wrightsh/Michigan-Linear-Book-Scanner/CAD/Linear Book Scanner/Laser Cut Layouts/Pics/main assembly with rough electronics slide.PNG

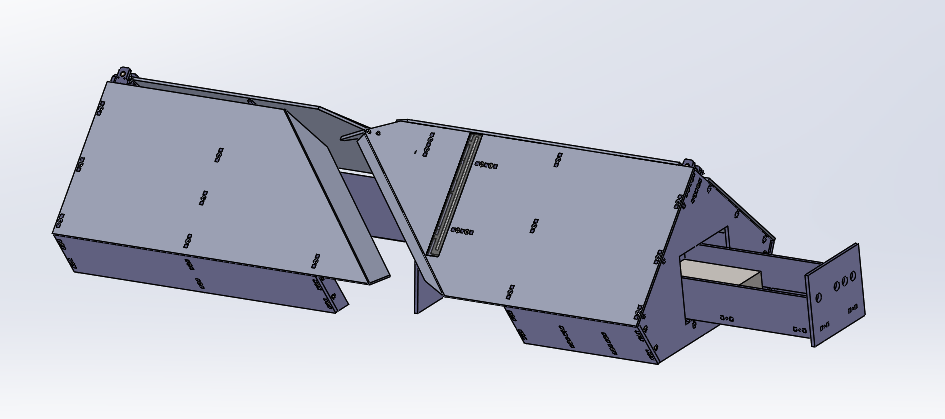
CAD/Linear Book Scanner/Laser Cut Layouts/Pics/main assembly with rough electronics slide.PNG
