wrightsh/Michigan-Linear-Book-Scanner/CAD/Linear Book Scanner/Renderings/Electronics Slide.JPG

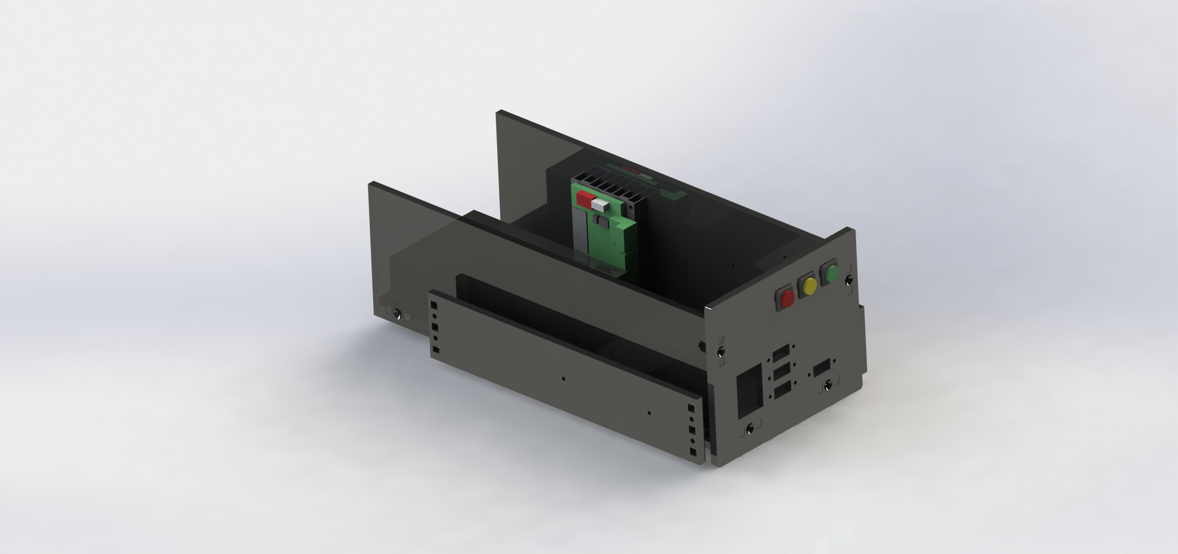
CAD/Linear Book Scanner/Renderings/Electronics Slide.JPG
