wrightsh/Michigan-Linear-Book-Scanner/README.md

Michigan-Linear-Book-Scanner
============================

An open source non-descructive book scanner produced at the University of Michigan as a senior design.
