wrightsh/Michigan-Linear-Book-Scanner/CAD/Linear Book Scanner/Laser Cut Layouts/Pics/Delrin_2.JPG

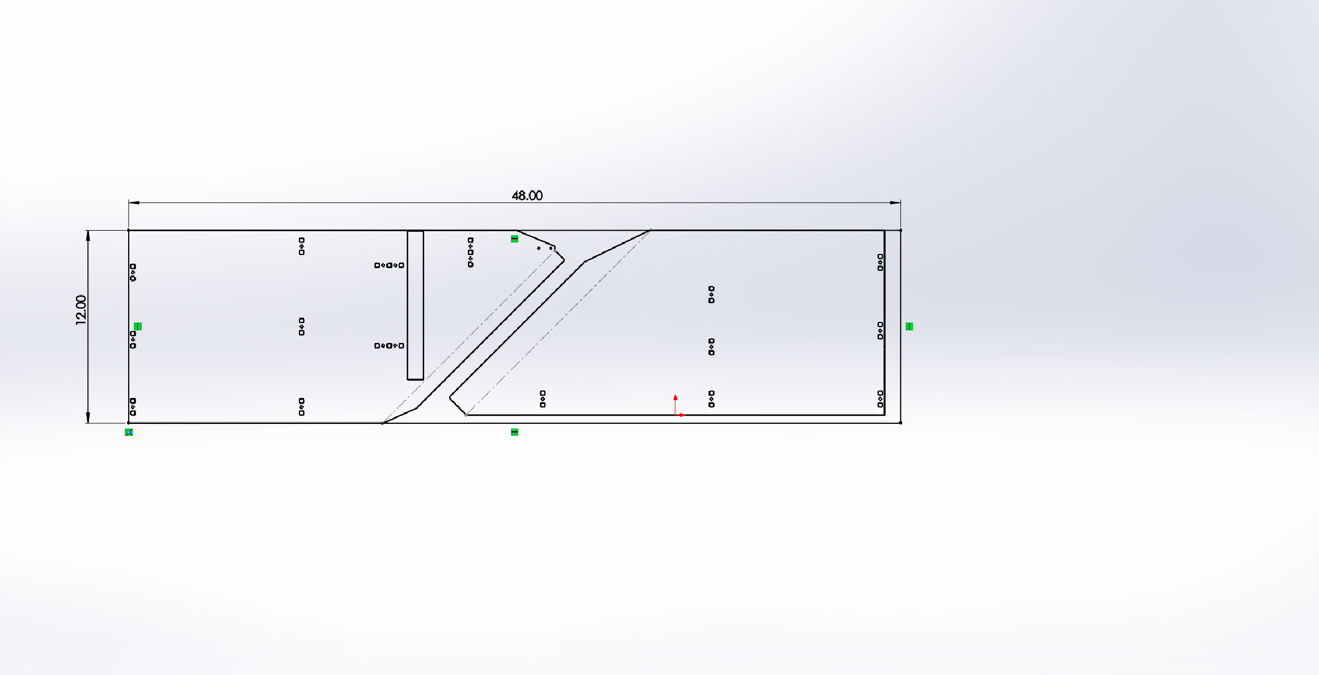
CAD/Linear Book Scanner/Laser Cut Layouts/Pics/Delrin_2.JPG
