wrightsh/Michigan-Linear-Book-Scanner/CAD/Linear Book Scanner/Laser Cut Layouts/Pics/fasteners.PNG

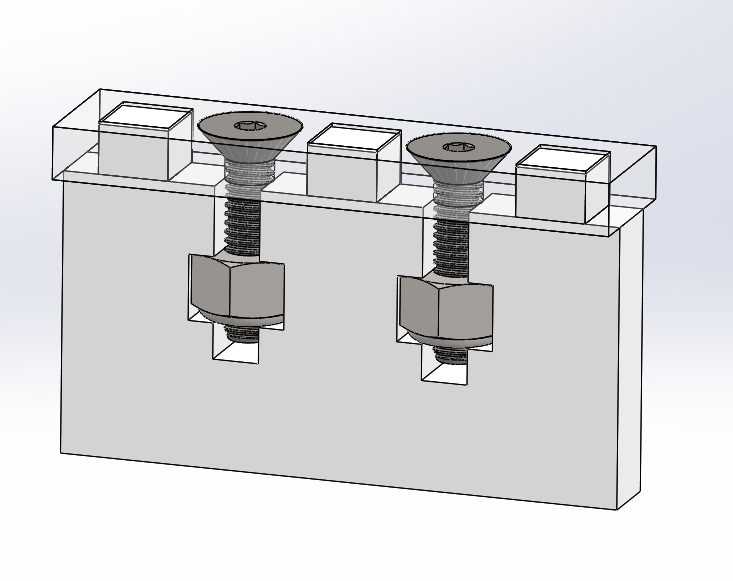
CAD/Linear Book Scanner/Laser Cut Layouts/Pics/fasteners.PNG
