wrightsh/Michigan-Linear-Book-Scanner/CAD/Linear Book Scanner/Laser Cut Layouts/Pics/fasteners_2.PNG

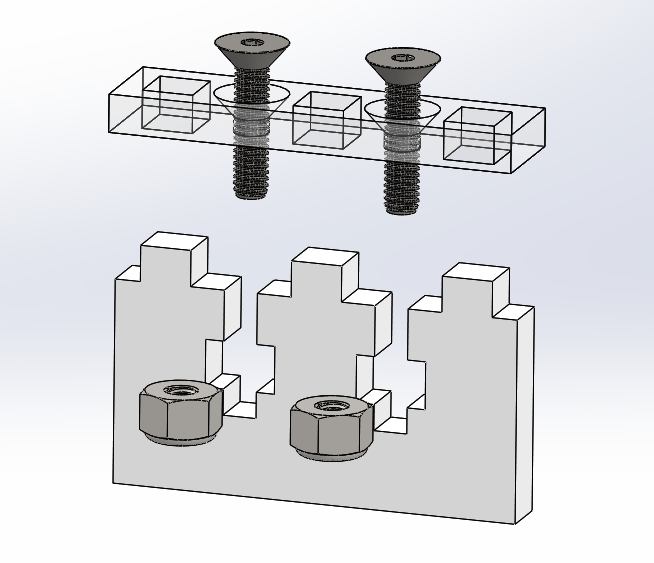
CAD/Linear Book Scanner/Laser Cut Layouts/Pics/fasteners_2.PNG
