wrightsh/Michigan-Linear-Book-Scanner/CAD/Linear Book Scanner/Laser Cut Layouts/Pics/Final Pics/Acrylic 3.PNG

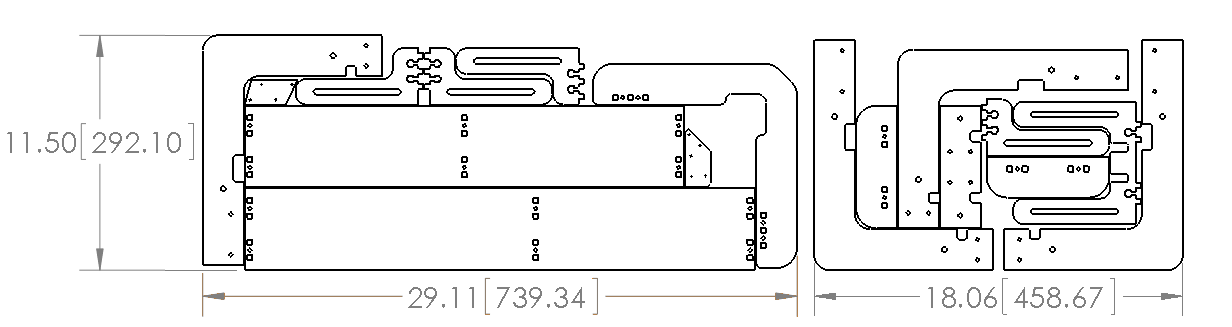
CAD/Linear Book Scanner/Laser Cut Layouts/Pics/Final Pics/Acrylic 3.PNG
