wrightsh/Michigan-Linear-Book-Scanner/CAD/Linear Book Scanner/Laser Cut Layouts/Pics/MA_1.PNG

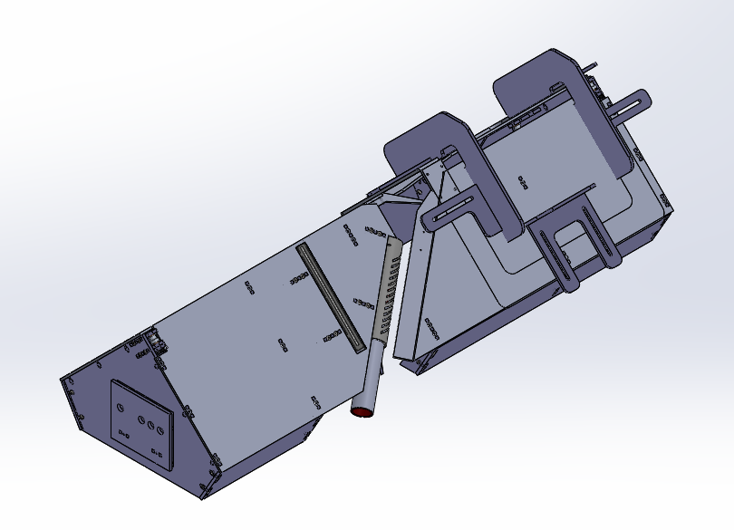
CAD/Linear Book Scanner/Laser Cut Layouts/Pics/MA_1.PNG
