wrightsh/Michigan-Linear-Book-Scanner/CAD/Linear Book Scanner/Laser Cut Layouts/Pics/MA_2.PNG

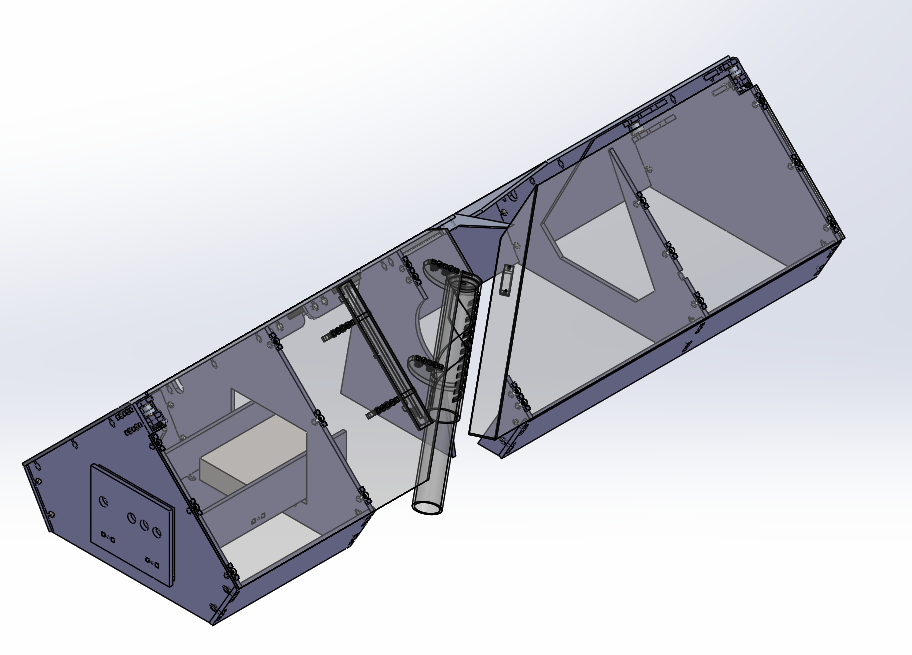
CAD/Linear Book Scanner/Laser Cut Layouts/Pics/MA_2.PNG
