wrightsh/Michigan-Linear-Book-Scanner/CAD/Linear Book Scanner/Renderings/Fastener Example.JPG

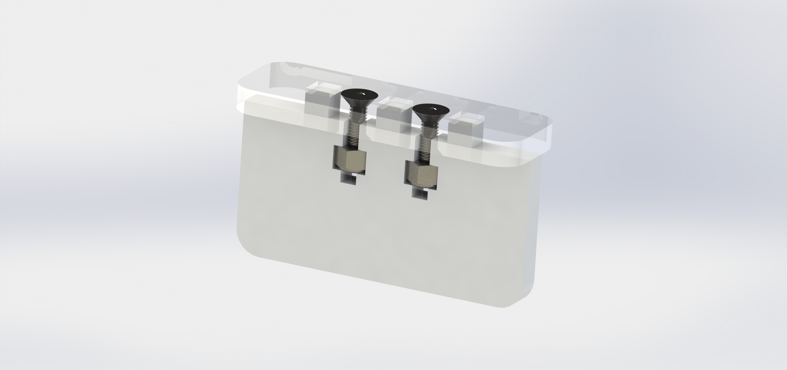
CAD/Linear Book Scanner/Renderings/Fastener Example.JPG
