wrightsh/Michigan-Linear-Book-Scanner/CAD/Linear Book Scanner/Renderings/Frame.JPG

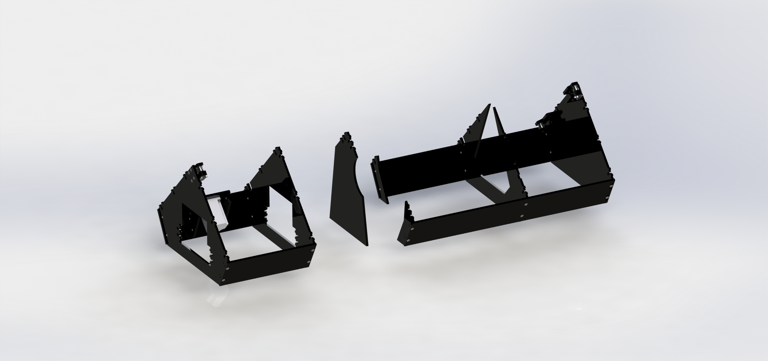
CAD/Linear Book Scanner/Renderings/Frame.JPG
