wrightsh/Michigan-Linear-Book-Scanner/CAD/Linear Book Scanner/Renderings/Infeed Back SA.JPG

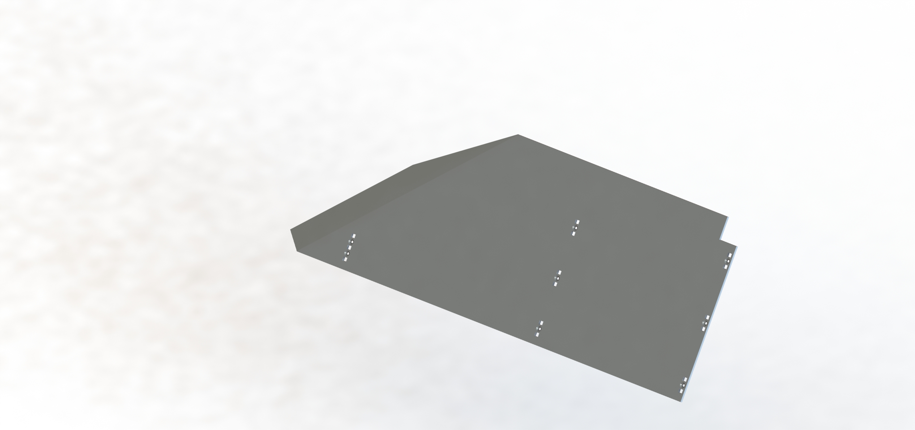
CAD/Linear Book Scanner/Renderings/Infeed Back SA.JPG
