wrightsh/Michigan-Linear-Book-Scanner/CAD/Linear Book Scanner/Renderings/Infeed Front SA.JPG

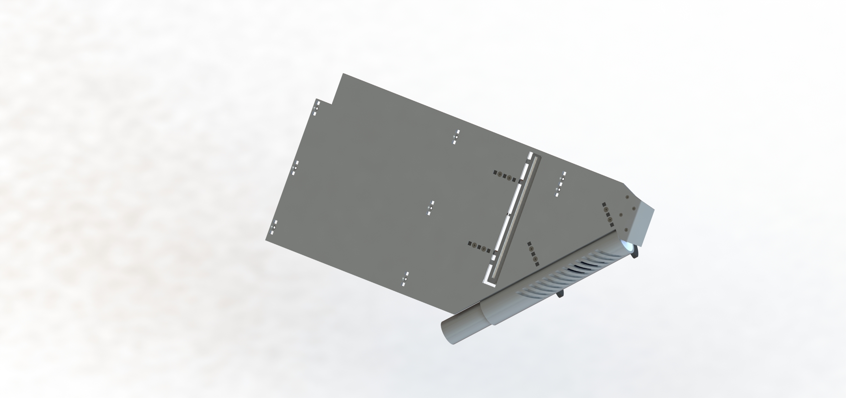
CAD/Linear Book Scanner/Renderings/Infeed Front SA.JPG
