wrightsh/Michigan-Linear-Book-Scanner/CAD/Linear Book Scanner/Renderings/MA exploaded.JPG

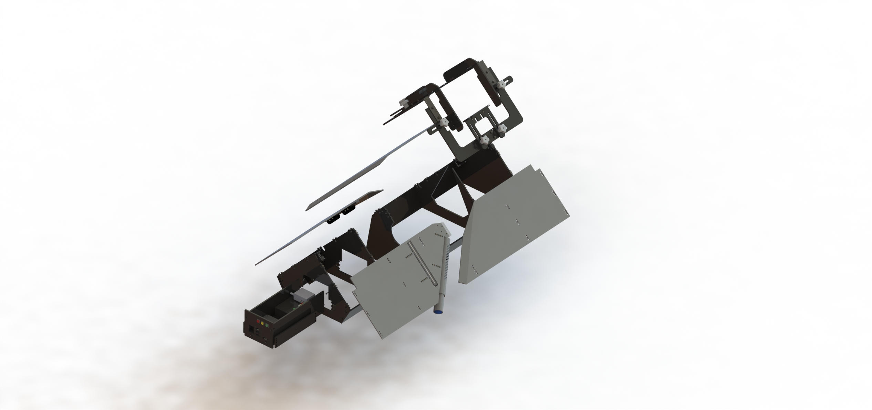
CAD/Linear Book Scanner/Renderings/MA exploaded.JPG
