wrightsh/Michigan-Linear-Book-Scanner/CAD/Linear Book Scanner/Renderings/Motor Mount.JPG

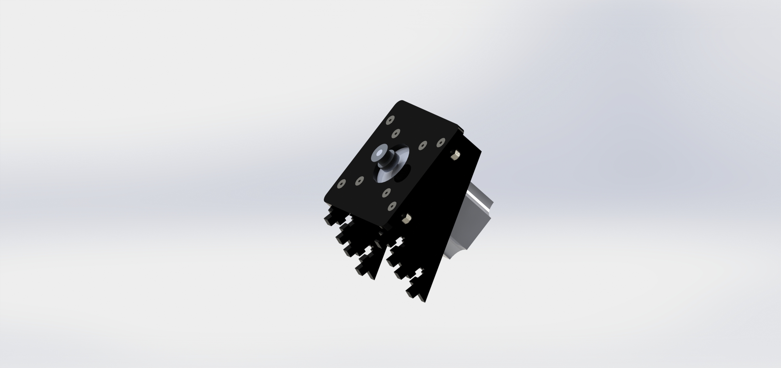
CAD/Linear Book Scanner/Renderings/Motor Mount.JPG
