wrightsh/Michigan-Linear-Book-Scanner/CAD/Linear Book Scanner/Renderings/Offset Pully Block.JPG

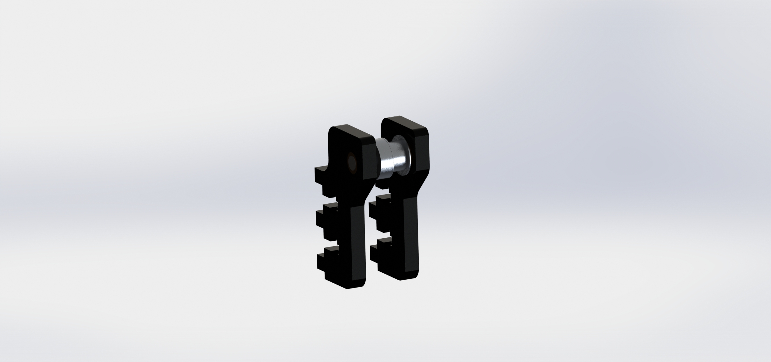
CAD/Linear Book Scanner/Renderings/Offset Pully Block.JPG
