wrightsh/Michigan-Linear-Book-Scanner/CAD/Linear Book Scanner/Renderings/Outfeed Back SA.JPG

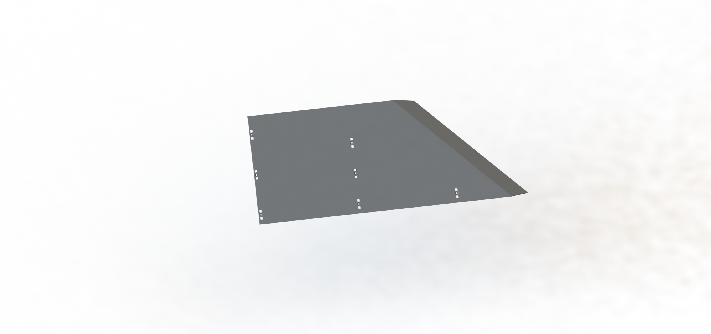
CAD/Linear Book Scanner/Renderings/Outfeed Back SA.JPG
