wrightsh/Michigan-Linear-Book-Scanner/CAD/Linear Book Scanner/Renderings/Outfeed Front SA.JPG

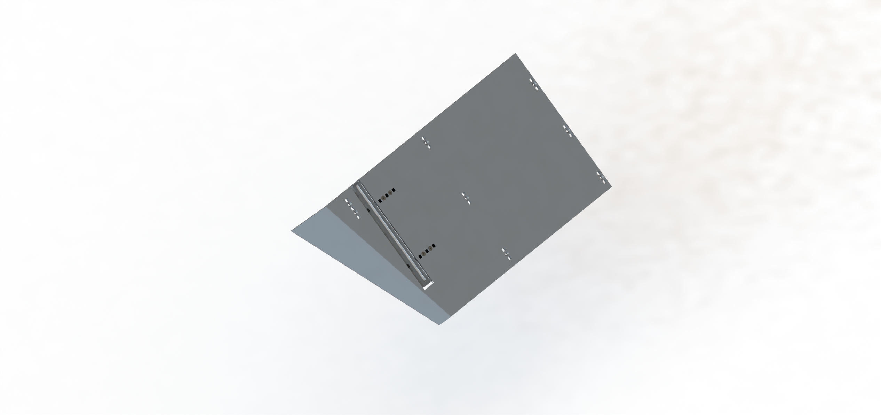
CAD/Linear Book Scanner/Renderings/Outfeed Front SA.JPG
