wrightsh/Michigan-Linear-Book-Scanner/CAD/Linear Book Scanner/Renderings/outfeed.PNG

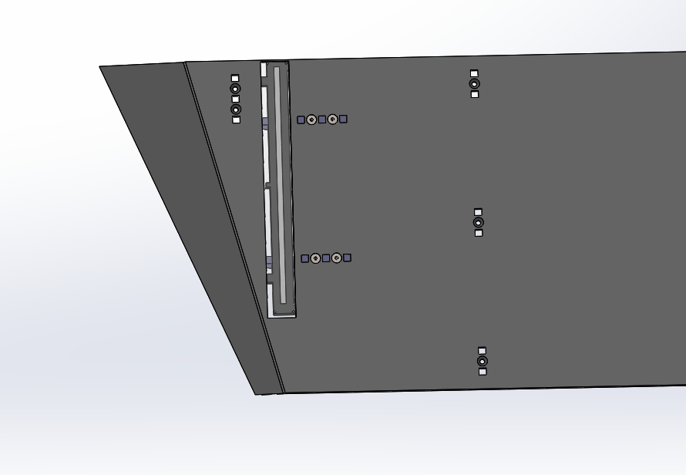
CAD/Linear Book Scanner/Renderings/outfeed.PNG
