wrightsh/Michigan-Linear-Book-Scanner/CAD/Linear Book Scanner/Renderings/Pully Block.JPG

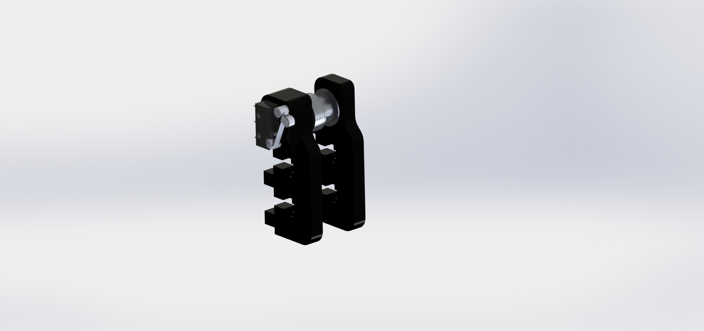
CAD/Linear Book Scanner/Renderings/Pully Block.JPG
