wrightsh/Michigan-Linear-Book-Scanner/CAD/Linear Book Scanner/Renderings/Saddle.JPG

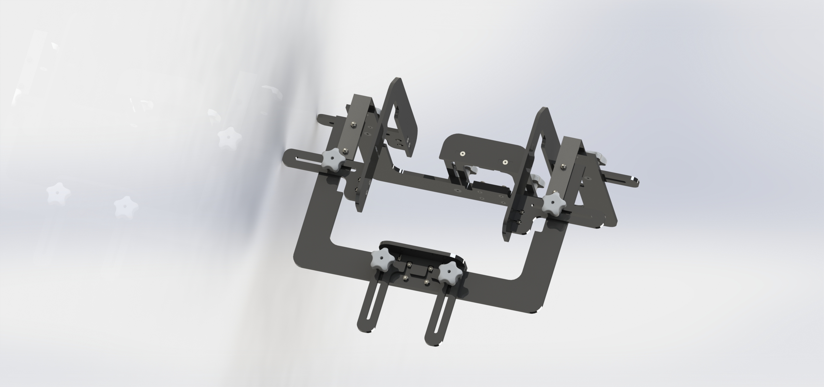
CAD/Linear Book Scanner/Renderings/Saddle.JPG
