wrightsh/Michigan-Linear-Book-Scanner/CAD/Linear Book Scanner/Renderings/vac tube 1.JPG

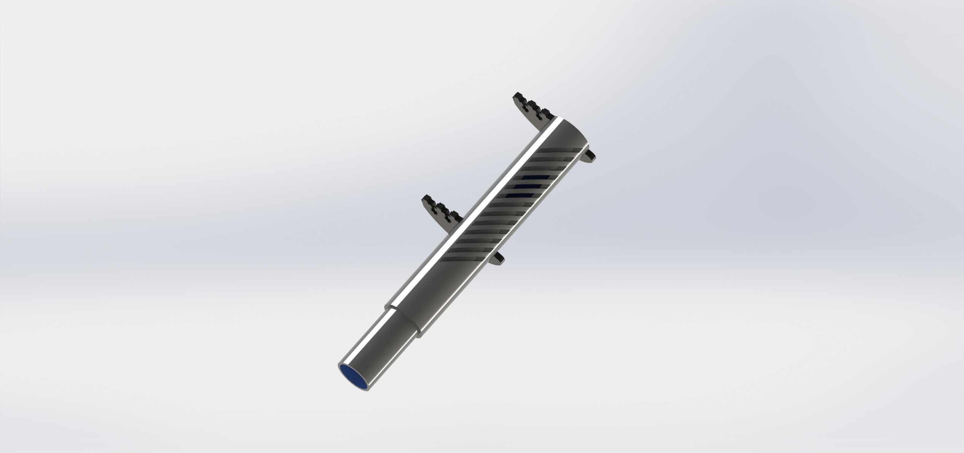
CAD/Linear Book Scanner/Renderings/vac tube 1.JPG
