wrightsh/Michigan-Linear-Book-Scanner/CAD/Linear Book Scanner/Sides/INFEED BACK, SIDE.JPG

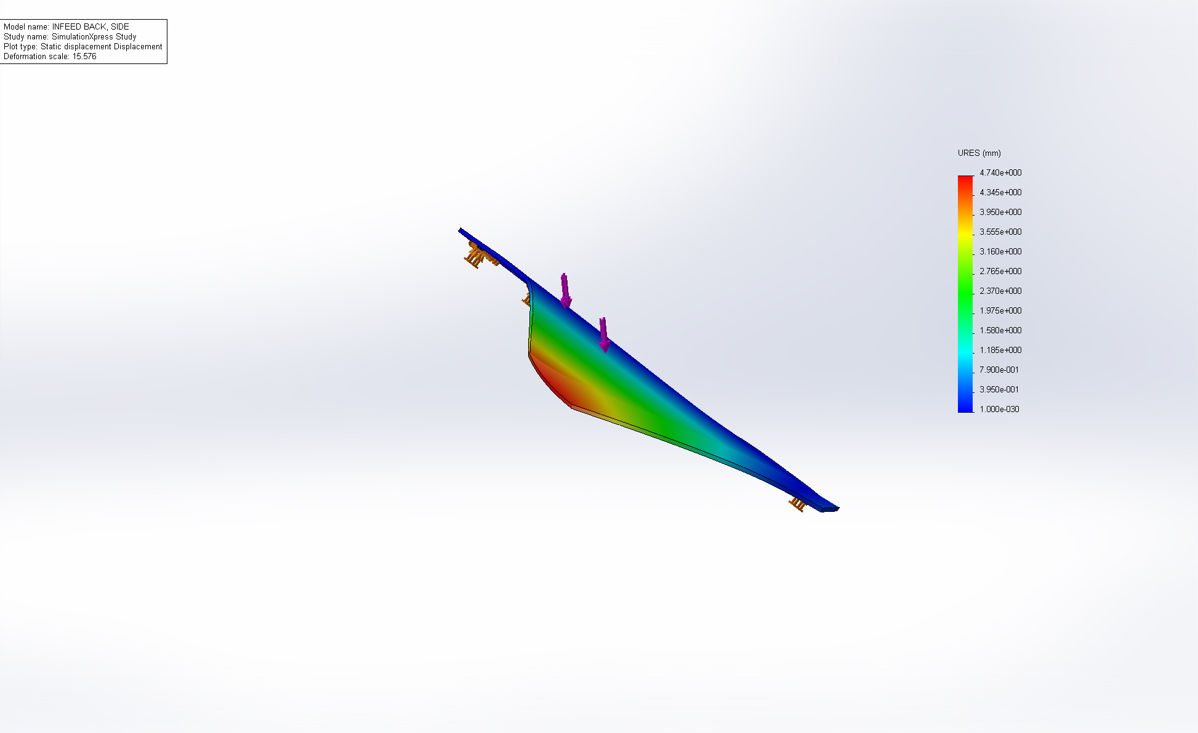
CAD/Linear Book Scanner/Sides/INFEED BACK, SIDE.JPG
