wrightsh/Michigan-Linear-Book-Scanner/CAD/Linear Book Scanner/Vacuum Tube/drawing pic flat.PNG

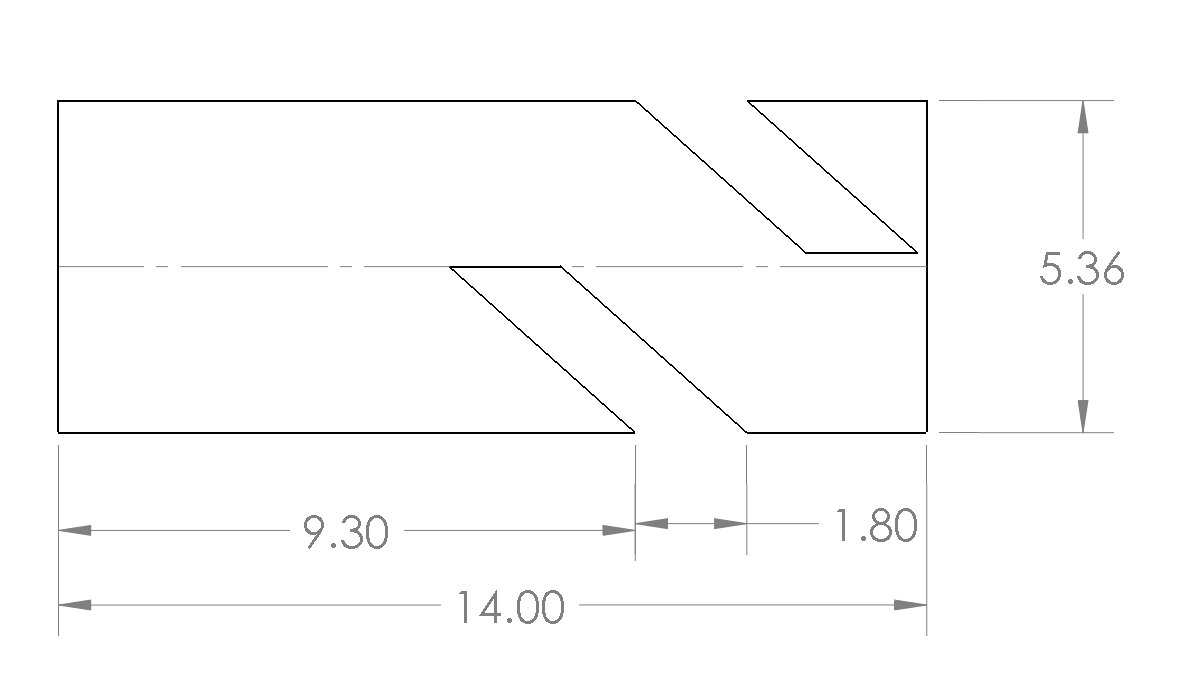
CAD/Linear Book Scanner/Vacuum Tube/drawing pic flat.PNG
