wrightsh/Michigan-Linear-Book-Scanner/Project Pictures/993753_10152392098223858_1000347072_n.jpg

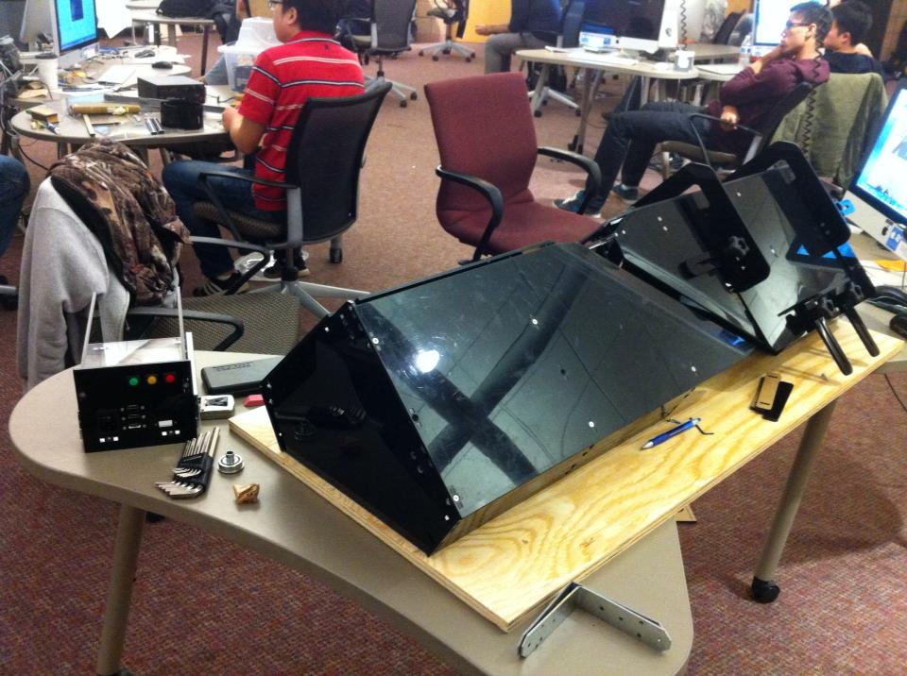
Project Pictures/993753_10152392098223858_1000347072_n.jpg
