wrightsh/Michigan-Linear-Book-Scanner/Project Pictures/1452397_10152368449088858_267711428_n.jpg

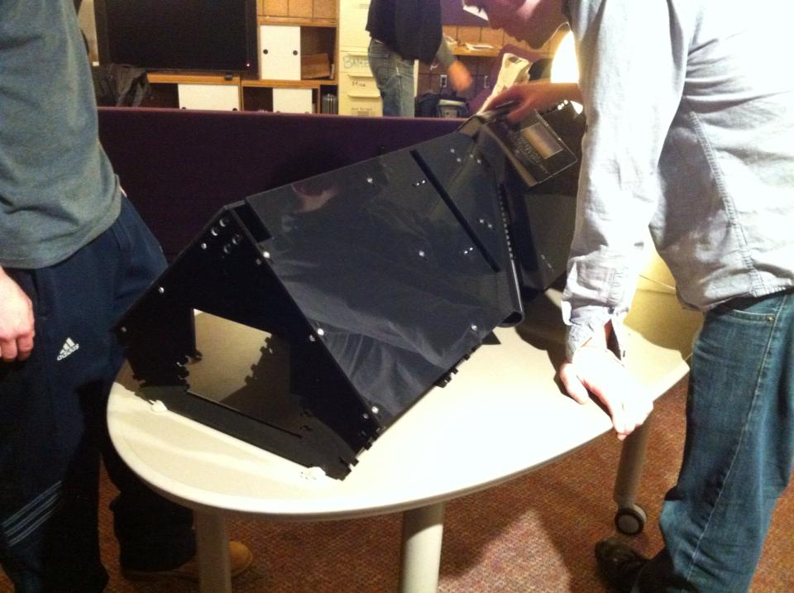
Project Pictures/1452397_10152368449088858_267711428_n.jpg
