wrightsh/Michigan-Linear-Book-Scanner/Project Pictures/1457532_10152373524923858_1004399464_n.jpg

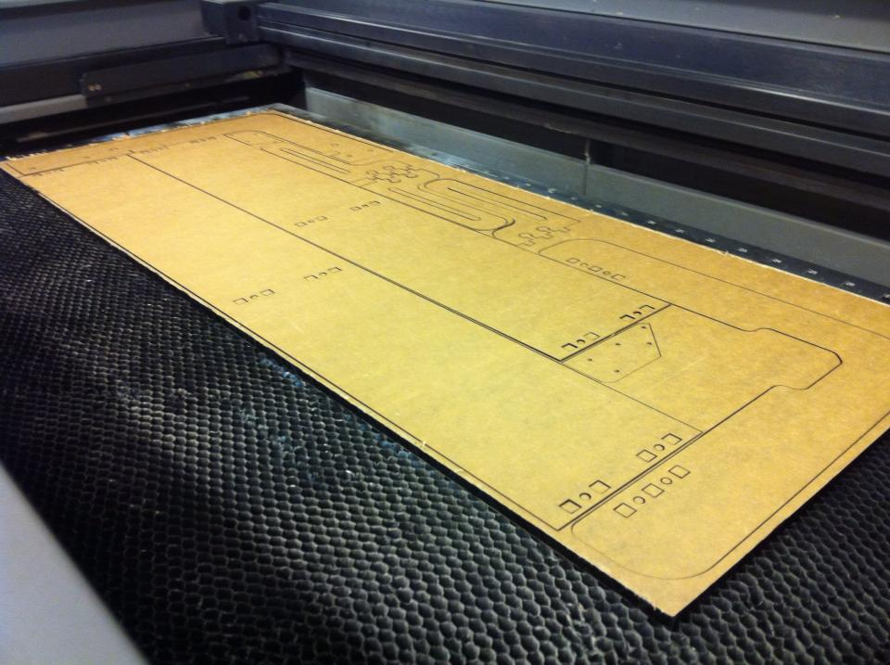
Project Pictures/1457532_10152373524923858_1004399464_n.jpg
