wrightsh/Michigan-Linear-Book-Scanner/Project Pictures/1460037_10152113126072722_1718700323_n.jpg

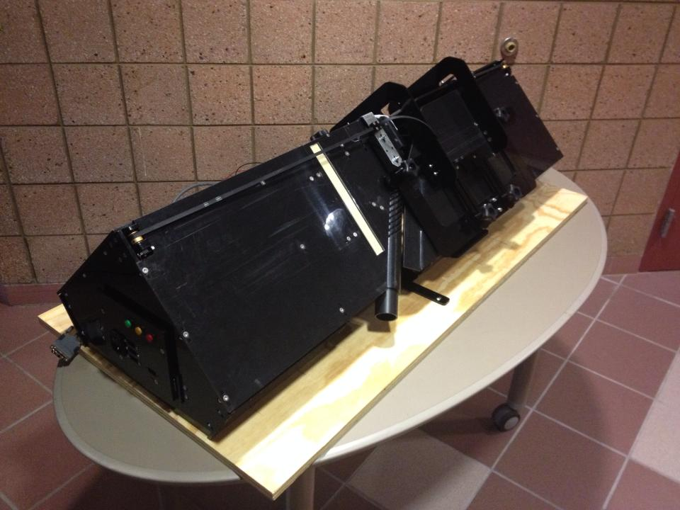
Project Pictures/1460037_10152113126072722_1718700323_n.jpg
