wrightsh/Michigan-Linear-Book-Scanner/Project Pictures/1472027_10152368448988858_1261890332_n.jpg

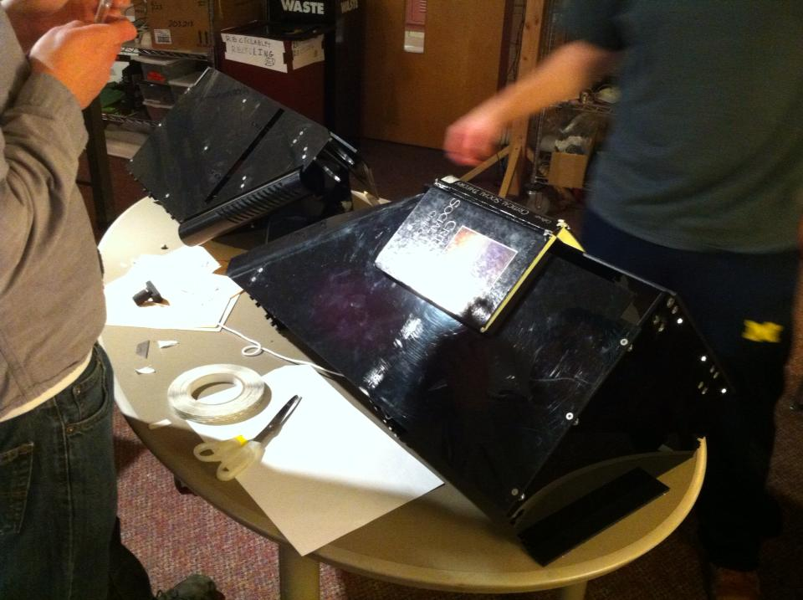
Project Pictures/1472027_10152368448988858_1261890332_n.jpg
