wrightsh/Michigan-Linear-Book-Scanner/Project Pictures/1474454_10152392098113858_992185847_n.jpg

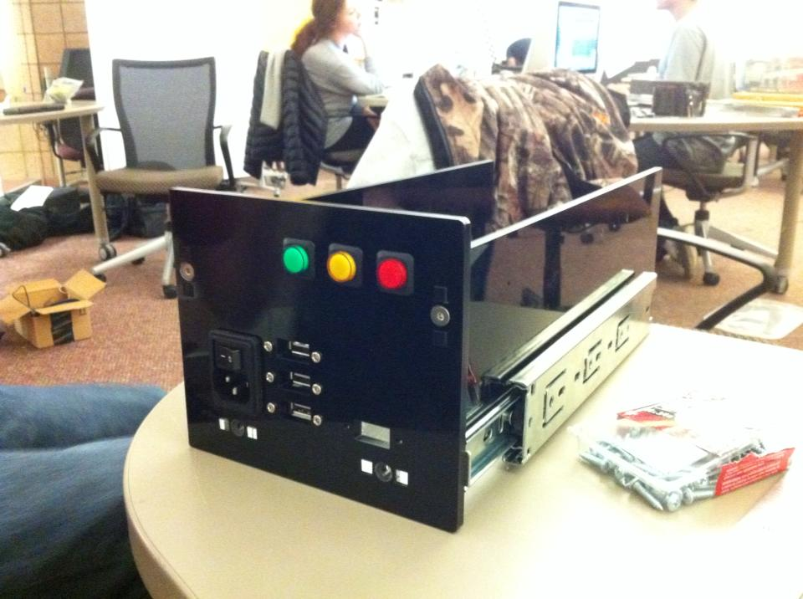
Project Pictures/1474454_10152392098113858_992185847_n.jpg
