wrightsh/Michigan-Linear-Book-Scanner/Project Pictures/1490825_10152463922323858_289539097_o.jpg

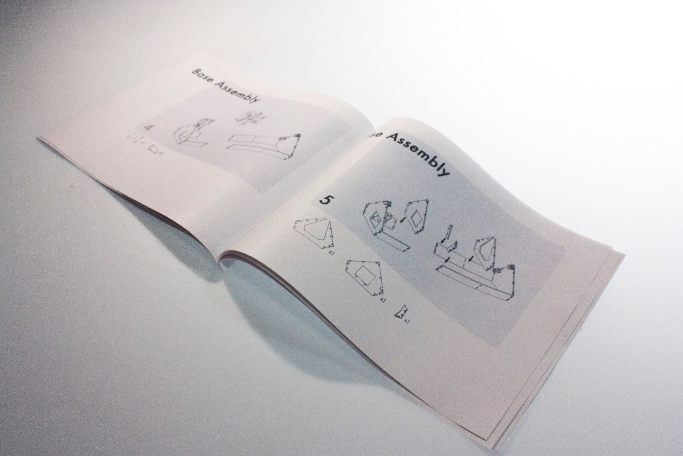
Project Pictures/1490825_10152463922323858_289539097_o.jpg
