wrightsh/Michigan-Linear-Book-Scanner/Project Pictures/1501551_10152463922588858_48871558_o.jpg

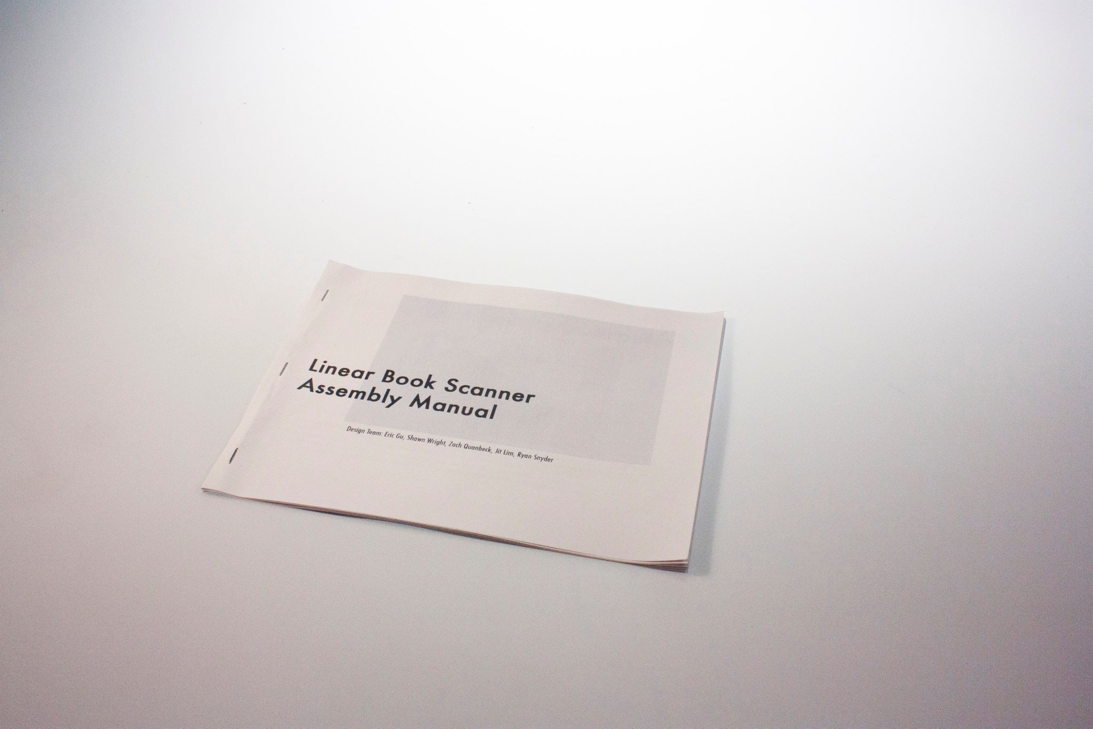
Project Pictures/1501551_10152463922588858_48871558_o.jpg
