wrightsh/Michigan-Linear-Book-Scanner/Project Pictures/1512071_10152463922328858_1545501962_o.jpg

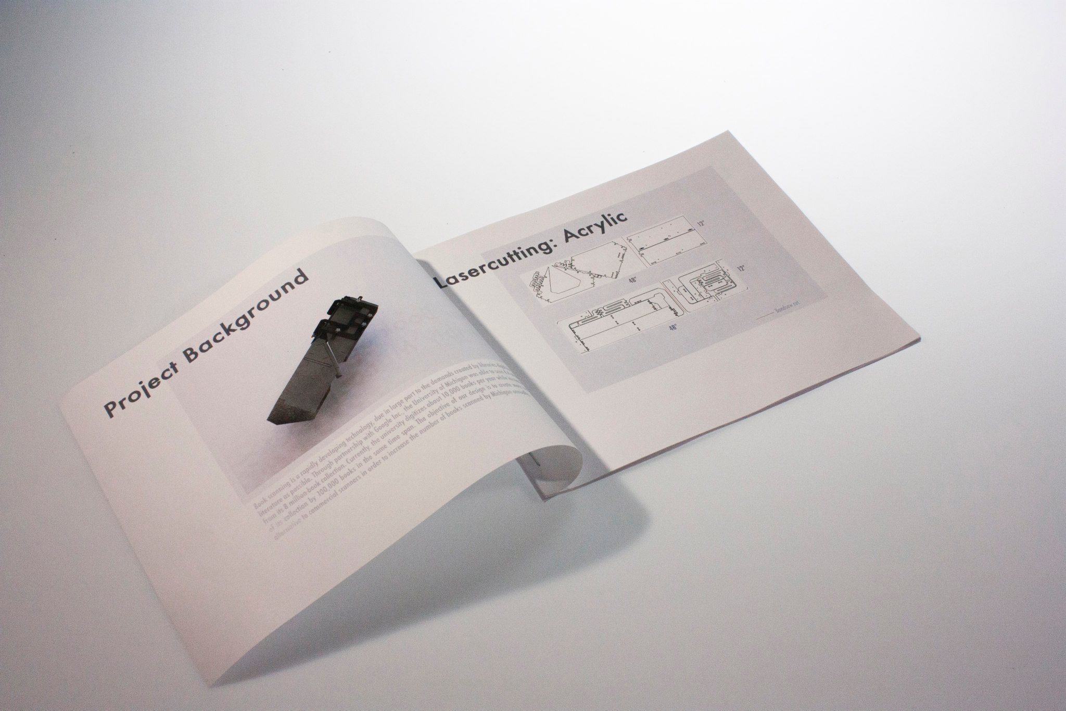
Project Pictures/1512071_10152463922328858_1545501962_o.jpg
