wrightsh/Michigan-Linear-Book-Scanner/Project Pictures/IMG_1985.JPG

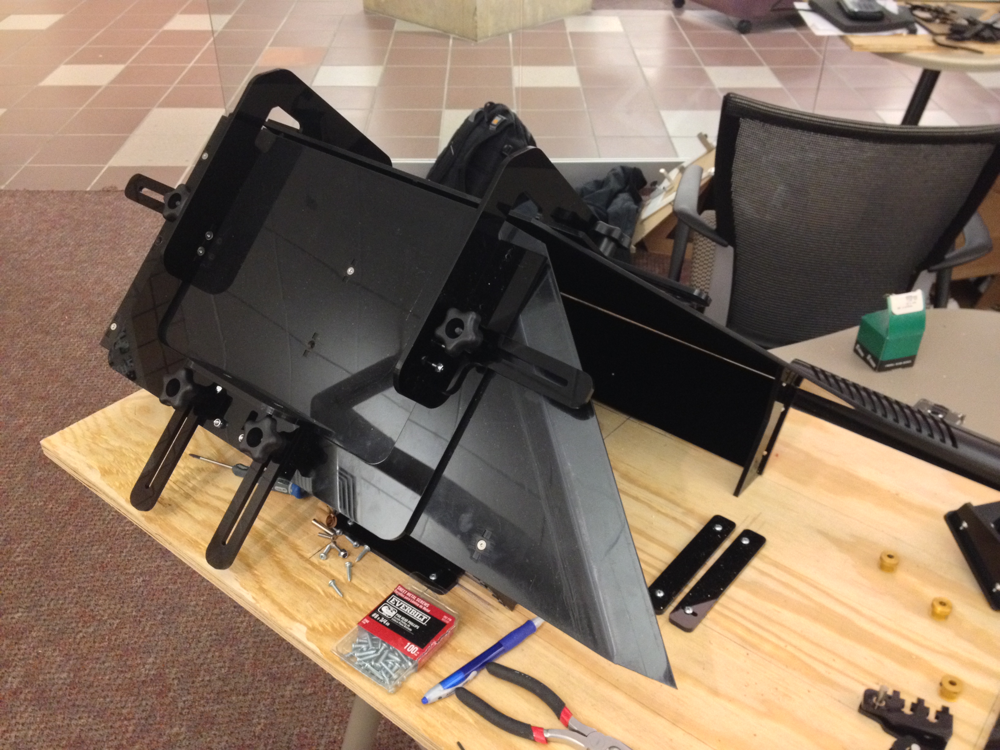
Project Pictures/IMG_1985.JPG
