wrightsh/Michigan-Linear-Book-Scanner/Project Pictures/IMG_1986.JPG

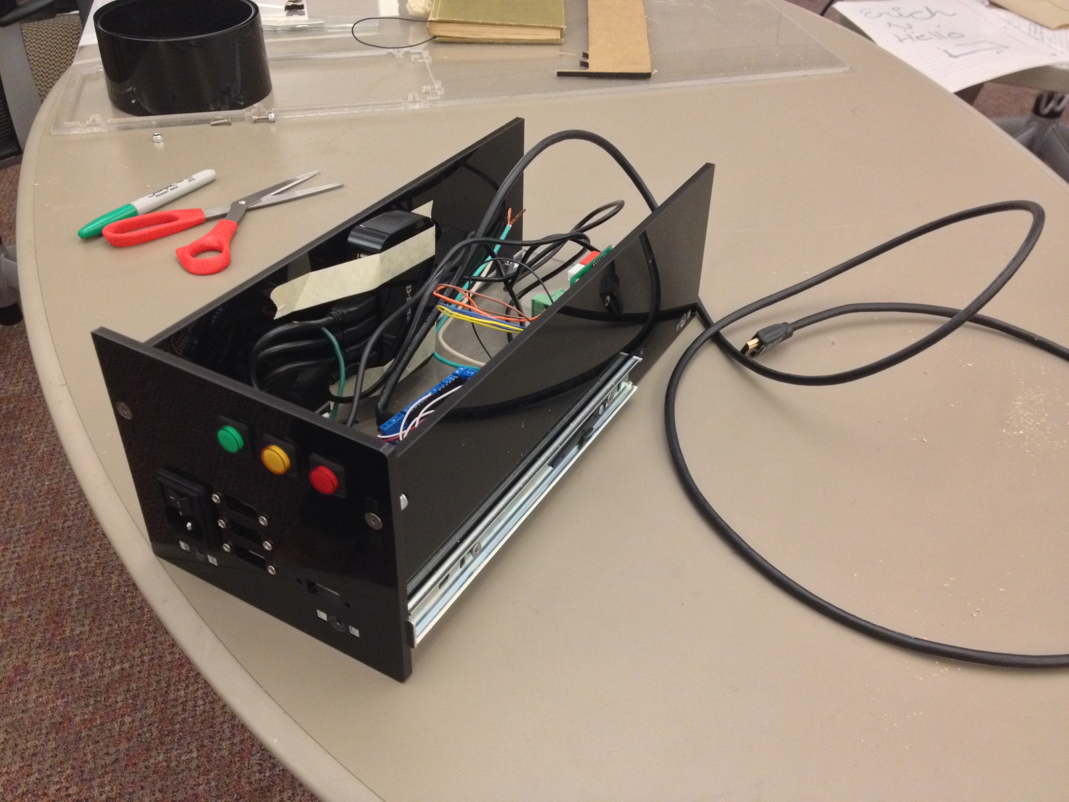
Project Pictures/IMG_1986.JPG
