wrightsh/Michigan-Linear-Book-Scanner/Project Pictures/IMG_1987.JPG

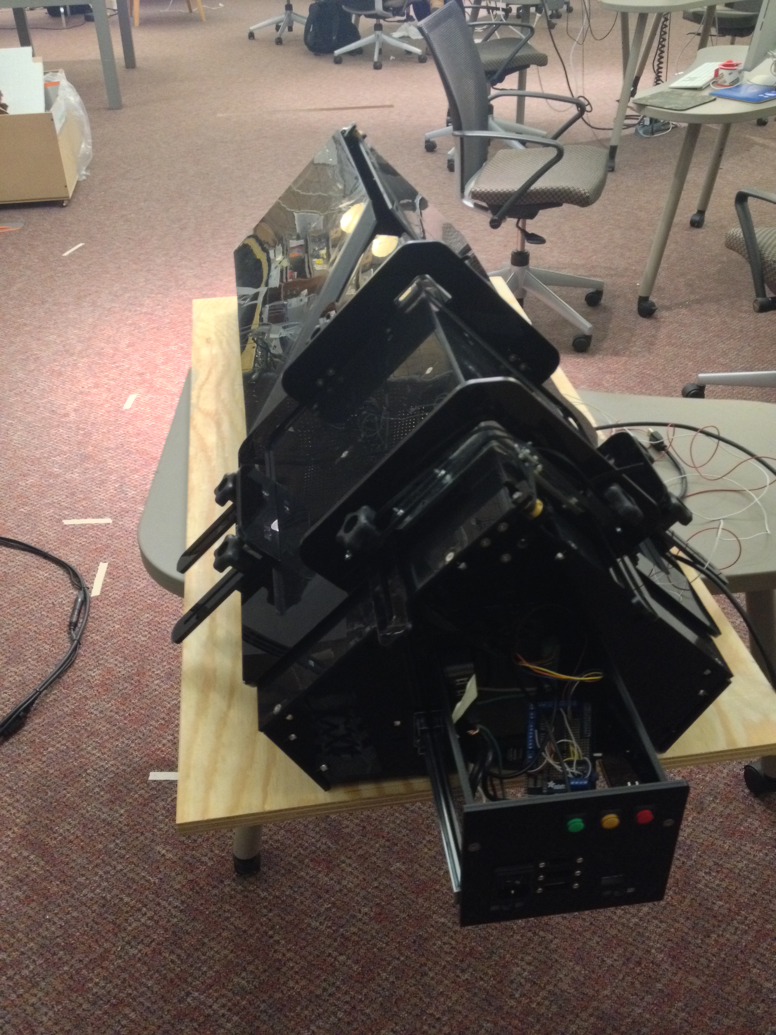
Project Pictures/IMG_1987.JPG
