wrightsh/Michigan-Linear-Book-Scanner/Project Pictures/IMG_1988.JPG

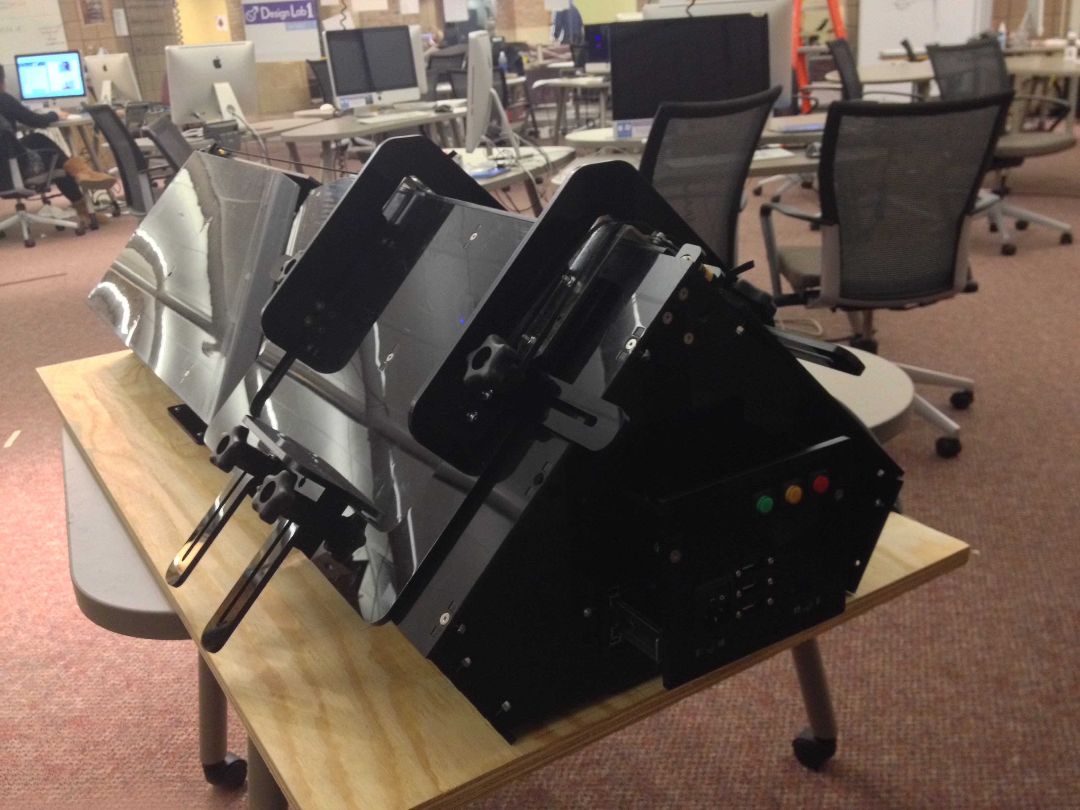
Project Pictures/IMG_1988.JPG
