wrightsh/Michigan-Linear-Book-Scanner/Project Pictures/IMG_1994.JPG

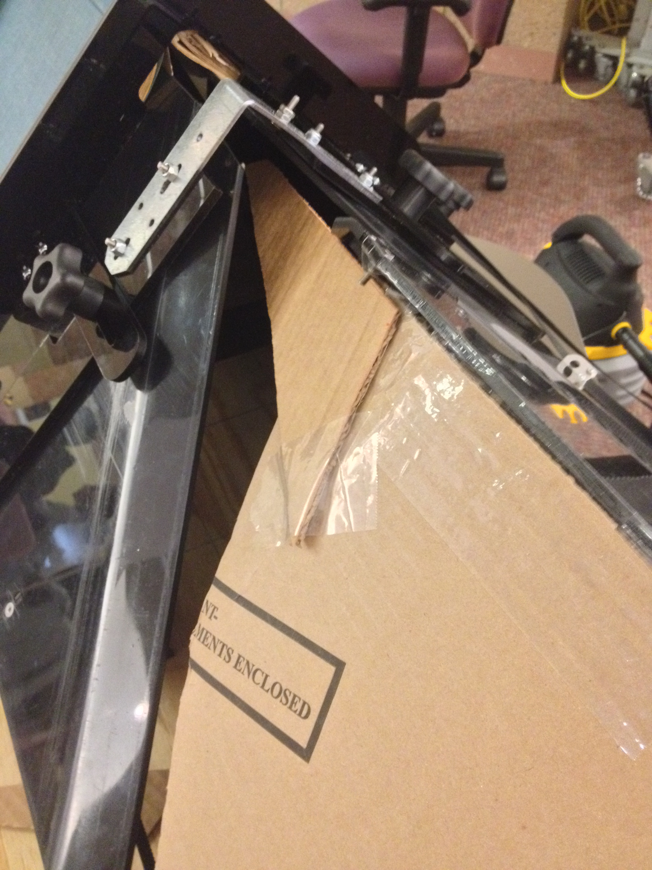
Project Pictures/IMG_1994.JPG
