wrightsh/Michigan-Linear-Book-Scanner/Project Pictures/IMG_2016.JPG

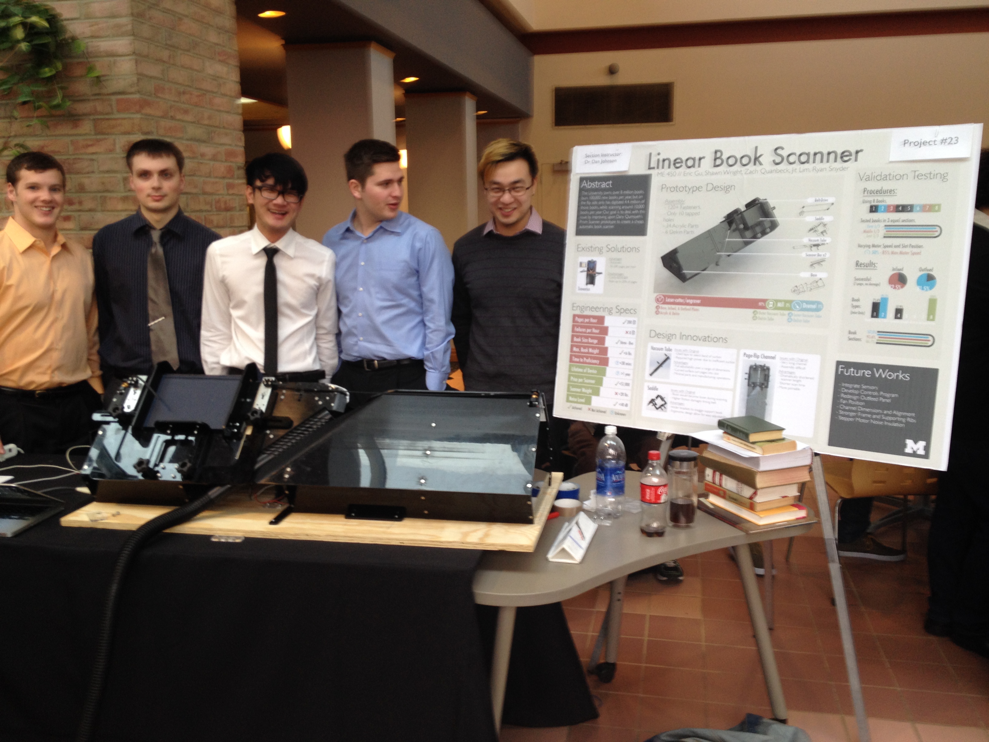
Project Pictures/IMG_2016.JPG
