wrightsh/Michigan-Linear-Book-Scanner/Project Pictures/IMG_2033.JPG

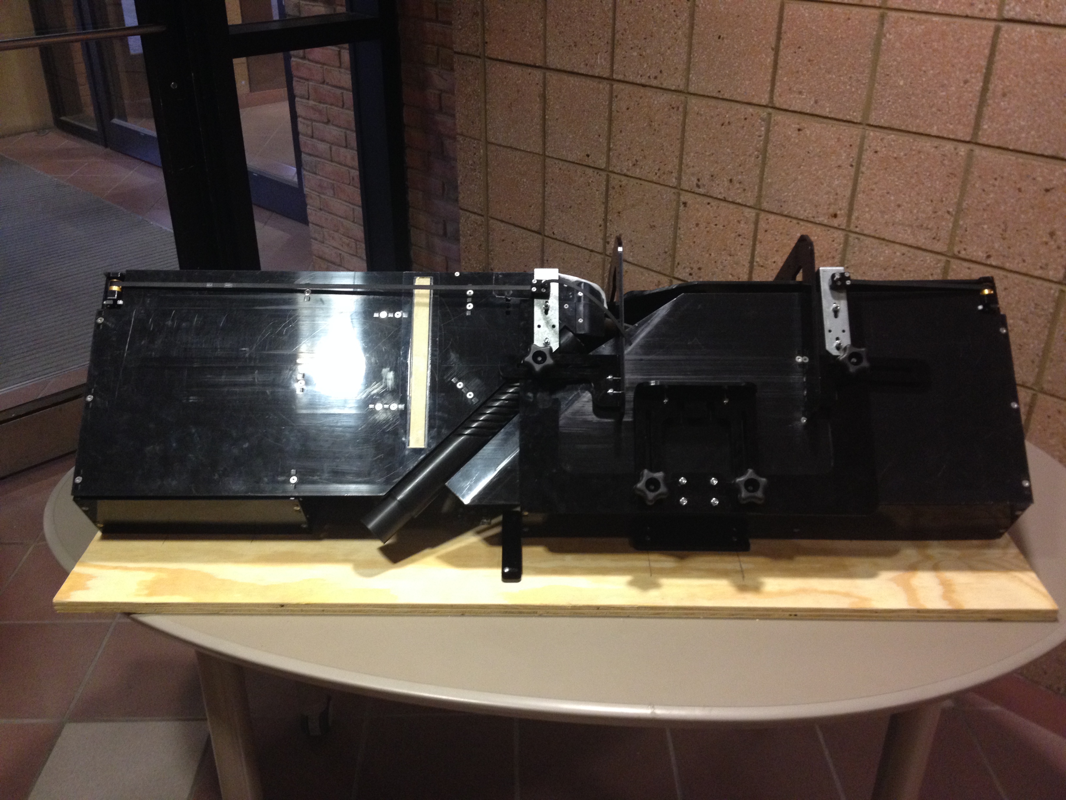
Project Pictures/IMG_2033.JPG
