wrightsh/Michigan-Linear-Book-Scanner/Project Pictures/IMG_2034.JPG

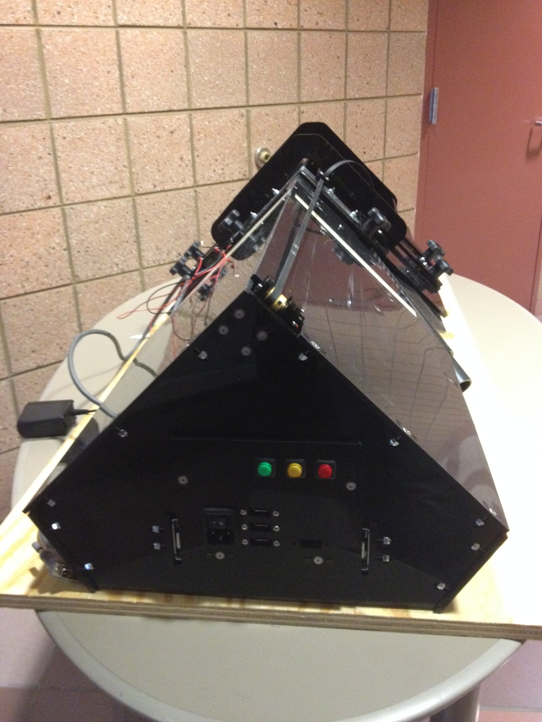
Project Pictures/IMG_2034.JPG
