wrightsh/Michigan-Linear-Book-Scanner/Project Pictures/IMG_2038.JPG

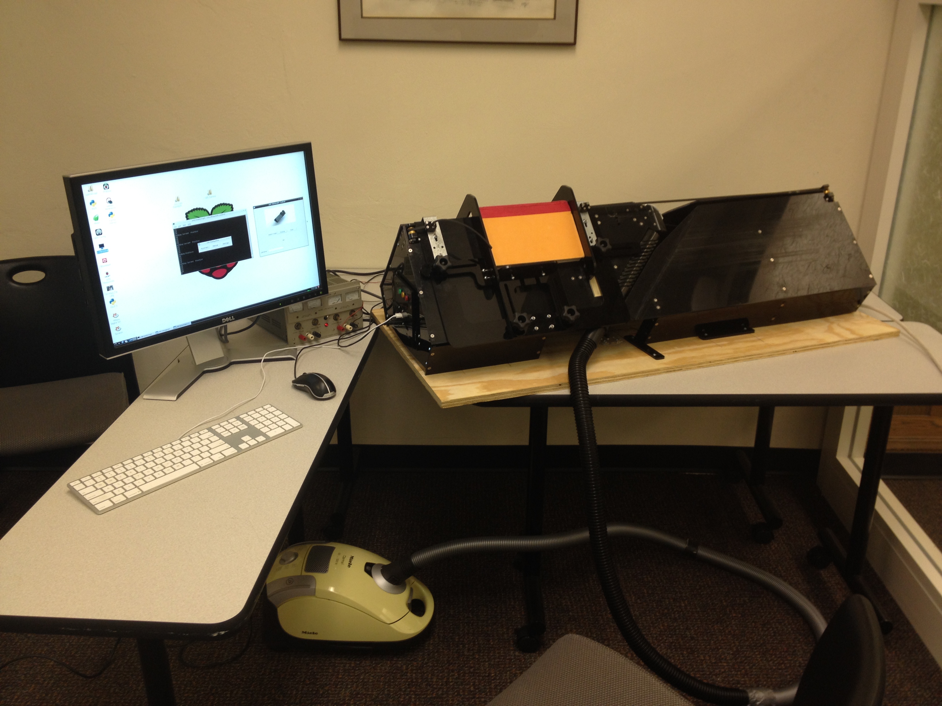
Project Pictures/IMG_2038.JPG
