wrightsh/Michigan-Linear-Book-Scanner/rpi Code/LBS_Control/LBS_Main_Image.jpg

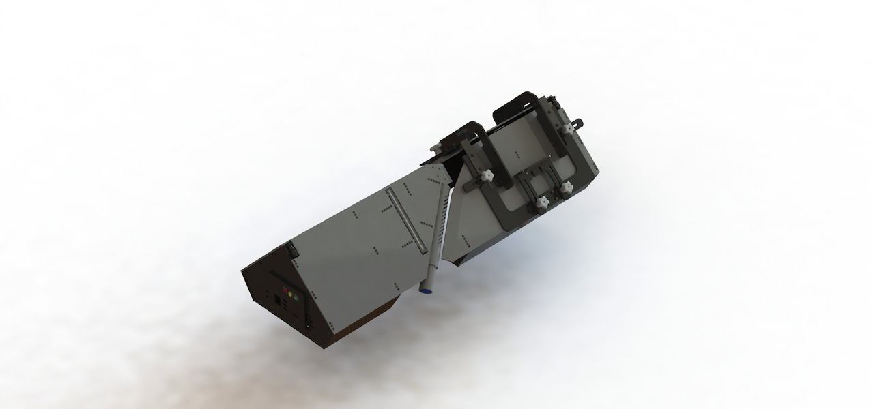
rpi Code/LBS_Control/LBS_Main_Image.jpg
