wrightsh/Michigan-Linear-Book-Scanner/CAD/Linear Book Scanner/Laser Cut Layouts/Delrin_1.SLDASM

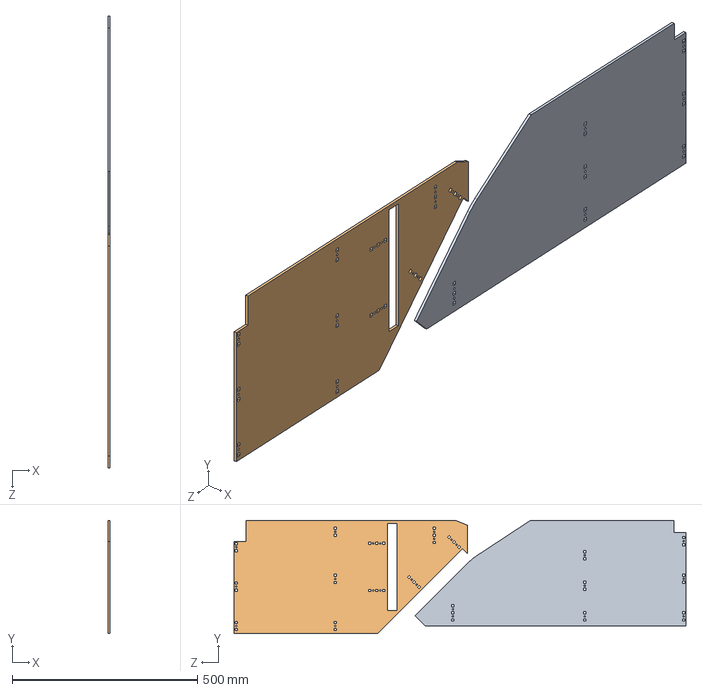
[picture p83: CAD file, 2013-12-16]
CAD/Linear Book Scanner/Laser Cut Layouts/Delrin_1.SLDASM
5.08 x 305.1 x 1219.2 mm
INFEED BACK, SIDE
INFEED FRONT, SIDE
