wrightsh/Michigan-Linear-Book-Scanner/CAD/Linear Book Scanner/LINEAR BOOK SCANNER.SLDASM

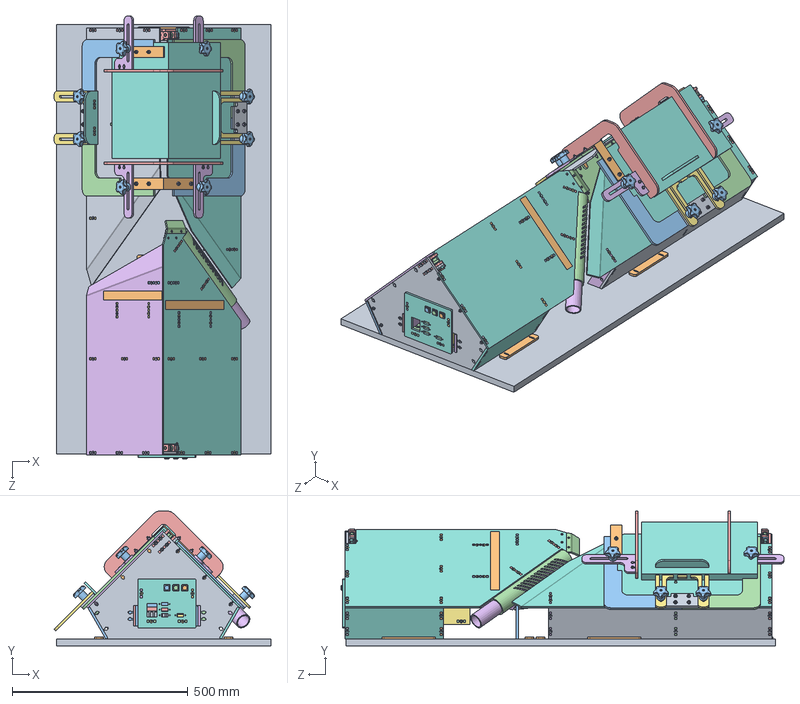
[picture p84: CAD file, 2013-12-16]
CAD/Linear Book Scanner/LINEAR BOOK SCANNER.SLDASM
616.3 x 383.3 x 1258.6 mm
RIB 1, FRAME
RIB 2, FRAME
RIB 3, FRAME
RIB 5, FRAME
RIB 6, FRAME
RIB 4 INFEED, FRAME
RIB 4 OUTFEED, FRAME
LOWER INFEED FRONT RIB, FRAME
LOWER INFEED BACK RIB, FRAME
LOWER OUTFEED BACK RIB, FRAME
LOWER OUTFEED FRONT RIB, FRAME
1375K39 x 4
MOUNT, PULLY x 4
6338K411 x 6
SHAFT, PULLY x 3
7658K160 x 2
LIMIT SWITCH MOUNT, INFEED
MOUNT OFFSET, PULLY x 2
LIMIT SWITCH MOUNT, OUTFEED
FACE, MOTOR MOUNT
SIDE, MOTOR MOUNT x 2
90631A009 x 44
92210A197 x 65
INFEED FRONT, SIDE
Canon 220 Scanner Bar x 2
GLASS COVER, SCANNER BAR x 2
BRACKET, SCANNER BAR INFEED x 2
OUTSIDE TUBE, VACUUM TUBE
BRACKET, VACUUM TUBE x 2
INSIDE TUBE, VACUUM TUBE
OUTSIDE TUBE CAP, VACUUM TUBE
INSIDE TUBE CAP, VACUUM TUBE
91259A574
95606A431 x 2
92210A113 x 4
HORN_1, INFEED FRONT
HORN MOUNT, INFEED FRONT
OUTFEED FRONT, SIDE
BRACKET, SCANNER BAR OUTFEED x 2
INFEED BACK, SIDE
OUTFEED BACK, SIDE
17715A68 x 2
SIDE_1, SADDLE x 2
SIDE_2, SADDLE x 2
SIDE PADDLE, SADDLE x 2
PADDLE SLIDE, SADDLE x 4
LOWER PADDLE SLIDE, SADDLE x 2
LOWER PADDLE, SADDLE x 2
LINK, SADDLE x 2
92210A546 x 8
59625K330 x 8
BASE, ELECTRONICS SLIDE
power supply
SIDE OUTFEED, ELECTRONICS SLIDE
SIDE INFEED, ELECTRONICS SLIDE
FRONT, ELECTRONICS SLIDE
D-Link USB Hub
Iluminated Button Green
Iluminated Button Red
Iluminated Button Yellow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
