wrightsh/Michigan-Linear-Book-Scanner/CAD/Linear Book Scanner/Motor Mount/MOTOR MOUNT.SLDASM

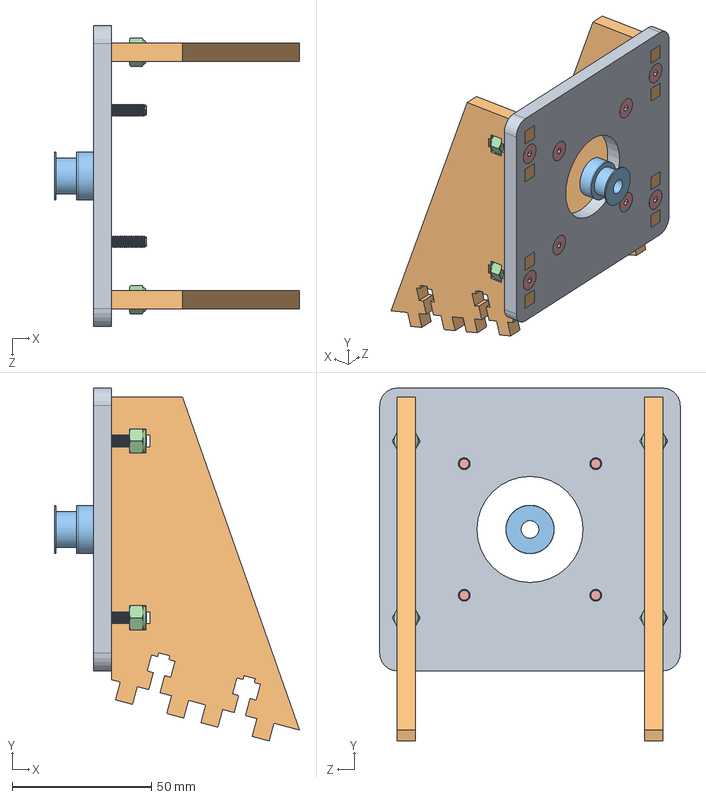
[picture p85: CAD file, 2013-12-16]
CAD/Linear Book Scanner/Motor Mount/MOTOR MOUNT.SLDASM
88.0 x 126.8 x 108.0 mm
FACE, MOTOR MOUNT
SIDE, MOTOR MOUNT x 2
1375K39
90631A009 x 4
92210A197 x 8
