wrightsh/Michigan-Linear-Book-Scanner/CAD/Linear Book Scanner/Pulleys/PULLEY BLOCK, INFEED.SLDASM

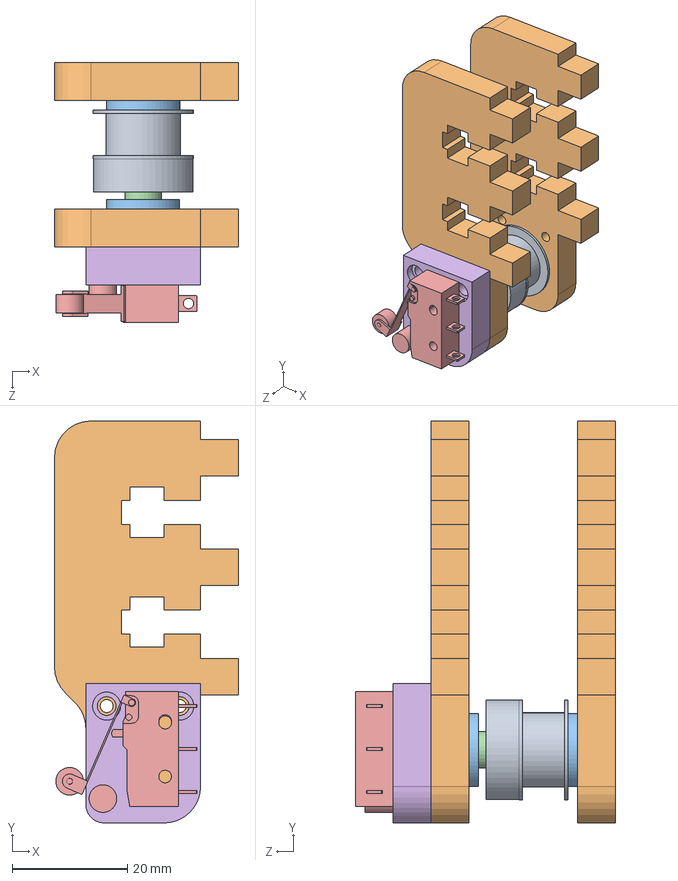
[picture p86: CAD file, 2013-12-16]
CAD/Linear Book Scanner/Pulleys/PULLEY BLOCK, INFEED.SLDASM
32.0 x 69.8 x 45.1 mm
1375K39
MOUNT, PULLY x 2
6338K411 x 2
SHAFT, PULLY
7658K160
LIMIT SWITCH MOUNT, INFEED
