wrightsh/Michigan-Linear-Book-Scanner/CAD/Linear Book Scanner/Sides/SIDE INFEED FRONT.SLDASM

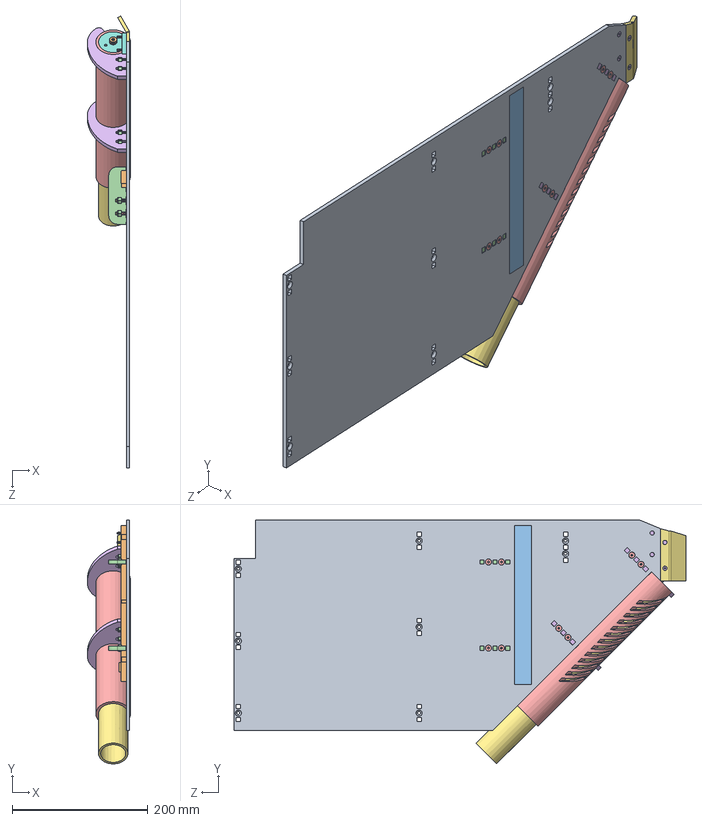
[picture p87: CAD file, 2013-12-16]
CAD/Linear Book Scanner/Sides/SIDE INFEED FRONT.SLDASM
63.7 x 359.4 x 666.5 mm
INFEED FRONT, SIDE
Canon 220 Scanner Bar
GLASS COVER, SCANNER BAR
BRACKET, SCANNER BAR INFEED x 2
OUTSIDE TUBE, VACUUM TUBE
BRACKET, VACUUM TUBE x 2
INSIDE TUBE, VACUUM TUBE
OUTSIDE TUBE CAP, VACUUM TUBE
INSIDE TUBE CAP, VACUUM TUBE
91259A574
95606A431 x 2
90631A009 x 8
92210A197 x 8
92210A113 x 4
HORN_1, INFEED FRONT
HORN MOUNT, INFEED FRONT
