wrightsh/Michigan-Linear-Book-Scanner/CAD/Linear Book Scanner/Vacuum Tube/VACUUM TUBE.SLDASM

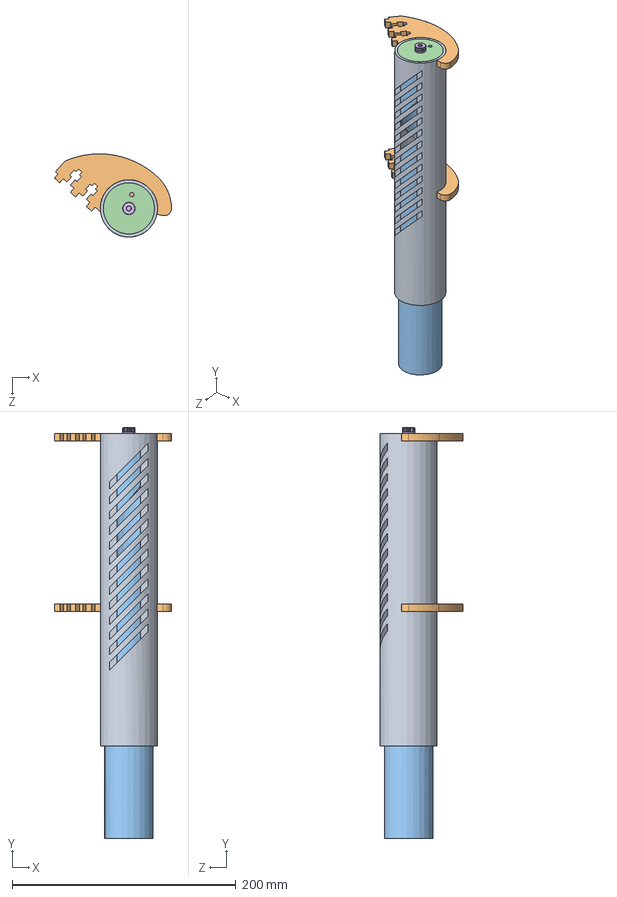
[picture p88: CAD file, 2013-12-16]
CAD/Linear Book Scanner/Vacuum Tube/VACUUM TUBE.SLDASM
104.6 x 367.5 x 74.5 mm
OUTSIDE TUBE, VACUUM TUBE
BRACKET, VACUUM TUBE x 2
INSIDE TUBE, VACUUM TUBE
OUTSIDE TUBE CAP, VACUUM TUBE
INSIDE TUBE CAP, VACUUM TUBE
91259A574
95606A431 x 2
