wrightsh/Michigan-Linear-Book-Scanner/CAD/Linear Book Scanner/Base/BASE.SLDASM

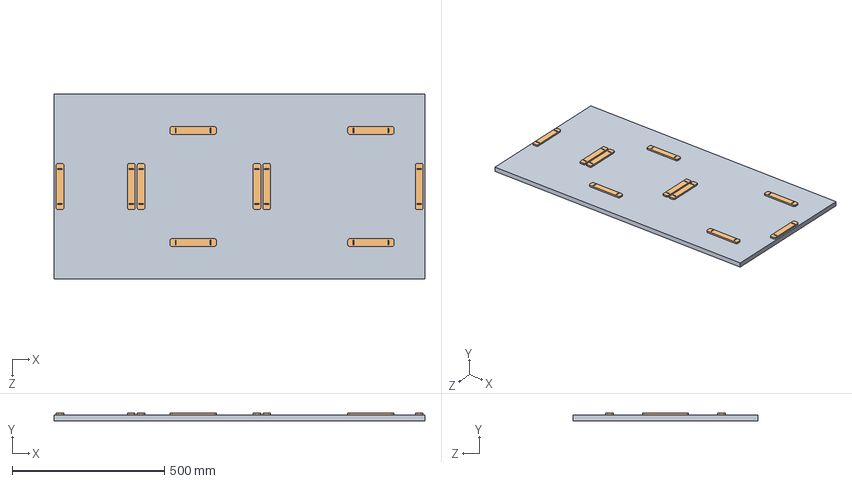
[picture p89: CAD file, 2013-12-16]
CAD/Linear Book Scanner/Base/BASE.SLDASM
1219.2 x 25.7 x 609.6 mm
PLYWOOD, BASE
SPACER, BASE x 10
