wrightsh/Michigan-Linear-Book-Scanner/CAD/Linear Book Scanner/Laser Cut Layouts/Acrylic_2.SLDASM

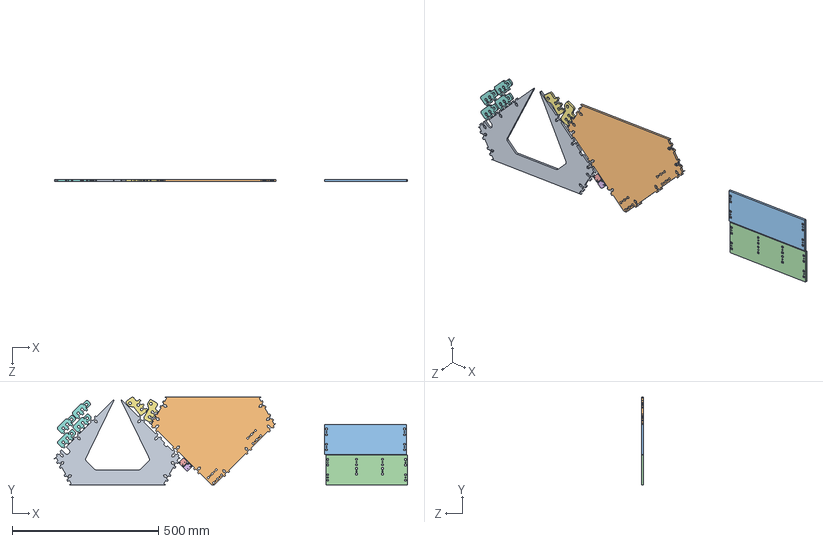
[picture p90: CAD file, 2013-12-16]
CAD/Linear Book Scanner/Laser Cut Layouts/Acrylic_2.SLDASM
1208.7 x 300.3 x 6.60 mm
RIB 5, FRAME
RIB 6, FRAME
LOWER INFEED FRONT RIB, FRAME
LOWER OUTFEED FRONT RIB, FRAME
LIMIT SWITCH MOUNT, INFEED
LIMIT SWITCH MOUNT, OUTFEED
MOUNT OFFSET, PULLY x 2
MOUNT, PULLY x 4
