wrightsh/Michigan-Linear-Book-Scanner/CAD/Linear Book Scanner/Scanner Bars/SCANNER BAR, OUTFEED.SLDASM

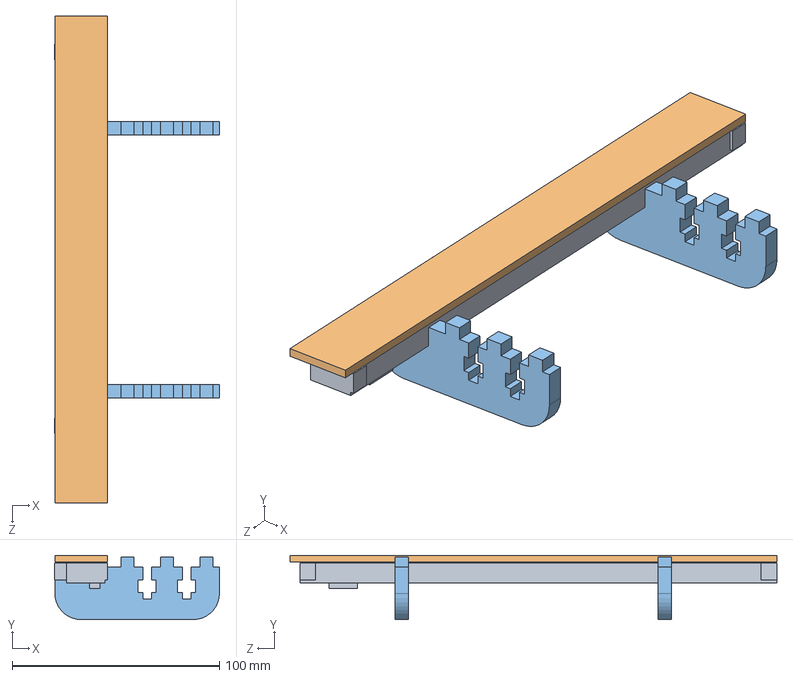
[picture p91: CAD file, 2013-12-16]
CAD/Linear Book Scanner/Scanner Bars/SCANNER BAR, OUTFEED.SLDASM
79.6 x 31.0 x 235.0 mm
Canon 220 Scanner Bar
GLASS COVER, SCANNER BAR
BRACKET, SCANNER BAR OUTFEED x 2
