wrightsh/Michigan-Linear-Book-Scanner/CAD/Linear Book Scanner/Fastener Example/FASTENER EXAMPLE EXPO.SLDASM

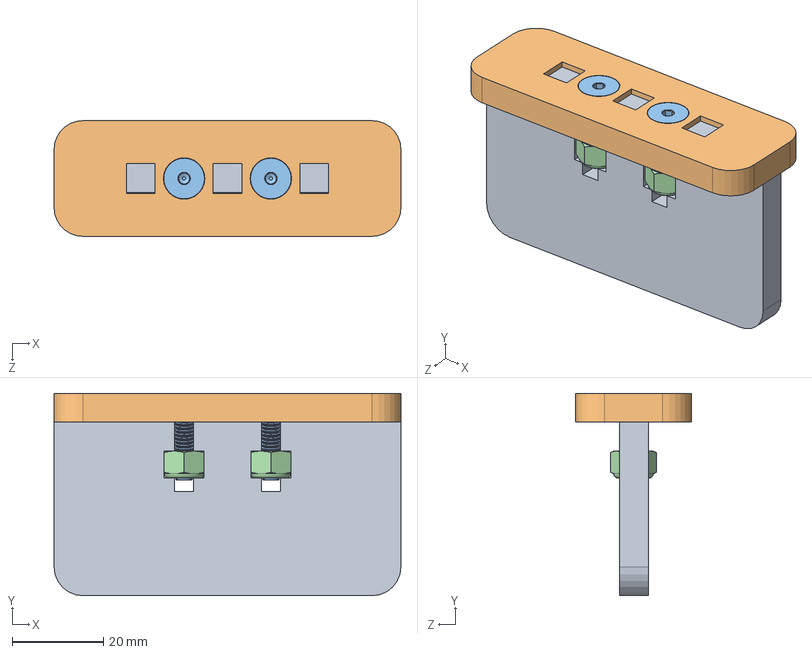
[picture p92: CAD file, 2013-12-16]
CAD/Linear Book Scanner/Fastener Example/FASTENER EXAMPLE EXPO.SLDASM
76.2 x 44.5 x 25.4 mm
BOLT HOLE FOR EXPO
NUT HOLE FOR EXPO
92210A197 x 2
90631A009 x 2
