wrightsh/Michigan-Linear-Book-Scanner/CAD/Linear Book Scanner/Laser Cut Layouts/Acrylic_5.SLDASM

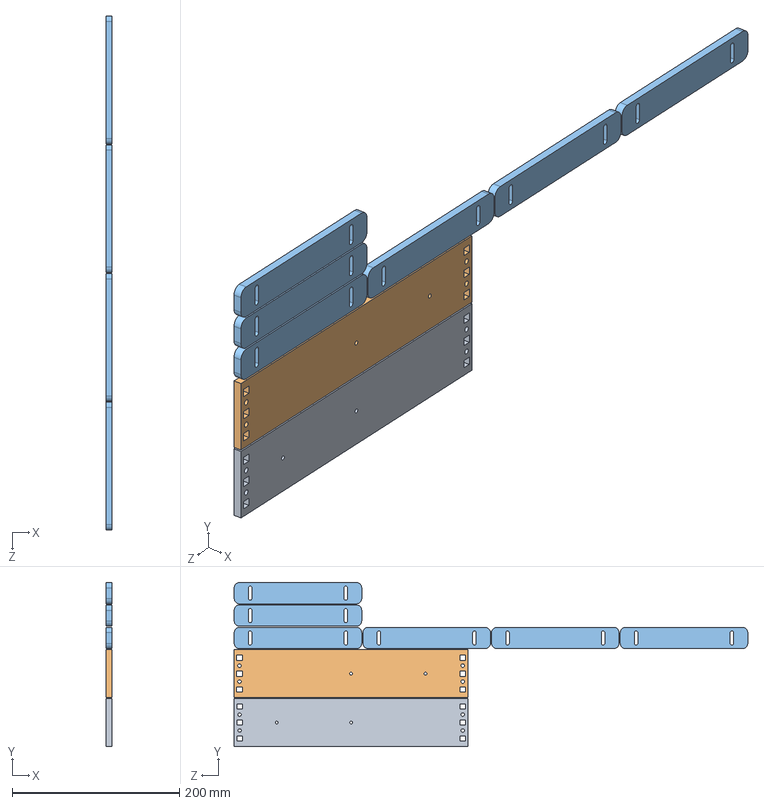
[picture p93: CAD file, 2013-12-16]
CAD/Linear Book Scanner/Laser Cut Layouts/Acrylic_5.SLDASM
6.60 x 196.0 x 613.8 mm
SLIDE MOUNT INFEED, ELECTRONICS SLIDE
SLIDE MOUNT OUTFEED, ELECTRONICS SLIDE
SPACER, BASE x 6
