wrightsh/Michigan-Linear-Book-Scanner/CAD/Linear Book Scanner/Scanner Bars/SCANNER BAR, INFEED.SLDASM

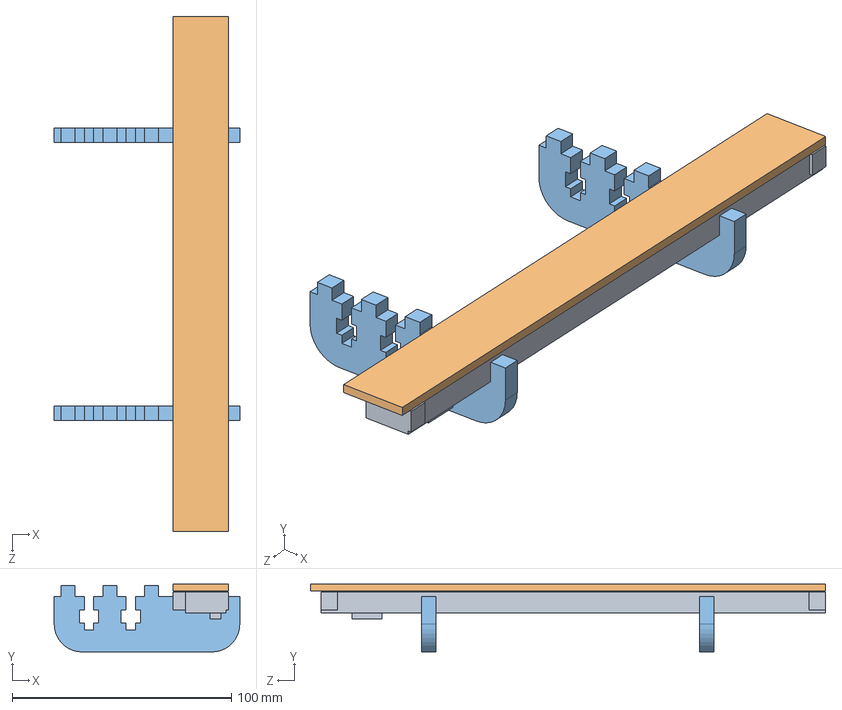
[picture p94: CAD file, 2013-12-16]
CAD/Linear Book Scanner/Scanner Bars/SCANNER BAR, INFEED.SLDASM
84.7 x 31.0 x 235.0 mm
Canon 220 Scanner Bar
GLASS COVER, SCANNER BAR
BRACKET, SCANNER BAR INFEED x 2
