wrightsh/Michigan-Linear-Book-Scanner/CAD/Linear Book Scanner/Sides/SIDE OUTFEED BACK.SLDASM

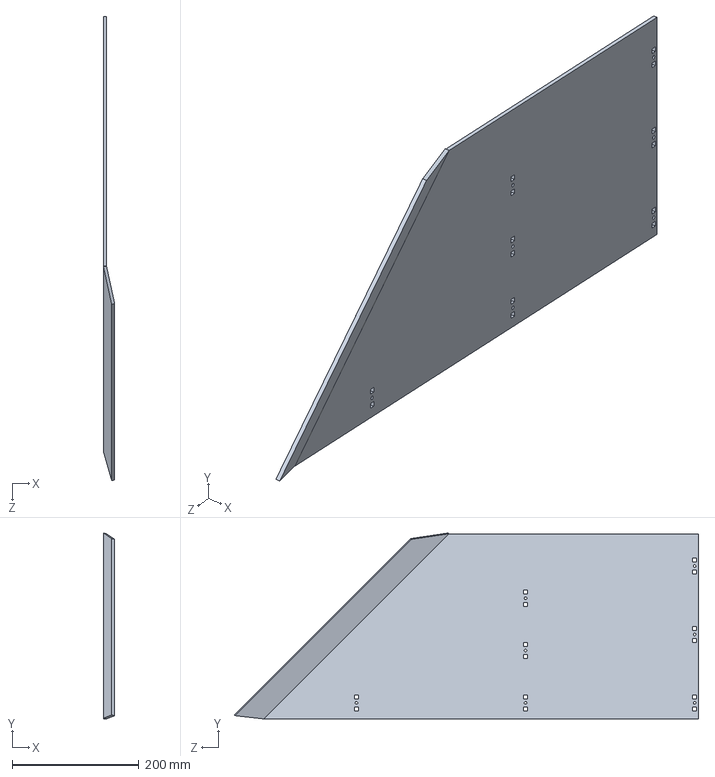
[picture p95: CAD file, 2013-12-16]
CAD/Linear Book Scanner/Sides/SIDE OUTFEED BACK.SLDASM
18.1 x 293.4 x 732.6 mm
