wrightsh/Michigan-Linear-Book-Scanner/CAD/Linear Book Scanner/Electronics Slide/ELECTRONICS SLIDE.SLDASM

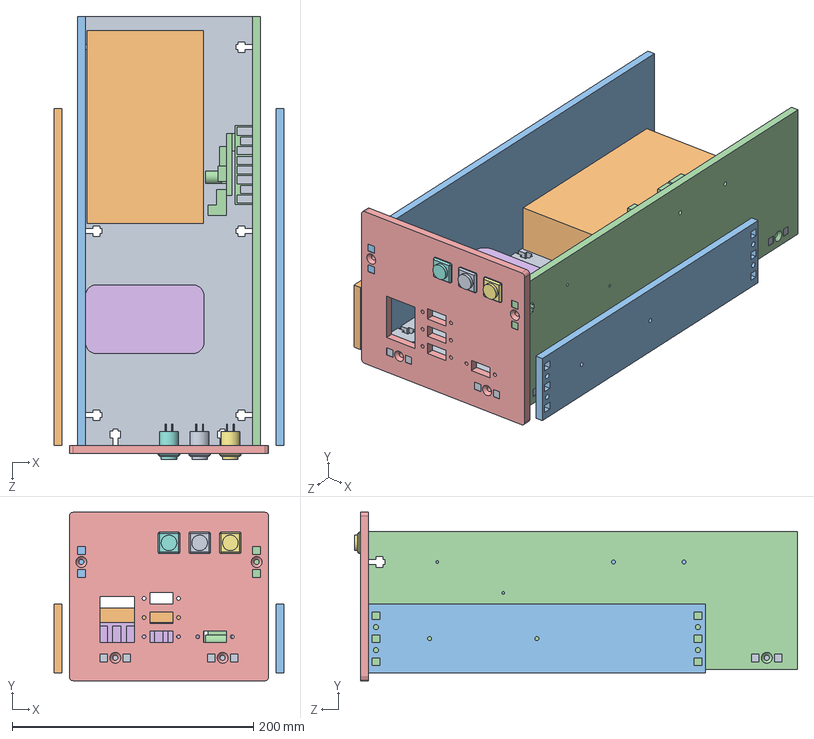
[picture p96: CAD file, 2013-12-16]
CAD/Linear Book Scanner/Electronics Slide/ELECTRONICS SLIDE.SLDASM
190.5 x 139.7 x 367.0 mm
BASE, ELECTRONICS SLIDE
power supply
SIDE OUTFEED, ELECTRONICS SLIDE
SIDE INFEED, ELECTRONICS SLIDE
FRONT, ELECTRONICS SLIDE
D-Link USB Hub
Iluminated Button Green
Iluminated Button Red
Iluminated Button Yellow
SLIDE MOUNT OUTFEED, ELECTRONICS SLIDE
SLIDE MOUNT INFEED, ELECTRONICS SLIDE
STEPPER DRIVER, SAINSMART
