wrightsh/Michigan-Linear-Book-Scanner/CAD/Linear Book Scanner/Laser Cut Layouts/Acrylic_4.SLDASM

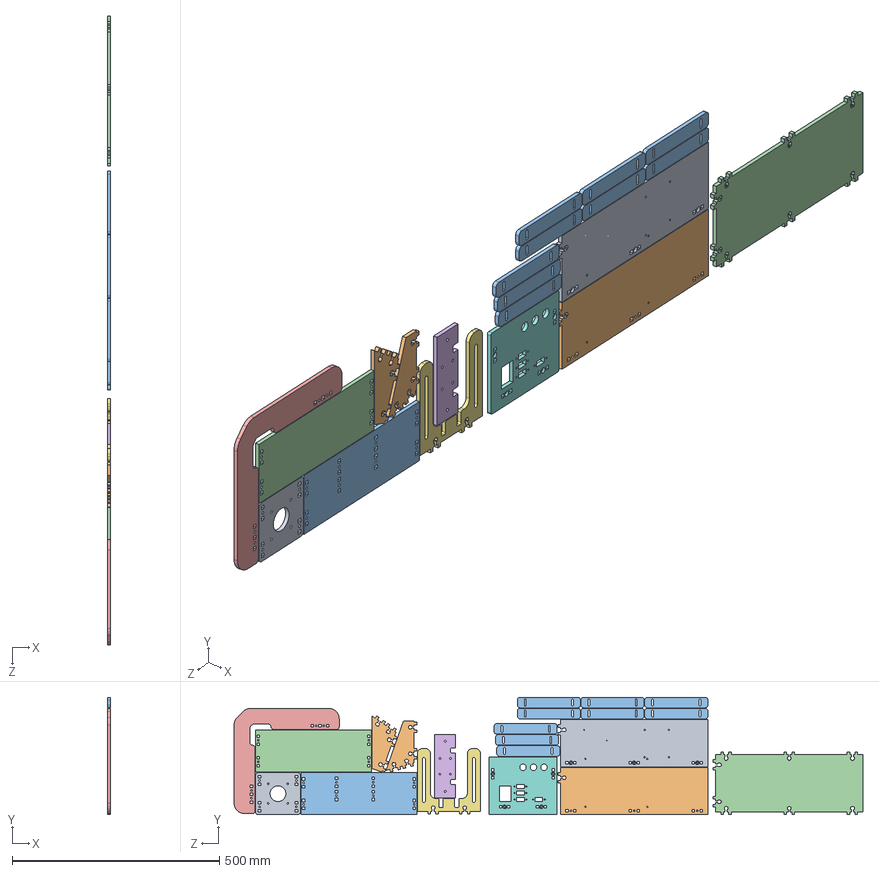
[picture p97: CAD file, 2013-12-16]
CAD/Linear Book Scanner/Laser Cut Layouts/Acrylic_4.SLDASM
6.60 x 283.4 x 1517.2 mm
FACE, MOTOR MOUNT
SIDE, MOTOR MOUNT x 2
LOWER OUTFEED FRONT RIB, FRAME
LOWER INFEED FRONT RIB, FRAME
SIDE PADDLE, SADDLE
LINK, SADDLE
LOWER PADDLE SLIDE, SADDLE
FRONT, ELECTRONICS SLIDE
SIDE INFEED, ELECTRONICS SLIDE
SIDE OUTFEED, ELECTRONICS SLIDE
SPACER, BASE x 9
BASE, ELECTRONICS SLIDE
