wrightsh/Michigan-Linear-Book-Scanner/CAD/Linear Book Scanner/Laser Cut Layouts/Acrylic_1.SLDASM

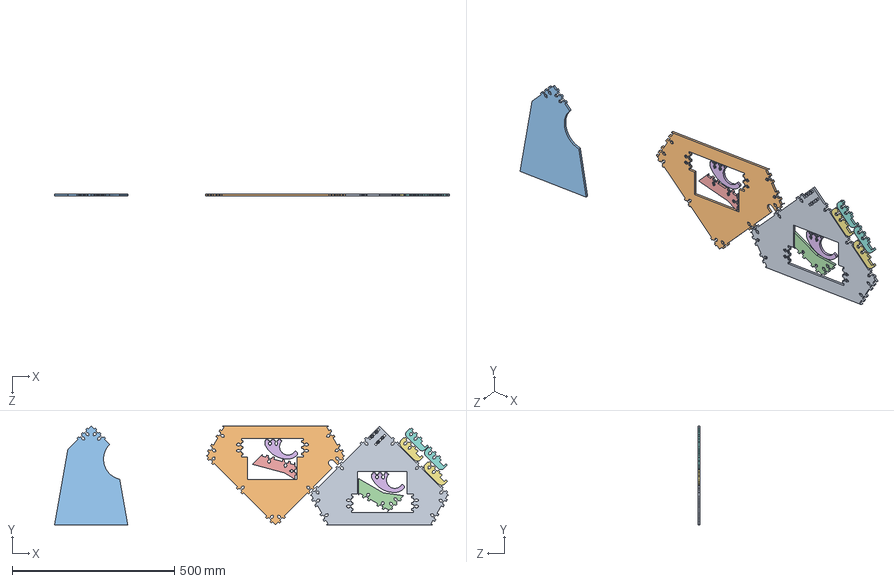
[picture p98: CAD file, 2013-12-16]
CAD/Linear Book Scanner/Laser Cut Layouts/Acrylic_1.SLDASM
1217.0 x 304.8 x 6.60 mm
RIB 1, FRAME
RIB 2, FRAME
RIB 3, FRAME
RIB 4 INFEED, FRAME
RIB 4 OUTFEED, FRAME
BRACKET, VACUUM TUBE x 2
BRACKET, SCANNER BAR INFEED x 2
BRACKET, SCANNER BAR OUTFEED x 2
