wrightsh/Michigan-Linear-Book-Scanner/CAD/Linear Book Scanner/Electronics Slide/raspberry-pi-b-1/raspberry_pi__micro_USB.SLDASM

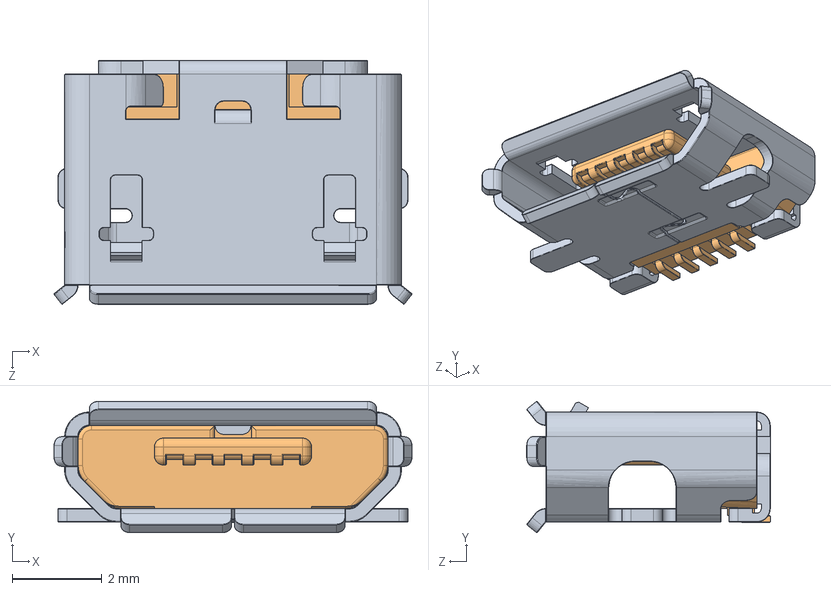
[picture p99: CAD file, 2013-12-16]
CAD/Linear Book Scanner/Electronics Slide/raspberry-pi-b-1/raspberry_pi__micro_USB.SLDASM
7.97 x 2.92 x 5.43 mm
raspberry_pi__micro_USB_cover
raspberry_pi__micro_USB_contacts
