wrightsh/Michigan-Linear-Book-Scanner/CAD/Linear Book Scanner/Laser Cut Layouts/Delrin_2.SLDASM

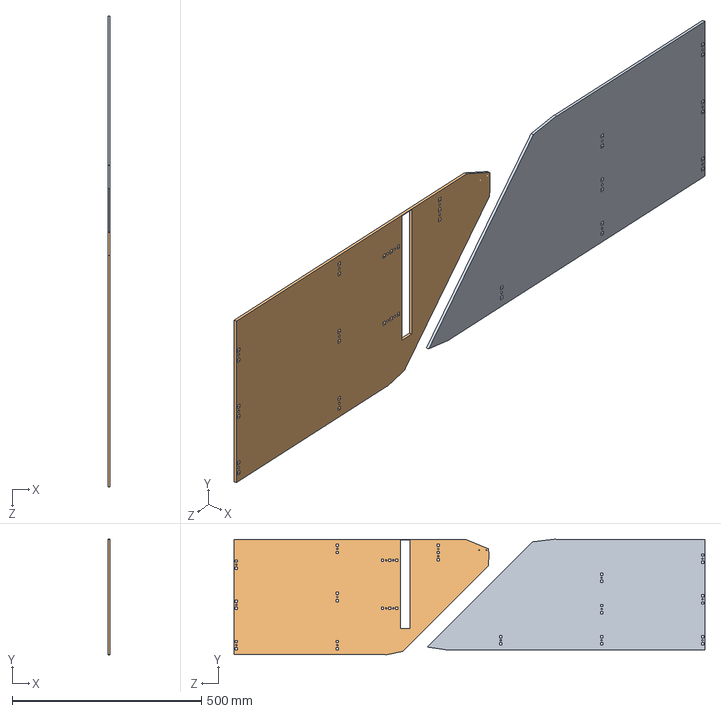
[picture p100: CAD file, 2013-12-16]
CAD/Linear Book Scanner/Laser Cut Layouts/Delrin_2.SLDASM
5.08 x 306.2 x 1244.6 mm
OUTFEED BACK, SIDE
OUTFEED FRONT, SIDE
