wrightsh/Michigan-Linear-Book-Scanner/CAD/Linear Book Scanner/Pulleys/PULLEY BLOCK, LOWER OUTFEED.SLDASM

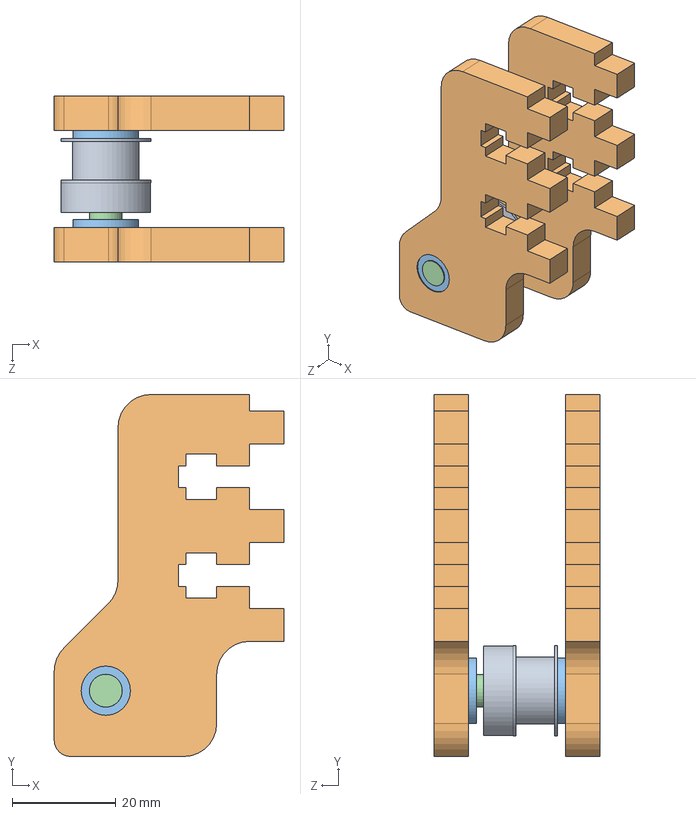
[picture p101: CAD file, 2013-12-16]
CAD/Linear Book Scanner/Pulleys/PULLEY BLOCK, LOWER OUTFEED.SLDASM
44.3 x 69.8 x 32.0 mm
1375K39
MOUNT OFFSET, PULLY x 2
6338K411 x 2
SHAFT, PULLY
