wrightsh/Michigan-Linear-Book-Scanner/CAD/Linear Book Scanner/Saddle/SADDLE.SLDASM

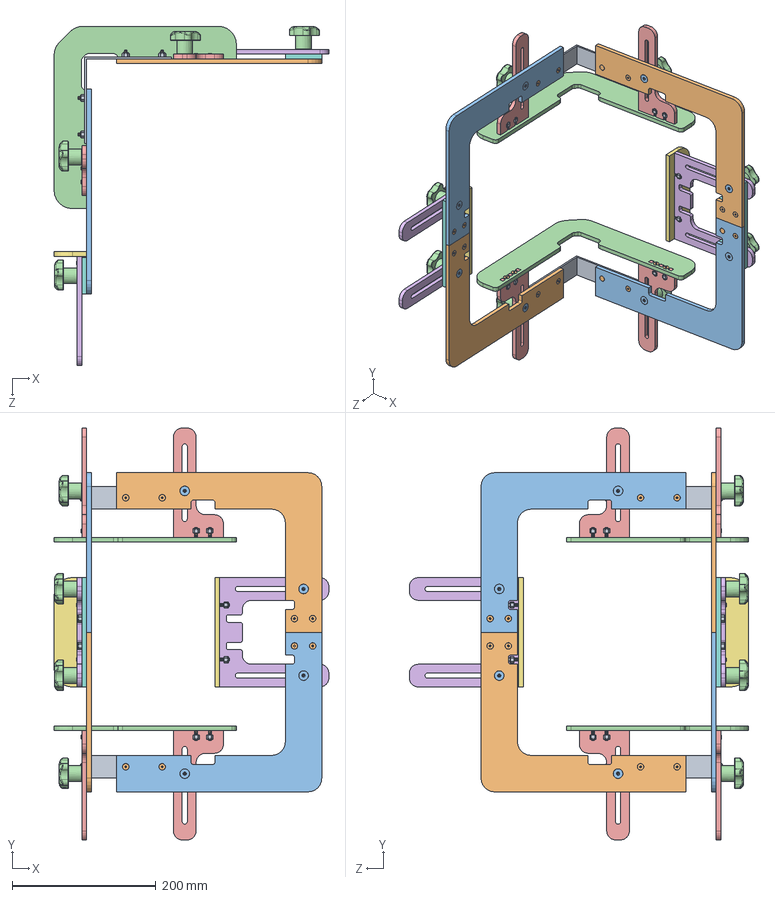
[picture p102: CAD file, 2013-12-16]
CAD/Linear Book Scanner/Saddle/SADDLE.SLDASM
382.8 x 573.7 x 472.8 mm
17715A68 x 2
SIDE_1, SADDLE x 2
SIDE_2, SADDLE x 2
SIDE PADDLE, SADDLE x 2
PADDLE SLIDE, SADDLE x 4
LOWER PADDLE SLIDE, SADDLE x 2
LOWER PADDLE, SADDLE x 2
LINK, SADDLE x 2
90631A009 x 28
92210A197 x 28
92210A546 x 8
59625K330 x 8
