wrightsh/Michigan-Linear-Book-Scanner/CAD/Linear Book Scanner/Electronics Slide/raspberry-pi-b-1/raspberry_pi__USB_x2.SLDASM

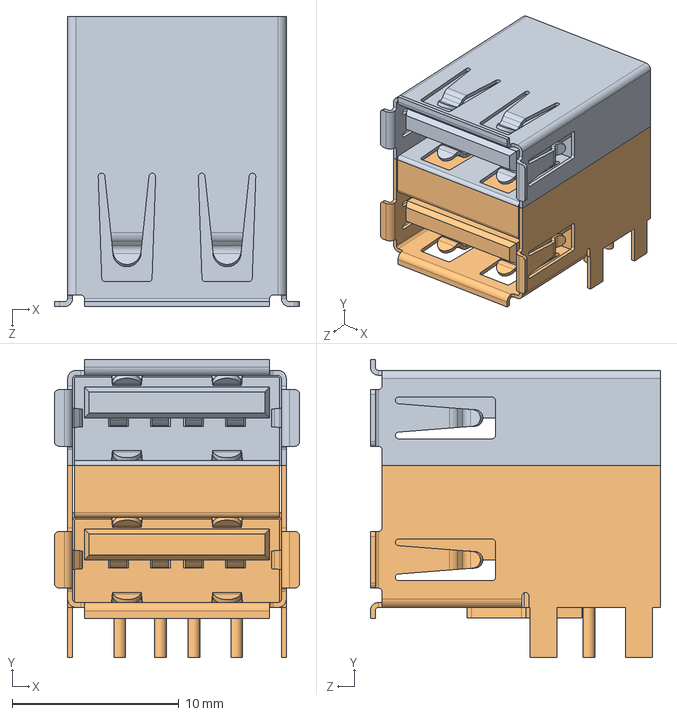
[picture p103: CAD file, 2013-12-16]
CAD/Linear Book Scanner/Electronics Slide/raspberry-pi-b-1/raspberry_pi__USB_x2.SLDASM
14.7 x 17.9 x 17.4 mm
raspberry_pi__USB_x2_part1
raspberry_pi__USB_x2_part2
