wrightsh/Michigan-Linear-Book-Scanner/CAD/Linear Book Scanner/Sides/SIDE INFEED BACK.SLDASM

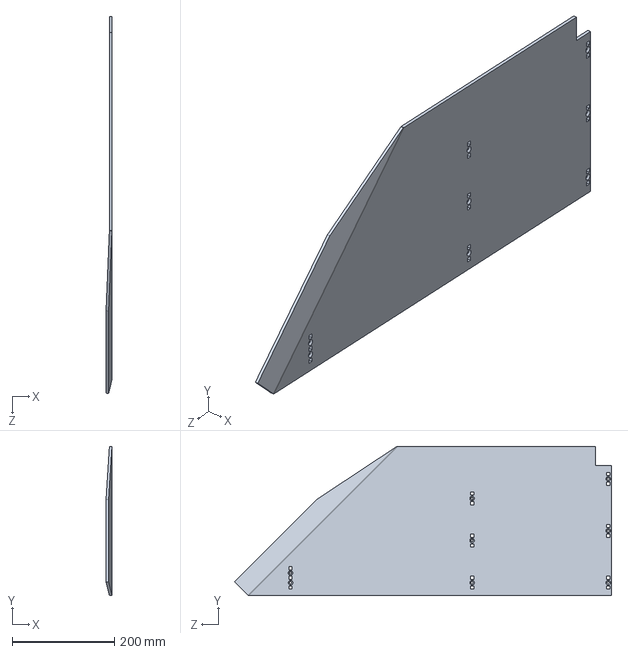
[picture p104: CAD file, 2013-12-16]
CAD/Linear Book Scanner/Sides/SIDE INFEED BACK.SLDASM
11.7 x 292.6 x 738.4 mm
