wrightsh/Michigan-Linear-Book-Scanner/CAD/Linear Book Scanner/Sides/SIDE OUTFEED FRONT.SLDASM

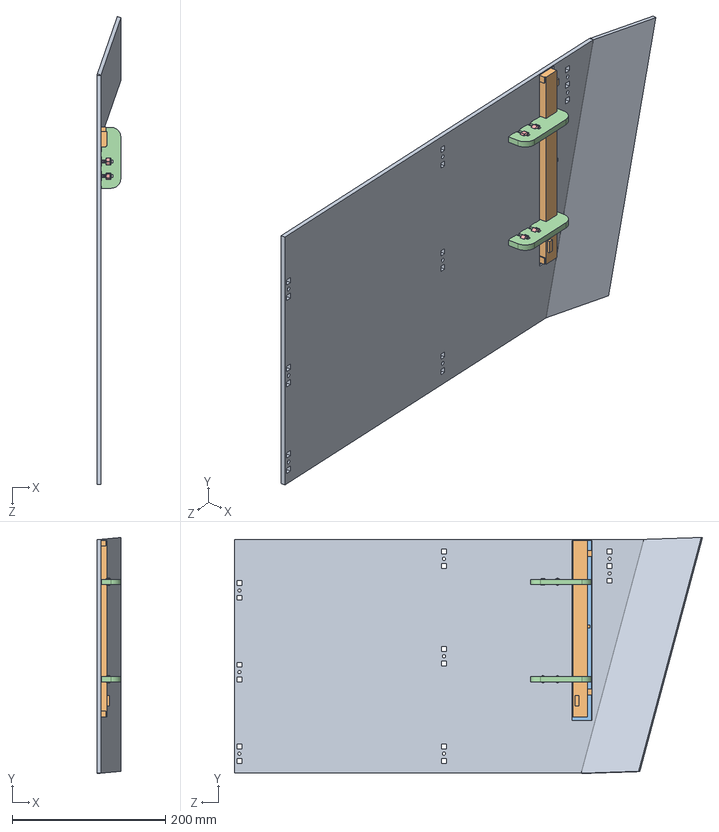
[picture p105: CAD file, 2013-12-16]
CAD/Linear Book Scanner/Sides/SIDE OUTFEED FRONT.SLDASM
31.1 x 307.7 x 610.0 mm
OUTFEED FRONT, SIDE
Canon 220 Scanner Bar
GLASS COVER, SCANNER BAR
BRACKET, SCANNER BAR OUTFEED x 2
90631A009 x 4
92210A197 x 4
