wrightsh/Michigan-Linear-Book-Scanner/CAD/Linear Book Scanner/Electronics Slide/raspberry-pi-b-1/raspberrypi_b_assembly.SLDASM

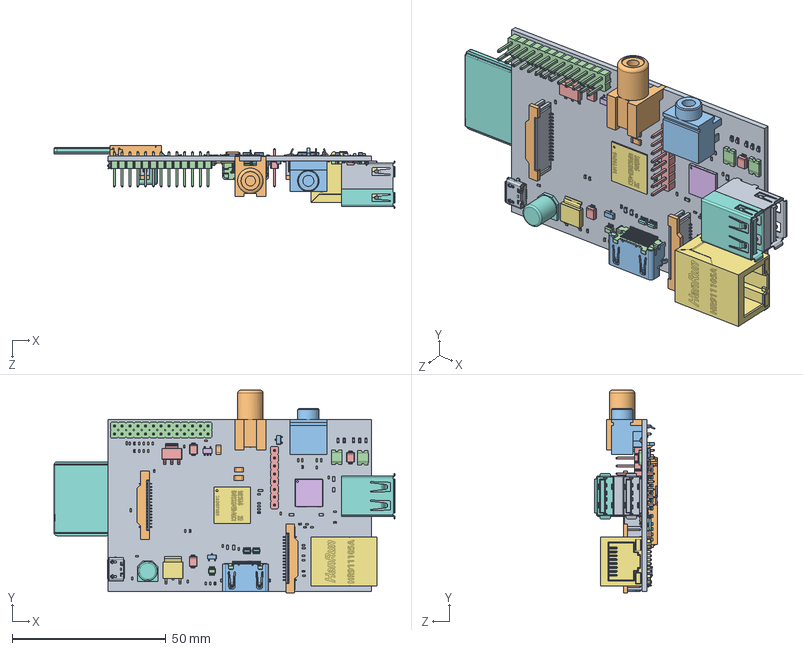
[picture p106: CAD file, 2013-12-16]
CAD/Linear Book Scanner/Electronics Slide/raspberry-pi-b-1/raspberrypi_b_assembly.SLDASM
110.8 x 65.9 x 20.5 mm
raspberry_pi__CI_Board
raspberry_pi__composite_video_out
raspberry_pi__audio_out
raspberry_pi__bar_180_2x13
raspberry_pi__bar_180_1x8
raspberry_pi__QFN64-2
raspberry_pi__168_FBGA_12x12
raspberry_pi__USB_x2_part1
raspberry_pi__USB_x2_part2
raspberry_pi__SD_reader_body
raspberry_pi__SD_reader_pin1 x 2
raspberry_pi__SD_reader_pin2 x 10
raspberry_pi__SD_reader_pin3
raspberry_pi__SD_reader_pin4
raspberry_pi__SD_reader_pin5
raspberry_pi__SD Card
raspberry_pi__micro_USB_cover
raspberry_pi__micro_USB_contacts
raspberry_pi__HDMI_socket_cover
raspberry_pi__HDMI_socket_inside
raspberry_pi__HDMI_socket_large_pin x 10
raspberry_pi__HDMI_socket_small_pin x 9
raspberry_pi__RJ45
raspberry_pi__capacitor_smd
raspberry_pi__0603 x 14
raspberry_pi__1206 x 6
raspberry_pi__Sot23 x 9
raspberry_pi__Smd6
raspberry_pi__Sot223
raspberry_pi__Sot23-3_5pins
raspberry_pi__sot-223_large
raspberry_pi__Xtal_Smd_25
raspberry_pi__1206xl
raspberry_pi__Xtal_Smd_19200
raspberry_pi__1210
raspberry_pi__1812 x 3
raspberry_pi__SOD-123_DiodesInc x 3
raspberry_pi__LED_SMD_0603 x 5
raspberry_pi__0402 x 128
raspberry_pi__diode_10_pins x 2
raspberry_pi__15_pin_FFC_Connector_body x 2
raspberry_pi__15_pin_FFC_Connector_locker x 2
raspberry_pi__15_pin_FFC_Connector_pins x 30
