wrightsh/Michigan-Linear-Book-Scanner/CAD/Linear Book Scanner/Electronics Slide/raspberry-pi-b-1/raspberry_pi__SD_reader_assembly.SLDASM

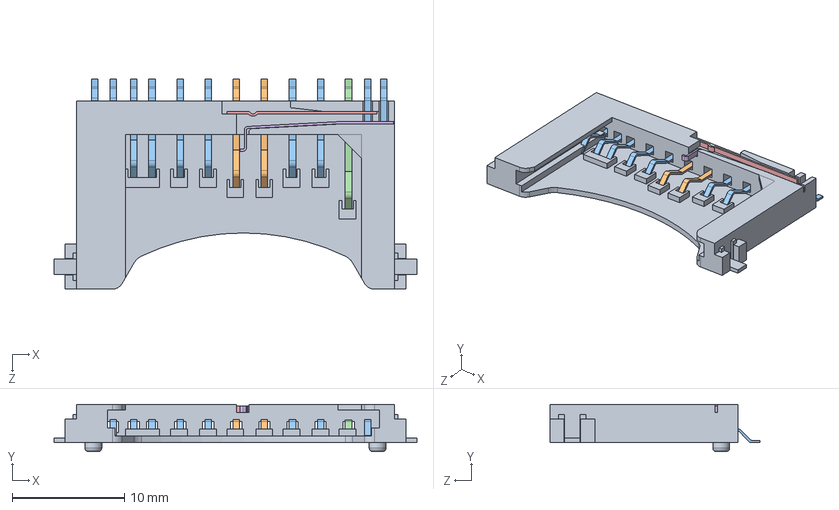
[picture p107: CAD file, 2013-12-16]
CAD/Linear Book Scanner/Electronics Slide/raspberry-pi-b-1/raspberry_pi__SD_reader_assembly.SLDASM
32.3 x 4.20 x 18.7 mm
raspberry_pi__SD_reader_body
raspberry_pi__SD_reader_pin1 x 2
raspberry_pi__SD_reader_pin2 x 10
raspberry_pi__SD_reader_pin3
raspberry_pi__SD_reader_pin4
raspberry_pi__SD_reader_pin5
