wrightsh/Michigan-Linear-Book-Scanner/CAD/Linear Book Scanner/Electronics Slide/raspberry-pi-b-1/raspberry_pi__15_pin_FFC_Connector.SLDASM

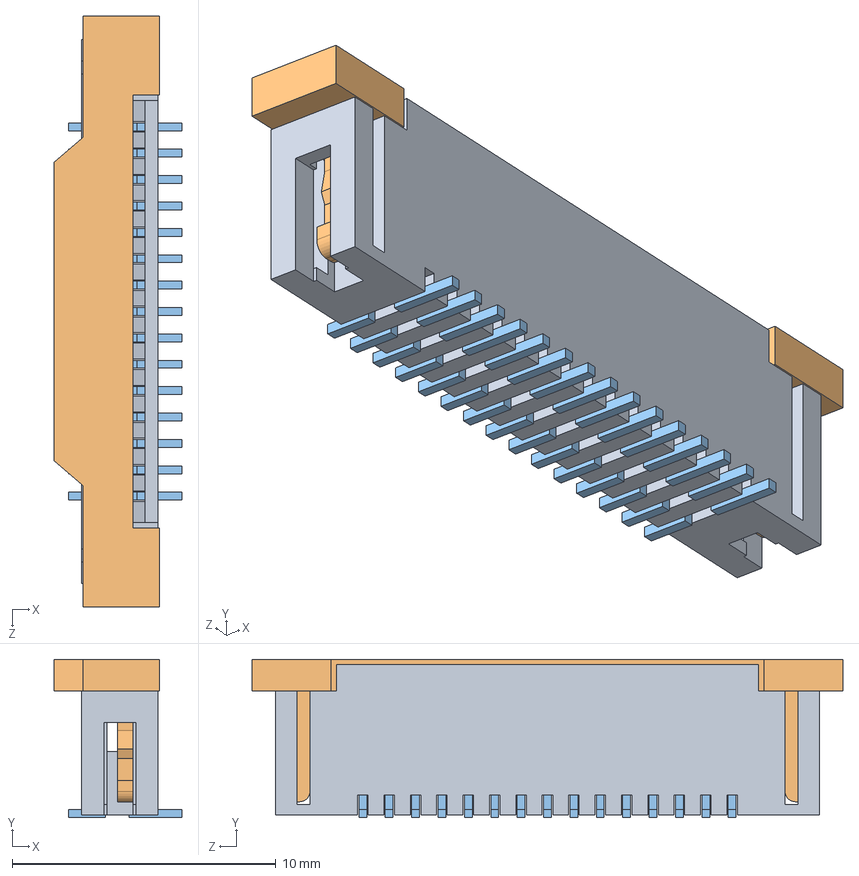
[picture p108: CAD file, 2013-12-16]
CAD/Linear Book Scanner/Electronics Slide/raspberry-pi-b-1/raspberry_pi__15_pin_FFC_Connector.SLDASM
4.85 x 6.00 x 22.4 mm
raspberry_pi__15_pin_FFC_Connector_body
raspberry_pi__15_pin_FFC_Connector_locker
raspberry_pi__15_pin_FFC_Connector_pins x 15
