wrightsh/Michigan-Linear-Book-Scanner/CAD/Linear Book Scanner/Base/SPACER, BASE.SLDPRT

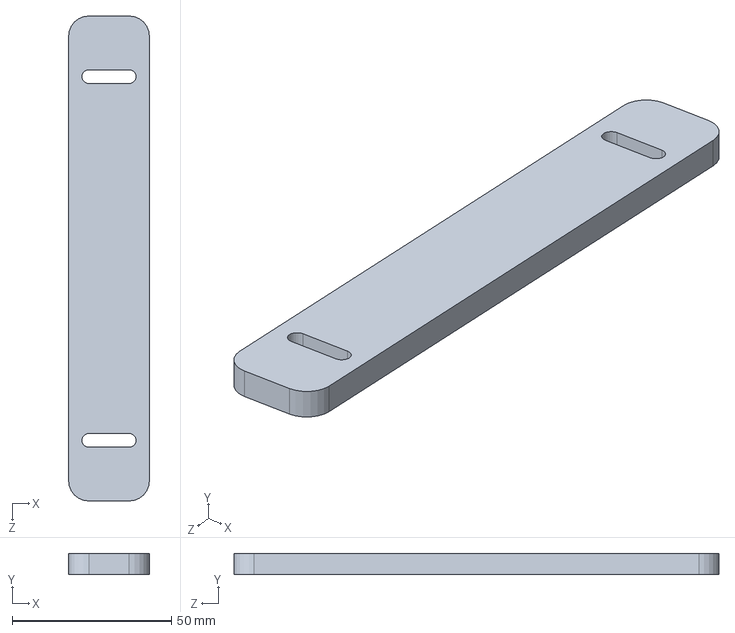
[picture p110: CAD file, 2013-12-16]
CAD/Linear Book Scanner/Base/SPACER, BASE.SLDPRT
25.4 x 6.60 x 152.4 mm
