wrightsh/Michigan-Linear-Book-Scanner/CAD/Linear Book Scanner/Electronics Slide/SIDE INFEED, ELECTRONICS SLIDE.SLDPRT

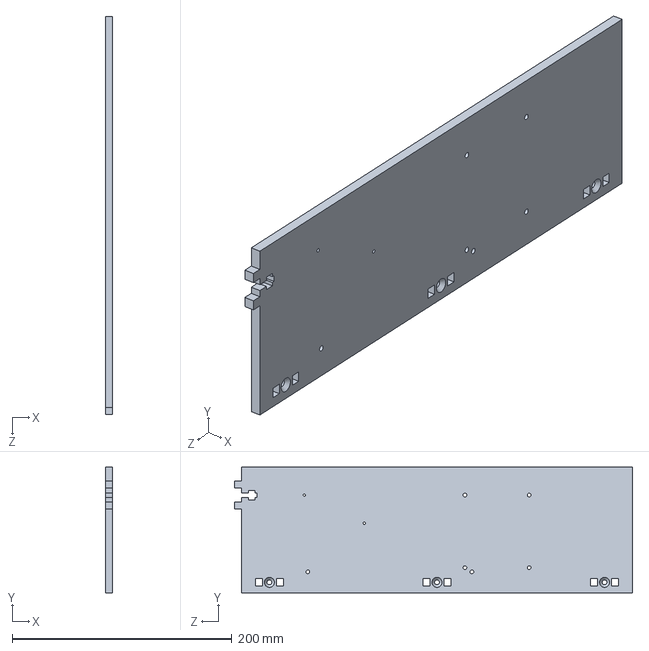
[picture p112: CAD file, 2013-12-16]
CAD/Linear Book Scanner/Electronics Slide/SIDE INFEED, ELECTRONICS SLIDE.SLDPRT
6.60 x 114.3 x 361.9 mm
