wrightsh/Michigan-Linear-Book-Scanner/CAD/Linear Book Scanner/Frame/RIB 1, FRAME.SLDPRT

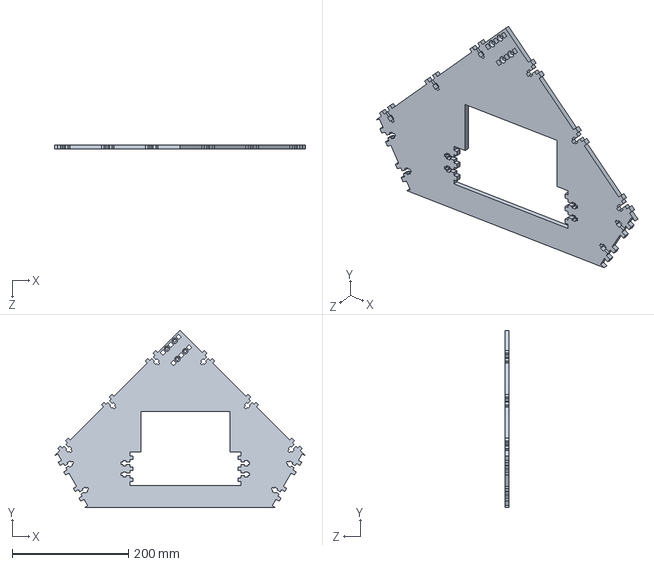
[picture p114: CAD file, 2013-12-16]
CAD/Linear Book Scanner/Frame/RIB 1, FRAME.SLDPRT
431.1 x 304.4 x 6.60 mm
