wrightsh/Michigan-Linear-Book-Scanner/CAD/Linear Book Scanner/Laser Cut Drawings/Acrylic_2.DXF

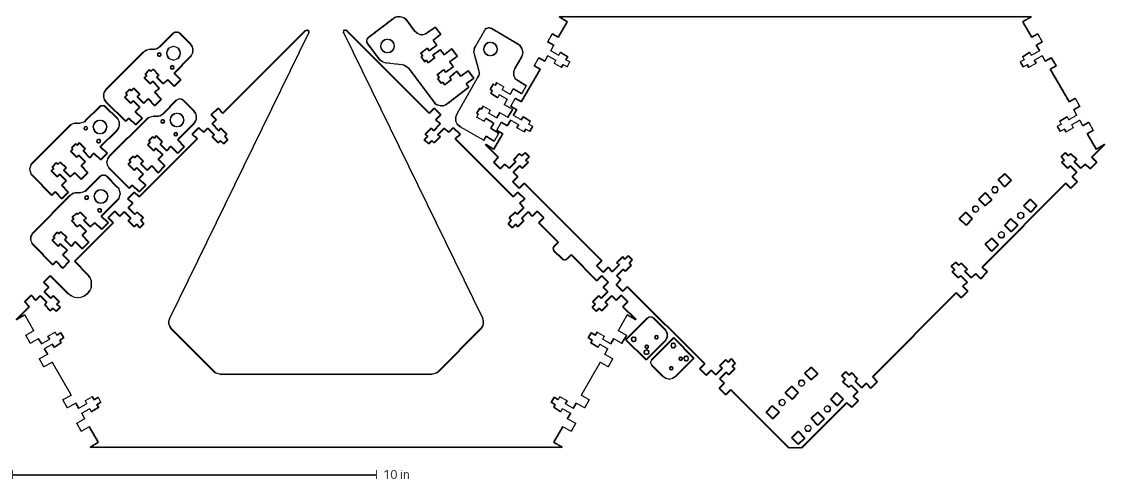
[picture p115: CAD file, 2013-12-16]
CAD/Linear Book Scanner/Laser Cut Drawings/Acrylic_2.DXF
29.8 x 11.8 in
