wrightsh/Michigan-Linear-Book-Scanner/CAD/Linear Book Scanner/Saddle/SIDE, SADDLE.SLDPRT

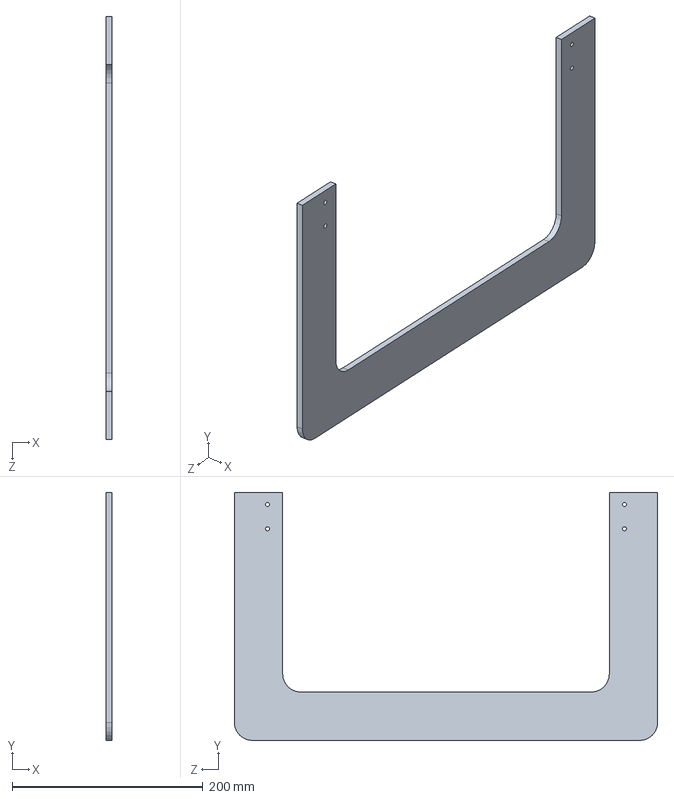
[picture p116: CAD file, 2013-12-16]
CAD/Linear Book Scanner/Saddle/SIDE, SADDLE.SLDPRT
6.35 x 260.3 x 444.5 mm
