wrightsh/Michigan-Linear-Book-Scanner/CAD/Linear Book Scanner/Scanner Bars/BRACKET, SCANNER BAR INFEED.SLDPRT

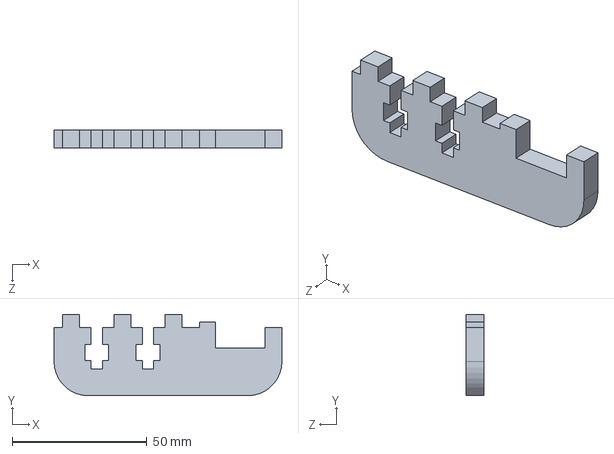
[picture p117: CAD file, 2013-12-16]
CAD/Linear Book Scanner/Scanner Bars/BRACKET, SCANNER BAR INFEED.SLDPRT
84.7 x 30.2 x 6.60 mm
