wrightsh/Michigan-Linear-Book-Scanner/CAD/Linear Book Scanner/Vacuum Tube/vac/OUTSIDE TUBE, VACUUM TUBE.SLDPRT

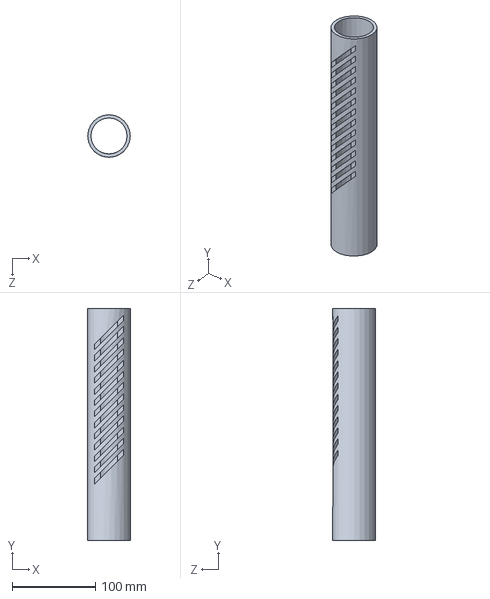
[picture p118: CAD file, 2013-12-16]
CAD/Linear Book Scanner/Vacuum Tube/vac/OUTSIDE TUBE, VACUUM TUBE.SLDPRT
51.3 x 279.4 x 51.3 mm
