wrightsh/Michigan-Linear-Book-Scanner/CAD/Linear Book Scanner/Electronics Slide/USB Wall Wart.SLDPRT

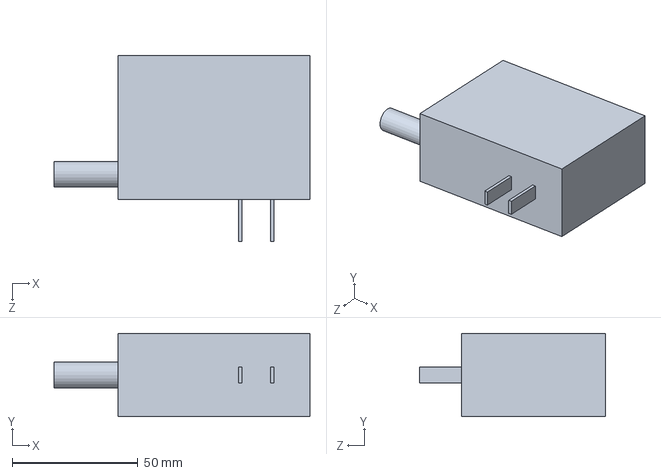
[picture p120: CAD file, 2013-12-16]
CAD/Linear Book Scanner/Electronics Slide/USB Wall Wart.SLDPRT
101.6 x 33.0 x 73.7 mm
