wrightsh/Michigan-Linear-Book-Scanner/CAD/Linear Book Scanner/Fastener Example/8-32 FH SHCS.SLDPRT

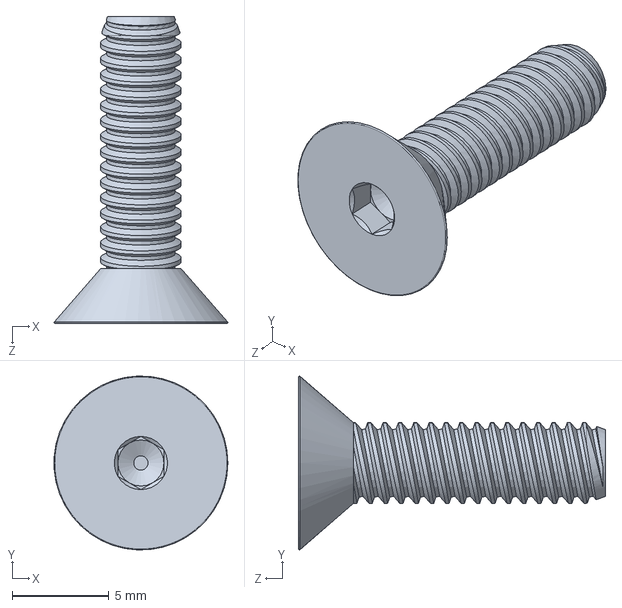
[picture p121: CAD file, 2013-12-16]
CAD/Linear Book Scanner/Fastener Example/8-32 FH SHCS.SLDPRT
8.98 x 8.99 x 15.9 mm
