wrightsh/Michigan-Linear-Book-Scanner/CAD/Linear Book Scanner/Fastener Example/Laser Cut Test/SIDE- 0,007.DXF

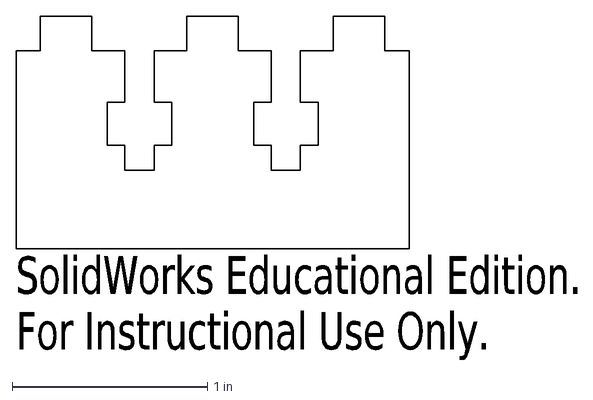
[picture p122: CAD file, 2013-12-16]
CAD/Linear Book Scanner/Fastener Example/Laser Cut Test/SIDE- 0,007.DXF
SolidWorks Educational Edition.
For Instructional Use Only.
