wrightsh/Michigan-Linear-Book-Scanner/CAD/Linear Book Scanner/Frame/RIB 5, FRAME.SLDPRT

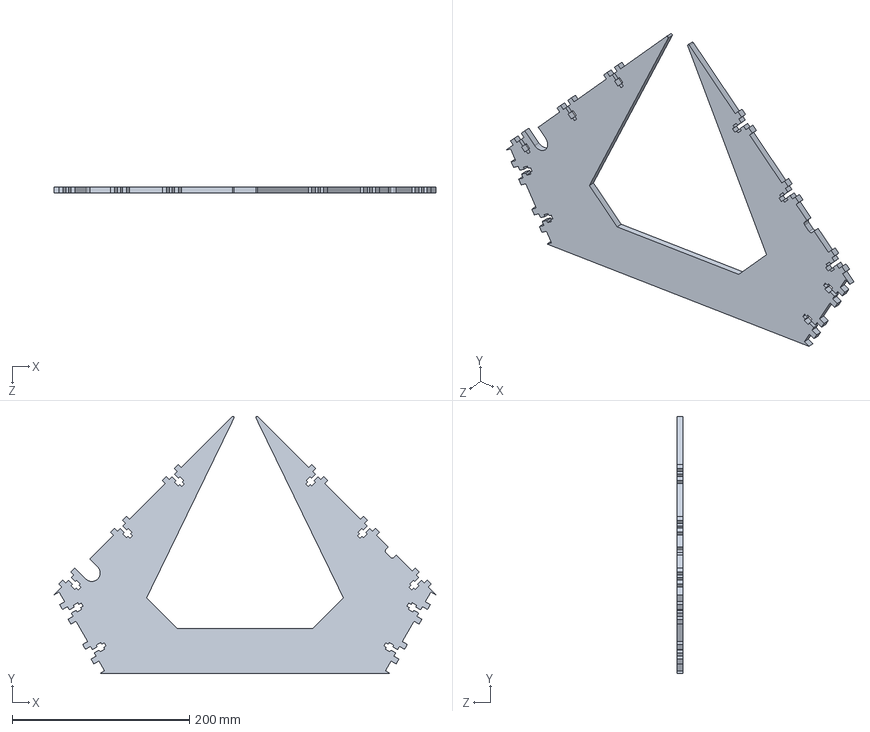
[picture p123: CAD file, 2013-12-16]
CAD/Linear Book Scanner/Frame/RIB 5, FRAME.SLDPRT
431.1 x 290.5 x 6.60 mm
