wrightsh/Michigan-Linear-Book-Scanner/CAD/Linear Book Scanner/Laser Cut Drawings/HORN_4_b OUTFEED FRONT.DXF

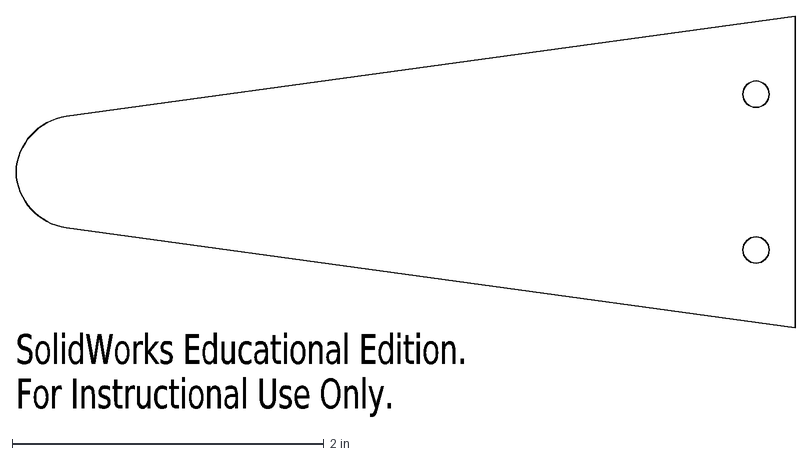
[picture p124: CAD file, 2013-12-16]
CAD/Linear Book Scanner/Laser Cut Drawings/HORN_4_b OUTFEED FRONT.DXF
SolidWorks Educational Edition.
For Instructional Use Only.
