wrightsh/Michigan-Linear-Book-Scanner/CAD/Linear Book Scanner/Motor Mount/LinEngineering_5718L.SLDPRT

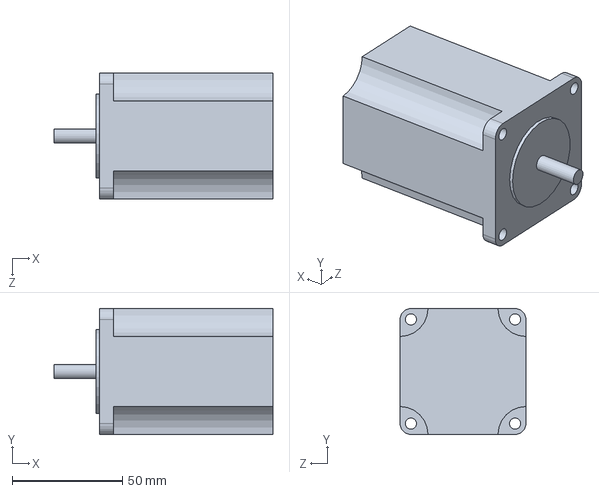
[picture p125: CAD file, 2013-12-16]
CAD/Linear Book Scanner/Motor Mount/LinEngineering_5718L.SLDPRT
99.3 x 57.1 x 57.1 mm
