wrightsh/Michigan-Linear-Book-Scanner/CAD/Linear Book Scanner/Paper.SLDPRT

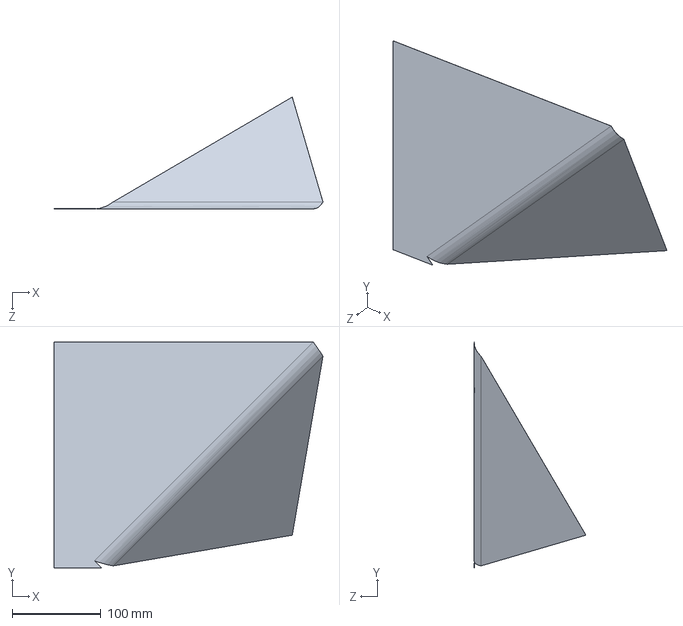
[picture p126: CAD file, 2013-12-16]
CAD/Linear Book Scanner/Paper.SLDPRT
302.5 x 254.0 x 125.8 mm
