wrightsh/Michigan-Linear-Book-Scanner/CAD/Linear Book Scanner/Pulleys/LIMIT SWITCH MOUNT, OUTFEED.SLDPRT

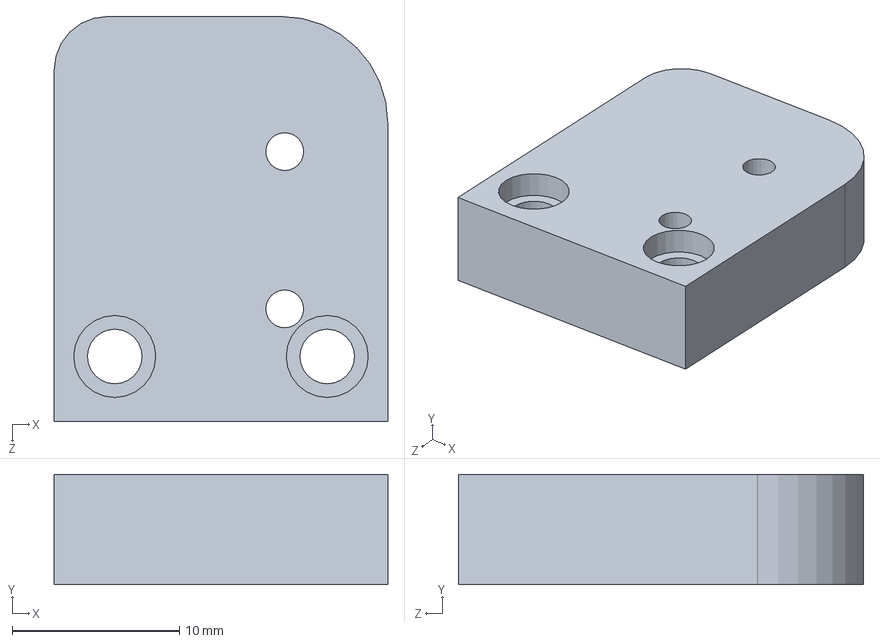
[picture p127: CAD file, 2013-12-16]
CAD/Linear Book Scanner/Pulleys/LIMIT SWITCH MOUNT, OUTFEED.SLDPRT
19.9 x 6.60 x 24.2 mm
