wrightsh/Michigan-Linear-Book-Scanner/CAD/Linear Book Scanner/Saddle/SIDE_1, SADDLE.SLDPRT

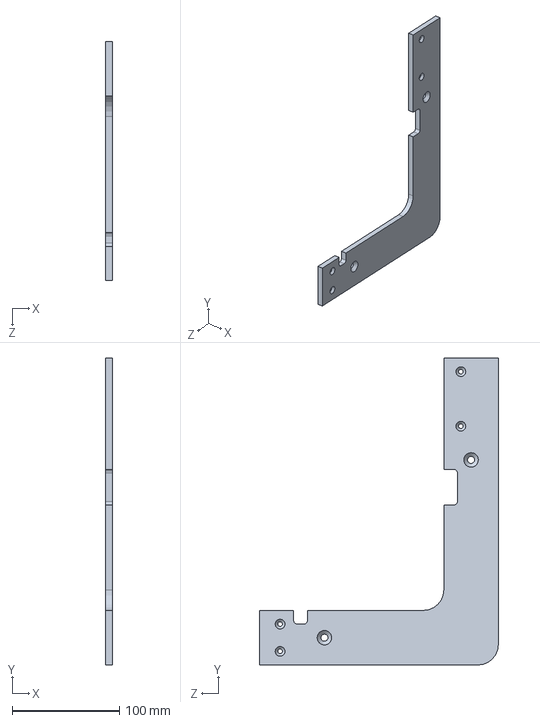
[picture p128: CAD file, 2013-12-16]
CAD/Linear Book Scanner/Saddle/SIDE_1, SADDLE.SLDPRT
6.60 x 285.8 x 222.2 mm
