wrightsh/Michigan-Linear-Book-Scanner/CAD/Linear Book Scanner/Scanner Bars/BRACKET, SCANNER BAR OUTFEED.SLDPRT

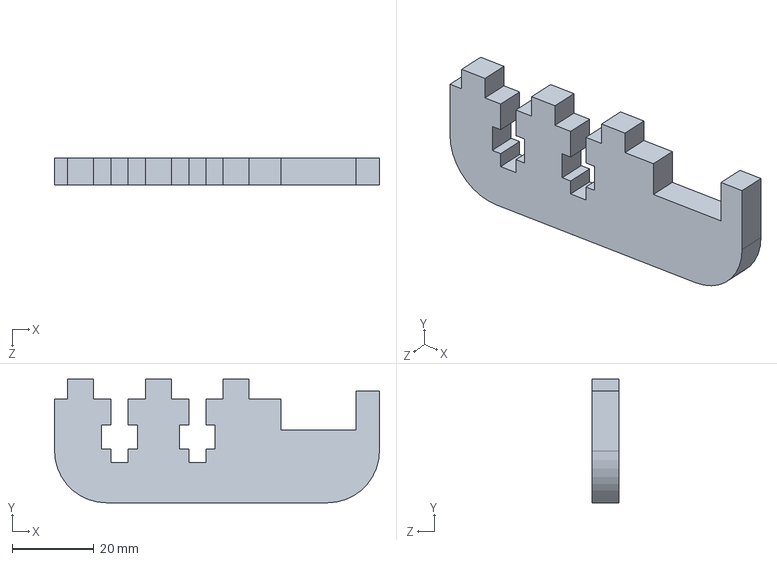
[picture p129: CAD file, 2013-12-16]
CAD/Linear Book Scanner/Scanner Bars/BRACKET, SCANNER BAR OUTFEED.SLDPRT
79.5 x 30.2 x 6.60 mm
