wrightsh/Michigan-Linear-Book-Scanner/CAD/Linear Book Scanner/BOOK.SLDPRT

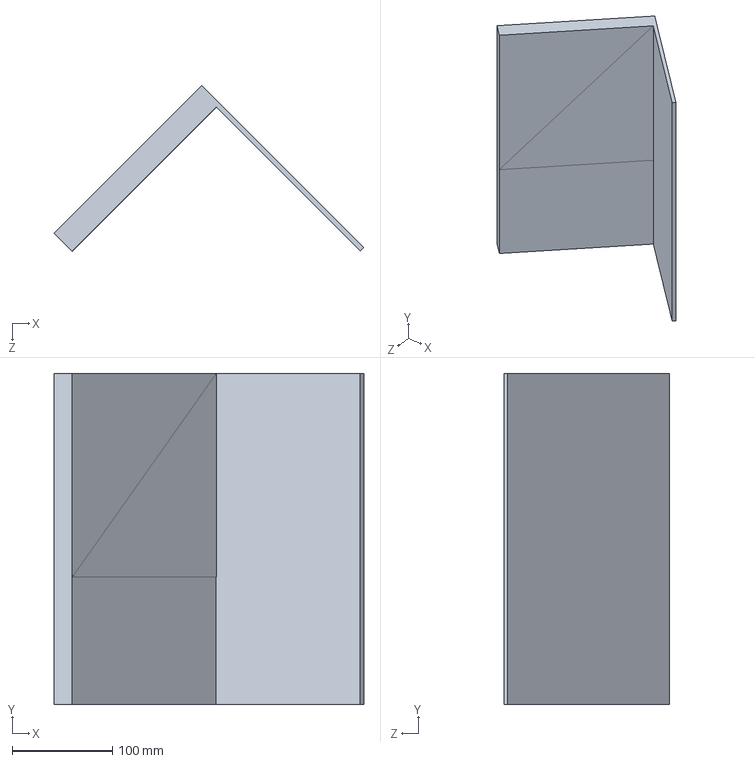
[picture p130: CAD file, 2013-12-16]
CAD/Linear Book Scanner/BOOK.SLDPRT
308.9 x 330.2 x 165.4 mm
