wrightsh/Michigan-Linear-Book-Scanner/CAD/Linear Book Scanner/Electronics Slide/SLIDE MOUNT OUTFEED, ELECTRONICS SLIDE.SLDPRT

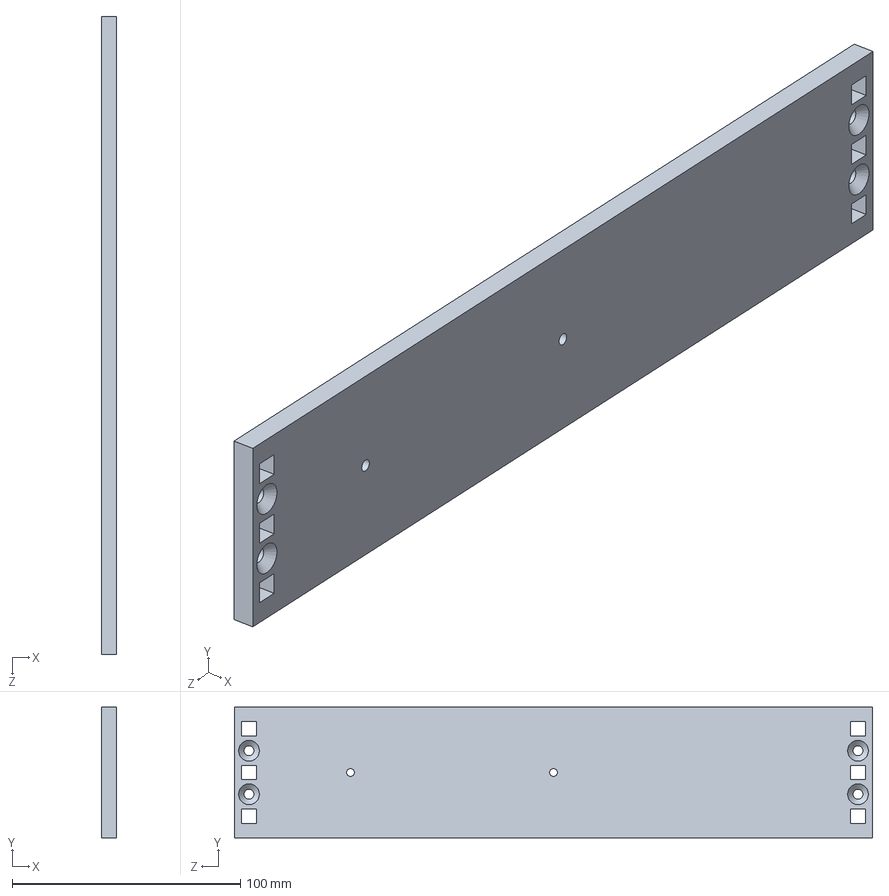
[picture p132: CAD file, 2013-12-16]
CAD/Linear Book Scanner/Electronics Slide/SLIDE MOUNT OUTFEED, ELECTRONICS SLIDE.SLDPRT
6.60 x 57.1 x 279.4 mm
