wrightsh/Michigan-Linear-Book-Scanner/CAD/Linear Book Scanner/Fastener Example/Laser Cut Test/SIDE- Stock.DXF

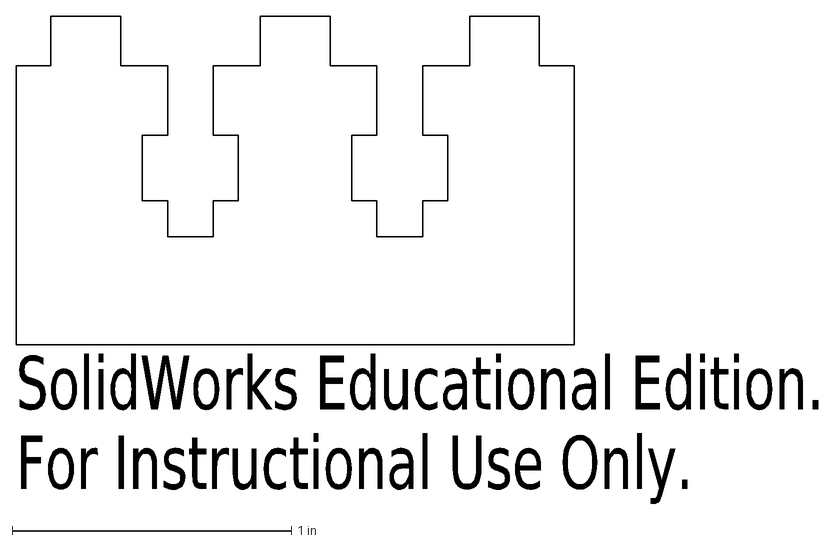
[picture p133: CAD file, 2013-12-16]
CAD/Linear Book Scanner/Fastener Example/Laser Cut Test/SIDE- Stock.DXF
SolidWorks Educational Edition.
For Instructional Use Only.
