wrightsh/Michigan-Linear-Book-Scanner/CAD/Linear Book Scanner/Frame/RIB 4 OUTFEED, FRAME.SLDPRT

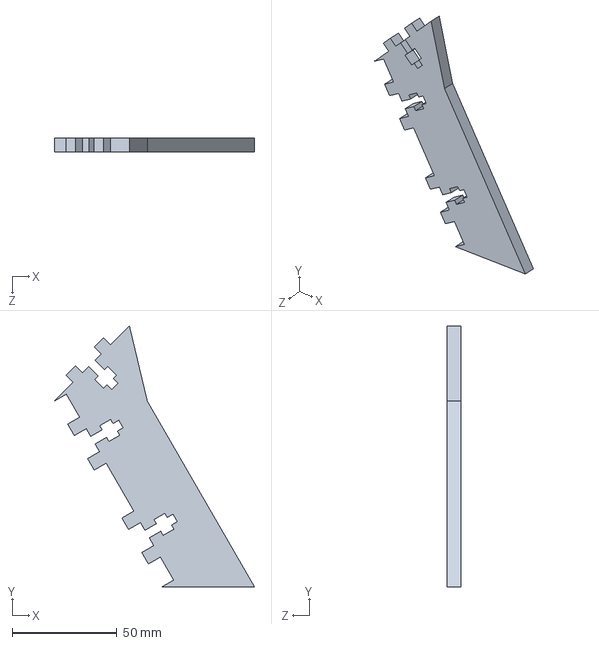
[picture p134: CAD file, 2013-12-16]
CAD/Linear Book Scanner/Frame/RIB 4 OUTFEED, FRAME.SLDPRT
95.8 x 124.8 x 6.60 mm
