wrightsh/Michigan-Linear-Book-Scanner/CAD/Linear Book Scanner/Laser Cut Drawings/Acrylic_5.DXF

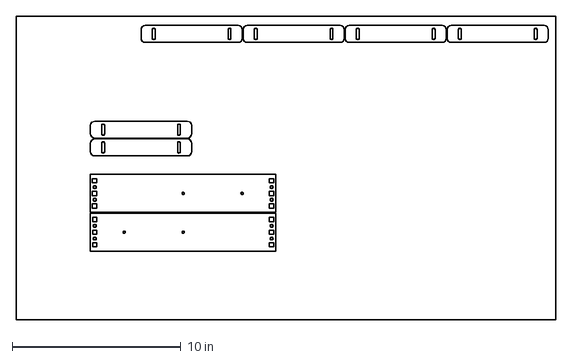
[picture p135: CAD file, 2013-12-16]
CAD/Linear Book Scanner/Laser Cut Drawings/Acrylic_5.DXF
32.0 x 18.0 in
