wrightsh/Michigan-Linear-Book-Scanner/CAD/Linear Book Scanner/Laser Cut Layouts/Acrylic Cut 1/HORN, OUTFEED FRONT.DXF

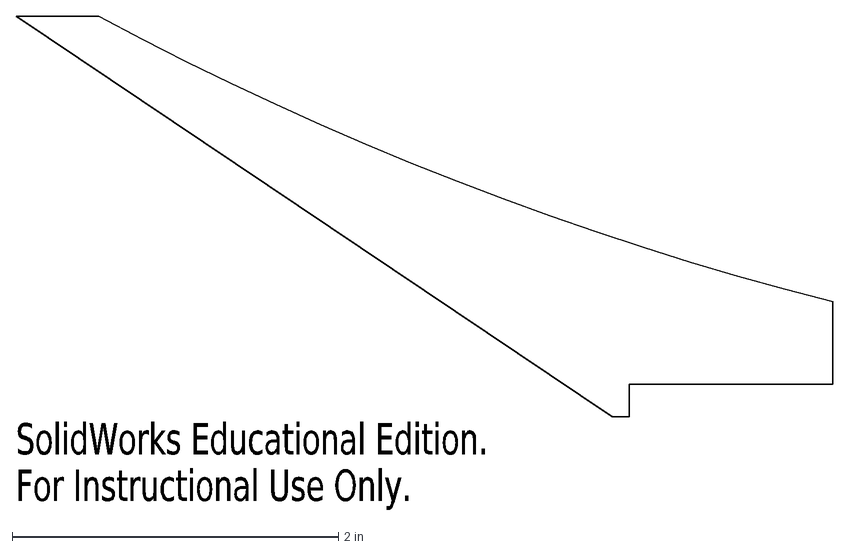
[picture p136: CAD file, 2013-12-16]
CAD/Linear Book Scanner/Laser Cut Layouts/Acrylic Cut 1/HORN, OUTFEED FRONT.DXF
SolidWorks Educational Edition.
For Instructional Use Only.
