wrightsh/Michigan-Linear-Book-Scanner/CAD/Linear Book Scanner/Motor Mount/SIDE, MOTOR MOUNT.SLDPRT

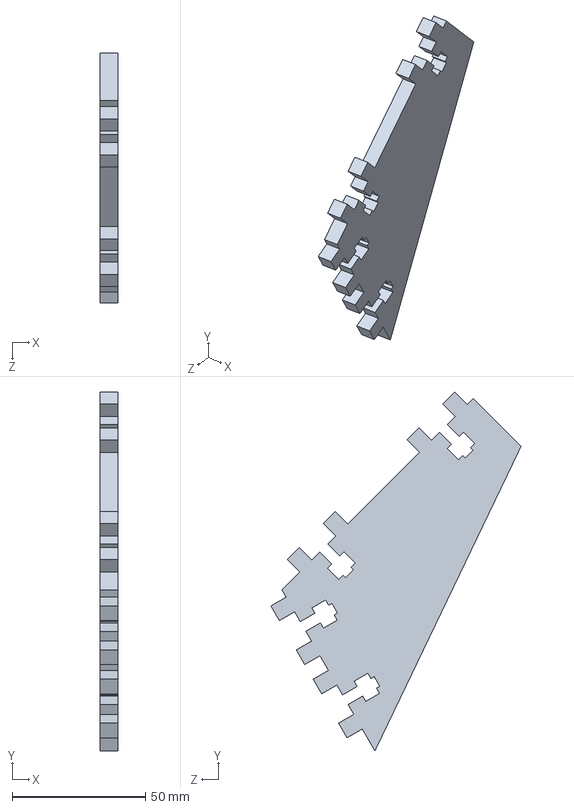
[picture p137: CAD file, 2013-12-16]
CAD/Linear Book Scanner/Motor Mount/SIDE, MOTOR MOUNT.SLDPRT
6.60 x 134.8 x 93.9 mm
