wrightsh/Michigan-Linear-Book-Scanner/CAD/Linear Book Scanner/Pulleys/MOUNT OFFSET, PULLY.SLDPRT

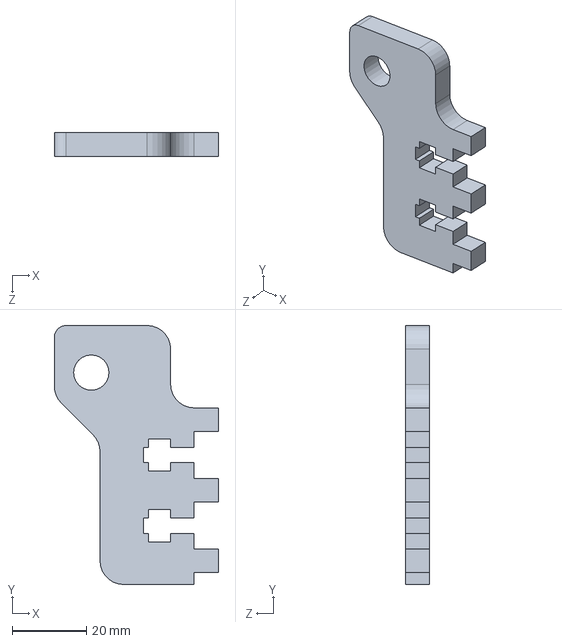
[picture p138: CAD file, 2013-12-16]
CAD/Linear Book Scanner/Pulleys/MOUNT OFFSET, PULLY.SLDPRT
44.3 x 69.8 x 6.60 mm
