wrightsh/Michigan-Linear-Book-Scanner/CAD/Linear Book Scanner/Saddle/LINK, SADDLE.SLDPRT

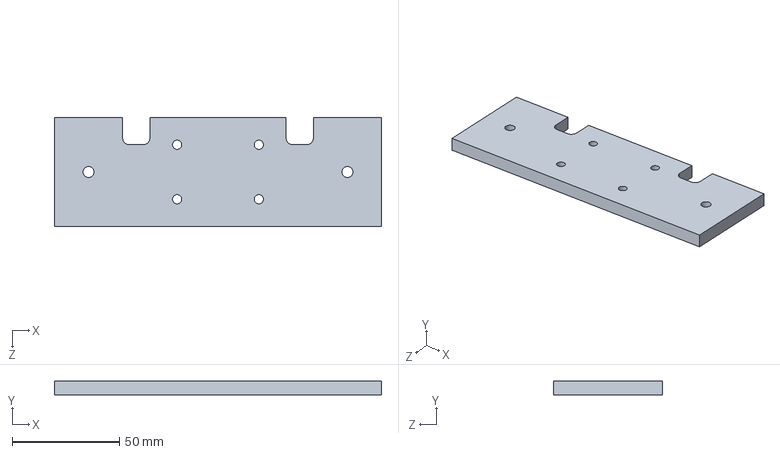
[picture p139: CAD file, 2013-12-16]
CAD/Linear Book Scanner/Saddle/LINK, SADDLE.SLDPRT
152.4 x 6.60 x 50.8 mm
