wrightsh/Michigan-Linear-Book-Scanner/CAD/Linear Book Scanner/Sides/HORN_1, INFEED FRONT.SLDPRT

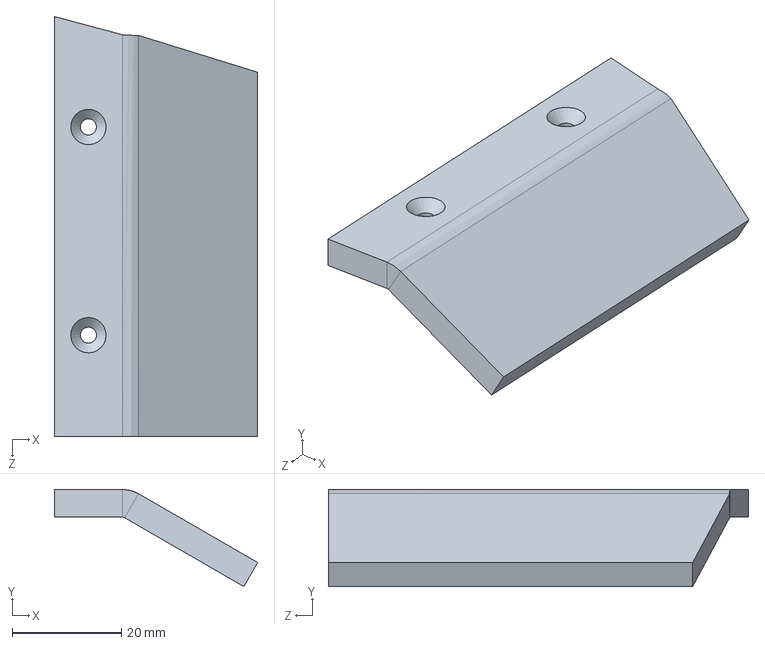
[picture p140: CAD file, 2013-12-16]
CAD/Linear Book Scanner/Sides/HORN_1, INFEED FRONT.SLDPRT
37.2 x 17.8 x 76.9 mm
