wrightsh/Michigan-Linear-Book-Scanner/CAD/Linear Book Scanner/Base.SLDPRT

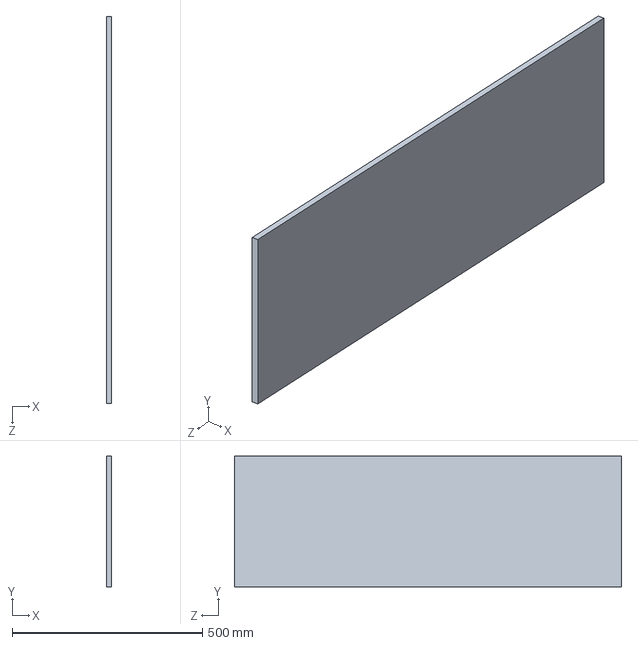
[picture p141: CAD file, 2013-12-16]
CAD/Linear Book Scanner/Base.SLDPRT
12.7 x 343.2 x 1016.0 mm
