wrightsh/Michigan-Linear-Book-Scanner/CAD/Linear Book Scanner/Base/SPACER RIB 3, BASE.SLDPRT

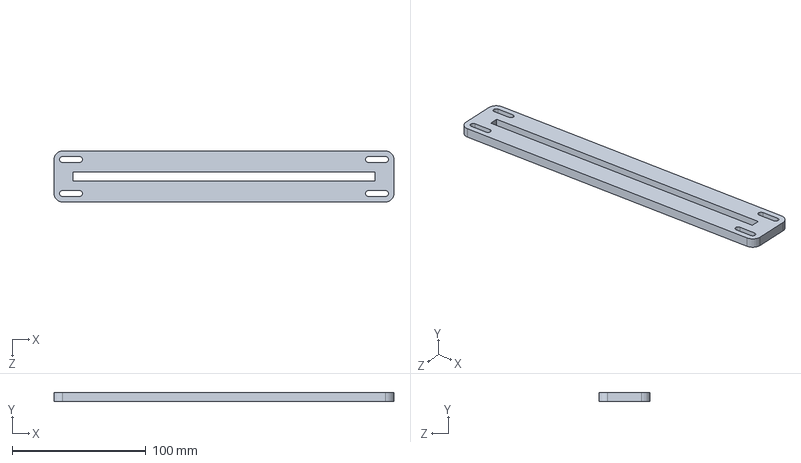
[picture p142: CAD file, 2013-12-16]
CAD/Linear Book Scanner/Base/SPACER RIB 3, BASE.SLDPRT
254.0 x 6.60 x 38.1 mm
