wrightsh/Michigan-Linear-Book-Scanner/CAD/Linear Book Scanner/Electronics Slide/RPI.SLDPRT

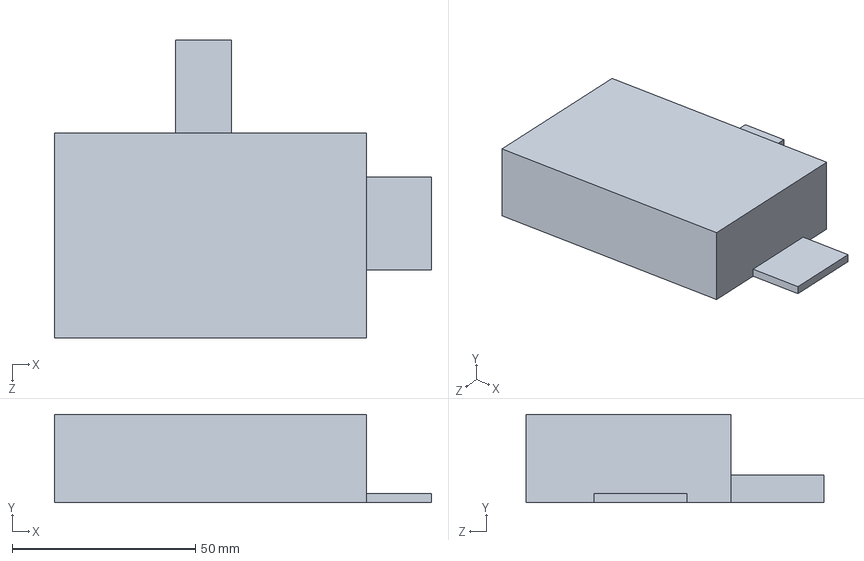
[picture p144: CAD file, 2013-12-16]
CAD/Linear Book Scanner/Electronics Slide/RPI.SLDPRT
102.9 x 24.1 x 81.3 mm
