wrightsh/Michigan-Linear-Book-Scanner/CAD/Linear Book Scanner/Fastener Example/Laser Cut Test/SIDE- 0,010.DXF

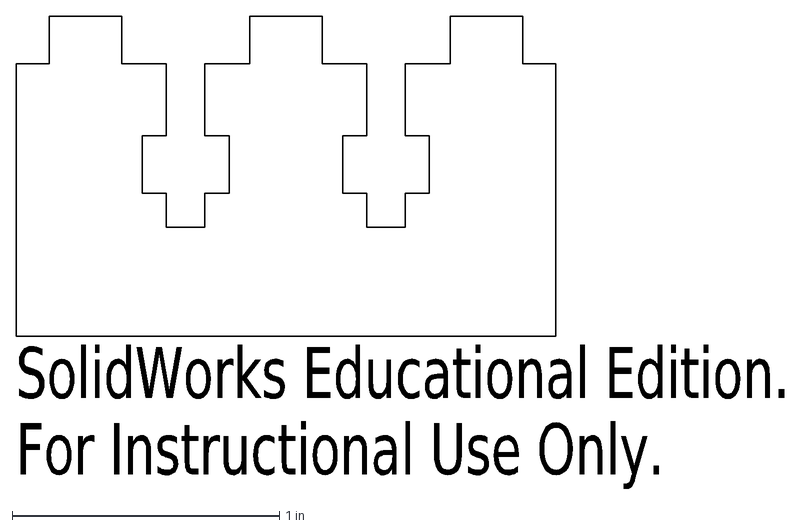
[picture p145: CAD file, 2013-12-16]
CAD/Linear Book Scanner/Fastener Example/Laser Cut Test/SIDE- 0,010.DXF
SolidWorks Educational Edition.
For Instructional Use Only.
