wrightsh/Michigan-Linear-Book-Scanner/CAD/Linear Book Scanner/Frame/RIB 4, FRAME.SLDPRT

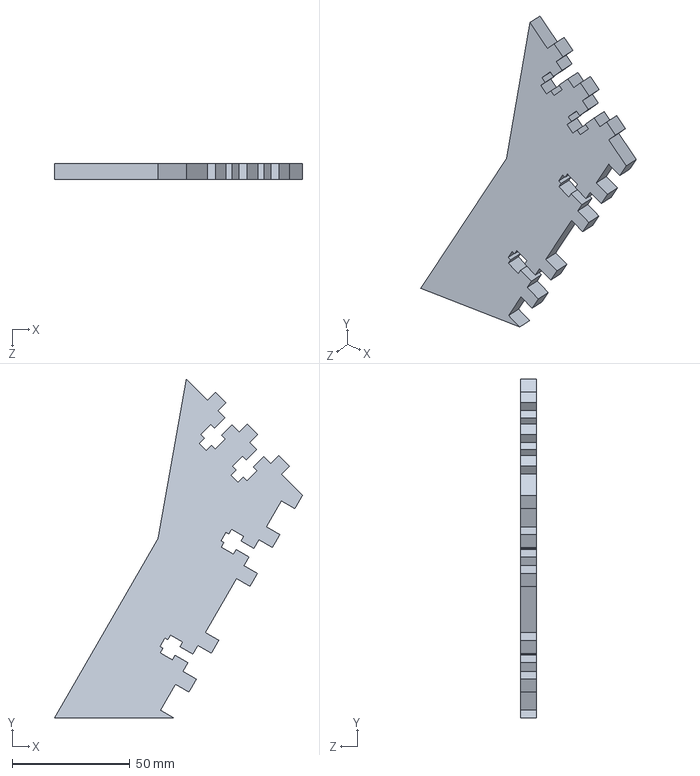
[picture p146: CAD file, 2013-12-16]
CAD/Linear Book Scanner/Frame/RIB 4, FRAME.SLDPRT
105.4 x 144.0 x 6.60 mm
