wrightsh/Michigan-Linear-Book-Scanner/CAD/Linear Book Scanner/Laser Cut Drawings/HORN_2, OUTFEED FRONT.DXF

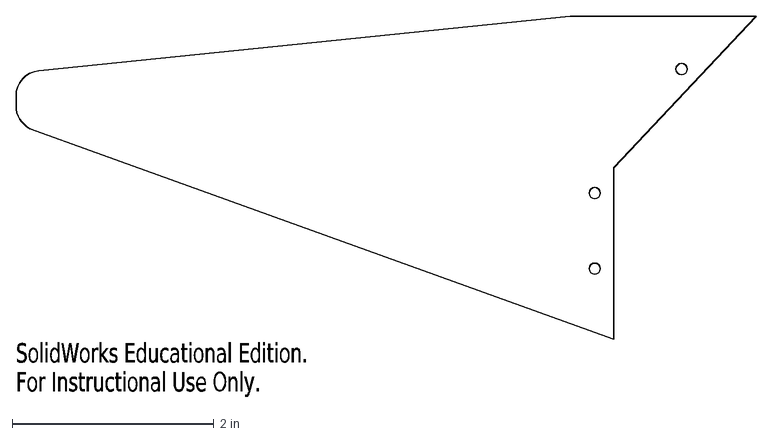
[picture p147: CAD file, 2013-12-16]
CAD/Linear Book Scanner/Laser Cut Drawings/HORN_2, OUTFEED FRONT.DXF
SolidWorks Educational Edition.
For Instructional Use Only.
