wrightsh/Michigan-Linear-Book-Scanner/CAD/Linear Book Scanner/Saddle/SIDE PADDLE, SADDLE.SLDPRT

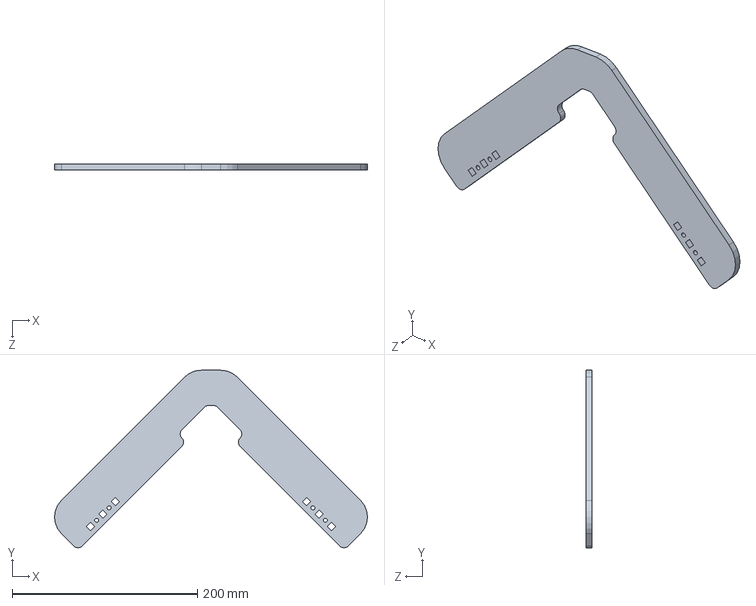
[picture p148: CAD file, 2013-12-16]
CAD/Linear Book Scanner/Saddle/SIDE PADDLE, SADDLE.SLDPRT
338.2 x 191.9 x 6.60 mm
