wrightsh/Michigan-Linear-Book-Scanner/CAD/Linear Book Scanner/Base/PLYWOOD, BASE.SLDPRT

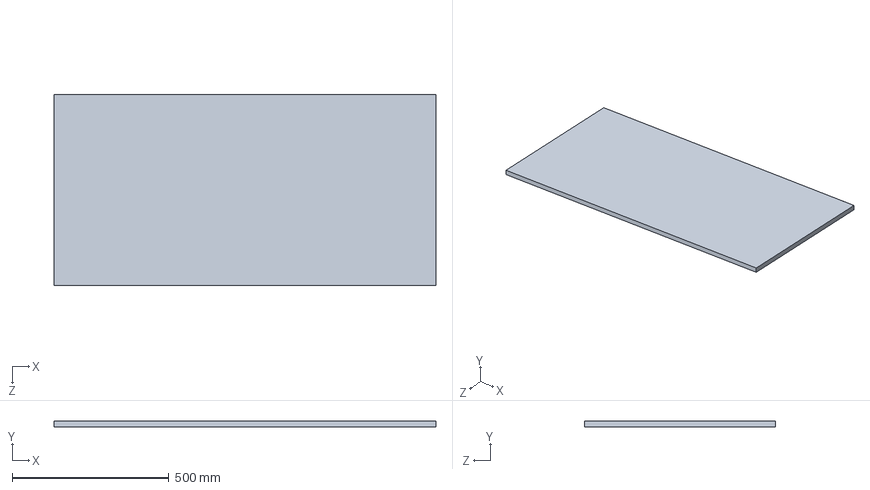
[picture p149: CAD file, 2013-12-16]
CAD/Linear Book Scanner/Base/PLYWOOD, BASE.SLDPRT
1219.2 x 19.1 x 609.6 mm
