wrightsh/Michigan-Linear-Book-Scanner/CAD/Linear Book Scanner/Frame/RIB 6, FRAME.SLDPRT

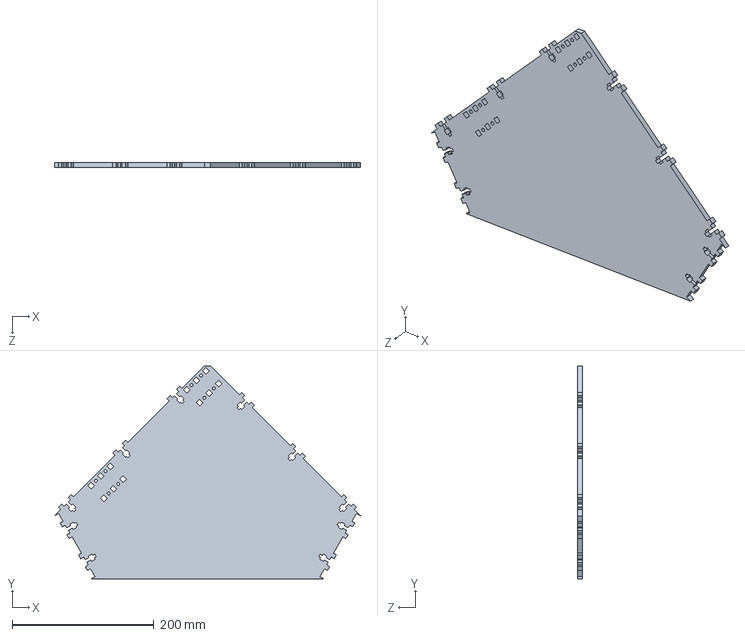
[picture p152: CAD file, 2013-12-16]
CAD/Linear Book Scanner/Frame/RIB 6, FRAME.SLDPRT
431.1 x 299.9 x 6.60 mm
