wrightsh/Michigan-Linear-Book-Scanner/CAD/Linear Book Scanner/Laser Cut Drawings/Acrylic_4_2b.dxf

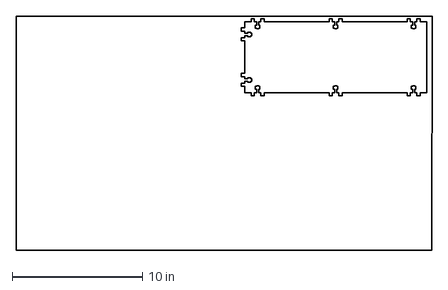
[picture p153: CAD file, 2013-12-16]
CAD/Linear Book Scanner/Laser Cut Drawings/Acrylic_4_2b.dxf
32.0 x 18.0 in
