wrightsh/Michigan-Linear-Book-Scanner/CAD/Linear Book Scanner/Motor Mount/FACE, MOTOR MOUNT.SLDPRT

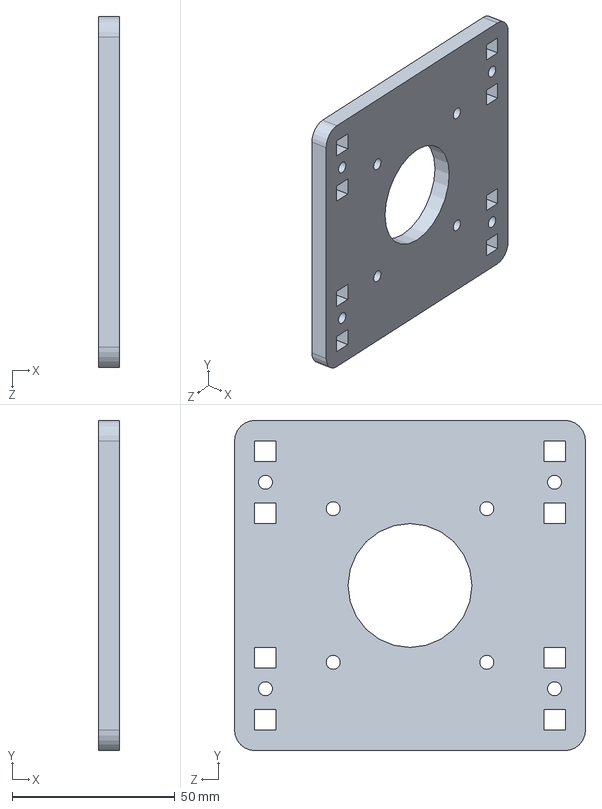
[picture p154: CAD file, 2013-12-16]
CAD/Linear Book Scanner/Motor Mount/FACE, MOTOR MOUNT.SLDPRT
6.60 x 101.6 x 108.0 mm
