wrightsh/Michigan-Linear-Book-Scanner/CAD/Linear Book Scanner/Pulleys/MOUNT, PULLY.SLDPRT

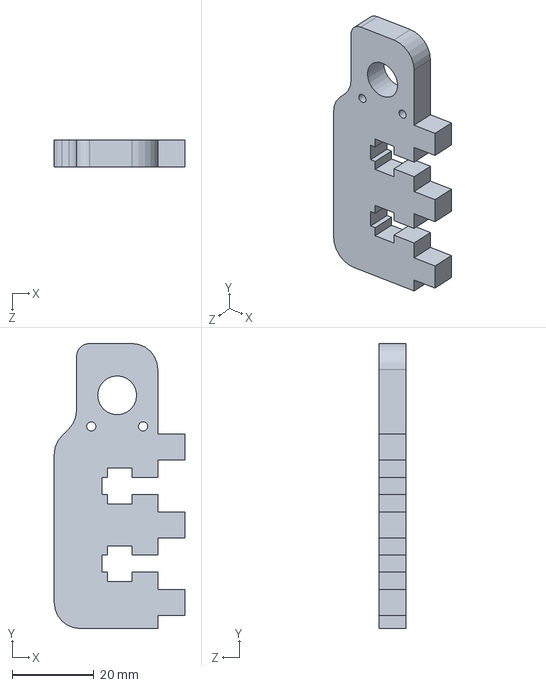
[picture p155: CAD file, 2013-12-16]
CAD/Linear Book Scanner/Pulleys/MOUNT, PULLY.SLDPRT
32.0 x 69.8 x 6.60 mm
