wrightsh/Michigan-Linear-Book-Scanner/CAD/Linear Book Scanner/Scanner Bars/GLASS COVER, SCANNER BAR.SLDPRT

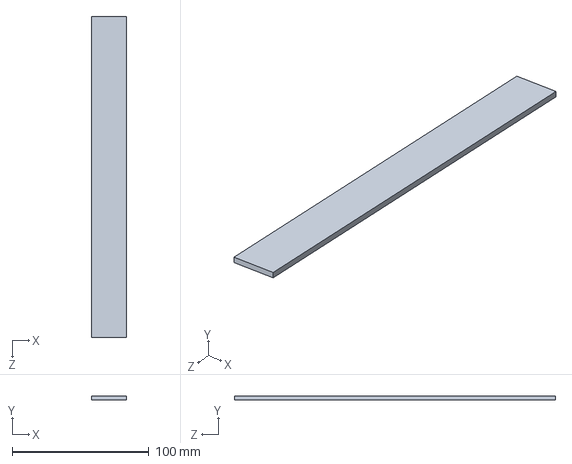
[picture p156: CAD file, 2013-12-16]
CAD/Linear Book Scanner/Scanner Bars/GLASS COVER, SCANNER BAR.SLDPRT
25.4 x 3.17 x 235.0 mm
