wrightsh/Michigan-Linear-Book-Scanner/CAD/Linear Book Scanner/Sides/INFEED FRONT, SIDE.SLDPRT

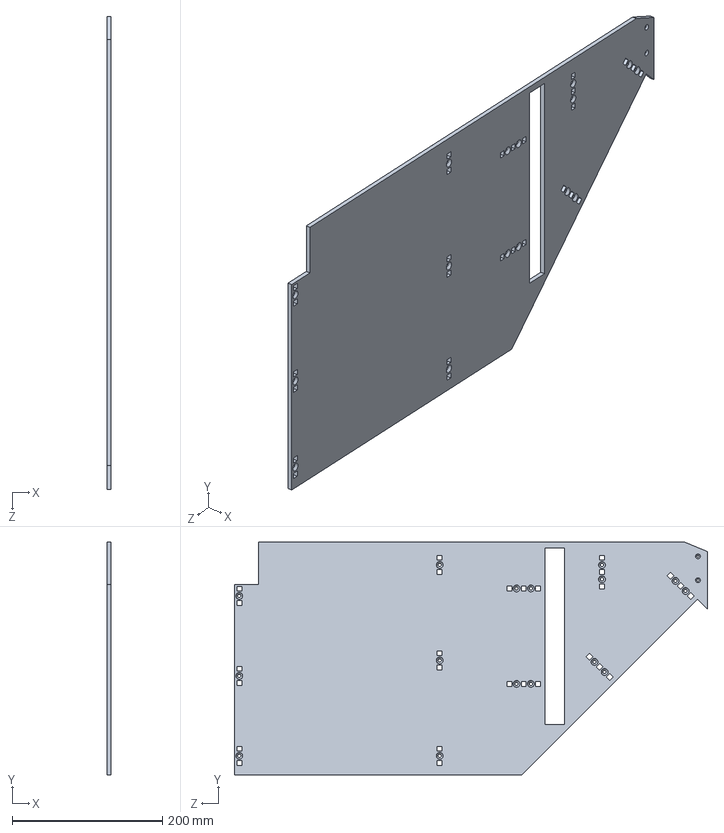
[picture p157: CAD file, 2013-12-16]
CAD/Linear Book Scanner/Sides/INFEED FRONT, SIDE.SLDPRT
5.08 x 309.9 x 629.3 mm
