wrightsh/Michigan-Linear-Book-Scanner/CAD/Linear Book Scanner/Vacuum Tube/BRACKET, VACUUM TUBE.SLDPRT

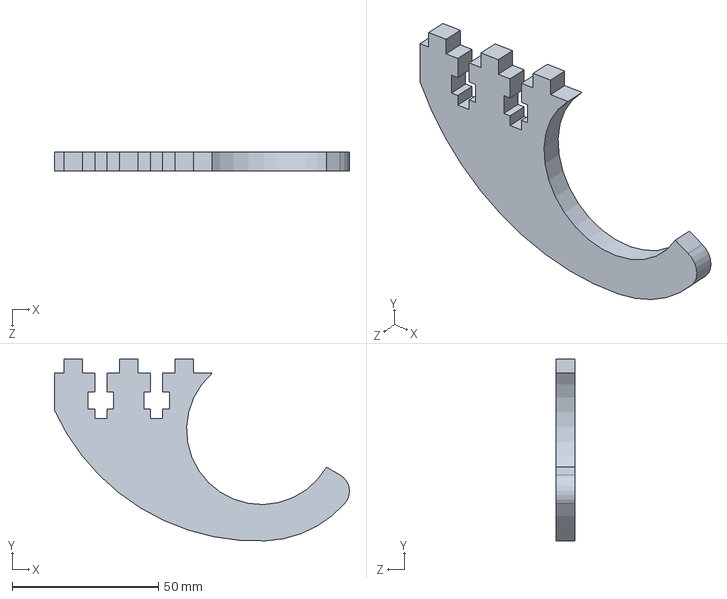
[picture p158: CAD file, 2013-12-16]
CAD/Linear Book Scanner/Vacuum Tube/BRACKET, VACUUM TUBE.SLDPRT
101.0 x 62.2 x 6.60 mm
