wrightsh/Michigan-Linear-Book-Scanner/CAD/Linear Book Scanner/Electronics Slide/power supply.SLDPRT

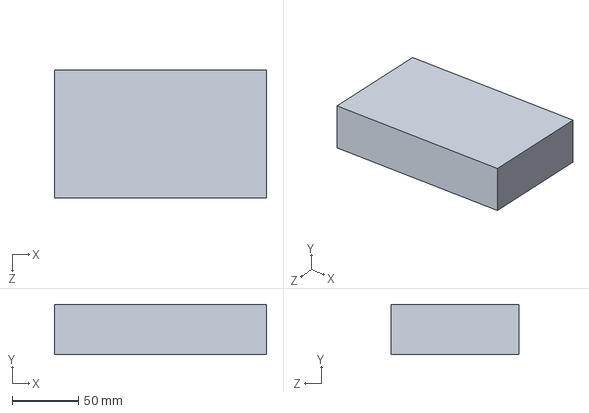
[picture p159: CAD file, 2013-12-16]
CAD/Linear Book Scanner/Electronics Slide/power supply.SLDPRT
160.0 x 38.1 x 96.5 mm
