wrightsh/Michigan-Linear-Book-Scanner/CAD/Linear Book Scanner/Electronics Slide/raspberry-pi-b-1/raspberry_pi__SD_reader_pin4.SLDPRT

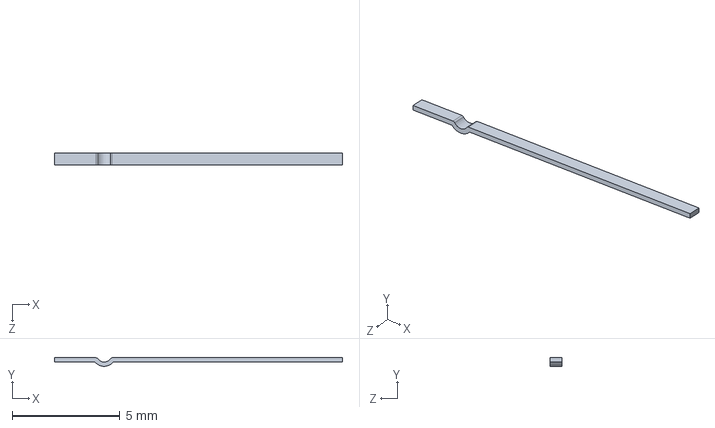
[picture p160: CAD file, 2013-12-16]
CAD/Linear Book Scanner/Electronics Slide/raspberry-pi-b-1/raspberry_pi__SD_reader_pin4.SLDPRT
13.3 x 0.396 x 0.55 mm
