wrightsh/Michigan-Linear-Book-Scanner/CAD/Linear Book Scanner/Fastener Example/Laser Cut Test/FACE - 0,005.DXF

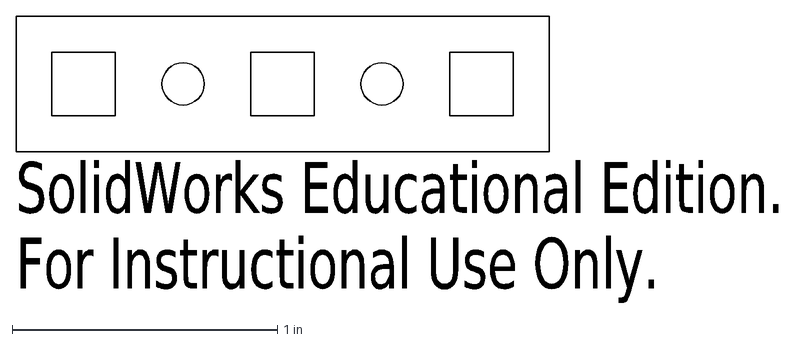
[picture p161: CAD file, 2013-12-16]
CAD/Linear Book Scanner/Fastener Example/Laser Cut Test/FACE - 0,005.DXF
SolidWorks Educational Edition.
For Instructional Use Only.
