wrightsh/Michigan-Linear-Book-Scanner/CAD/Linear Book Scanner/Frame/RIB 3, FRAME.SLDPRT

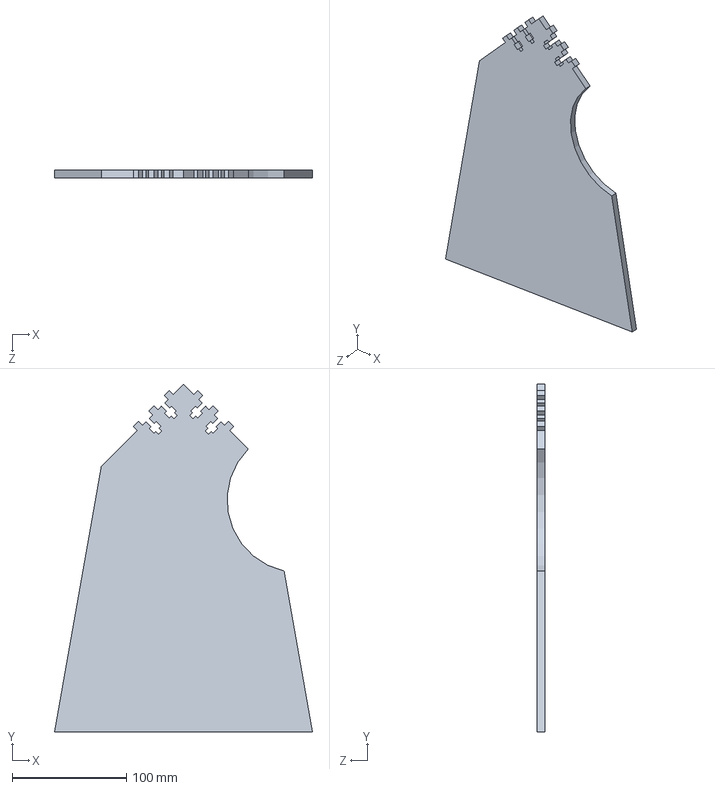
[picture p162: CAD file, 2013-12-16]
CAD/Linear Book Scanner/Frame/RIB 3, FRAME.SLDPRT
225.8 x 304.5 x 6.60 mm
