wrightsh/Michigan-Linear-Book-Scanner/CAD/Linear Book Scanner/Pulleys/SHAFT, PULLY.SLDPRT

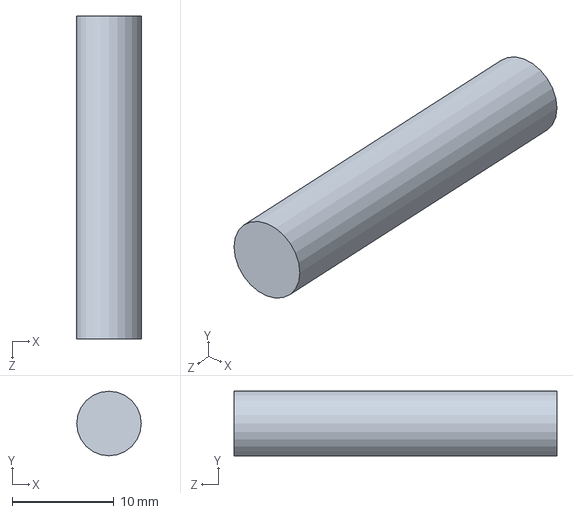
[picture p163: CAD file, 2013-12-16]
CAD/Linear Book Scanner/Pulleys/SHAFT, PULLY.SLDPRT
6.35 x 6.35 x 31.8 mm
