wrightsh/Michigan-Linear-Book-Scanner/CAD/Linear Book Scanner/Scanner Bars/Canon 220 Scanner Bar.SLDPRT

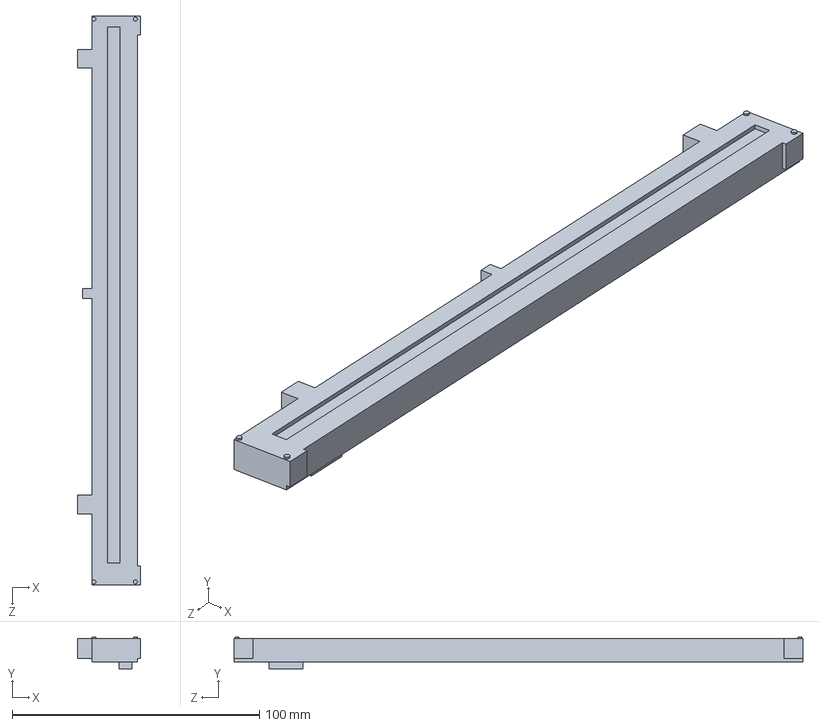
[picture p164: CAD file, 2013-12-16]
CAD/Linear Book Scanner/Scanner Bars/Canon 220 Scanner Bar.SLDPRT
25.5 x 12.8 x 230.2 mm
