wrightsh/Michigan-Linear-Book-Scanner/CAD/Linear Book Scanner/Sides/OUTFEED FRONT, SIDE.SLDPRT

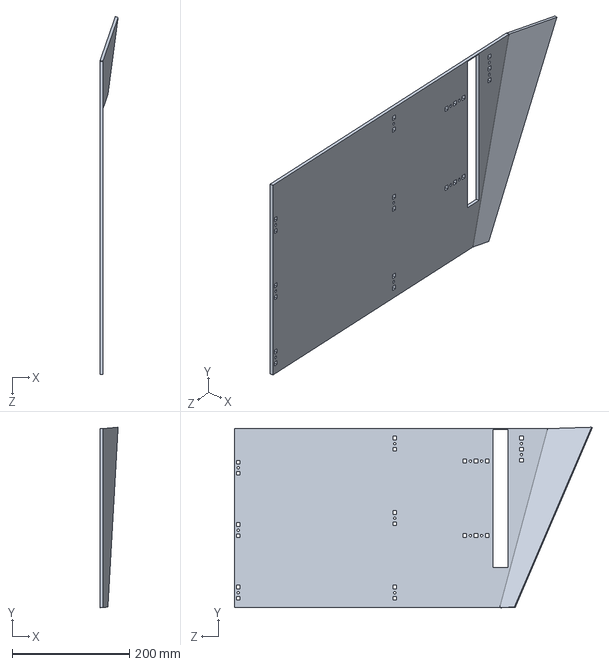
[picture p165: CAD file, 2013-12-16]
CAD/Linear Book Scanner/Sides/OUTFEED FRONT, SIDE.SLDPRT
31.1 x 307.7 x 610.0 mm
