wrightsh/Michigan-Linear-Book-Scanner/CAD/Linear Book Scanner/Vacuum Tube/INSIDE TUBE CAP, VACUUM TUBE.SLDPRT

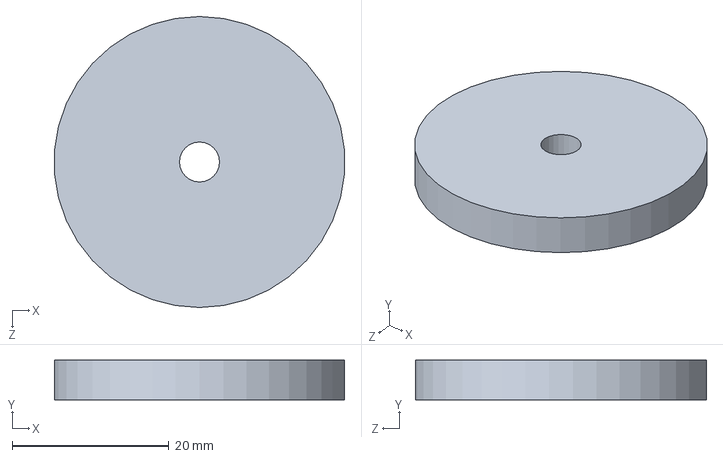
[picture p166: CAD file, 2013-12-16]
CAD/Linear Book Scanner/Vacuum Tube/INSIDE TUBE CAP, VACUUM TUBE.SLDPRT
37.0 x 5.08 x 37.1 mm
