wrightsh/Michigan-Linear-Book-Scanner/CAD/Linear Book Scanner/Electronics Slide/D-Link USB Hub.SLDPRT

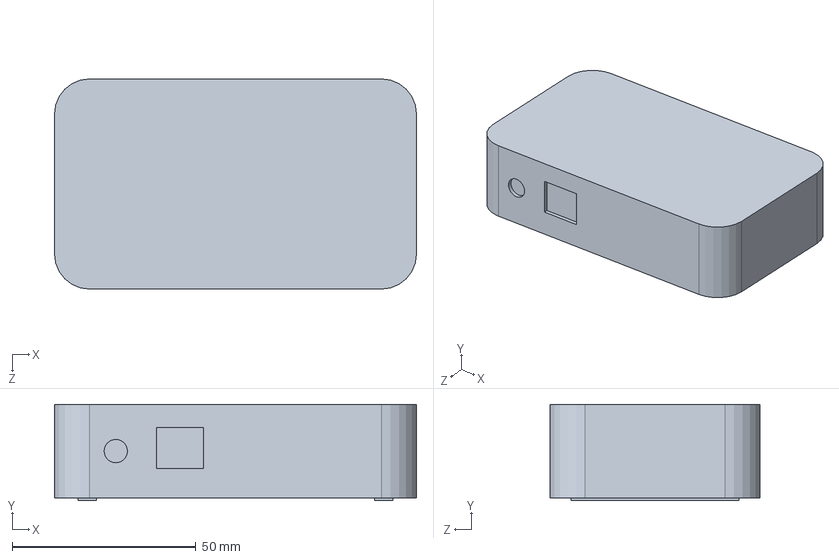
[picture p167: CAD file, 2013-12-16]
CAD/Linear Book Scanner/Electronics Slide/D-Link USB Hub.SLDPRT
98.4 x 26.2 x 57.1 mm
