wrightsh/Michigan-Linear-Book-Scanner/CAD/Linear Book Scanner/Fastener Example/Laser Cut Test/LASER CUT TEST (ALL).dxf

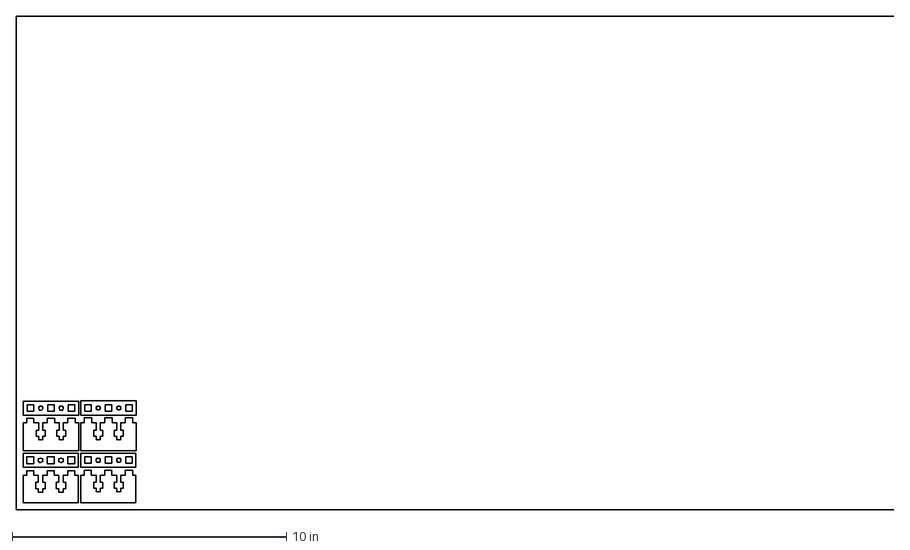
[picture p168: CAD file, 2013-12-16]
CAD/Linear Book Scanner/Fastener Example/Laser Cut Test/LASER CUT TEST (ALL).dxf
32.0 x 18.0 in
