wrightsh/Michigan-Linear-Book-Scanner/CAD/Linear Book Scanner/Laser Cut Drawings/OUTFEED BACK, SIDE.DXF

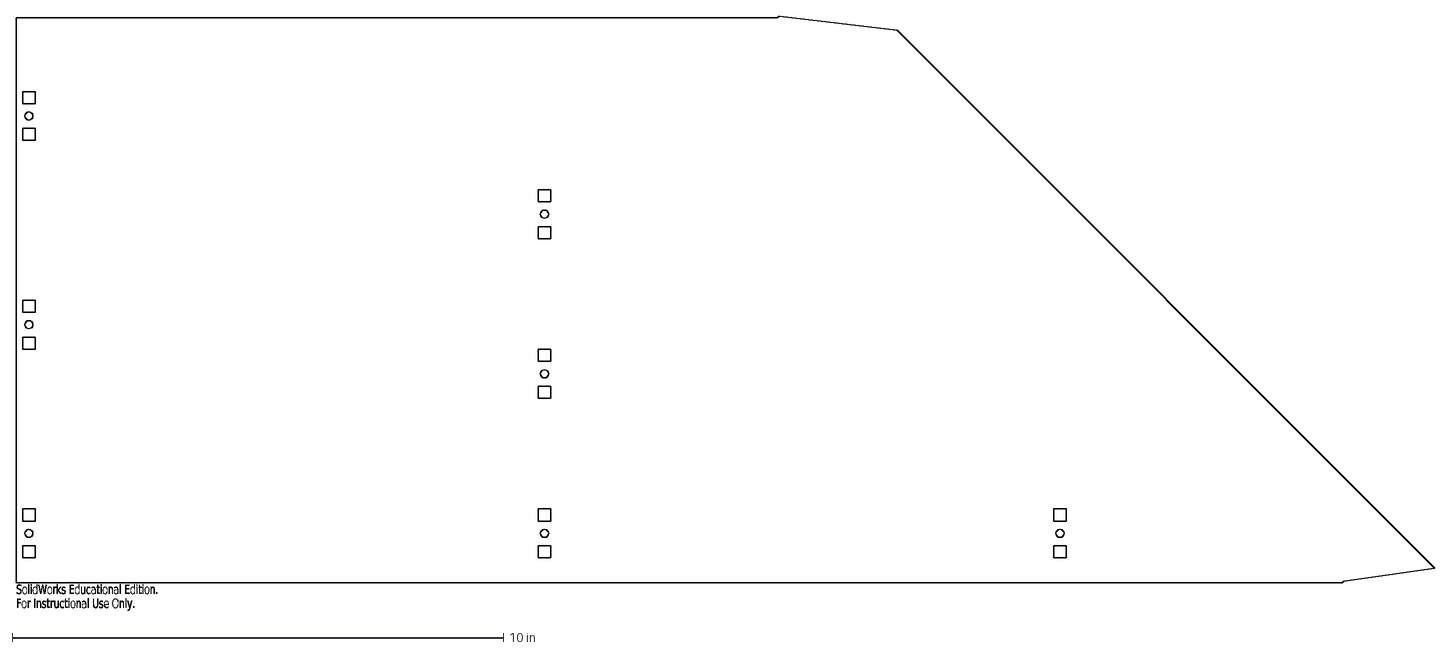
[picture p169: CAD file, 2013-12-16]
CAD/Linear Book Scanner/Laser Cut Drawings/OUTFEED BACK, SIDE.DXF
SolidWorks Educational Edition.
For Instructional Use Only.
