wrightsh/Michigan-Linear-Book-Scanner/CAD/Linear Book Scanner/Saddle/BELT MOUNT LOWER, SADDLE.SLDPRT

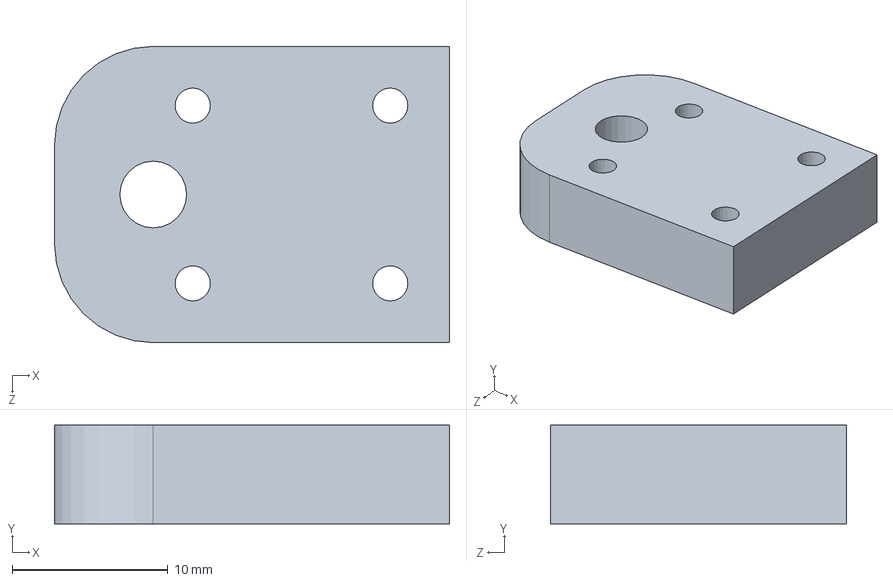
[picture p170: CAD file, 2013-12-16]
CAD/Linear Book Scanner/Saddle/BELT MOUNT LOWER, SADDLE.SLDPRT
25.4 x 6.35 x 19.1 mm
