wrightsh/Michigan-Linear-Book-Scanner/CAD/Linear Book Scanner/Vacuum Tube/OUTSIDE TUBE CAP, VACUUM TUBE.SLDPRT

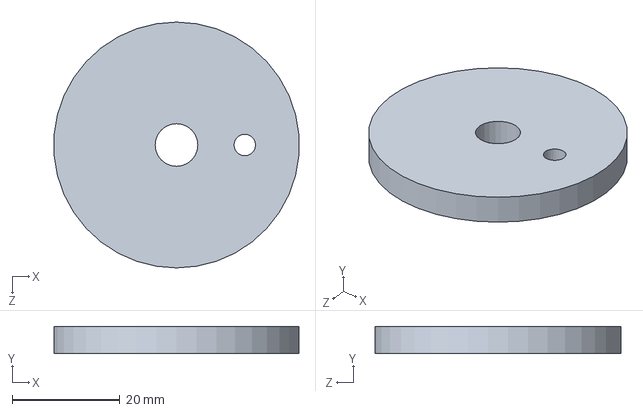
[picture p171: CAD file, 2013-12-16]
CAD/Linear Book Scanner/Vacuum Tube/OUTSIDE TUBE CAP, VACUUM TUBE.SLDPRT
45.6 x 5.08 x 45.7 mm
