wrightsh/Michigan-Linear-Book-Scanner/CAD/Linear Book Scanner/Electronics Slide/SIDE, ELECTRONICS SLIDE.SLDPRT

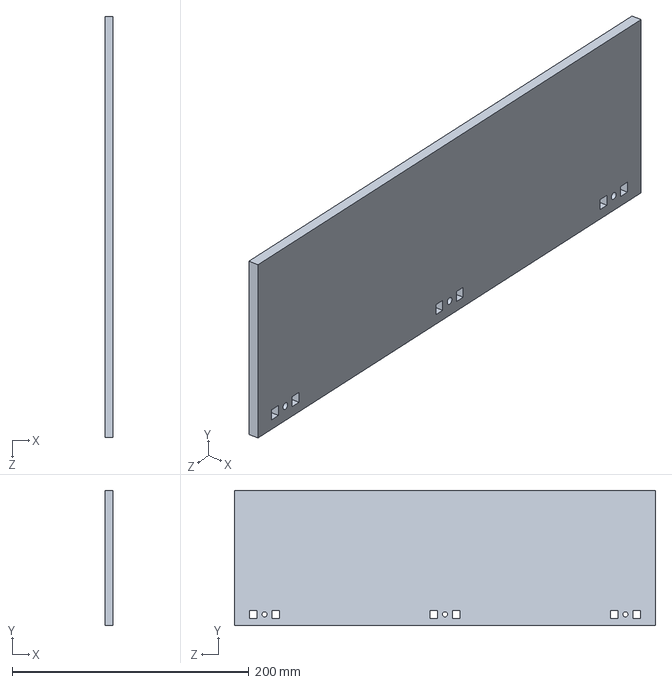
[picture p173: CAD file, 2013-12-16]
CAD/Linear Book Scanner/Electronics Slide/SIDE, ELECTRONICS SLIDE.SLDPRT
6.60 x 114.3 x 355.6 mm
