wrightsh/Michigan-Linear-Book-Scanner/CAD/Linear Book Scanner/Fastener Example/Laser Cut Test/SIDE- 0,005.DXF

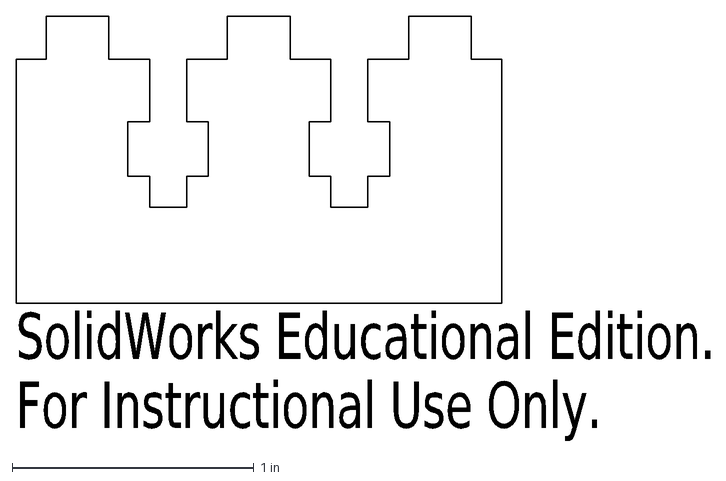
[picture p174: CAD file, 2013-12-16]
CAD/Linear Book Scanner/Fastener Example/Laser Cut Test/SIDE- 0,005.DXF
SolidWorks Educational Edition.
For Instructional Use Only.
