wrightsh/Michigan-Linear-Book-Scanner/CAD/Linear Book Scanner/Frame/LOWER OUTFEED BACK RIB, FRAME.SLDPRT

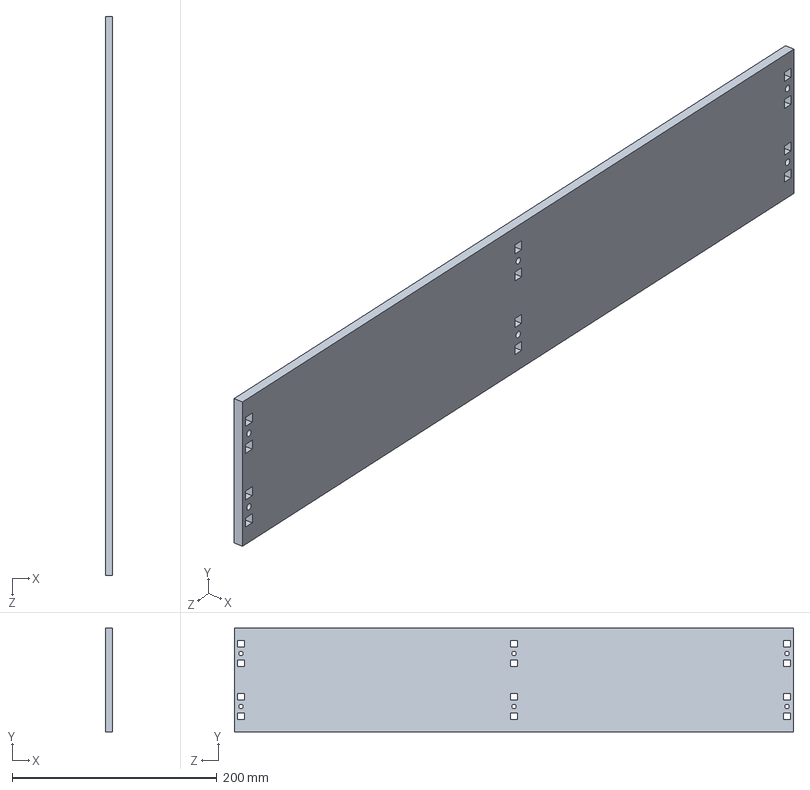
[picture p175: CAD file, 2013-12-16]
CAD/Linear Book Scanner/Frame/LOWER OUTFEED BACK RIB, FRAME.SLDPRT
6.60 x 101.6 x 546.1 mm
