wrightsh/Michigan-Linear-Book-Scanner/CAD/Linear Book Scanner/Laser Cut Drawings/SPACER RIB 3, BASE.DXF

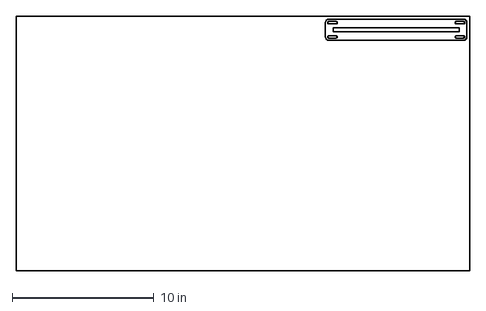
[picture p176: CAD file, 2013-12-16]
CAD/Linear Book Scanner/Laser Cut Drawings/SPACER RIB 3, BASE.DXF
32.0 x 18.0 in
