wrightsh/Michigan-Linear-Book-Scanner/CAD/Linear Book Scanner/Saddle/BELT MOUNT UPPER, SADDLE.SLDPRT

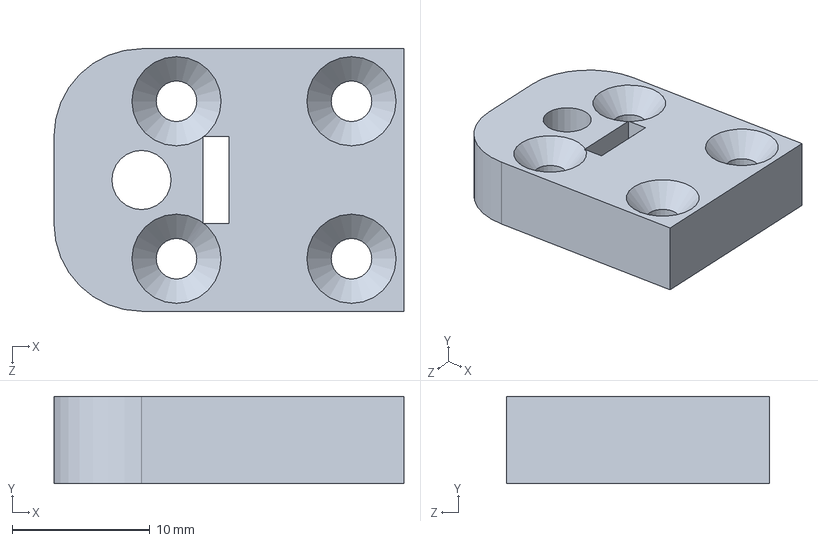
[picture p177: CAD file, 2013-12-16]
CAD/Linear Book Scanner/Saddle/BELT MOUNT UPPER, SADDLE.SLDPRT
25.4 x 6.35 x 19.1 mm
