wrightsh/Michigan-Linear-Book-Scanner/CAD/Linear Book Scanner/Sides/HORN MOUNT, OUTFEED FRONT.SLDPRT

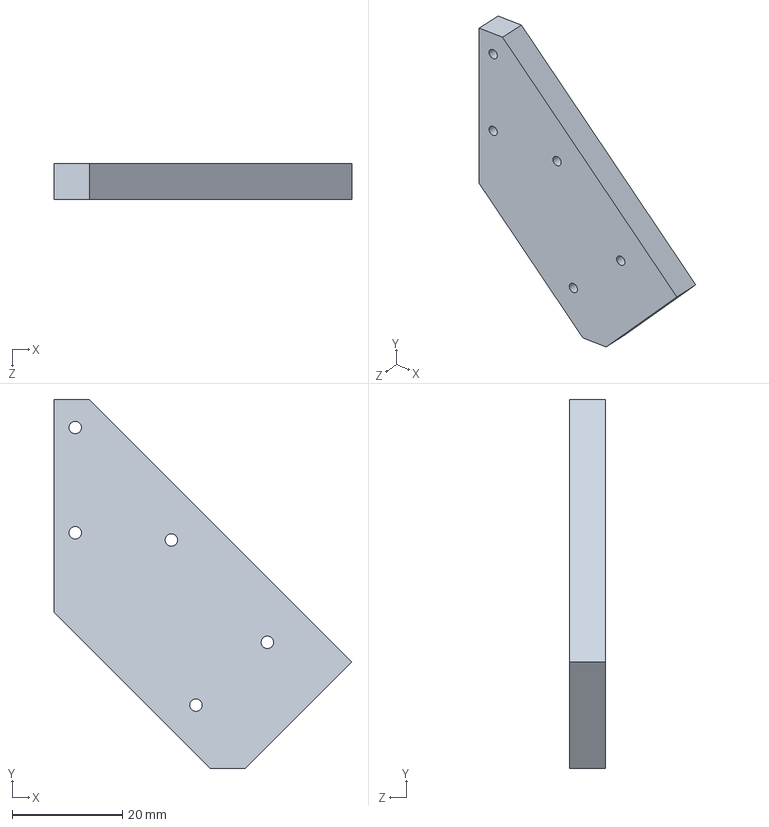
[picture p178: CAD file, 2013-12-16]
CAD/Linear Book Scanner/Sides/HORN MOUNT, OUTFEED FRONT.SLDPRT
53.9 x 66.8 x 6.60 mm
