wrightsh/Michigan-Linear-Book-Scanner/CAD/Linear Book Scanner/Vacuum Tube/INSIDE TUBE, VACUUM TUBE.SLDPRT

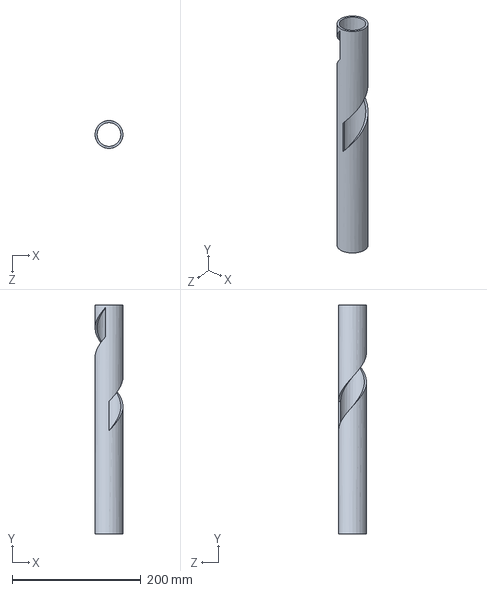
[picture p179: CAD file, 2013-12-16]
CAD/Linear Book Scanner/Vacuum Tube/INSIDE TUBE, VACUUM TUBE.SLDPRT
43.4 x 355.6 x 43.4 mm
