wrightsh/Michigan-Linear-Book-Scanner/CAD/Linear Book Scanner/Electronics Slide/FRONT, ELECTRONICS SLIDE.SLDPRT

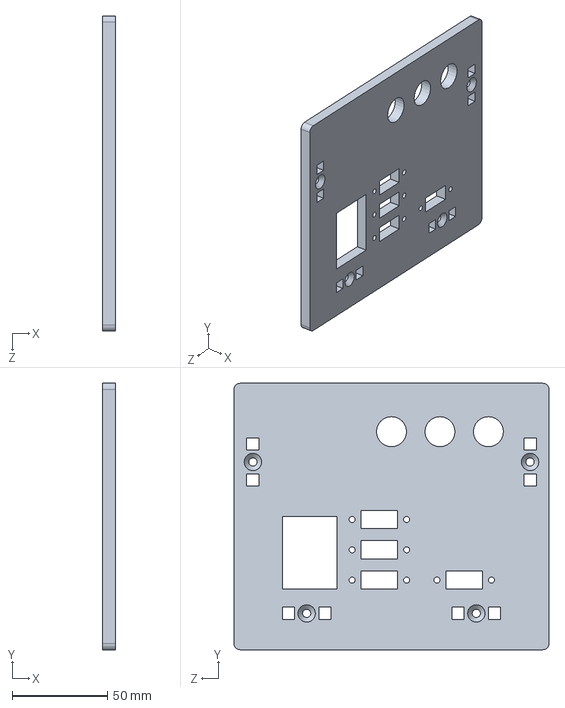
[picture p180: CAD file, 2013-12-16]
CAD/Linear Book Scanner/Electronics Slide/FRONT, ELECTRONICS SLIDE.SLDPRT
6.60 x 139.7 x 165.1 mm
