wrightsh/Michigan-Linear-Book-Scanner/CAD/Linear Book Scanner/Electronics Slide/raspberry-pi-b-1/raspberry_pi__SOD-123_DiodesInc.SLDPRT

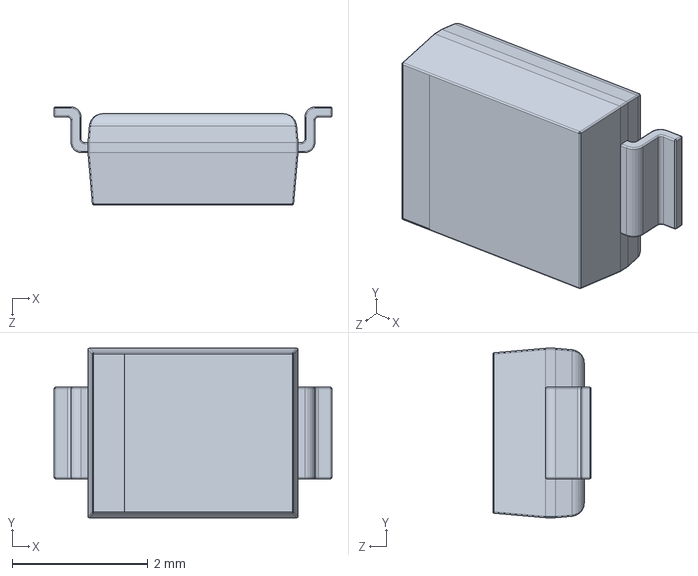
[picture p181: CAD file, 2013-12-16]
CAD/Linear Book Scanner/Electronics Slide/raspberry-pi-b-1/raspberry_pi__SOD-123_DiodesInc.SLDPRT
4.10 x 2.50 x 1.45 mm
