wrightsh/Michigan-Linear-Book-Scanner/CAD/Linear Book Scanner/Fastener Example/Laser Cut Test/FACE - Stock.DXF

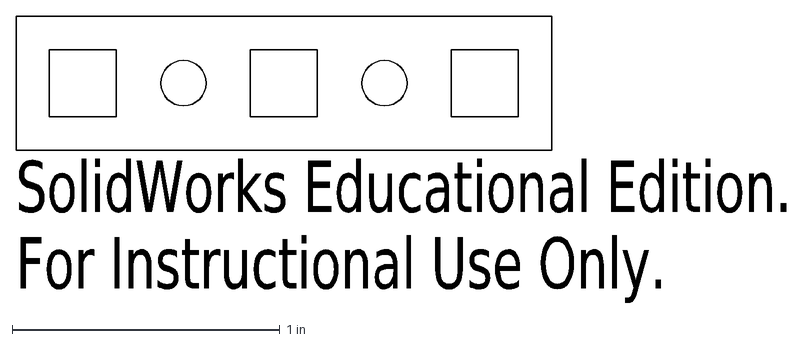
[picture p182: CAD file, 2013-12-16]
CAD/Linear Book Scanner/Fastener Example/Laser Cut Test/FACE - Stock.DXF
SolidWorks Educational Edition.
For Instructional Use Only.
