wrightsh/Michigan-Linear-Book-Scanner/CAD/Linear Book Scanner/Frame/LOWER INFEED FRONT RIB, FRAME.SLDPRT

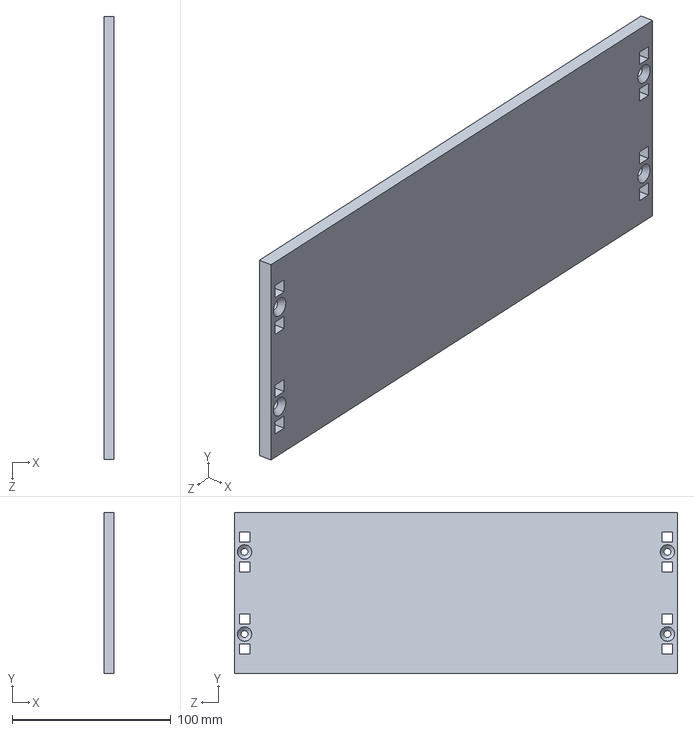
[picture p183: CAD file, 2013-12-16]
CAD/Linear Book Scanner/Frame/LOWER INFEED FRONT RIB, FRAME.SLDPRT
6.60 x 101.6 x 279.4 mm
