wrightsh/Michigan-Linear-Book-Scanner/CAD/Linear Book Scanner/Saddle/LOWER PADDLE SLIDE, SADDLE.SLDPRT

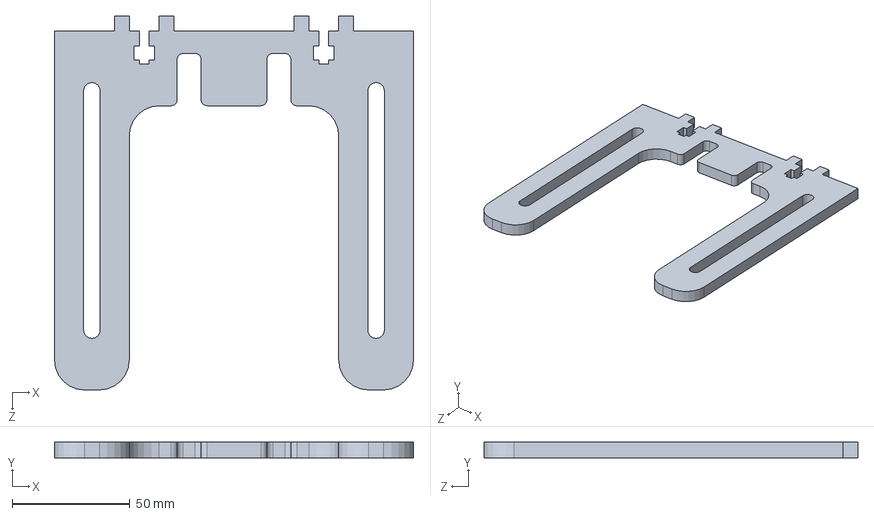
[picture p184: CAD file, 2013-12-16]
CAD/Linear Book Scanner/Saddle/LOWER PADDLE SLIDE, SADDLE.SLDPRT
152.4 x 6.60 x 158.8 mm
