wrightsh/Michigan-Linear-Book-Scanner/CAD/Linear Book Scanner/Sides/HORN MOUNT, INFEED FRONT.SLDPRT

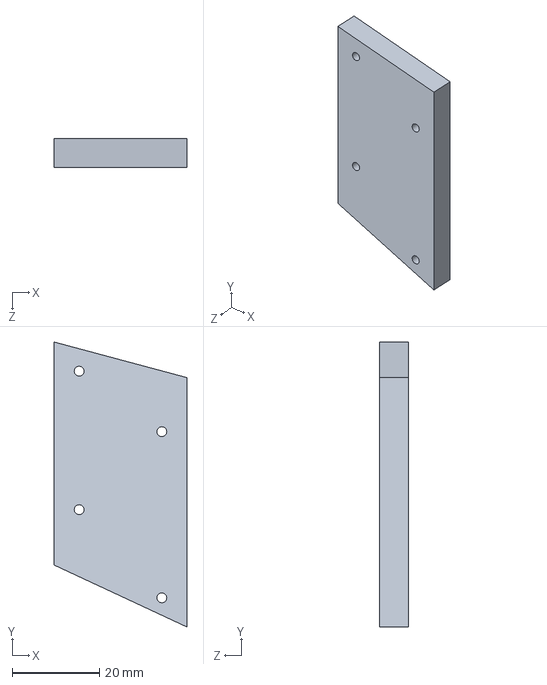
[picture p185: CAD file, 2013-12-16]
CAD/Linear Book Scanner/Sides/HORN MOUNT, INFEED FRONT.SLDPRT
30.5 x 65.3 x 6.60 mm
