wrightsh/Michigan-Linear-Book-Scanner/CAD/Linear Book Scanner/Electronics Slide/raspberry-pi-b-1/raspberry_pi__USB_x2_part1.SLDPRT

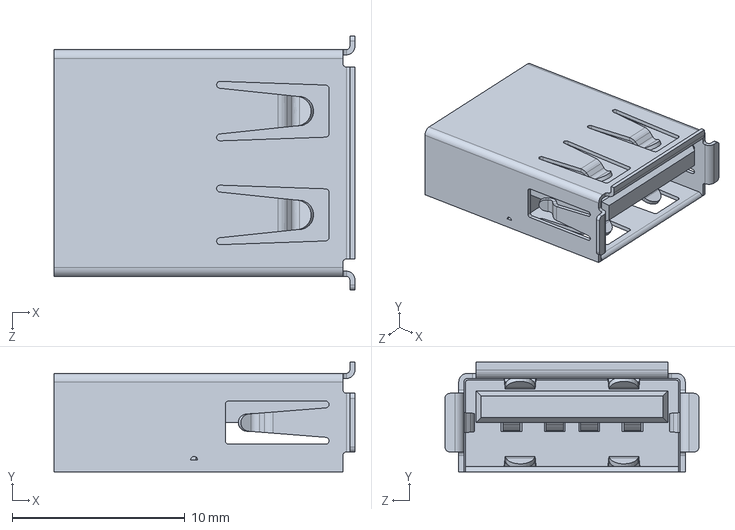
[picture p186: CAD file, 2013-12-16]
CAD/Linear Book Scanner/Electronics Slide/raspberry-pi-b-1/raspberry_pi__USB_x2_part1.SLDPRT
17.4 x 6.35 x 14.7 mm
