wrightsh/Michigan-Linear-Book-Scanner/CAD/Linear Book Scanner/Electronics Slide/STEPPER DRIVER, SAINSMART.SLDPRT

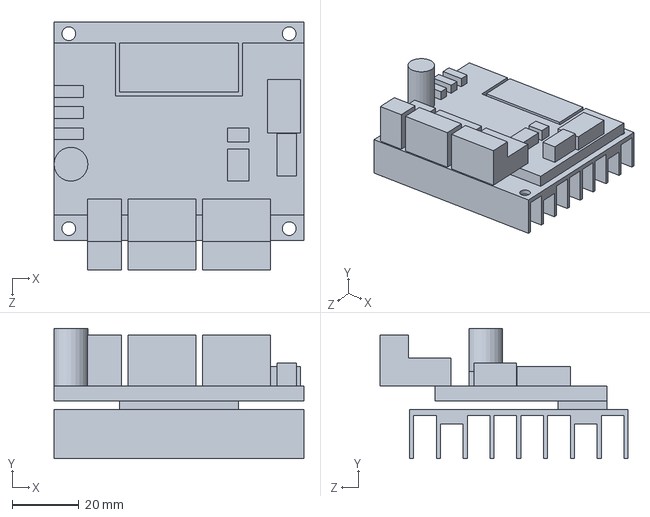
[picture p187: CAD file, 2013-12-16]
CAD/Linear Book Scanner/Electronics Slide/STEPPER DRIVER, SAINSMART.SLDPRT
74.9 x 39.0 x 74.4 mm
