wrightsh/Michigan-Linear-Book-Scanner/CAD/Linear Book Scanner/Frame/RIB 4 INFEED, FRAME.SLDPRT

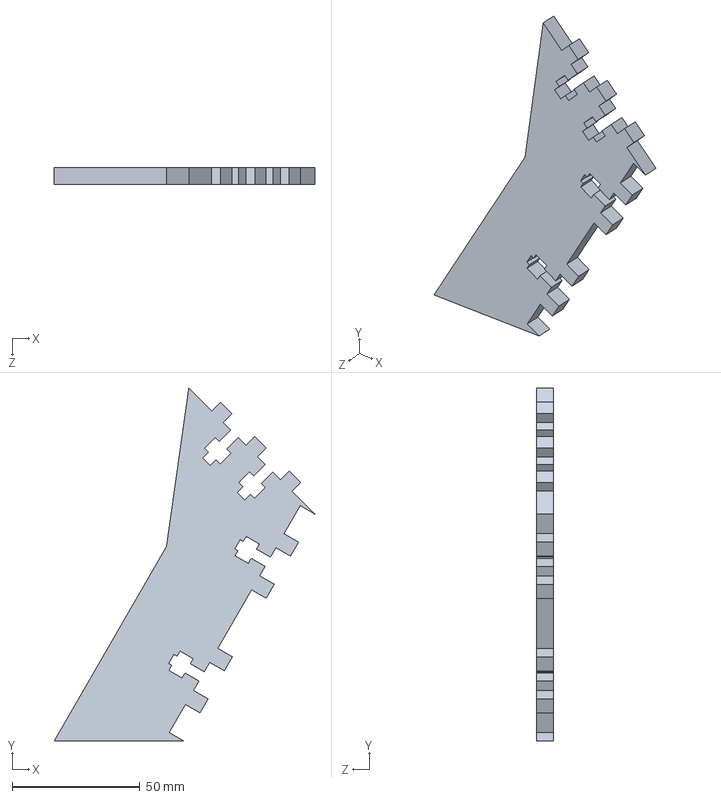
[picture p188: CAD file, 2013-12-16]
CAD/Linear Book Scanner/Frame/RIB 4 INFEED, FRAME.SLDPRT
102.1 x 138.3 x 6.60 mm
