wrightsh/Michigan-Linear-Book-Scanner/CAD/Linear Book Scanner/Laser Cut Drawings/INFEED BACK, SIDE.DXF

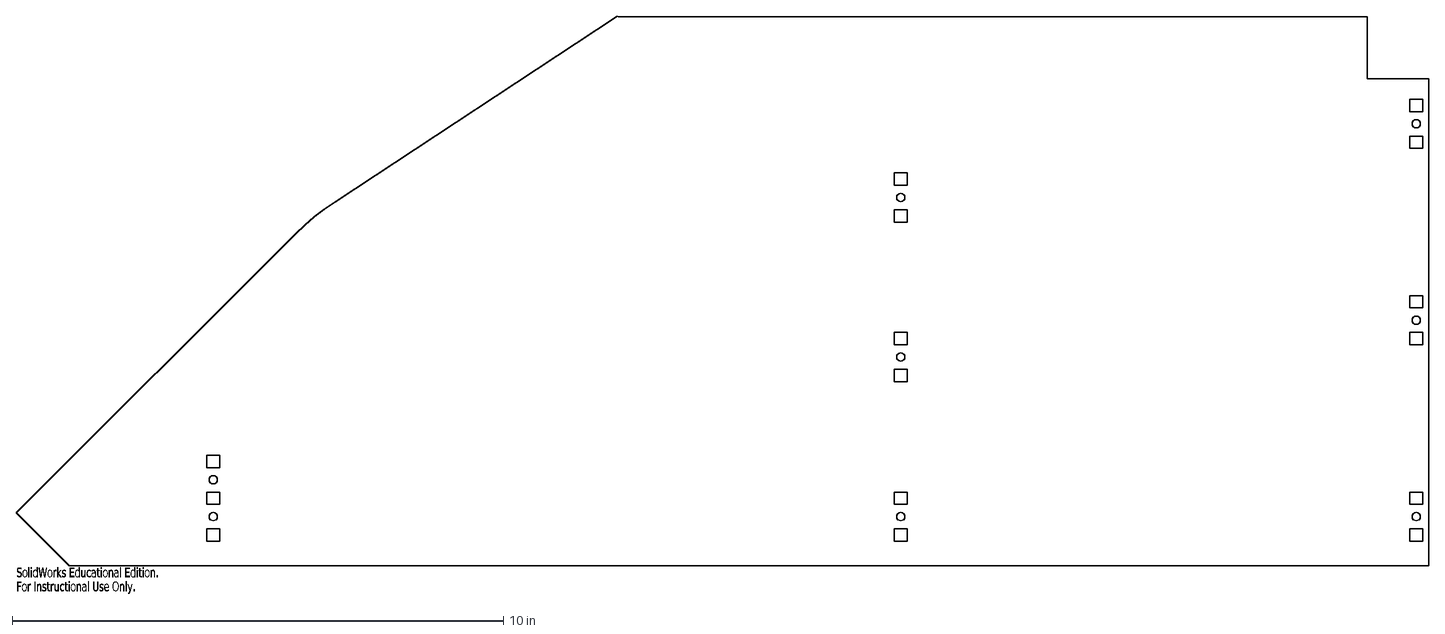
[picture p189: CAD file, 2013-12-16]
CAD/Linear Book Scanner/Laser Cut Drawings/INFEED BACK, SIDE.DXF
SolidWorks Educational Edition.
For Instructional Use Only.
