wrightsh/Michigan-Linear-Book-Scanner/CAD/Linear Book Scanner/Sides/HORN_3, OUTFEED FRONT.SLDPRT

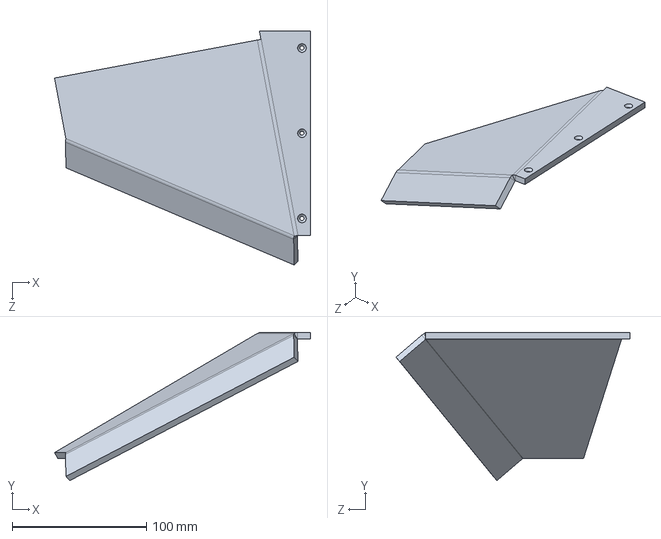
[picture p190: CAD file, 2013-12-16]
CAD/Linear Book Scanner/Sides/HORN_3, OUTFEED FRONT.SLDPRT
190.8 x 110.5 x 174.4 mm
