wrightsh/Michigan-Linear-Book-Scanner/CAD/Linear Book Scanner/Electronics Slide/Iluminated Button Red.SLDPRT

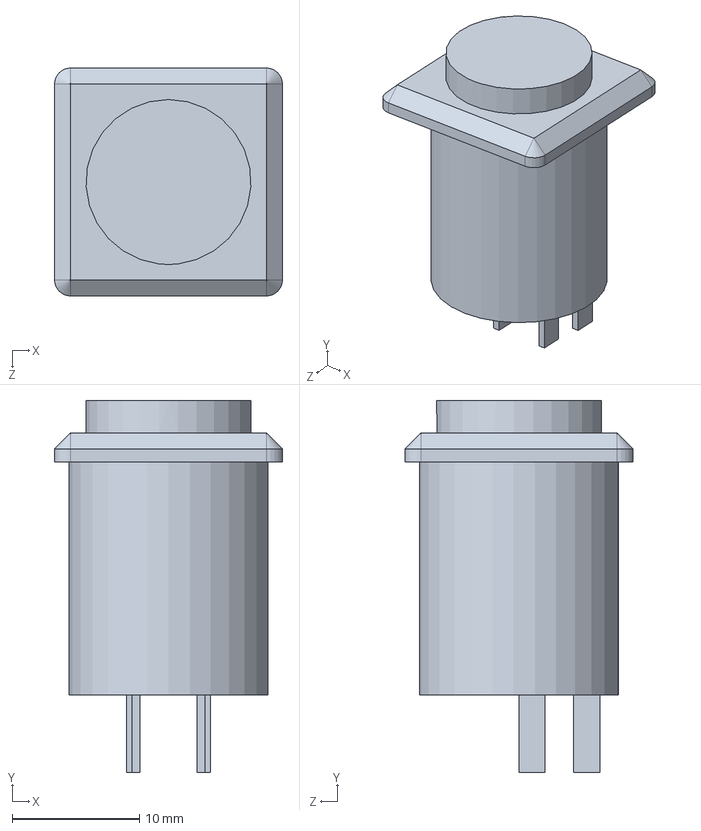
[picture p191: CAD file, 2013-12-16]
CAD/Linear Book Scanner/Electronics Slide/Iluminated Button Red.SLDPRT
17.9 x 29.2 x 17.9 mm
