wrightsh/Michigan-Linear-Book-Scanner/CAD/Linear Book Scanner/Frame/LOWER OUTFEED FRONT RIB, FRAME.SLDPRT

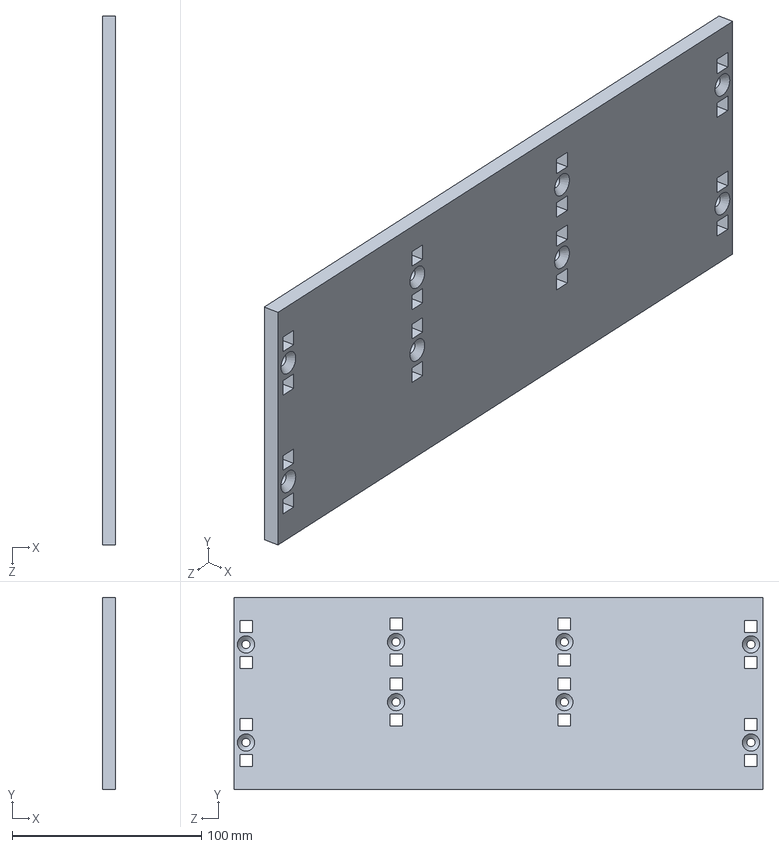
[picture p192: CAD file, 2013-12-16]
CAD/Linear Book Scanner/Frame/LOWER OUTFEED FRONT RIB, FRAME.SLDPRT
6.60 x 101.6 x 279.4 mm
