wrightsh/Michigan-Linear-Book-Scanner/CAD/Linear Book Scanner/Laser Cut Drawings/HORN_4 OUTFEED FRONT.DXF

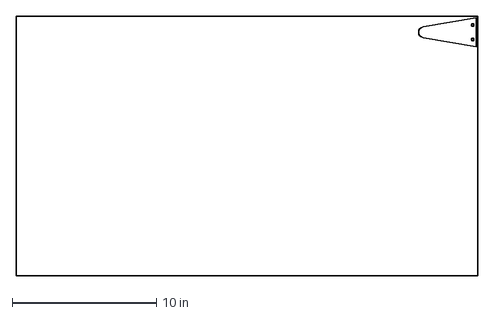
[picture p193: CAD file, 2013-12-16]
CAD/Linear Book Scanner/Laser Cut Drawings/HORN_4 OUTFEED FRONT.DXF
32.0 x 18.0 in
