wrightsh/Michigan-Linear-Book-Scanner/CAD/Linear Book Scanner/Sides/HORN_5 OUTFEED FRONT.SLDPRT

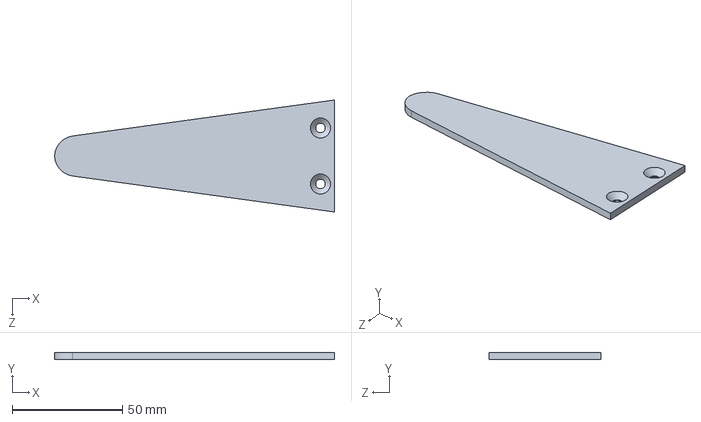
[picture p194: CAD file, 2013-12-16]
CAD/Linear Book Scanner/Sides/HORN_5 OUTFEED FRONT.SLDPRT
127.0 x 3.17 x 50.8 mm
