wrightsh/Michigan-Linear-Book-Scanner/CAD/Linear Book Scanner/Electronics Slide/raspberry-pi-b-1/raspberry_pi__SD_reader_pin2.SLDPRT

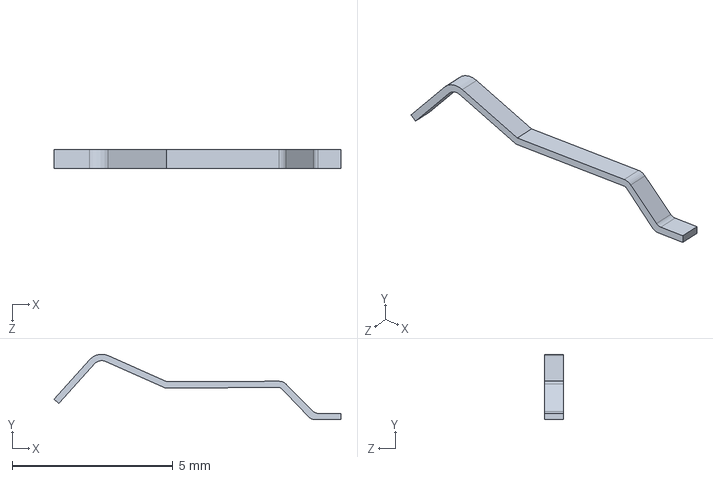
[picture p195: CAD file, 2013-12-16]
CAD/Linear Book Scanner/Electronics Slide/raspberry-pi-b-1/raspberry_pi__SD_reader_pin2.SLDPRT
8.94 x 2.04 x 0.6 mm
