wrightsh/Michigan-Linear-Book-Scanner/CAD/Linear Book Scanner/Frame/LOWER INFEED BACK RIB, FRAME.SLDPRT

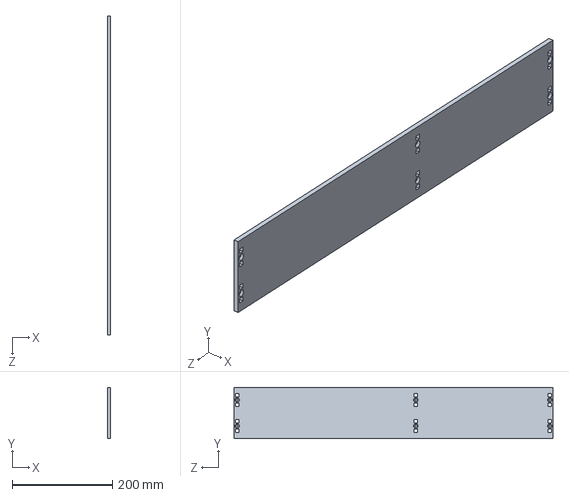
[picture p196: CAD file, 2013-12-16]
CAD/Linear Book Scanner/Frame/LOWER INFEED BACK RIB, FRAME.SLDPRT
6.60 x 101.6 x 635.0 mm
