wrightsh/Michigan-Linear-Book-Scanner/CAD/Linear Book Scanner/Saddle/SIDE COVER LOWER, SADDLE.SLDPRT

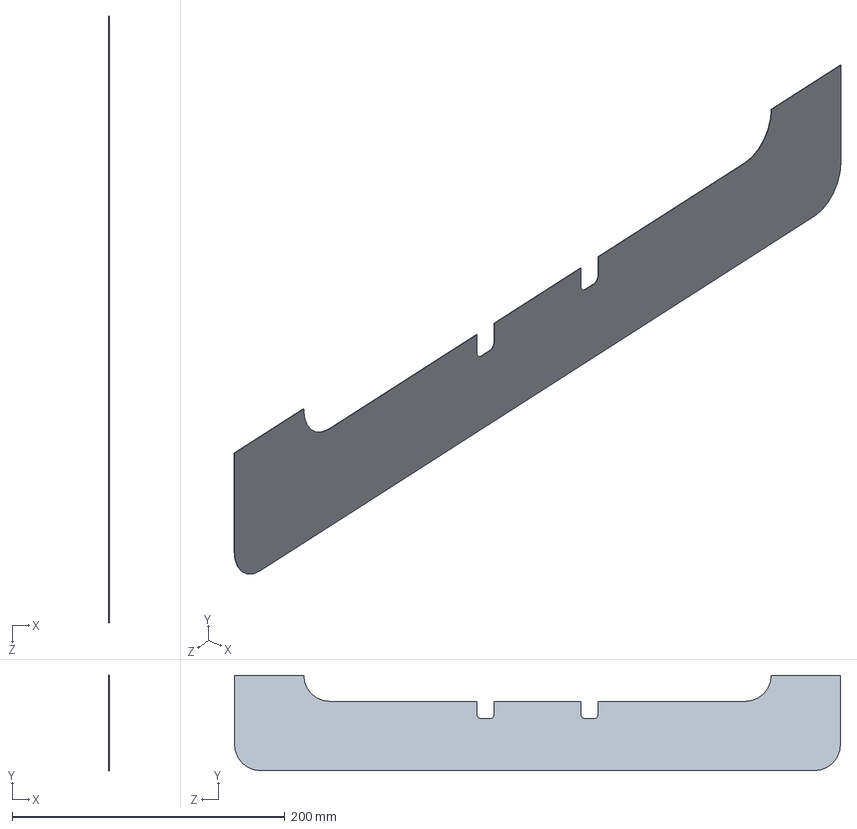
[picture p197: CAD file, 2013-12-16]
CAD/Linear Book Scanner/Saddle/SIDE COVER LOWER, SADDLE.SLDPRT
0.254 x 69.8 x 444.5 mm
