wrightsh/Michigan-Linear-Book-Scanner/CAD/Linear Book Scanner/Electronics Slide/raspberry-pi-b-1/raspberry_pi__168_FBGA_12x12.SLDPRT

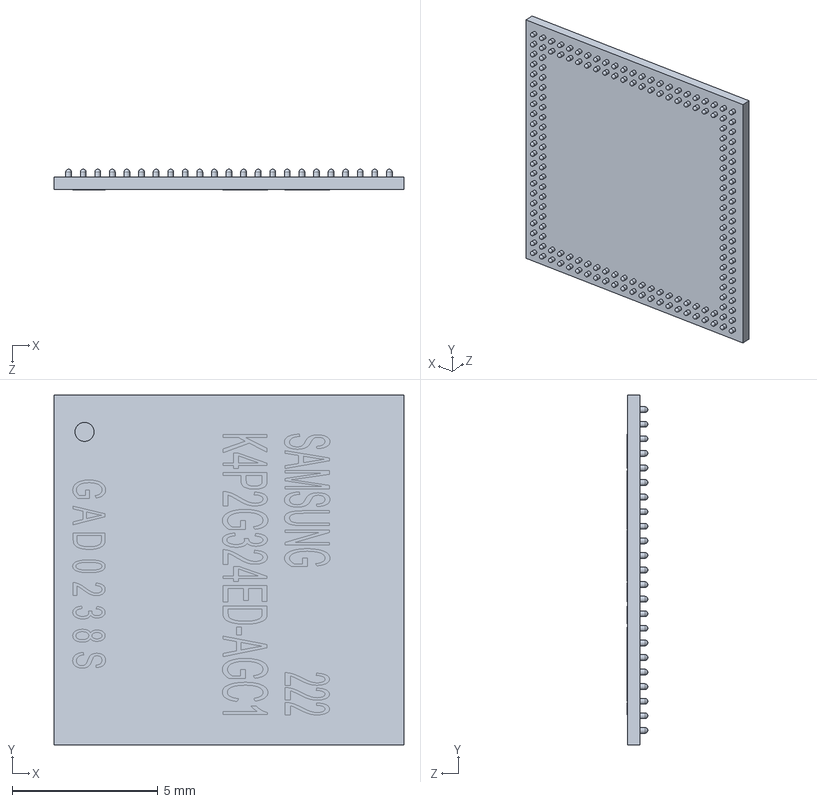
[picture p198: CAD file, 2013-12-16]
CAD/Linear Book Scanner/Electronics Slide/raspberry-pi-b-1/raspberry_pi__168_FBGA_12x12.SLDPRT
12.0 x 12.0 x 0.71 mm
