wrightsh/Michigan-Linear-Book-Scanner/CAD/Linear Book Scanner/Electronics Slide/raspberry-pi-b-1/raspberry_pi__Xtal_Smd_19200.SLDPRT

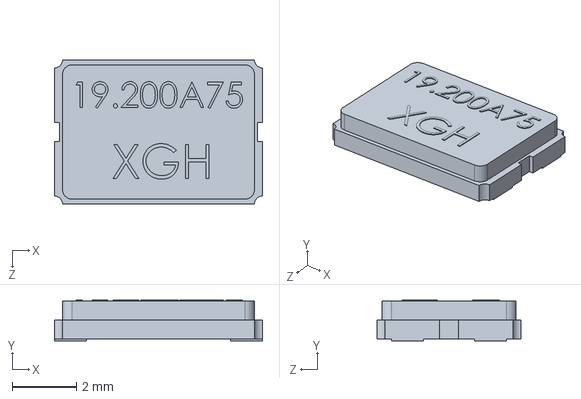
[picture p200: CAD file, 2013-12-16]
CAD/Linear Book Scanner/Electronics Slide/raspberry-pi-b-1/raspberry_pi__Xtal_Smd_19200.SLDPRT
6.50 x 1.27 x 4.50 mm
