wrightsh/Michigan-Linear-Book-Scanner/CAD/Linear Book Scanner/Laser Cut Drawings/INFEED FRONT, SIDE.DXF

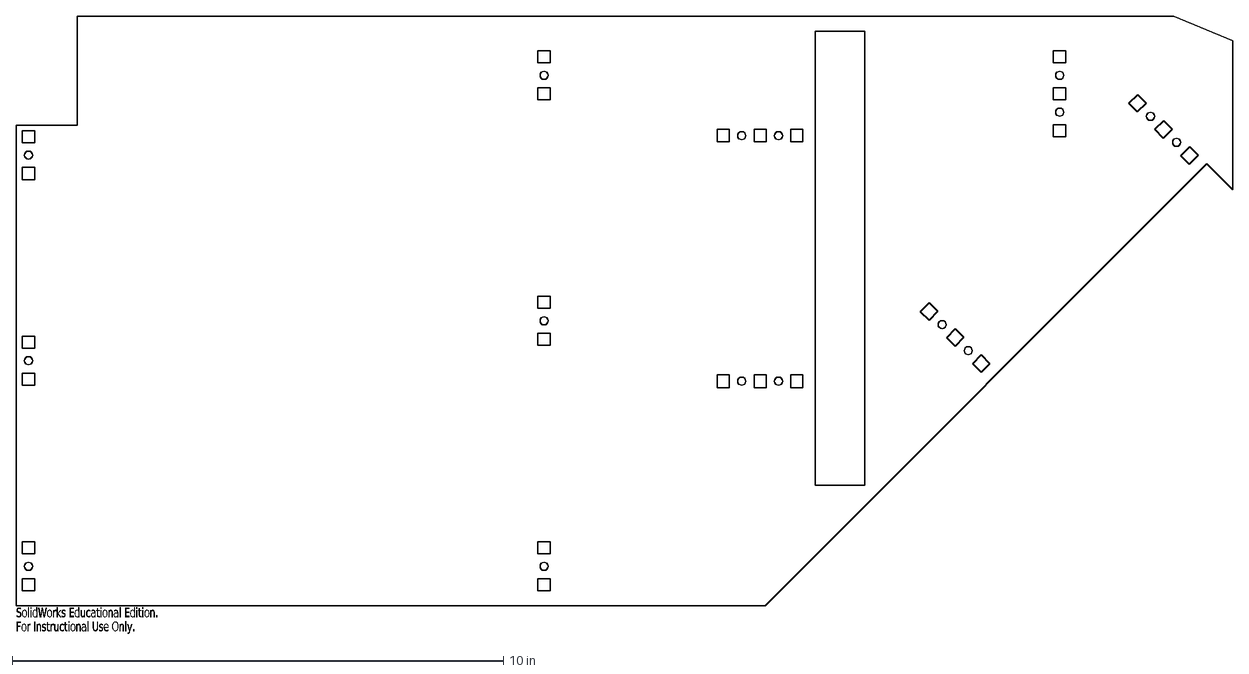
[picture p201: CAD file, 2013-12-16]
CAD/Linear Book Scanner/Laser Cut Drawings/INFEED FRONT, SIDE.DXF
SolidWorks Educational Edition.
For Instructional Use Only.
