wrightsh/Michigan-Linear-Book-Scanner/CAD/Linear Book Scanner/Saddle/PADDLE SLIDE, SADDLE.SLDPRT

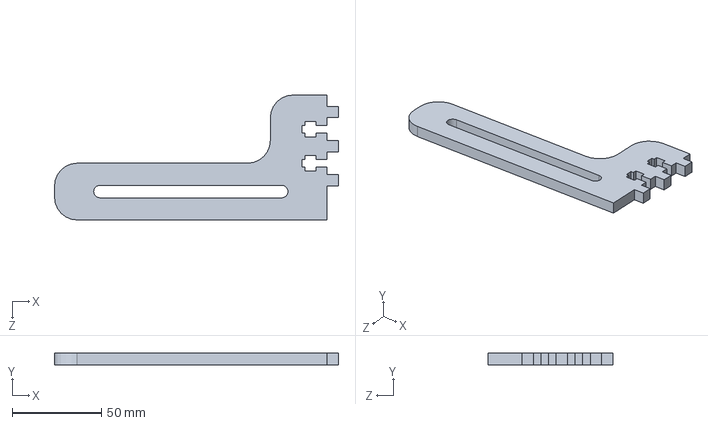
[picture p202: CAD file, 2013-12-16]
CAD/Linear Book Scanner/Saddle/PADDLE SLIDE, SADDLE.SLDPRT
158.8 x 6.60 x 69.8 mm
