wrightsh/Michigan-Linear-Book-Scanner/CAD/Linear Book Scanner/Sides/HORN, OUTFEED FRONT.SLDPRT

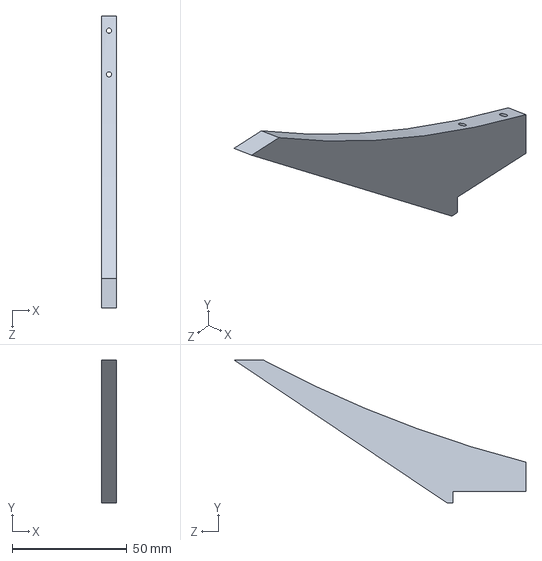
[picture p203: CAD file, 2013-12-16]
CAD/Linear Book Scanner/Sides/HORN, OUTFEED FRONT.SLDPRT
6.35 x 62.2 x 127.0 mm
