wrightsh/Michigan-Linear-Book-Scanner/CAD/Linear Book Scanner/Electronics Slide/raspberry-pi-b-1/raspberry_pi__diode_10_pins.SLDPRT

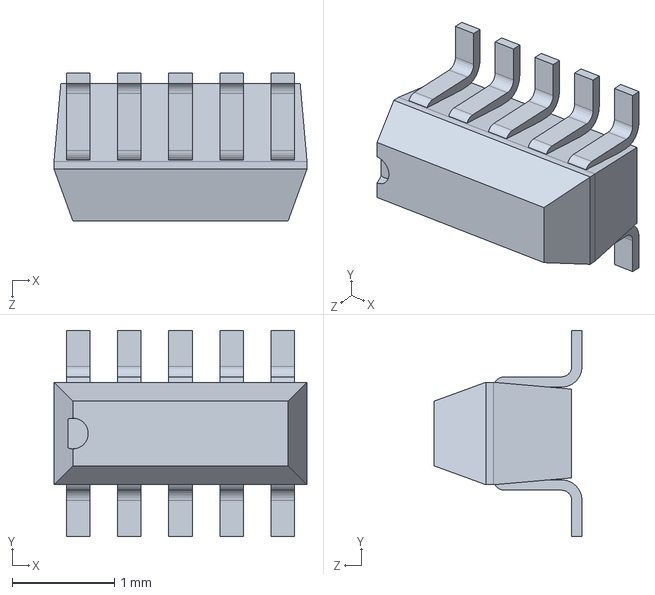
[picture p204: CAD file, 2013-12-16]
CAD/Linear Book Scanner/Electronics Slide/raspberry-pi-b-1/raspberry_pi__diode_10_pins.SLDPRT
2.47 x 2.02 x 1.45 mm
