wrightsh/Michigan-Linear-Book-Scanner/CAD/Linear Book Scanner/Electronics Slide/SAINSMART Stepper Driver.SLDPRT

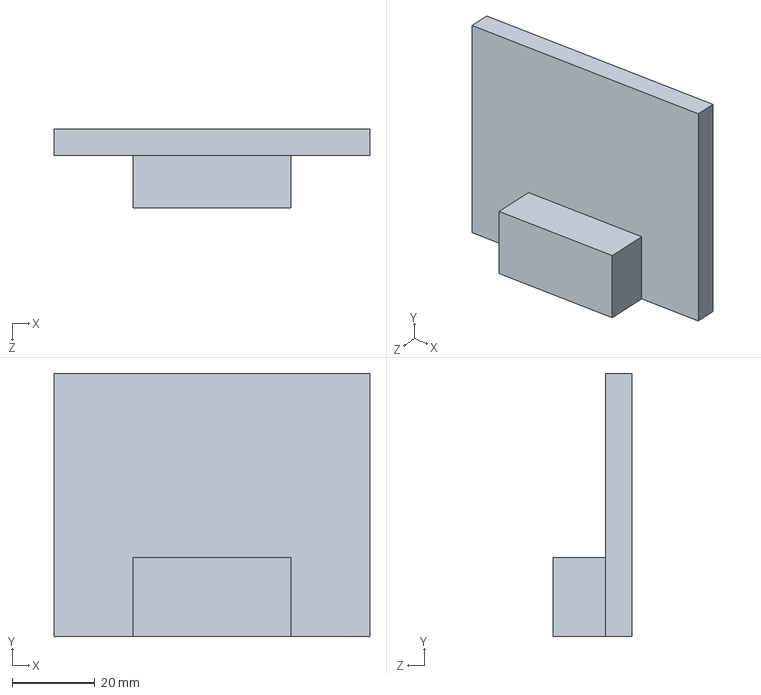
[picture p205: CAD file, 2013-12-16]
CAD/Linear Book Scanner/Electronics Slide/SAINSMART Stepper Driver.SLDPRT
76.2 x 63.5 x 19.1 mm
