wrightsh/Michigan-Linear-Book-Scanner/CAD/Linear Book Scanner/Laser Cut Drawings/HORN_1, INFEED FRONT.DXF

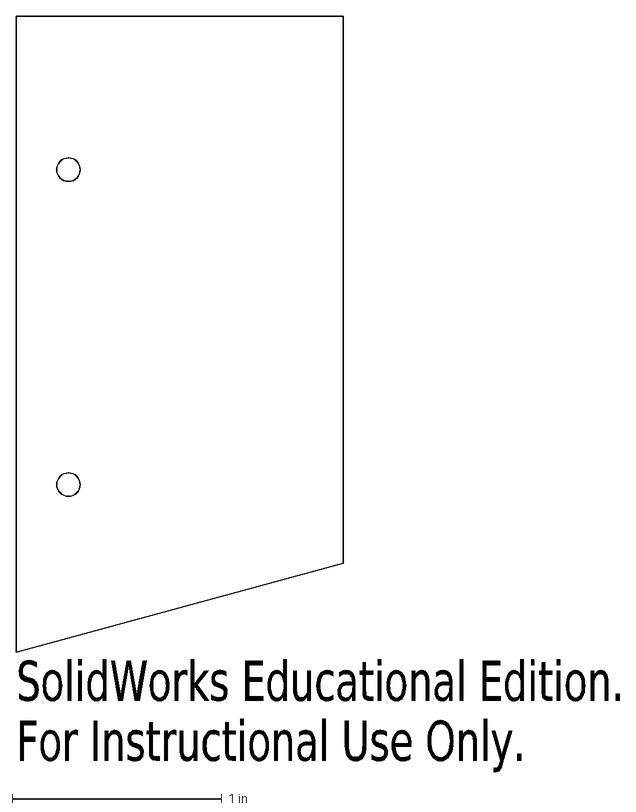
[picture p206: CAD file, 2013-12-16]
CAD/Linear Book Scanner/Laser Cut Drawings/HORN_1, INFEED FRONT.DXF
SolidWorks Educational Edition.
For Instructional Use Only.
