wrightsh/Michigan-Linear-Book-Scanner/CAD/Linear Book Scanner/Saddle/SIDE COVER UPPER, SADDLE.SLDPRT

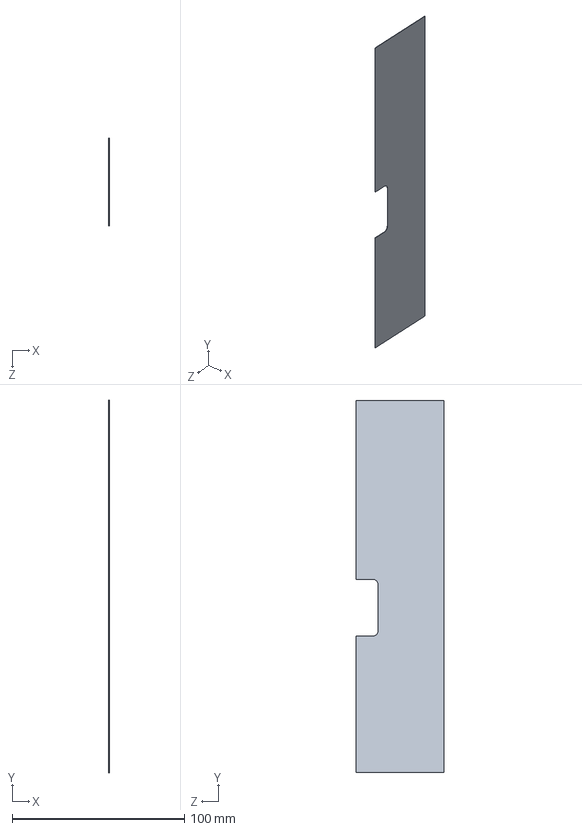
[picture p207: CAD file, 2013-12-16]
CAD/Linear Book Scanner/Saddle/SIDE COVER UPPER, SADDLE.SLDPRT
0.254 x 215.9 x 50.8 mm
