wrightsh/Michigan-Linear-Book-Scanner/CAD/Linear Book Scanner/Sides/HORN_2, OUTFEED FRONT.SLDPRT

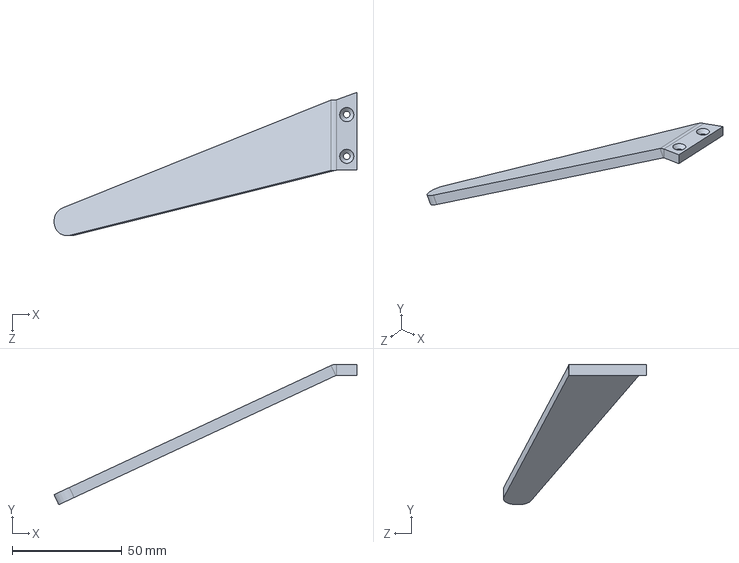
[picture p208: CAD file, 2013-12-16]
CAD/Linear Book Scanner/Sides/HORN_2, OUTFEED FRONT.SLDPRT
138.3 x 64.1 x 65.4 mm
