wrightsh/Michigan-Linear-Book-Scanner/CAD/Linear Book Scanner/Laser Cut Drawings/HORN_5 OUTFEED FRONT.DXF

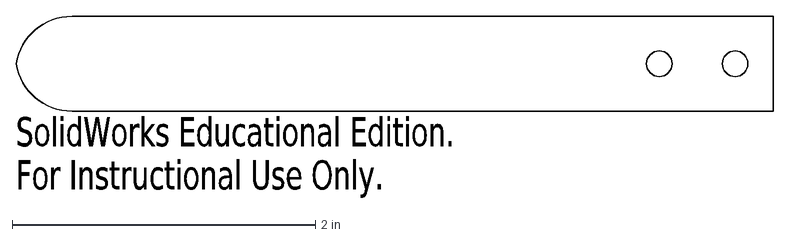
[picture p210: CAD file, 2013-12-16]
CAD/Linear Book Scanner/Laser Cut Drawings/HORN_5 OUTFEED FRONT.DXF
SolidWorks Educational Edition.
For Instructional Use Only.
