wrightsh/Michigan-Linear-Book-Scanner/CAD/Linear Book Scanner/Sides/HORN MOUNT 3, OUTFEED FRONT.SLDPRT

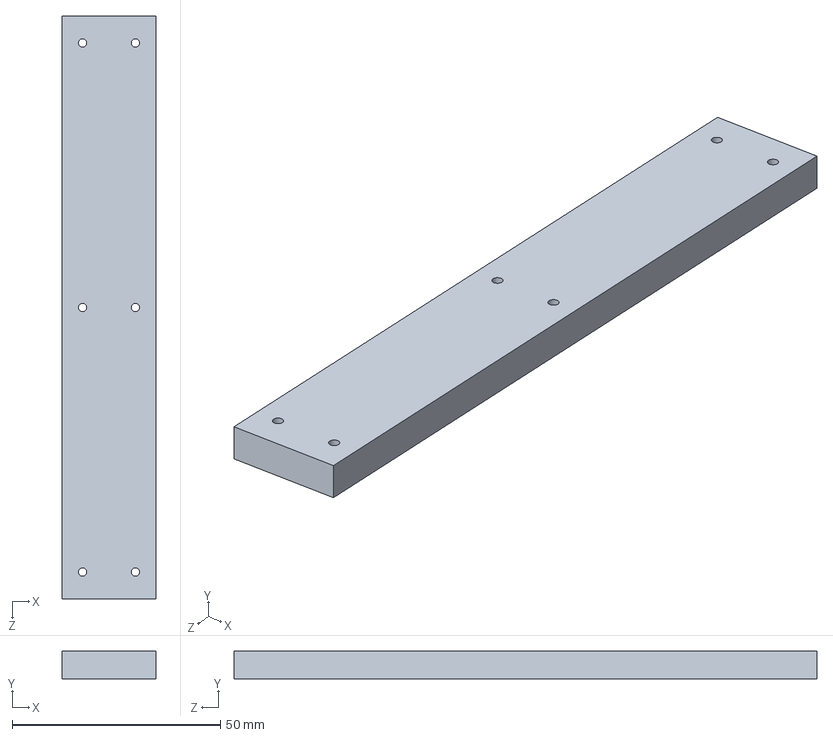
[picture p211: CAD file, 2013-12-16]
CAD/Linear Book Scanner/Sides/HORN MOUNT 3, OUTFEED FRONT.SLDPRT
22.5 x 6.60 x 140.0 mm
