wrightsh/Michigan-Linear-Book-Scanner/(list of files, cad)

Other CAD files:
CAD/Linear Book Scanner/Pulleys/PULLEY BLOCK, OUTFEED.SLDASM
CAD/Linear Book Scanner/Electronics Slide/raspberry-pi-b-1/raspberrypi_b_assembly_mounting_holes.SLDASM
CAD/Linear Book Scanner/Base/Base Spacer.SLDPRT
CAD/Linear Book Scanner/Laser Cut Layouts/Acrylic Cut 1/Acrylic_1.DXF
CAD/Linear Book Scanner/Sides/OUTFEED BACK, SIDE.SLDPRT
CAD/Linear Book Scanner/Vacuum Tube/OUTSIDE TUBE, VACUUM TUBE.SLDPRT
CAD/Linear Book Scanner/Saddle/LOWER PADDLE, SADDLE.SLDPRT
CAD/Linear Book Scanner/Laser Cut Drawings/Acrylic_3.DXF
CAD/Linear Book Scanner/Saddle/SIDE_2, SADDLE.SLDPRT
CAD/Linear Book Scanner/Frame/RIB 2, FRAME.SLDPRT
CAD/Linear Book Scanner/Sides/INFEED BACK, SIDE.SLDPRT
CAD/Linear Book Scanner/Laser Cut Drawings/Acrylic_1.DXF
CAD/Linear Book Scanner/Pulleys/LIMIT SWITCH MOUNT, INFEED.SLDPRT
CAD/Linear Book Scanner/Electronics Slide/Iluminated Button Yellow.SLDPRT
CAD/Linear Book Scanner/Sides/HORN_4 OUTFEED FRONT.SLDPRT
CAD/Linear Book Scanner/Electronics Slide/SLIDE MOUNT INFEED, ELECTRONICS SLIDE.SLDPRT
CAD/Linear Book Scanner/Electronics Slide/Iluminated Button.SLDPRT
CAD/Linear Book Scanner/Electronics Slide/SLIDE MOUNT, ELECTRONICS SLIDE.SLDPRT
CAD/Linear Book Scanner/Base/Base Spacer.SLDDRW
CAD/Linear Book Scanner/Electronics Slide/BASE, ELECTRONICS SLIDE.SLDDRW
CAD/Linear Book Scanner/Electronics Slide/BASE, ELECTRONICS SLIDE.SLDPRT
CAD/Linear Book Scanner/Electronics Slide/FRONT, ELECTRONICS SLIDE.SLDDRW
CAD/Linear Book Scanner/Electronics Slide/Iluminated Button Green.SLDPRT
CAD/Linear Book Scanner/Electronics Slide/SIDE INFEED, ELECTRONICS SLIDE.SLDDRW
CAD/Linear Book Scanner/Electronics Slide/SIDE OUTFEED, ELECTRONICS SLIDE.SLDPRT
CAD/Linear Book Scanner/Electronics Slide/SLIDE MOUNT INFEED, ELECTRONICS SLIDE.SLDDRW
CAD/Linear Book Scanner/Electronics Slide/raspberry-pi-b-1/raspberry_pi__0603.SLDPRT
CAD/Linear Book Scanner/Electronics Slide/raspberry-pi-b-1/raspberry_pi__1210.SLDPRT
CAD/Linear Book Scanner/Electronics Slide/raspberry-pi-b-1/raspberry_pi__15_pin_FFC_Connector_body.SLDPRT
CAD/Linear Book Scanner/Electronics Slide/raspberry-pi-b-1/raspberry_pi__15_pin_FFC_Connector_locker.SLDPRT
CAD/Linear Book Scanner/Electronics Slide/raspberry-pi-b-1/raspberry_pi__15_pin_FFC_Connector_pins.SLDPRT
CAD/Linear Book Scanner/Electronics Slide/raspberry-pi-b-1/raspberry_pi__1812.SLDPRT
CAD/Linear Book Scanner/Electronics Slide/raspberry-pi-b-1/raspberry_pi__CI_Board.SLDPRT
CAD/Linear Book Scanner/Electronics Slide/raspberry-pi-b-1/raspberry_pi__CI_Board_mounting_holes.SLDPRT
CAD/Linear Book Scanner/Electronics Slide/raspberry-pi-b-1/raspberry_pi__HDMI_socket_cover.SLDPRT
CAD/Linear Book Scanner/Electronics Slide/raspberry-pi-b-1/raspberry_pi__HDMI_socket_large_pin.SLDPRT
CAD/Linear Book Scanner/Electronics Slide/raspberry-pi-b-1/raspberry_pi__HDMI_socket_small_pin.SLDPRT
CAD/Linear Book Scanner/Electronics Slide/raspberry-pi-b-1/raspberry_pi__LED_SMD_0603.SLDPRT
CAD/Linear Book Scanner/Electronics Slide/raspberry-pi-b-1/raspberry_pi__QFN64-2.SLDPRT
CAD/Linear Book Scanner/Electronics Slide/raspberry-pi-b-1/raspberry_pi__RJ45.SLDPRT
CAD/Linear Book Scanner/Electronics Slide/raspberry-pi-b-1/raspberry_pi__SD_reader_body.SLDPRT
CAD/Linear Book Scanner/Electronics Slide/raspberry-pi-b-1/raspberry_pi__SD_reader_pin1.SLDPRT
CAD/Linear Book Scanner/Electronics Slide/raspberry-pi-b-1/raspberry_pi__SD_reader_pin3.SLDPRT
CAD/Linear Book Scanner/Electronics Slide/raspberry-pi-b-1/raspberry_pi__SD_reader_pin5.SLDPRT
CAD/Linear Book Scanner/Electronics Slide/raspberry-pi-b-1/raspberry_pi__Sot223.SLDPRT
CAD/Linear Book Scanner/Electronics Slide/raspberry-pi-b-1/raspberry_pi__Sot23-3_5pins.SLDPRT
CAD/Linear Book Scanner/Electronics Slide/raspberry-pi-b-1/raspberry_pi__Sot23.SLDPRT
CAD/Linear Book Scanner/Electronics Slide/raspberry-pi-b-1/raspberry_pi__USB_x2_part2.SLDPRT
CAD/Linear Book Scanner/Electronics Slide/raspberry-pi-b-1/raspberry_pi__Xtal_Smd_25.SLDPRT
CAD/Linear Book Scanner/Electronics Slide/raspberry-pi-b-1/raspberry_pi__audio_out.SLDPRT
CAD/Linear Book Scanner/Electronics Slide/raspberry-pi-b-1/raspberry_pi__bar_180_1x8.SLDPRT
CAD/Linear Book Scanner/Electronics Slide/raspberry-pi-b-1/raspberry_pi__bar_180_2x13.SLDPRT
CAD/Linear Book Scanner/Electronics Slide/raspberry-pi-b-1/raspberry_pi__capacitor_smd.SLDPRT
CAD/Linear Book Scanner/Electronics Slide/raspberry-pi-b-1/raspberry_pi__composite_video_out.SLDPRT
CAD/Linear Book Scanner/Electronics Slide/raspberry-pi-b-1/raspberry_pi__micro_USB_contacts.SLDPRT
CAD/Linear Book Scanner/Electronics Slide/raspberry-pi-b-1/raspberry_pi__micro_USB_cover.SLDPRT
CAD/Linear Book Scanner/Electronics Slide/raspberry-pi-b-1/raspberry_pi__sot-223_large.SLDPRT
CAD/Linear Book Scanner/Fastener Example/8-32 Nut.SLDPRT
CAD/Linear Book Scanner/Fastener Example/90480A009.STEP
CAD/Linear Book Scanner/Fastener Example/90631A009.SLDPRT
CAD/Linear Book Scanner/Fastener Example/90631A009.STEP
CAD/Linear Book Scanner/Fastener Example/92210A196.STEP
CAD/Linear Book Scanner/Fastener Example/92210A197.SLDPRT
CAD/Linear Book Scanner/Fastener Example/92210A197.STEP
CAD/Linear Book Scanner/Fastener Example/BOLT HOLE FOR EXPO.SLDDRW
CAD/Linear Book Scanner/Fastener Example/BOLT HOLE FOR EXPO.SLDPRT
CAD/Linear Book Scanner/Fastener Example/NUT HOLE FOR EXPO.SLDDRW
CAD/Linear Book Scanner/Fastener Example/NUT HOLE FOR EXPO.SLDPRT
CAD/Linear Book Scanner/Fasteners/90631A009.SLDPRT
CAD/Linear Book Scanner/Fasteners/90631A009.STEP
CAD/Linear Book Scanner/Fasteners/91253A550.SLDPRT
CAD/Linear Book Scanner/Fasteners/91253A550.STEP
CAD/Linear Book Scanner/Fasteners/92210A113.SLDPRT
CAD/Linear Book Scanner/Fasteners/92210A113.STEP
CAD/Linear Book Scanner/Fasteners/92210A197.SLDPRT
CAD/Linear Book Scanner/Fasteners/92210A197.STEP
CAD/Linear Book Scanner/Fasteners/92210A546.SLDPRT
CAD/Linear Book Scanner/Fasteners/92210A546.STEP
CAD/Linear Book Scanner/Frame/LOWER INFEED BACK RIB, FRAME.SLDDRW
CAD/Linear Book Scanner/Frame/LOWER INFEED FRONT RIB, FRAME.SLDDRW
CAD/Linear Book Scanner/Frame/LOWER OUTFEED BACK RIB, FRAME.SLDDRW
CAD/Linear Book Scanner/Frame/LOWER OUTFEED FRONT RIB, FRAME.SLDDRW
CAD/Linear Book Scanner/Frame/RIB 1, FRAME.SLDDRW
CAD/Linear Book Scanner/Frame/RIB 2, FRAME.SLDDRW
CAD/Linear Book Scanner/Frame/RIB 3, FRAME.SLDDRW
CAD/Linear Book Scanner/Frame/RIB 4 OUTFEED, FRAME.SLDDRW
CAD/Linear Book Scanner/Frame/RIB 4, FRAME.SLDDRW
CAD/Linear Book Scanner/Frame/RIB 5, FRAME.SLDDRW
CAD/Linear Book Scanner/Frame/RIB 6, FRAME.SLDDRW
CAD/Linear Book Scanner/Laser Cut Drawings/Acrylic_4.DXF
CAD/Linear Book Scanner/Laser Cut Drawings/BOLT HOLE FOR EXPO.DXF
CAD/Linear Book Scanner/Laser Cut Drawings/NUT HOLE FOR EXPO.DXF
CAD/Linear Book Scanner/Laser Cut Drawings/OUTFEED FRONT, SIDE.DXF
CAD/Linear Book Scanner/Laser Cut Layouts/Acrylic_1.SLDDRW
CAD/Linear Book Scanner/Laser Cut Layouts/Acrylic_2.SLDDRW
CAD/Linear Book Scanner/Laser Cut Layouts/Acrylic_3.SLDDRW
CAD/Linear Book Scanner/Laser Cut Layouts/Acrylic_4.SLDDRW
CAD/Linear Book Scanner/Laser Cut Layouts/Acrylic_5.SLDDRW
CAD/Linear Book Scanner/Laser Cut Layouts/Delrin_1.SLDDRW
CAD/Linear Book Scanner/Laser Cut Layouts/Delrin_2.SLDDRW
CAD/Linear Book Scanner/Motor Mount/1375K39.SLDPRT
CAD/Linear Book Scanner/Motor Mount/FACE, MOTOR MOUNT.SLDDRW
CAD/Linear Book Scanner/Motor Mount/SIDE, MOTOR MOUNT.SLDDRW
CAD/Linear Book Scanner/Pulleys/1375K39.SLDPRT
CAD/Linear Book Scanner/Pulleys/6338K411.SLDPRT
CAD/Linear Book Scanner/Pulleys/7658K160.SLDPRT
CAD/Linear Book Scanner/Pulleys/7658K160.STEP
CAD/Linear Book Scanner/Pulleys/LIMIT SWITCH MOUNT, OUTFEED.SLDDRW
CAD/Linear Book Scanner/Pulleys/MOUNT OFFSET, PULLY.SLDDRW
CAD/Linear Book Scanner/Pulleys/MOUNT, PULLY.SLDDRW
CAD/Linear Book Scanner/Saddle/17715A68.SLDDRW
CAD/Linear Book Scanner/Saddle/17715A68.SLDPRT
CAD/Linear Book Scanner/Saddle/59625K330.SLDPRT
CAD/Linear Book Scanner/Saddle/59625K330.STEP
CAD/Linear Book Scanner/Saddle/BELT MOUNT LOWER, SADDLE.SLDDRW
CAD/Linear Book Scanner/Saddle/BELT MOUNT UPPER, SADDLE.SLDDRW
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
