wrightsh/Michigan-Linear-Book-Scanner/Other/LBS_Operation.txt

This file describes the general operation of the LBS as
we left it at the end of the 2013 Fall semester.  

Booting

Running a Job
