wrightsh/Michigan-Linear-Book-Scanner/CAD/Linear Book Scanner/Renderings/Main Assembly Inners.JPG

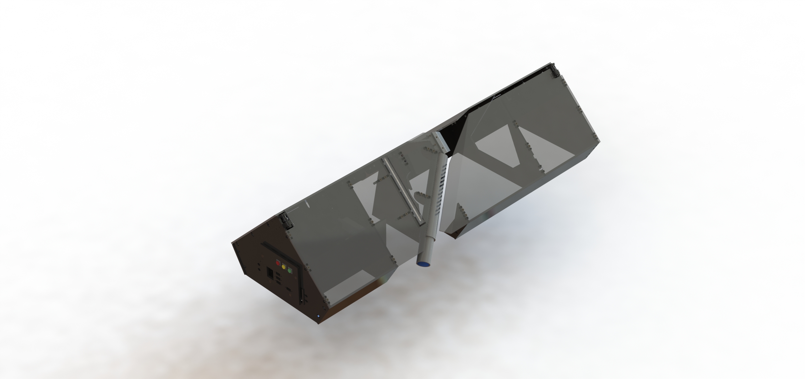
CAD/Linear Book Scanner/Renderings/Main Assembly Inners.JPG
