wrightsh/Michigan-Linear-Book-Scanner/CAD/Linear Book Scanner/Renderings/Main Assembly Top.JPG

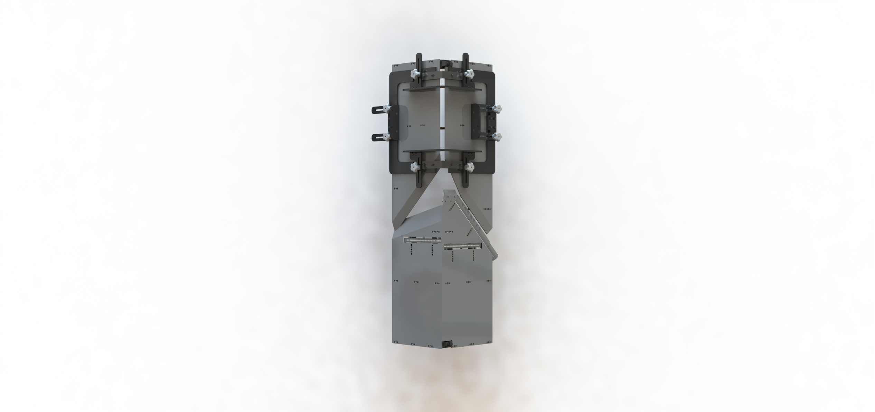
CAD/Linear Book Scanner/Renderings/Main Assembly Top.JPG
