wrightsh/Michigan-Linear-Book-Scanner/(threads)

Thread 1 (2015-07-14):

Which files for laser cutting?

sepastian, 2015-07-14:
Hello Shawn,

I could not find another way to contact you, so I am creating an issue.

We like your design and are looking into building our own copy of it.

I have a question about laser cutting: which (DXF) files should we use for laser cutting? I.e. which files contain all parts required?

Thanks,
Sebastian
