wrightsh/Michigan-Linear-Book-Scanner/CAD/Linear Book Scanner/Drawing PDFs/SLIDE MOUNT INFEED, ELECTRONICS SLIDE.PDF

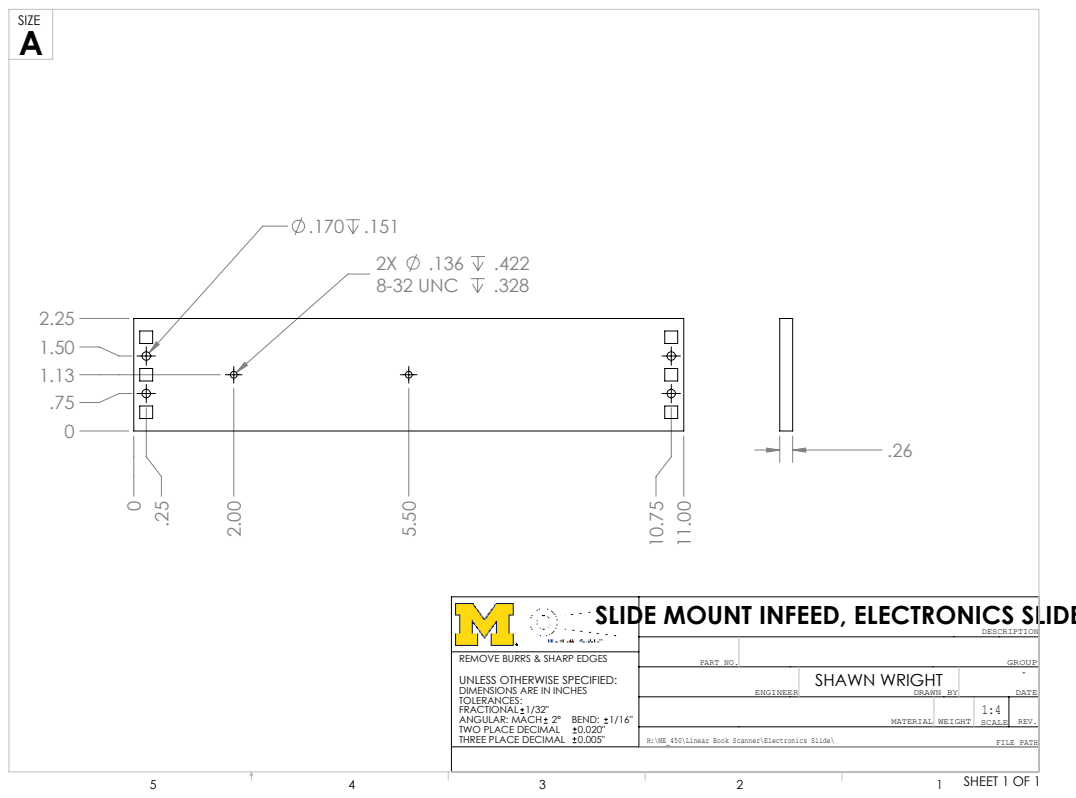
[picture p222: page 1]
8-32 UNC; SHEET 1 OF 1; PART NO.; FILE PATH; DRAWN BY; SHAWN WRIGHT; TWO PLACE DECIMAL

SLIDE MOUNT INFEED, ELECTRONICS SLIDE

REMOVE BURRS & SHARP EDGES
UNLESS OTHERWISE SPECIFIED:
DIMENSIONS ARE IN INCHES
TOLERANCES:
FRACTIONAL 1/32"
ANGULAR: MACH 2° BEND: 1/16"
THREE PLACE DECIMAL 0.005"

H:\ME_450\Linear Book Scanner\Electronics Slide\
