wrightsh/Michigan-Linear-Book-Scanner/CAD/Linear Book Scanner/Base/Base Spacer.PDF

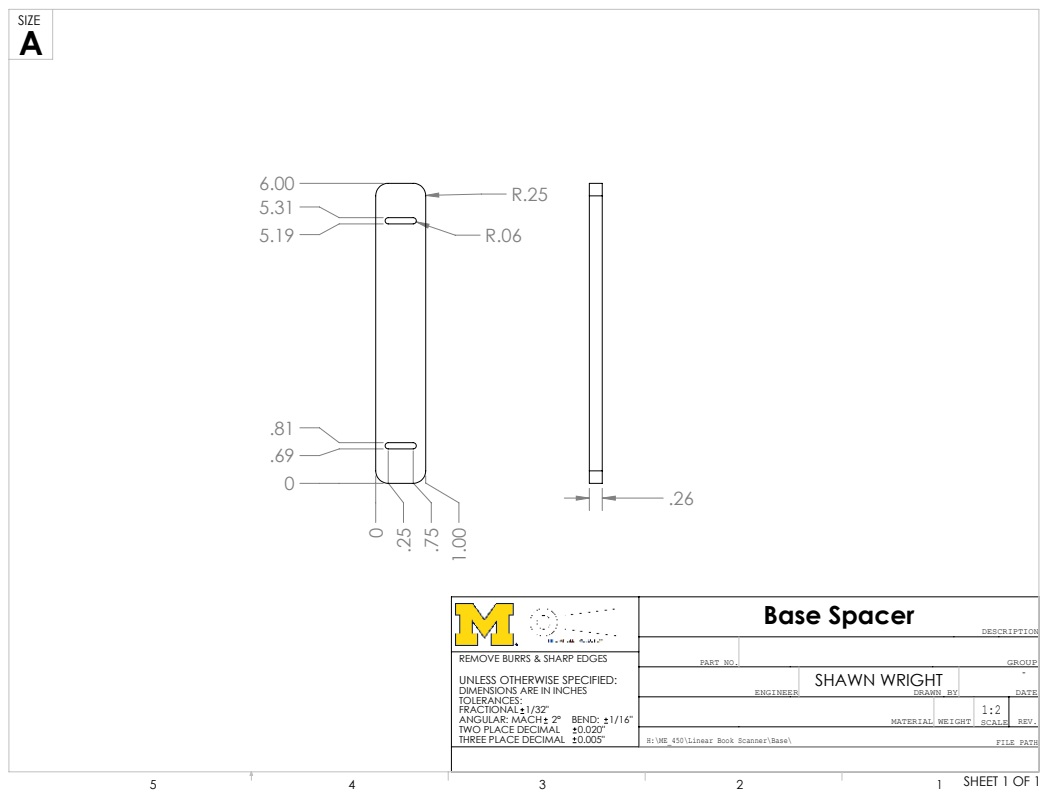
[picture p223: page 1]
SHEET 1 OF 1; PART NO.; FILE PATH; DRAWN BY; Base Spacer; SHAWN WRIGHT; TWO PLACE DECIMAL

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

H:\ME_450\Linear Book Scanner\Base\
