wrightsh/Michigan-Linear-Book-Scanner/CAD/Linear Book Scanner/Drawing PDFs/BELT MOUNT LOWER, SADDLE.PDF

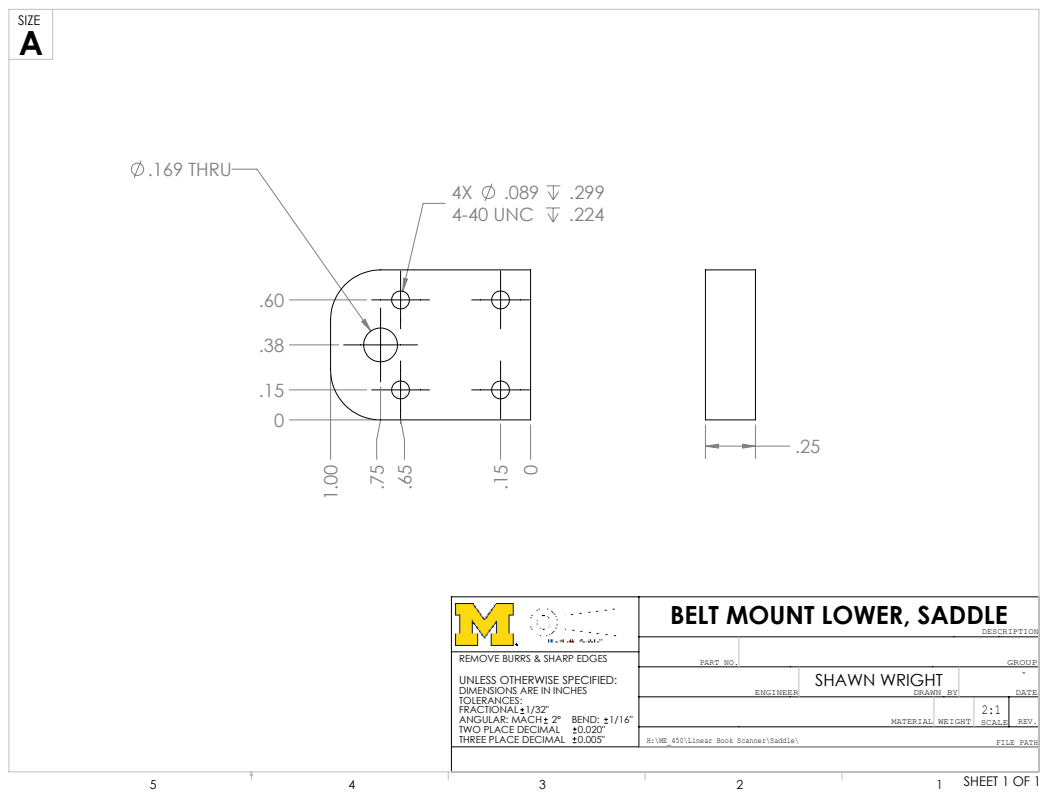
[picture p224: page 1]
4-40 UNC; .169 THRU; SHEET 1 OF 1; PART NO.; FILE PATH; DRAWN BY; SHAWN WRIGHT; TWO PLACE DECIMAL

BELT MOUNT LOWER, SADDLE

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

H:\ME_450\Linear Book Scanner\Saddle\
