wrightsh/Michigan-Linear-Book-Scanner/CAD/Linear Book Scanner/Drawing PDFs/FACE, MOTOR MOUNT.PDF

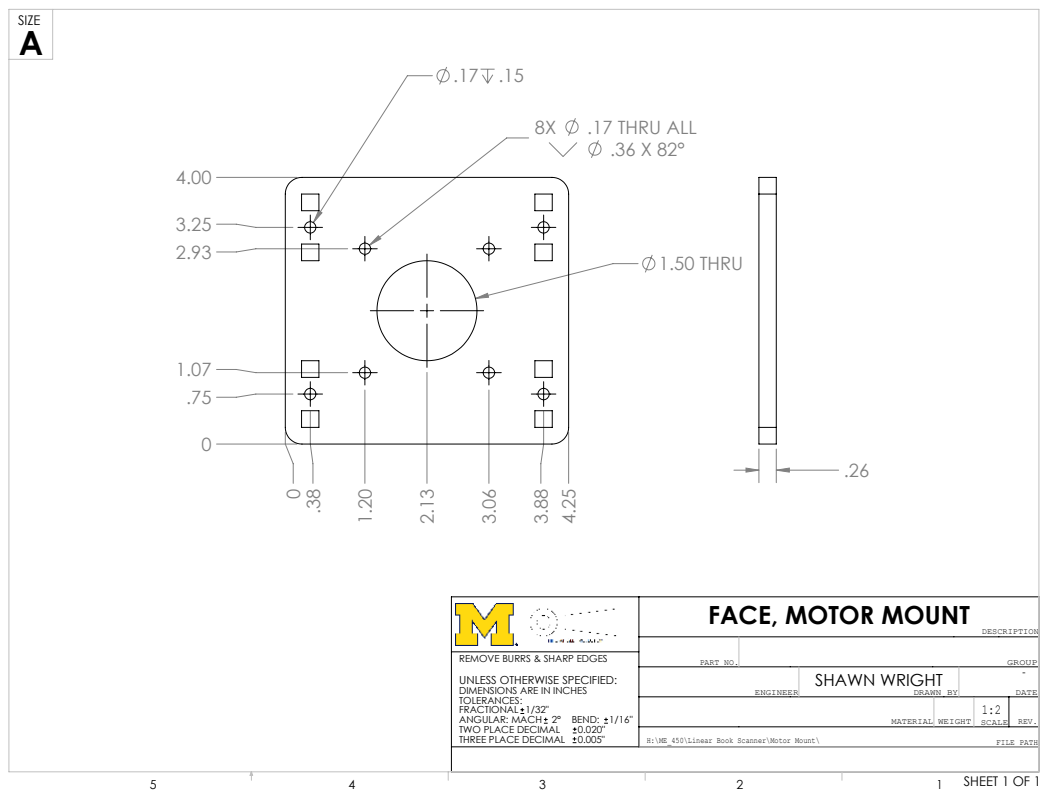
[picture p225: page 1]
.17 THRU ALL; 1.50 THRU; SHEET 1 OF 1; PART NO.; FILE PATH; DRAWN BY; SHAWN WRIGHT; TWO PLACE DECIMAL

FACE, MOTOR MOUNT

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

H:\ME_450\Linear Book Scanner\Motor Mount\
