wrightsh/Michigan-Linear-Book-Scanner/CAD/Linear Book Scanner/Drawing PDFs/INSIDE TUBE CAP, VACUUM TUBE.PDF

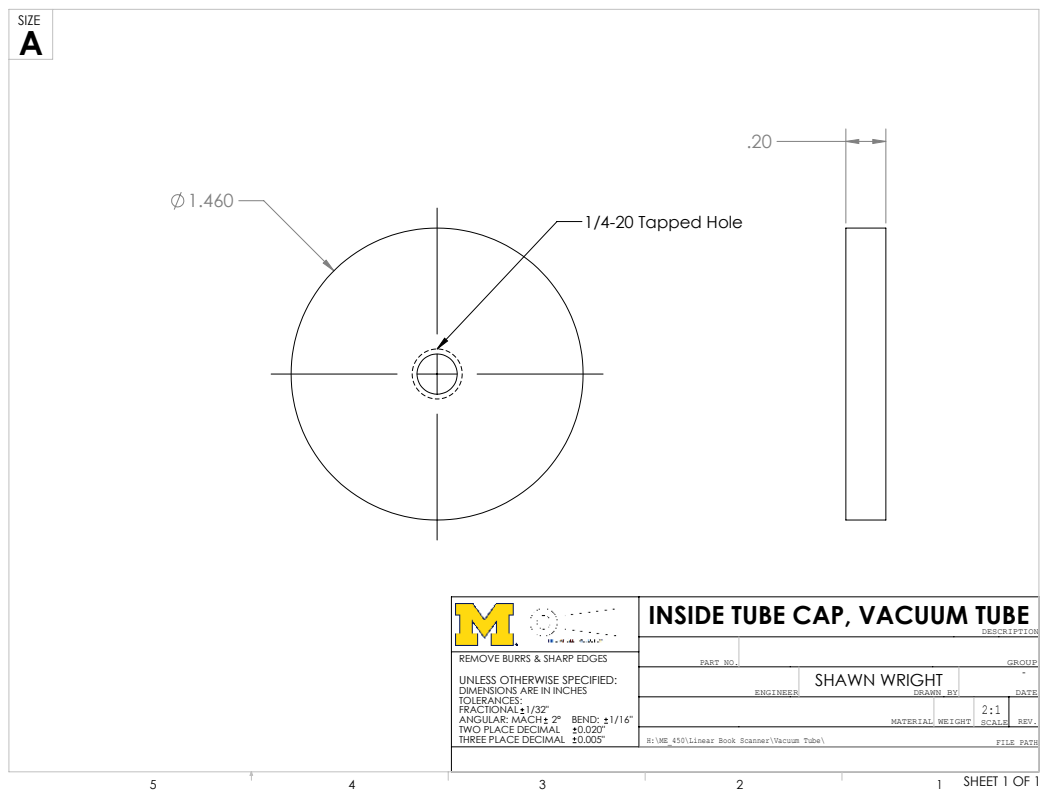
[picture p226: page 1]
1/4-20 Tapped Hole; SHEET 1 OF 1; PART NO.; FILE PATH; DRAWN BY; SHAWN WRIGHT; TWO PLACE DECIMAL

INSIDE TUBE CAP, VACUUM TUBE

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

H:\ME_450\Linear Book Scanner\Vacuum Tube\
