wrightsh/Michigan-Linear-Book-Scanner/CAD/Linear Book Scanner/Drawing PDFs/LBS_Drawings_ALL.pdf

A

## SIZE

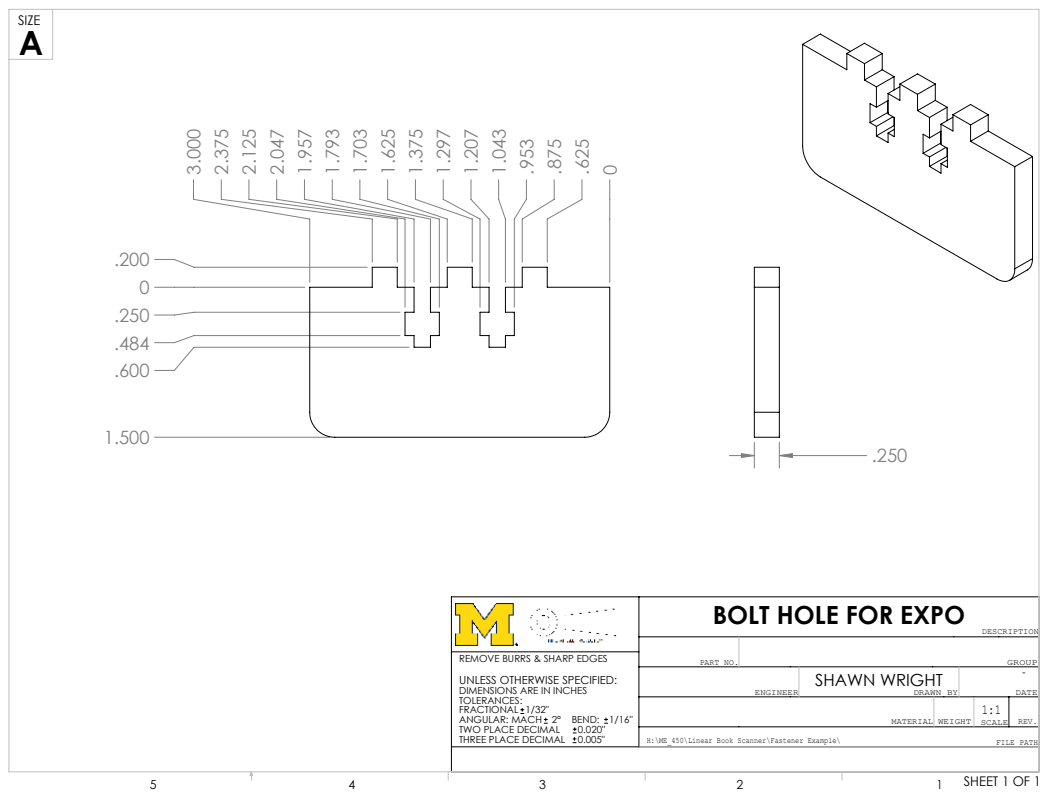
[picture p227: page 1]
SHEET 1 OF 1; DESCRIPTION; ENGINEER; PART NO.; MATERIAL; SCALE; REV.; FILE PATH; DATE; WEIGHT; DRAWN BY; GROUP; SHAWN WRIGHT; TWO PLACE DECIMAL

BOLT HOLE FOR EXPO

REMOVE BURRS & SHARP EDGES
UNLESS OTHERWISE SPECIFIED:
DIMENSIONS ARE IN INCHES
TOLERANCES:
FRACTIONAL 1/32"
ANGULAR: MACH 2° BEND: 1/16"
THREE PLACE DECIMAL 0.005"

H:\ME_450\Linear Book Scanner\Fastener Example\

A

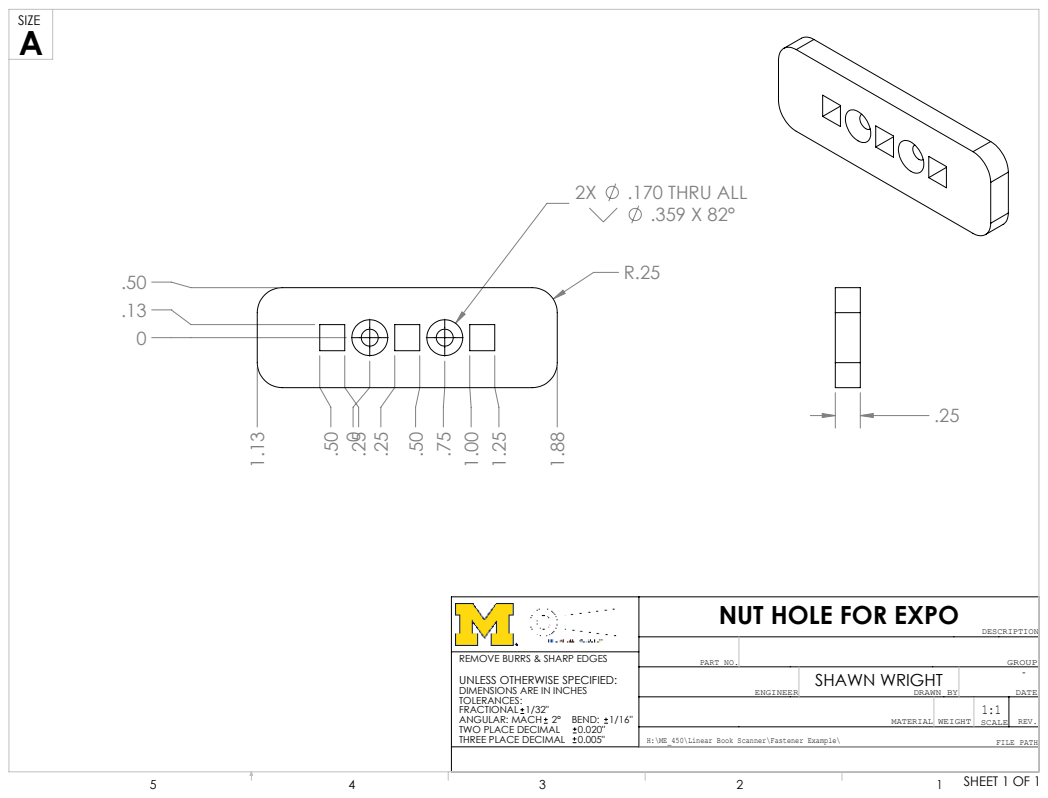
[picture p228: page 2]
.170 THRU ALL; DESCRIPTION; ENGINEER; PART NO.; MATERIAL; SCALE; REV.; DATE; WEIGHT; DRAWN BY; GROUP; SHAWN WRIGHT; TWO PLACE DECIMAL

NUT HOLE FOR EXPO

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

H:\ME_450\Linear Book Scanner\Fastener Example\

A

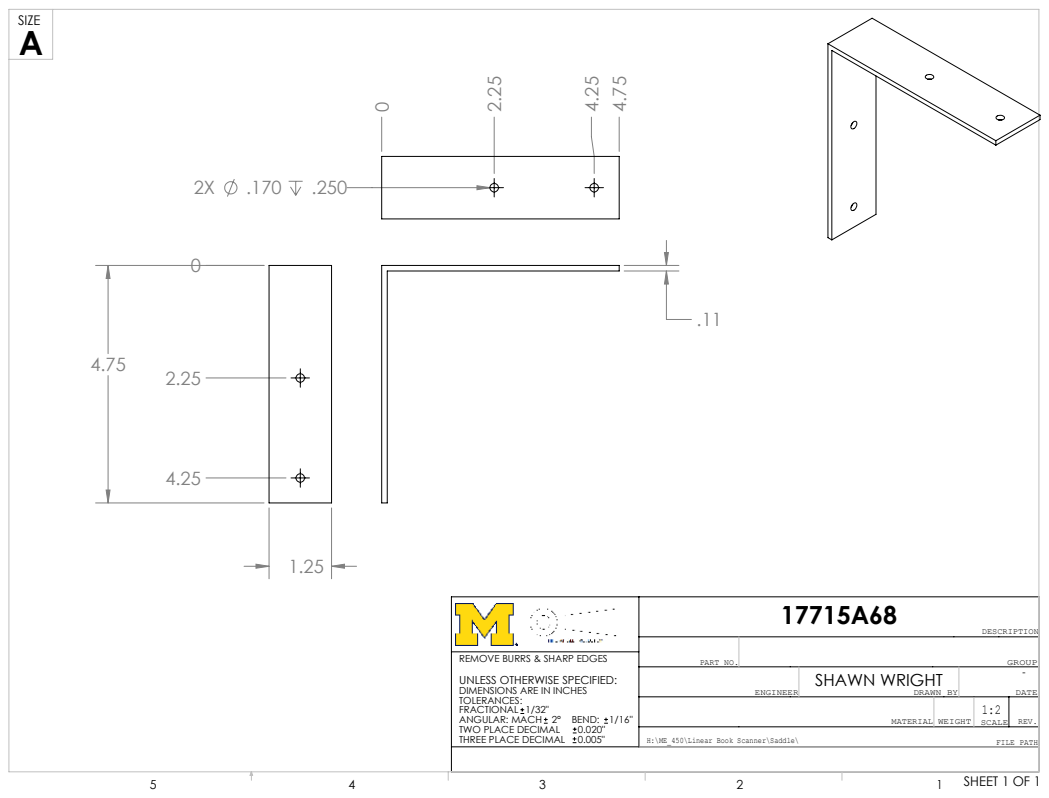
[picture p229: page 3]
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

H:\ME_450\Linear Book Scanner\Saddle\

6.00

A

DESCRIPTION; ENGINEER; PART NO.; MATERIAL; SCALE; REV.; DATE; WEIGHT; DRAWN BY; GROUP; Base Spacer; SHAWN WRIGHT; TWO PLACE DECIMAL

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

H:\ME_450\Linear Book Scanner\Base\

12.50

14.00

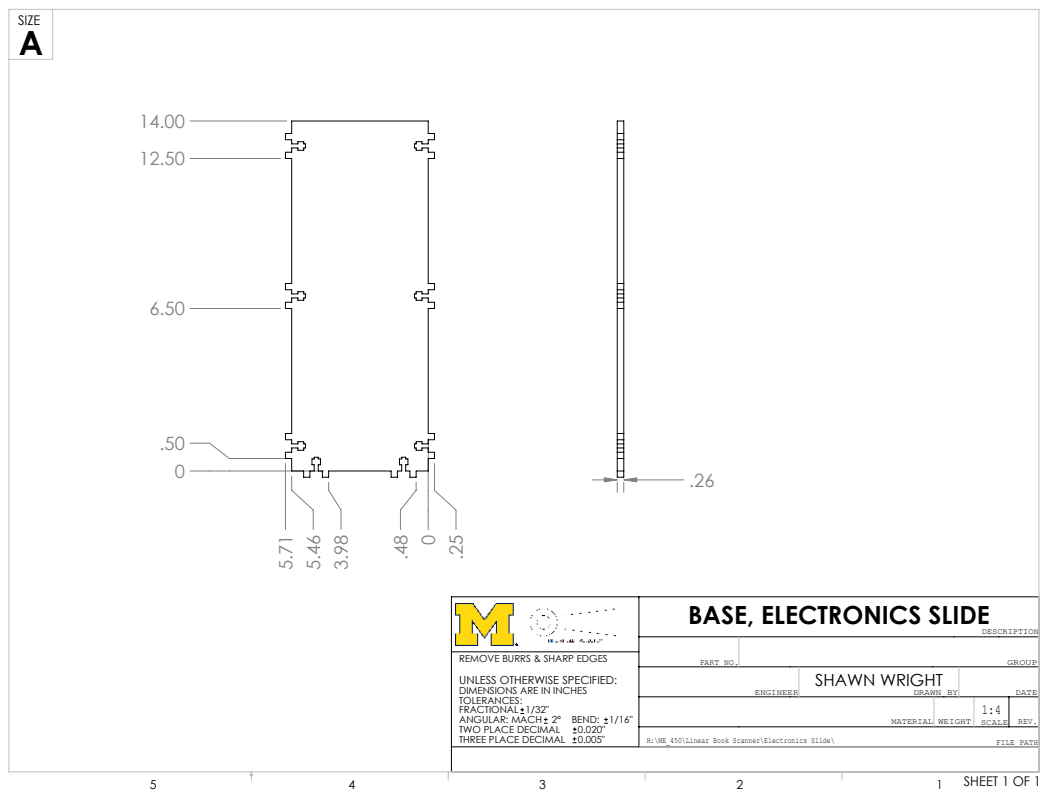
[picture p230: page 5]
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

BASE, ELECTRONICS SLIDE

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

H:\ME_450\Linear Book Scanner\Electronics Slide\

# .169 THRU

A

4-40 UNC; DESCRIPTION; ENGINEER; PART NO.; MATERIAL; SCALE; REV.; DATE; WEIGHT; DRAWN BY; GROUP; SHAWN WRIGHT; TWO PLACE DECIMAL

BELT MOUNT LOWER, SADDLE

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

H:\ME_450\Linear Book Scanner\Saddle\

4X | .116 THRU ALL
.169 THRU | .255 X 82° 0 .75 .65 .58 .50 | .15 1.00

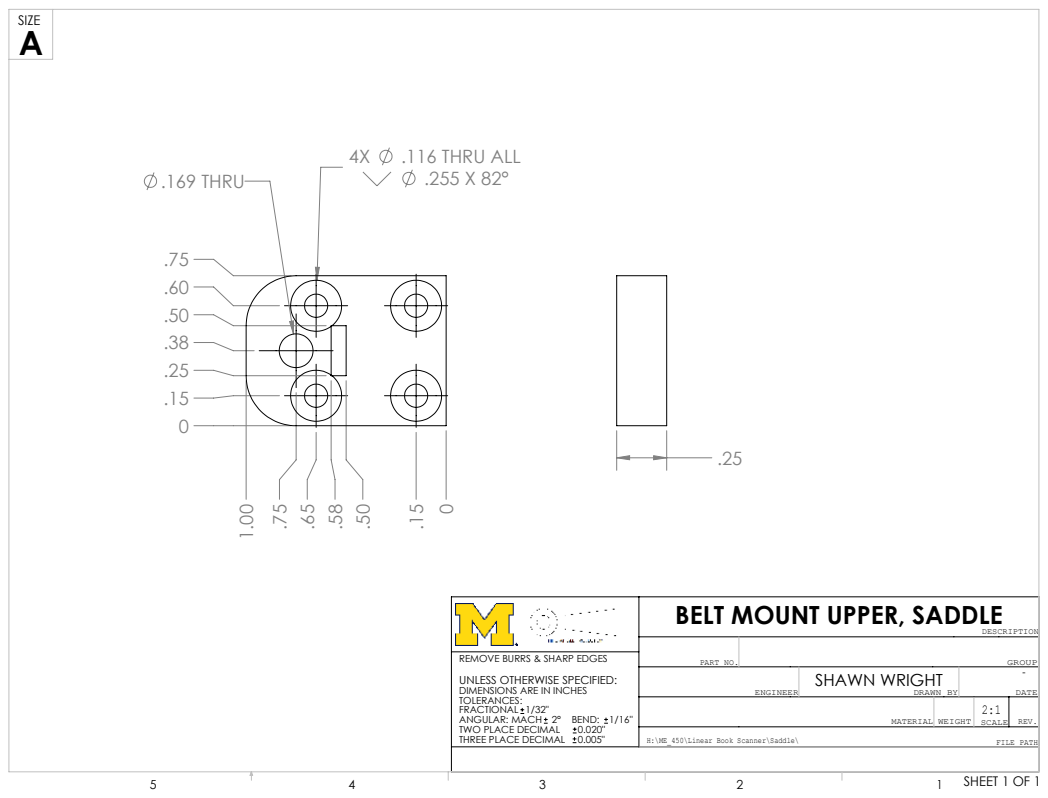
[picture p231: page 7]
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

BELT MOUNT UPPER, SADDLE

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

H:\ME_450\Linear Book Scanner\Saddle\

A

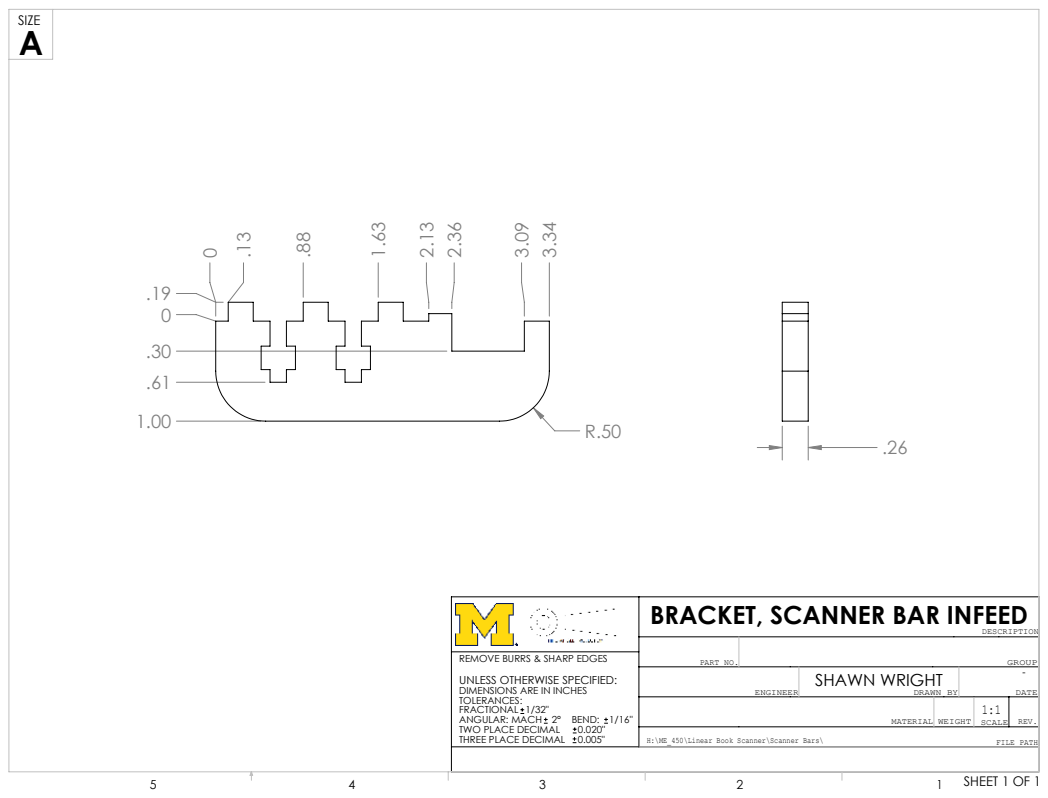
[picture p232: page 8]
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

BRACKET, SCANNER BAR INFEED

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

H:\ME_450\Linear Book Scanner\Scanner Bars\

A

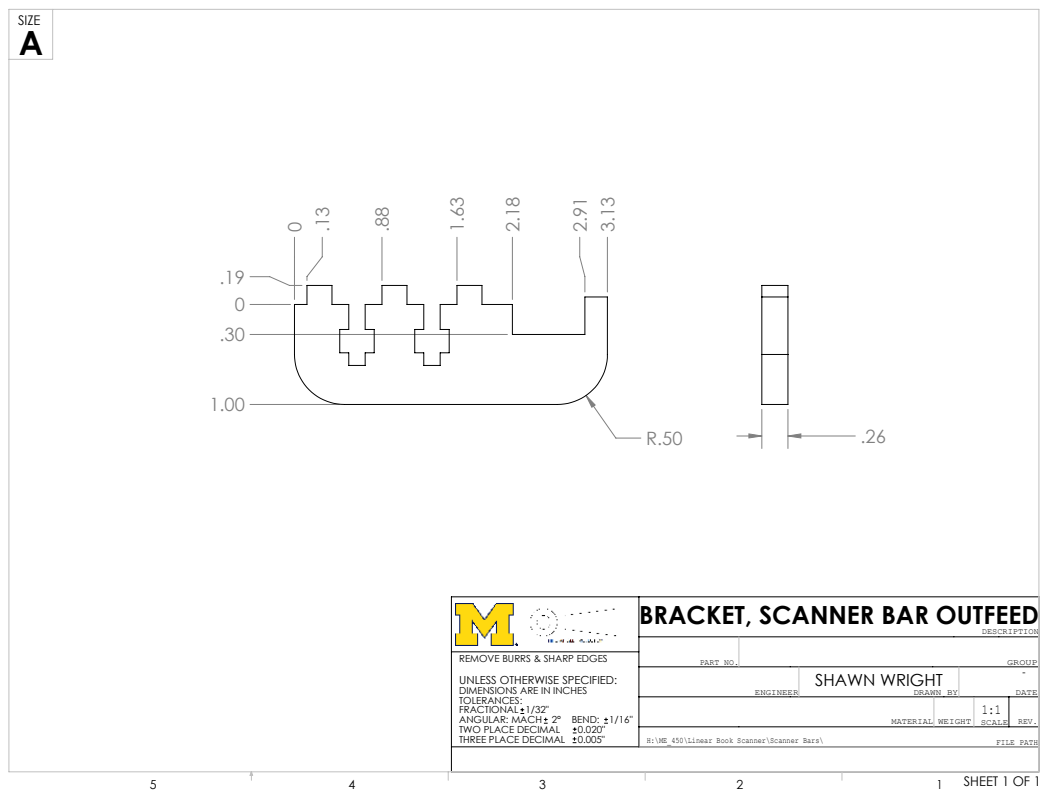
[picture p233: page 9]
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

BRACKET, SCANNER BAR OUTFEED

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

H:\ME_450\Linear Book Scanner\Scanner Bars\

R3.00 ⁰ .13

A

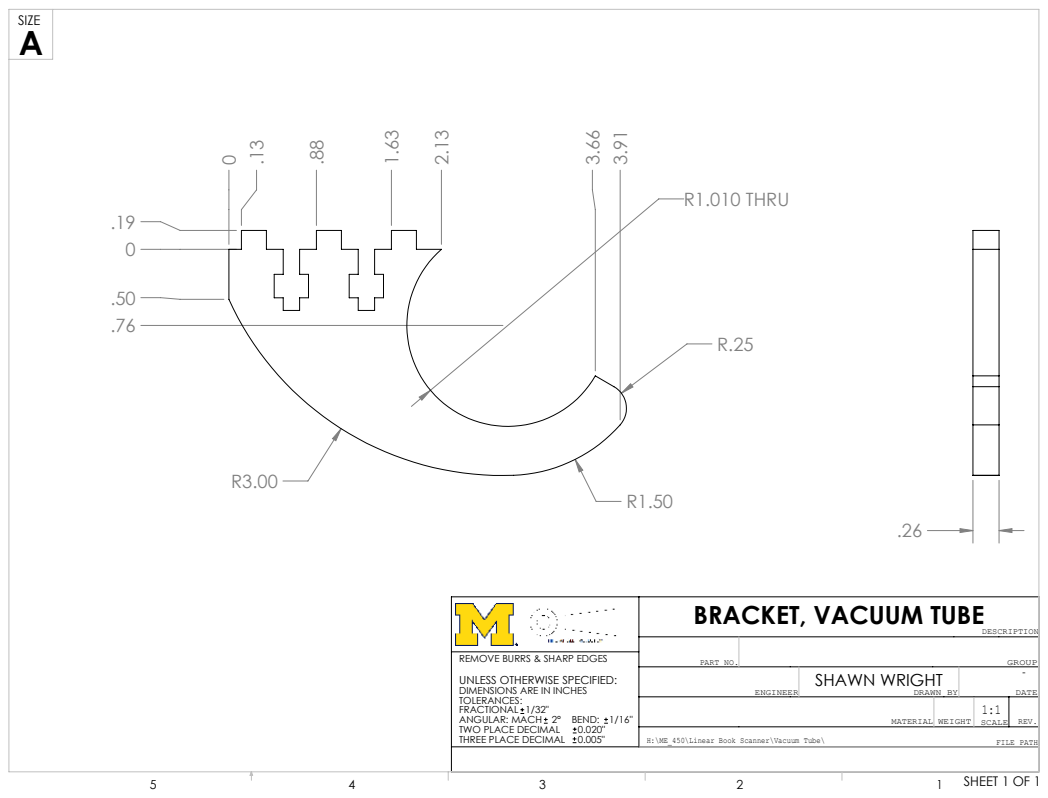
[picture p234: page 10]
R1.010 THRU; DESCRIPTION; ENGINEER; PART NO.; MATERIAL; SCALE; REV.; DATE; WEIGHT; DRAWN BY; GROUP; SHAWN WRIGHT; TWO PLACE DECIMAL

BRACKET, VACUUM TUBE

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

H:\ME_450\Linear Book Scanner\Vacuum Tube\

.17 .15

# 8X .17 THRU ALL

1.50 THRU; DESCRIPTION; ENGINEER; PART NO.; MATERIAL; SCALE; REV.; DATE; WEIGHT; DRAWN BY; GROUP; SHAWN WRIGHT; TWO PLACE DECIMAL

FACE, MOTOR MOUNT

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

H:\ME_450\Linear Book Scanner\Motor Mount\

# .620 THRU

# 4X .170 THRU ALL

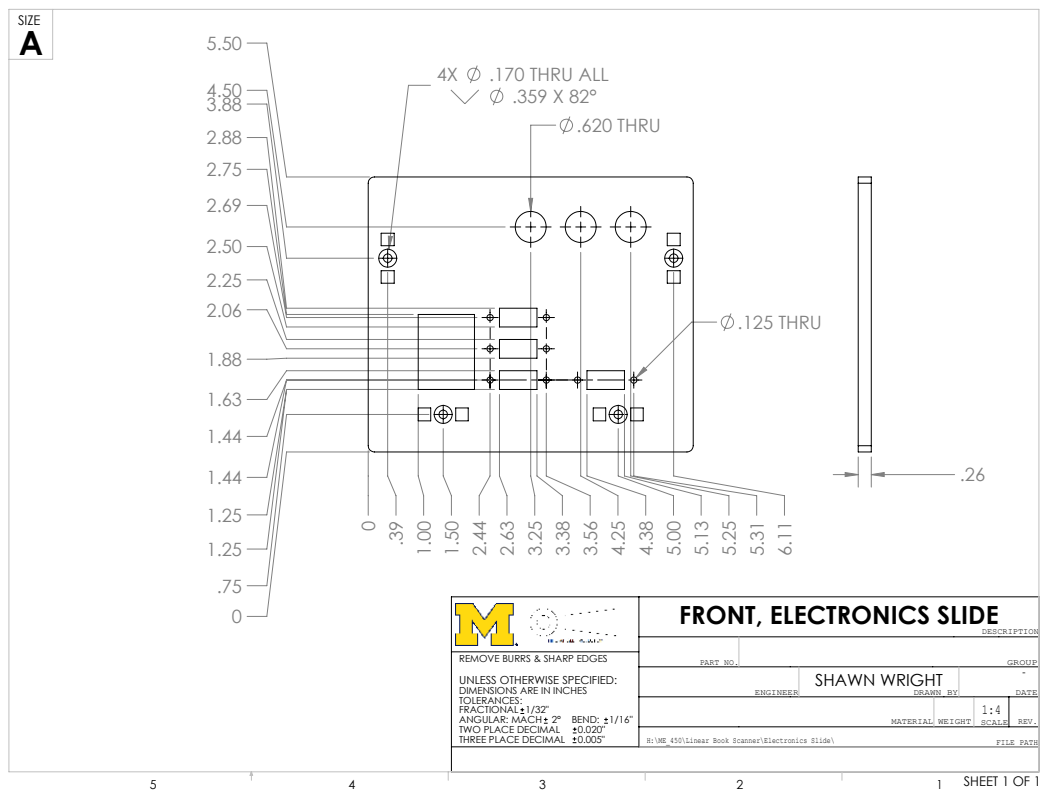
[picture p235: page 12]
.125 THRU; DESCRIPTION; ENGINEER; PART NO.; MATERIAL; SCALE; REV.; DATE; WEIGHT; DRAWN BY; GROUP; SHAWN WRIGHT; TWO PLACE DECIMAL

FRONT, ELECTRONICS SLIDE

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

H:\ME_450\Linear Book Scanner\Electronics Slide\

9.00

10.03

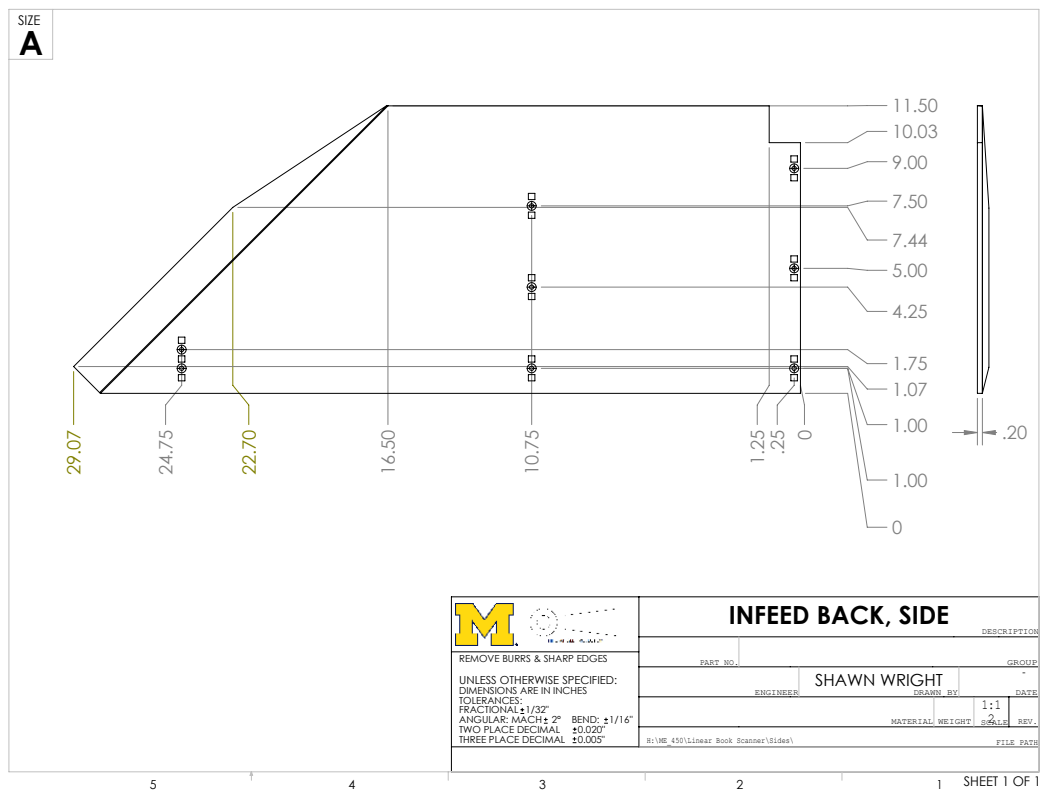
[picture p236: page 13]
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

INFEED BACK, SIDE

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

H:\ME_450\Linear Book Scanner\Sides\

0
.30

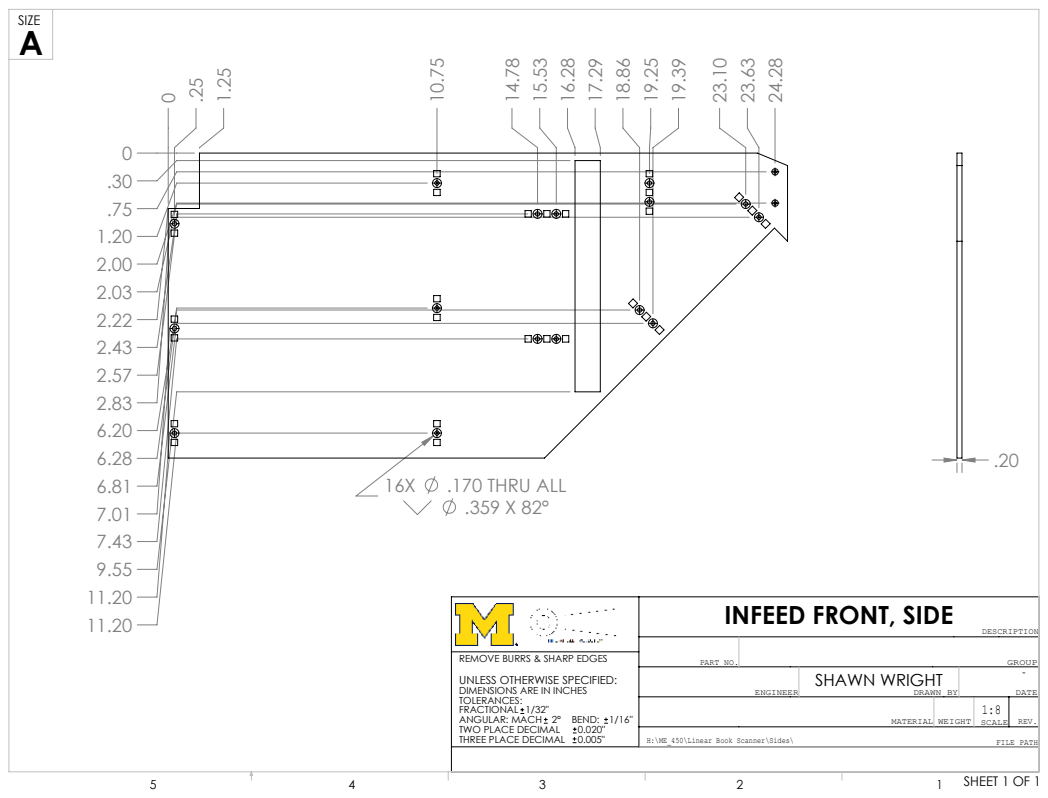
[picture p237: page 14]
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

INFEED FRONT, SIDE

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

H:\ME_450\Linear Book Scanner\Sides\

.20

A

1/4-20 Tapped Hole; DESCRIPTION; ENGINEER; PART NO.; MATERIAL; SCALE; REV.; DATE; WEIGHT; DRAWN BY; GROUP; SHAWN WRIGHT; TWO PLACE DECIMAL

INSIDE TUBE CAP, VACUUM TUBE

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

H:\ME_450\Linear Book Scanner\Vacuum Tube\

# 2X .089 THRU 4-40 UNC THRU

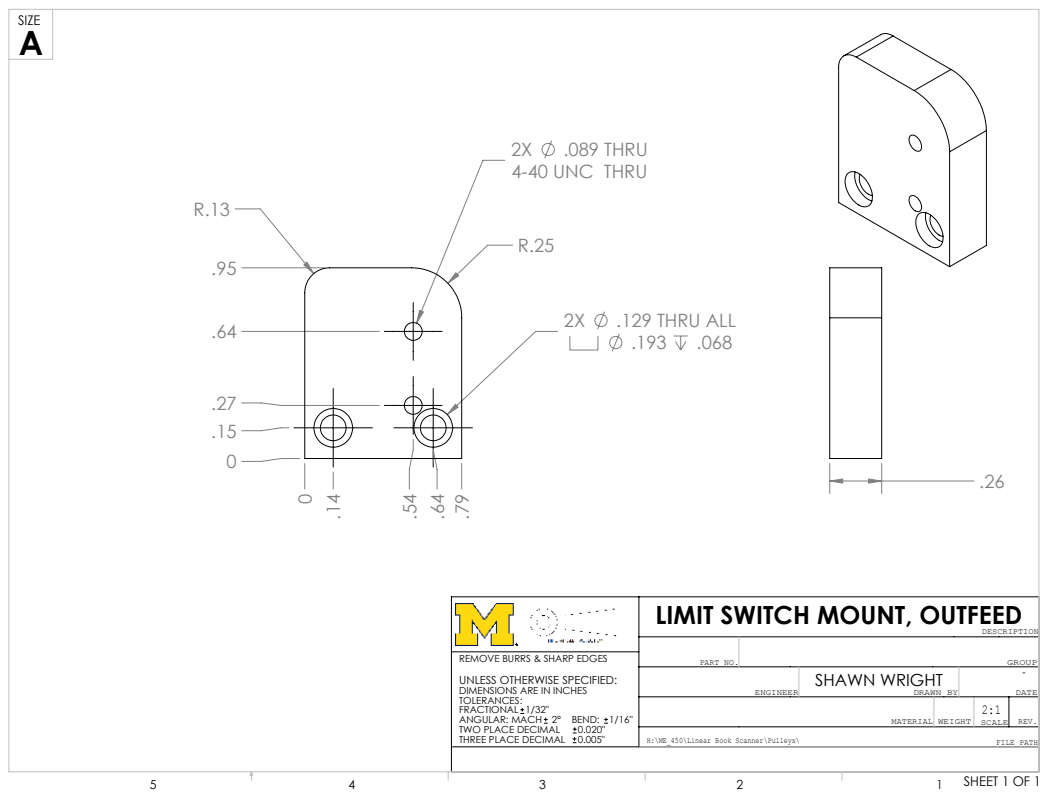
[picture p238: page 16]
.129 THRU ALL; DESCRIPTION; ENGINEER; PART NO.; MATERIAL; SCALE; REV.; DATE; WEIGHT; DRAWN BY; GROUP; SHAWN WRIGHT; TWO PLACE DECIMAL

LIMIT SWITCH MOUNT, OUTFEED

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

H:\ME_450\Linear Book Scanner\Pulleys\

2X | .201 .650
1/4-20 UNC | .500

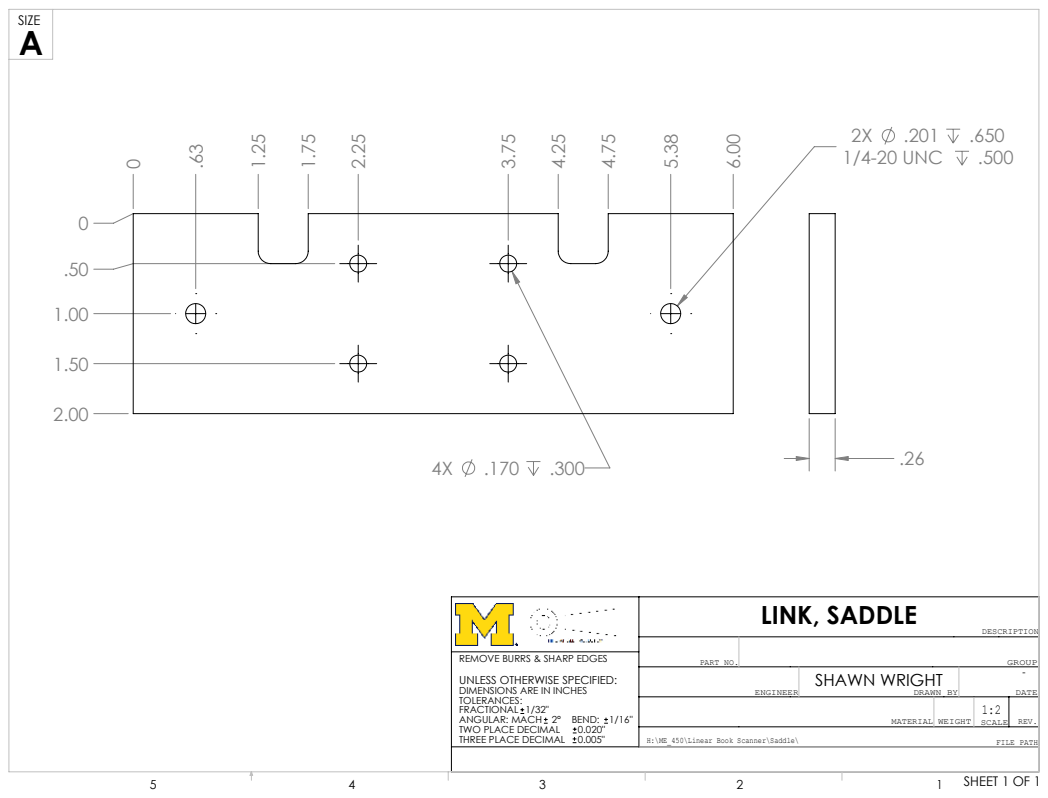
[picture p239: page 17]
DESCRIPTION; ENGINEER; PART NO.; MATERIAL; SCALE; REV.; WEIGHT; DRAWN BY; GROUP; LINK, SADDLE; SHAWN WRIGHT; TWO PLACE DECIMAL; DATE

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

H:\ME_450\Linear Book Scanner\Saddle\

# 6X .170 THRU ALL .359 X 82°

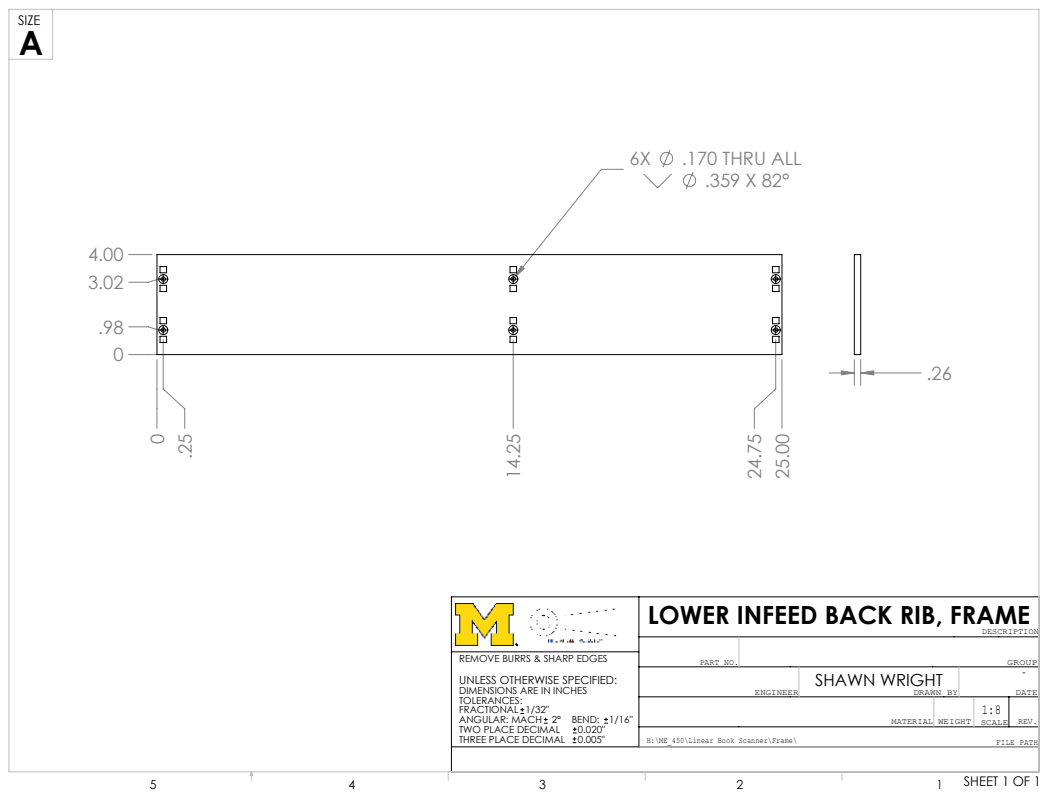
[picture p240: page 18]
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

LOWER INFEED BACK RIB, FRAME

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

H:\ME_450\Linear Book Scanner\Frame\

# 4X .170 THRU ALL .359 X 82°

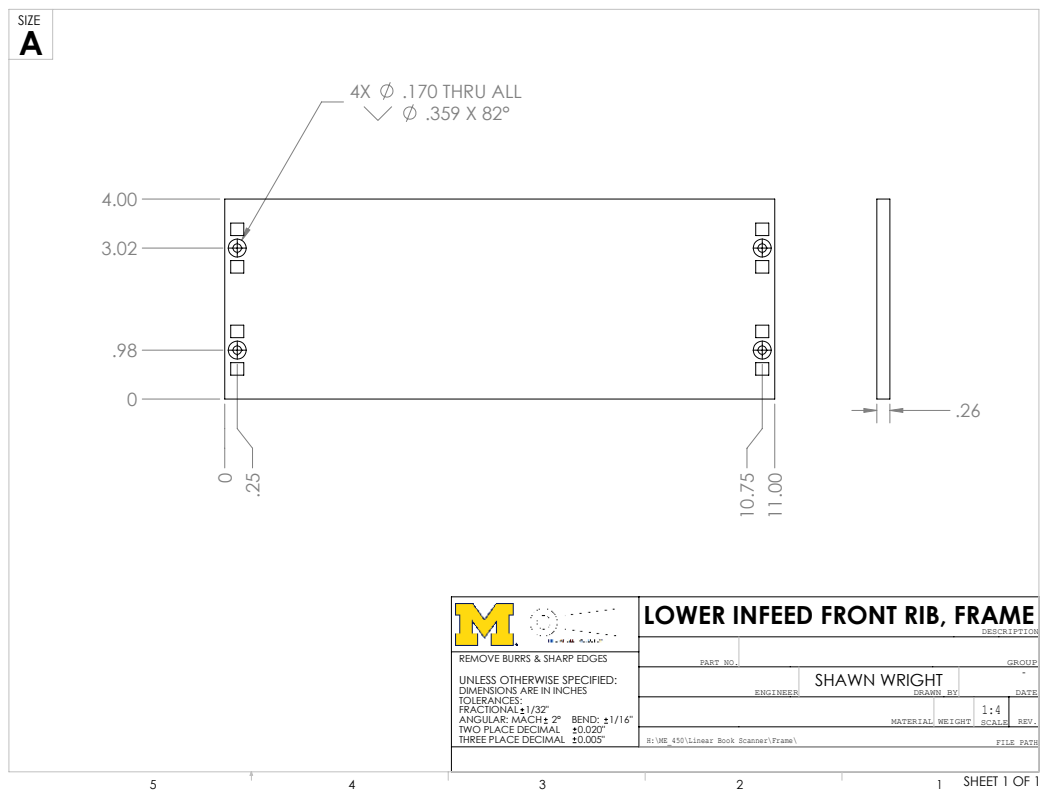
[picture p241: page 19]
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

LOWER INFEED FRONT RIB, FRAME

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

H:\ME_450\Linear Book Scanner\Frame\

A

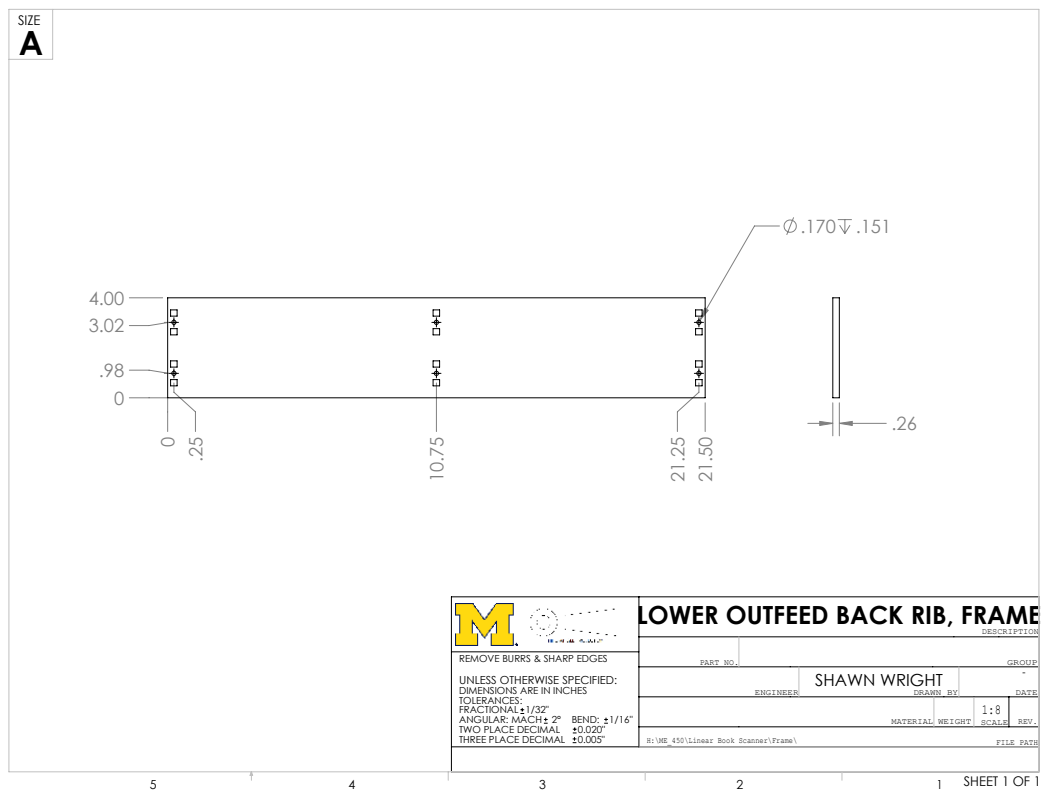
[picture p242: page 20]
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

LOWER OUTFEED BACK RIB, FRAME

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

H:\ME_450\Linear Book Scanner\Frame\

A

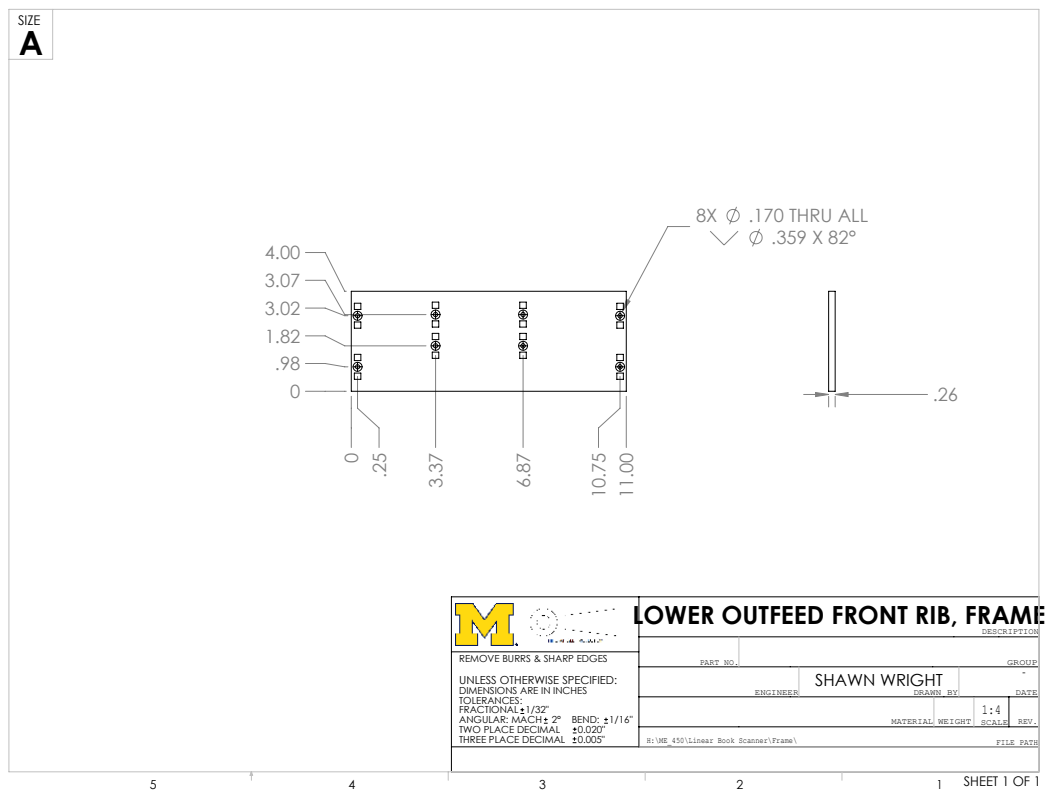
[picture p243: page 21]
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

LOWER OUTFEED FRONT RIB, FRAME

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

H:\ME_450\Linear Book Scanner\Frame\

R.50

4.75

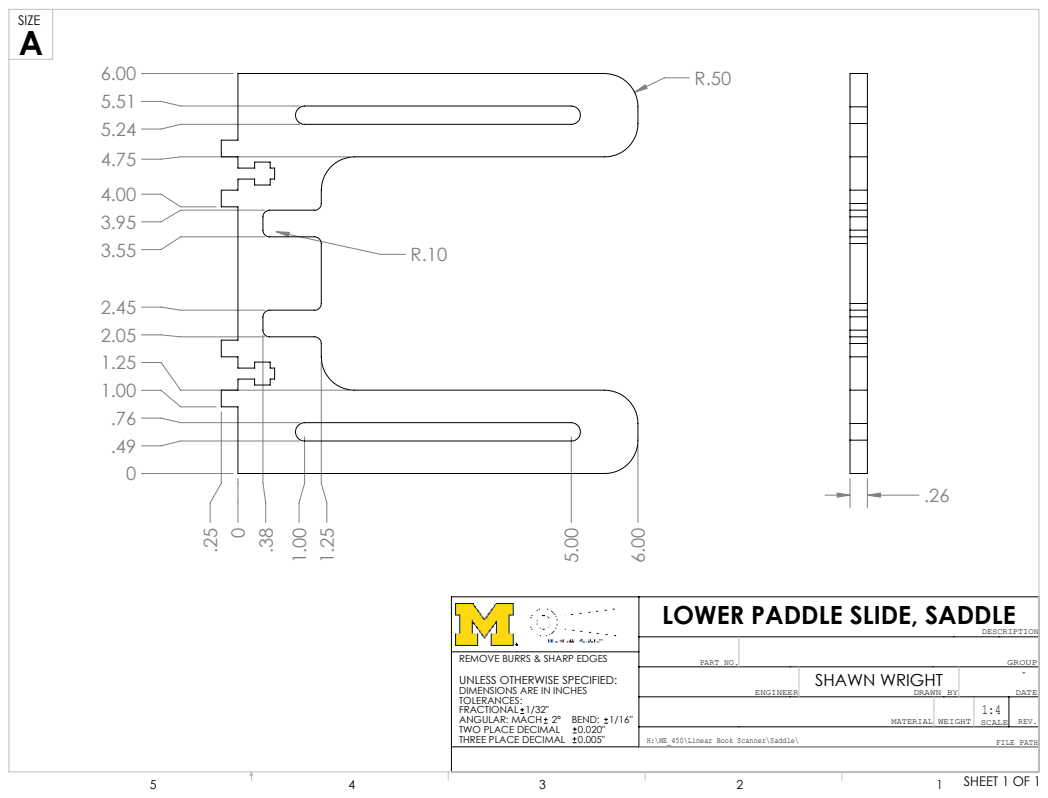
[picture p244: page 22]
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

LOWER PADDLE SLIDE, SADDLE

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

H:\ME_450\Linear Book Scanner\Saddle\

A

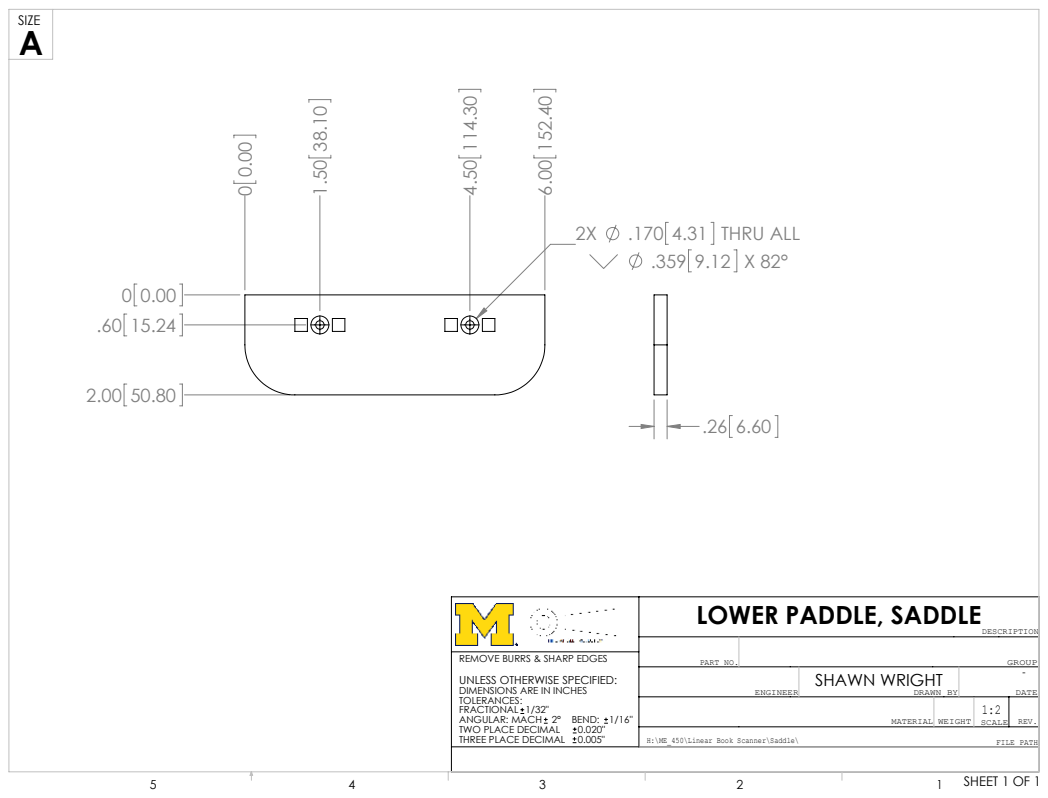
[picture p245: page 23]
.170 4.31 THRU ALL; DESCRIPTION; ENGINEER; PART NO.; MATERIAL; SCALE; REV.; DATE; WEIGHT; DRAWN BY; GROUP; SHAWN WRIGHT; TWO PLACE DECIMAL

LOWER PADDLE, SADDLE

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

H:\ME_450\Linear Book Scanner\Saddle\

R.13 | R.25 .375 THRU

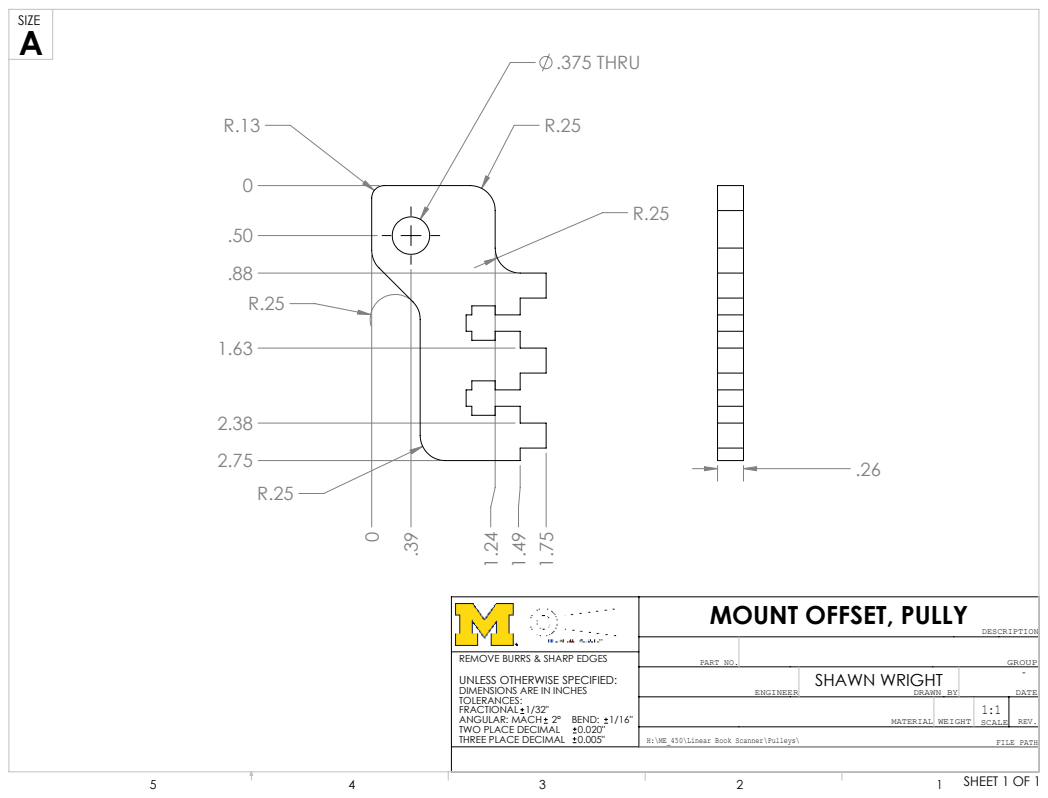
[picture p246: page 24]
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

MOUNT OFFSET, PULLY

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

H:\ME_450\Linear Book Scanner\Pulleys\

R.13

A

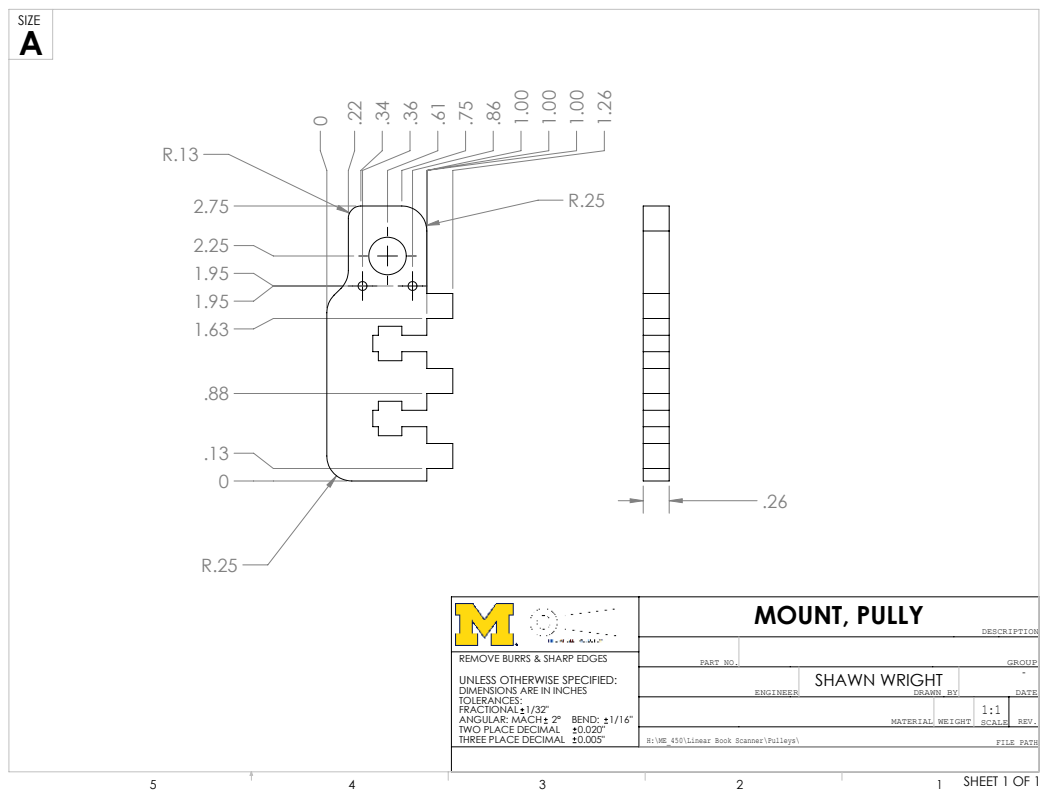
[picture p247: page 25]
DESCRIPTION; ENGINEER; PART NO.; MATERIAL; SCALE; REV.; DATE; WEIGHT; DRAWN BY; GROUP; MOUNT, PULLY; SHAWN WRIGHT; TWO PLACE DECIMAL

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

H:\ME_450\Linear Book Scanner\Pulleys\

A

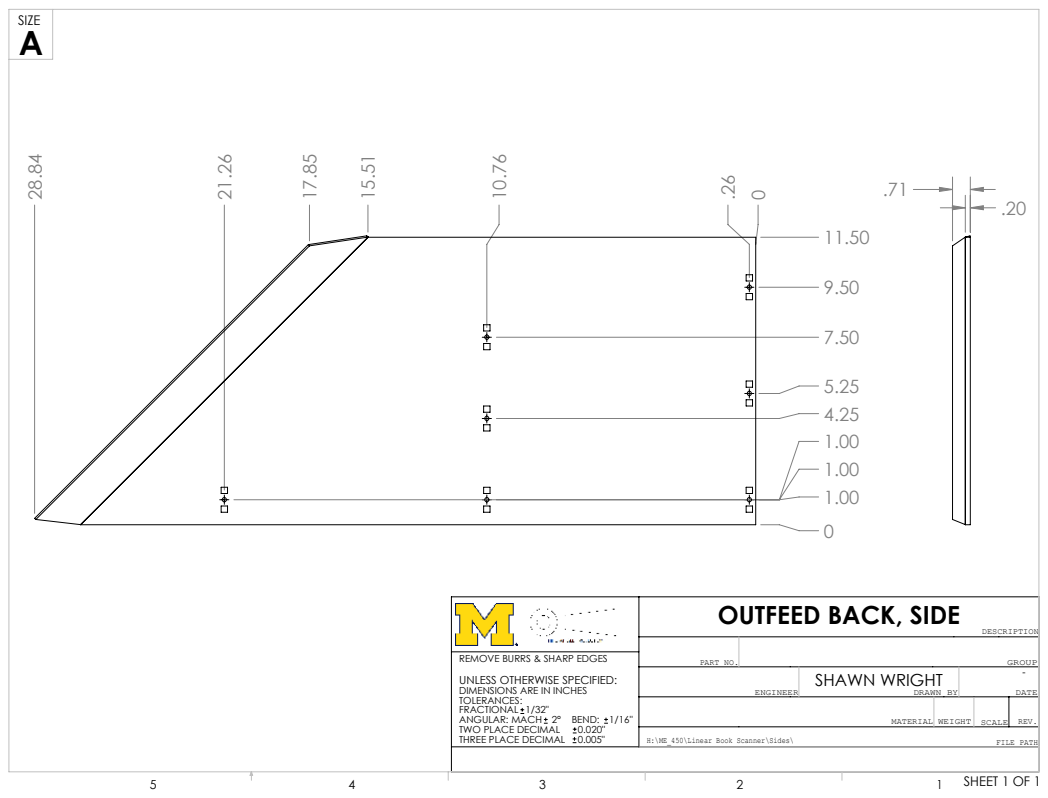
[picture p248: page 26]
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

OUTFEED BACK, SIDE

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

H:\ME_450\Linear Book Scanner\Sides\

.170 .091
0

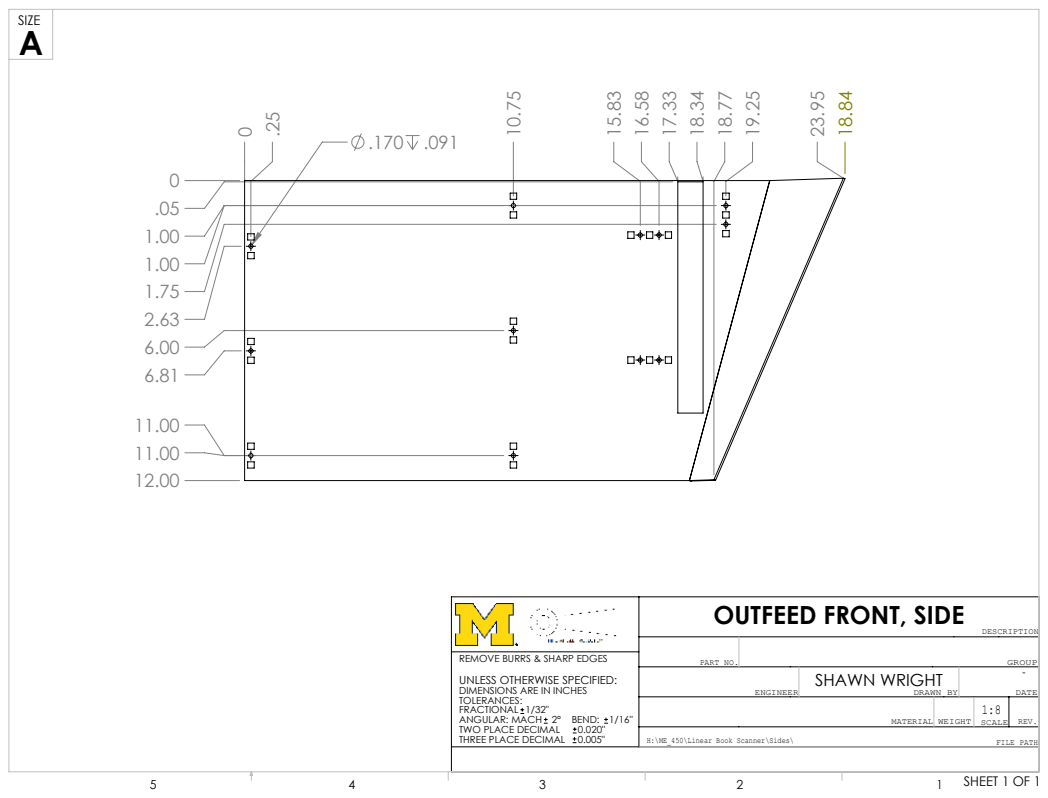
[picture p249: page 27]
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

OUTFEED FRONT, SIDE

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

H:\ME_450\Linear Book Scanner\Sides\

A

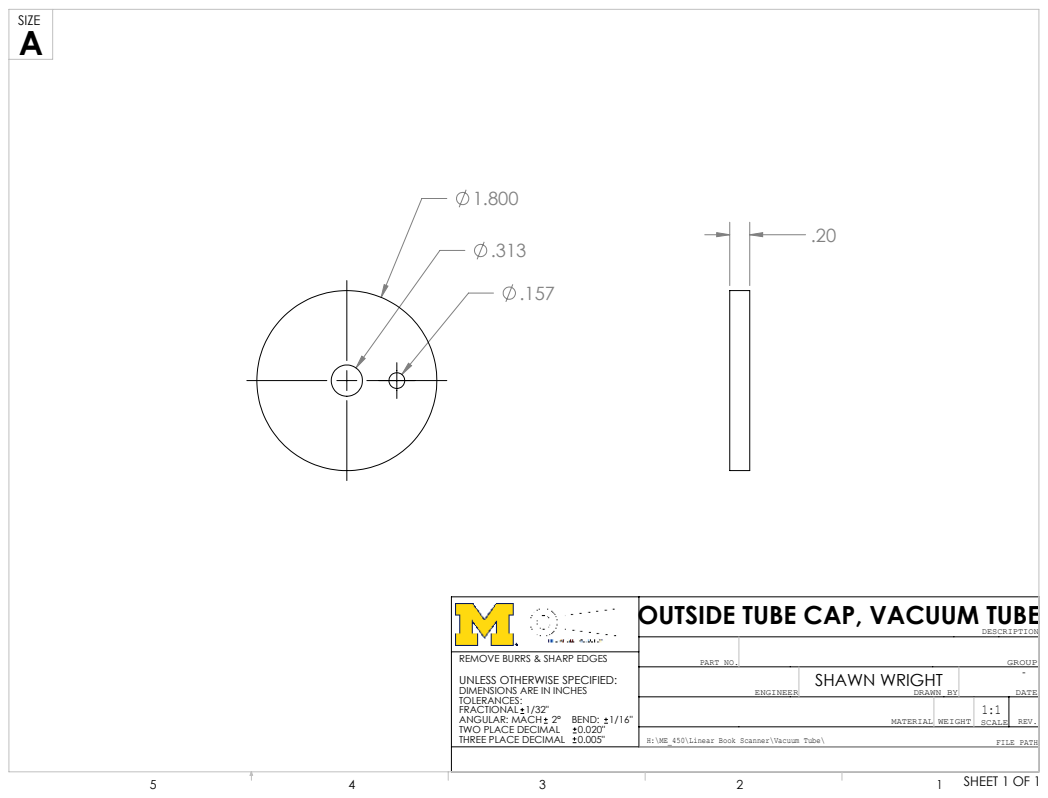
[picture p250: page 28]
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

OUTSIDE TUBE CAP, VACUUM TUBE

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

H:\ME_450\Linear Book Scanner\Vacuum Tube\

1.14 29.02

A

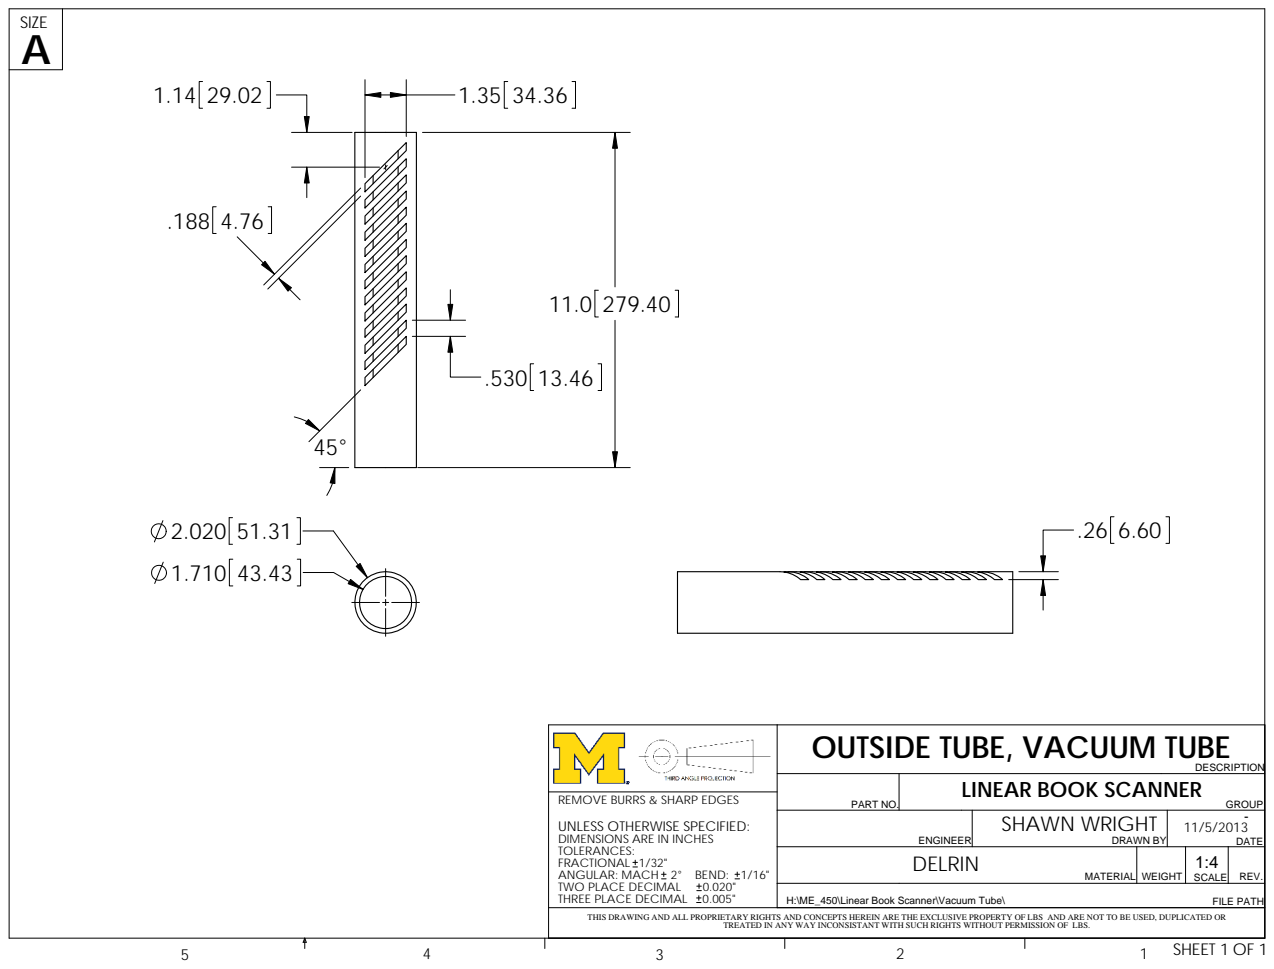
[picture p251: page 29]
DESCRIPTION; PART NO.; GROUP; TWO PLACE DECIMAL

OUTSIDE TUBE, VACUUM TUBE

LINEAR BOOK SCANNER

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

ENGINEER | SHAWN WRIGHT DRAWN BY | -11/5/2013 DATE
DELRIN MATERIAL | WEIGHT | 1:4 SCALE | REV.

H:\ME_450\Linear Book Scanner\Vacuum Tube\

THIS DRAWING AND ALL PROPRIETARY RIGHTS AND CONCEPTS HEREIN ARE THE EXCLUSIVE PROPERTY OF LBS AND ARE NOT TO BE USED, DUPLICATED OR

TREATED IN ANY WAY INCONSISTANT WITH SUCH RIGHTS WITHOUT PERMISSION OF LBS.

A

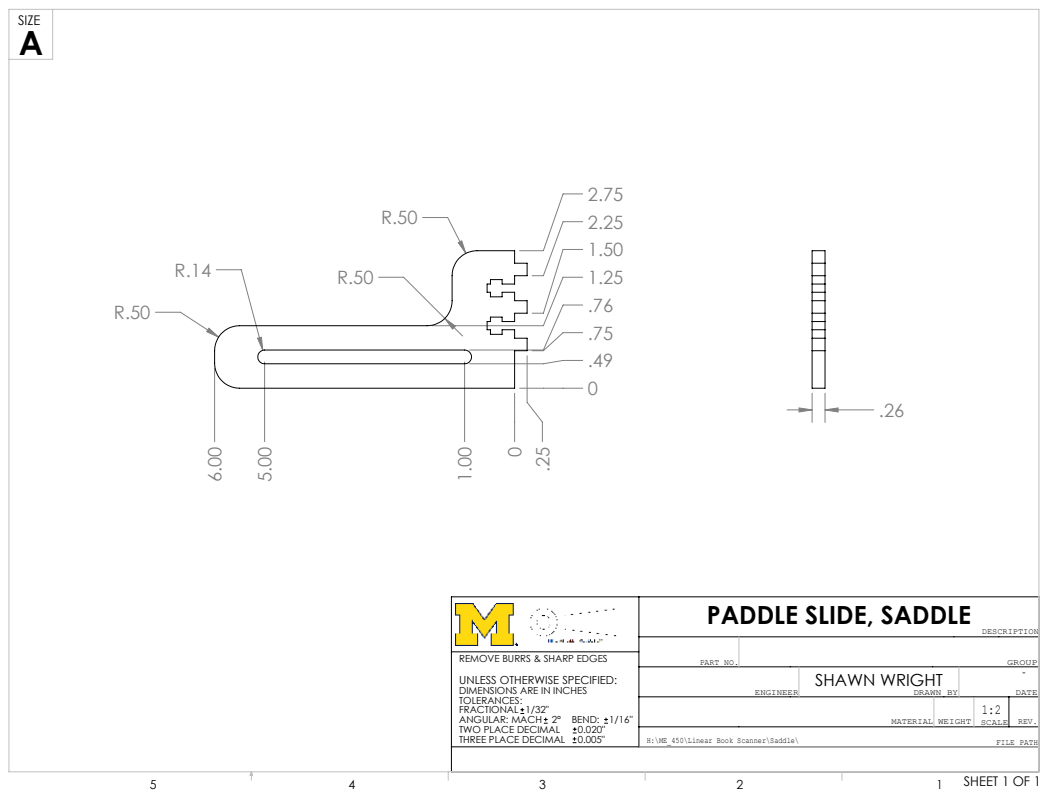
[picture p252: page 30]
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

PADDLE SLIDE, SADDLE

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

H:\ME_450\Linear Book Scanner\Saddle\

16.97

# 4X .170 THRU ALL

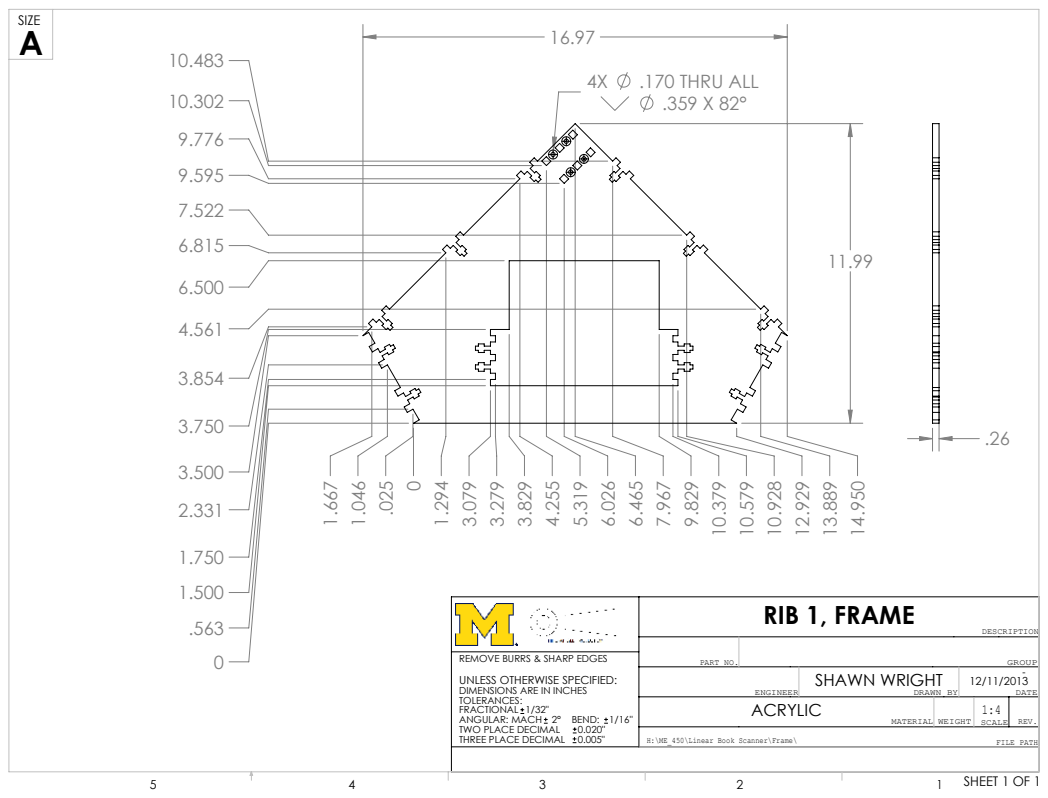
[picture p253: page 31]
DESCRIPTION; ENGINEER; PART NO.; MATERIAL; SCALE; REV.; DATE; WEIGHT; DRAWN BY; GROUP; RIB 1, FRAME; ACRYLIC; TWO PLACE DECIMAL; SHAWN WRIGHT

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

H:\ME_450\Linear Book Scanner\Frame\

11.99

A

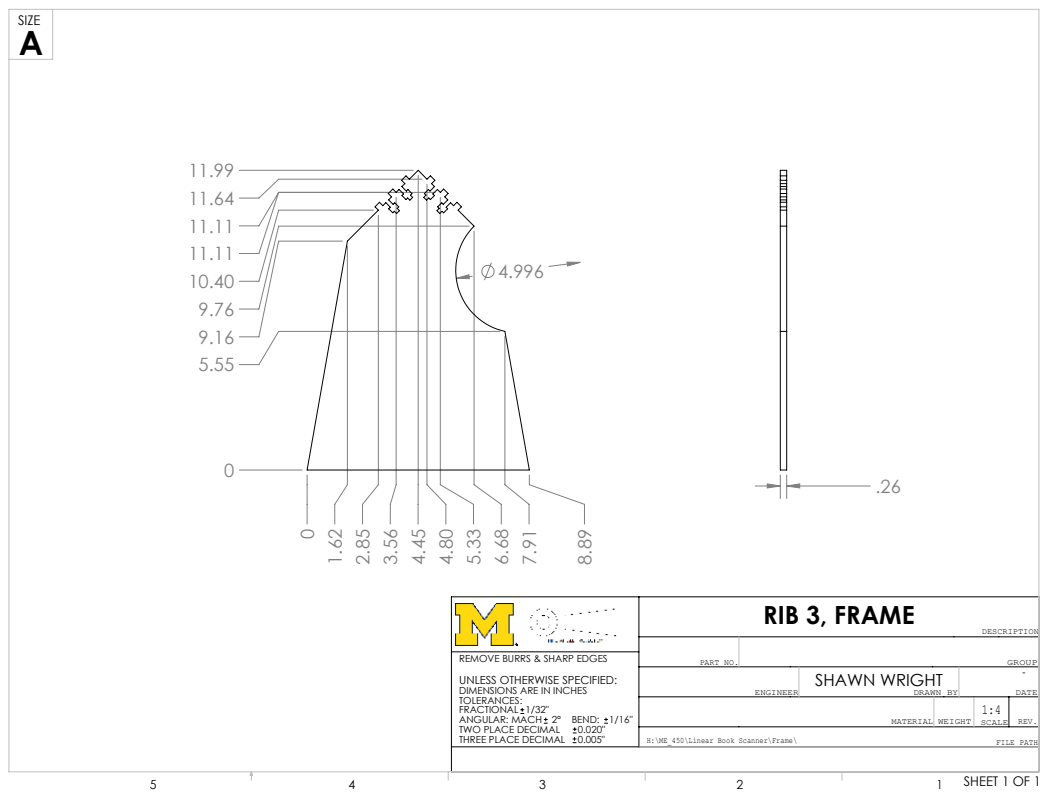
[picture p254: page 32]
DESCRIPTION; ENGINEER; PART NO.; MATERIAL; SCALE; REV.; WEIGHT; DRAWN BY; GROUP; RIB 3, FRAME; SHAWN WRIGHT; TWO PLACE DECIMAL; DATE

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

H:\ME_450\Linear Book Scanner\Frame\

A

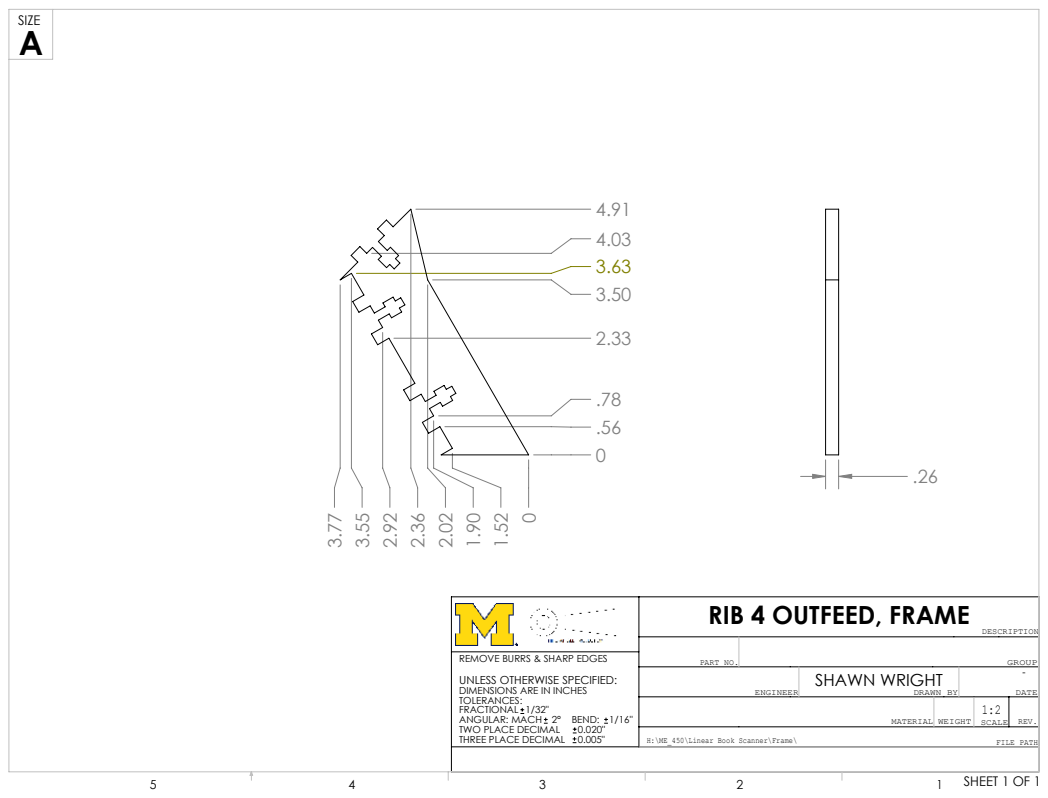
[picture p255: page 33]
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

RIB 4 OUTFEED, FRAME

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

H:\ME_450\Linear Book Scanner\Frame\

3.00

A

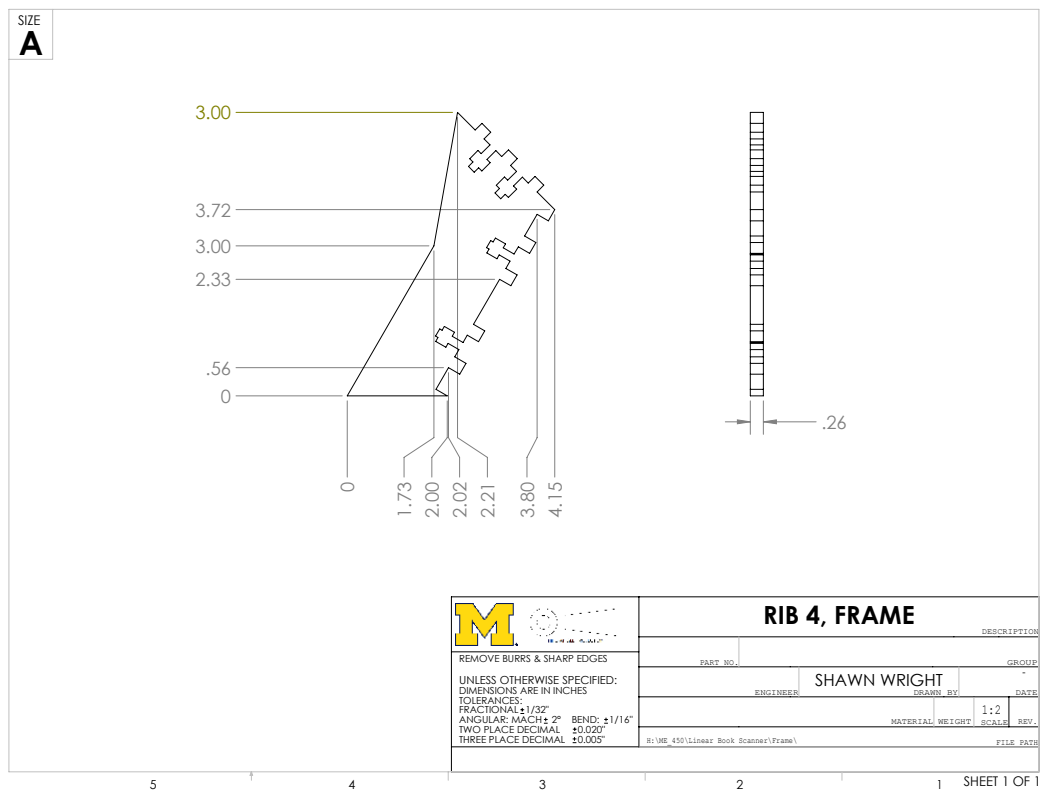
[picture p256: page 34]
DESCRIPTION; ENGINEER; PART NO.; MATERIAL; SCALE; REV.; DATE; WEIGHT; DRAWN BY; GROUP; RIB 4, FRAME; SHAWN WRIGHT; TWO PLACE DECIMAL

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

H:\ME_450\Linear Book Scanner\Frame\

11.36

A

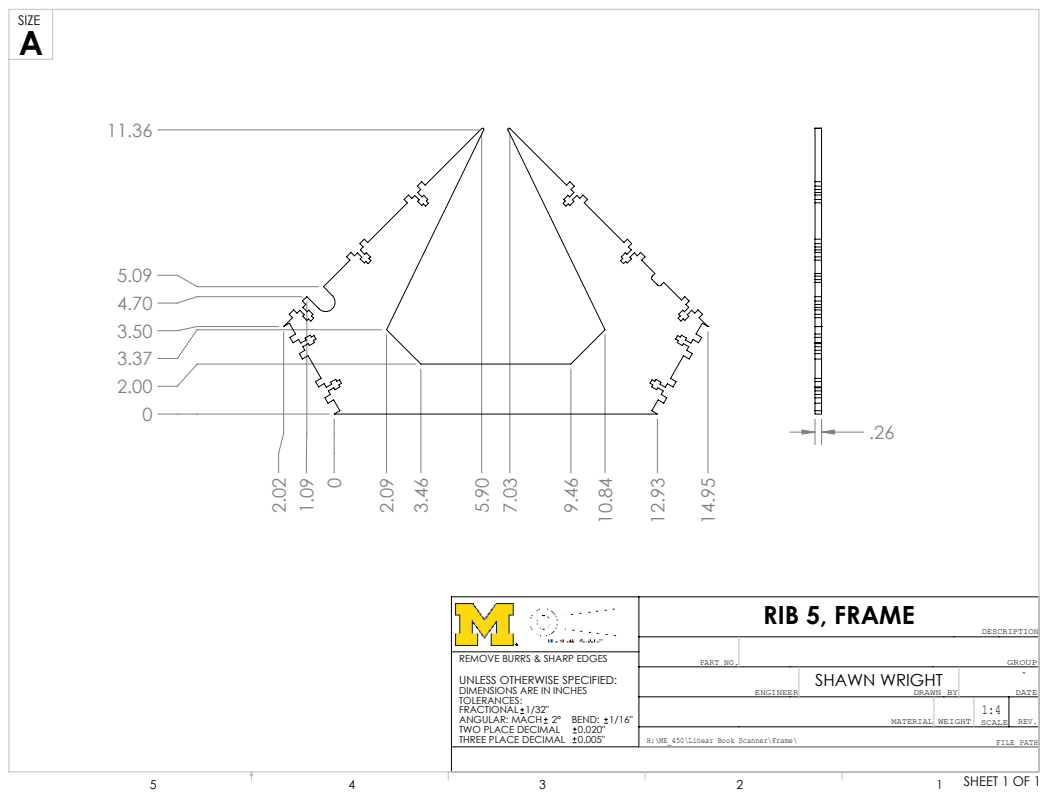
[picture p257: page 35]
DESCRIPTION; ENGINEER; PART NO.; MATERIAL; SCALE; REV.; DATE; WEIGHT; DRAWN BY; GROUP; RIB 5, FRAME; SHAWN WRIGHT; TWO PLACE DECIMAL

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

H:\ME_450\Linear Book Scanner\Frame\

11.81
10.04

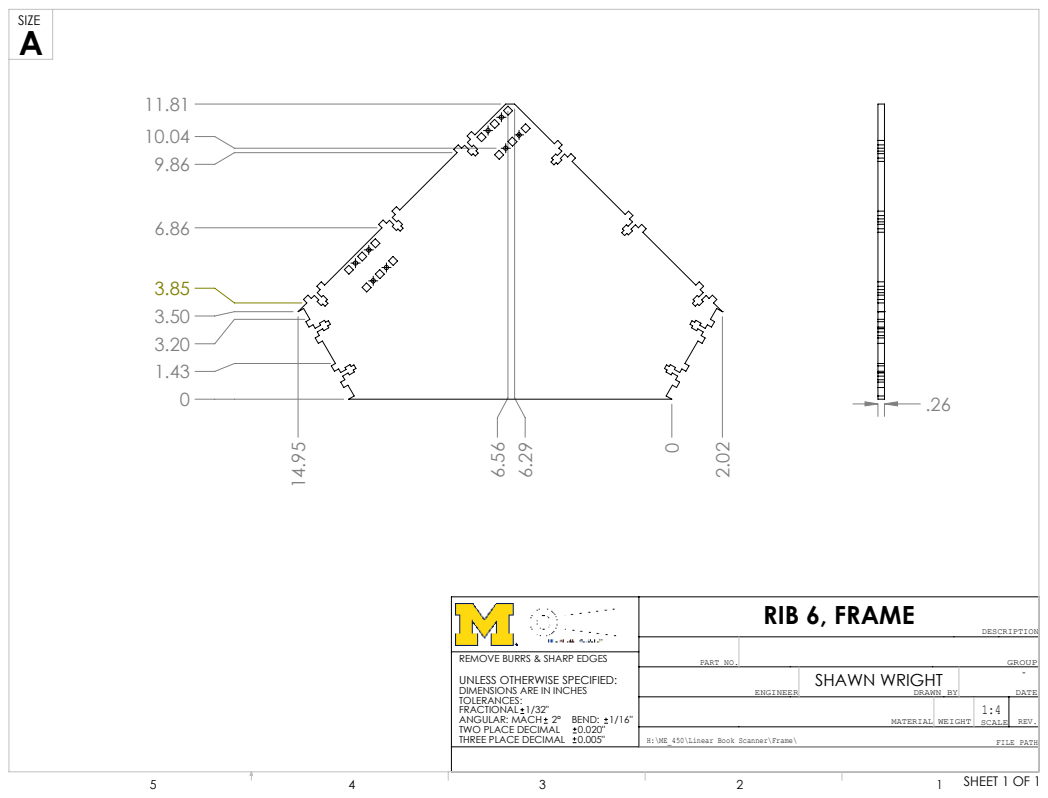
[picture p258: page 36]
DESCRIPTION; ENGINEER; PART NO.; MATERIAL; SCALE; REV.; DATE; WEIGHT; DRAWN BY; GROUP; RIB 6, FRAME; SHAWN WRIGHT; TWO PLACE DECIMAL

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

H:\ME_450\Linear Book Scanner\Frame\

2X | .089 .299
4-40 UNC | .224

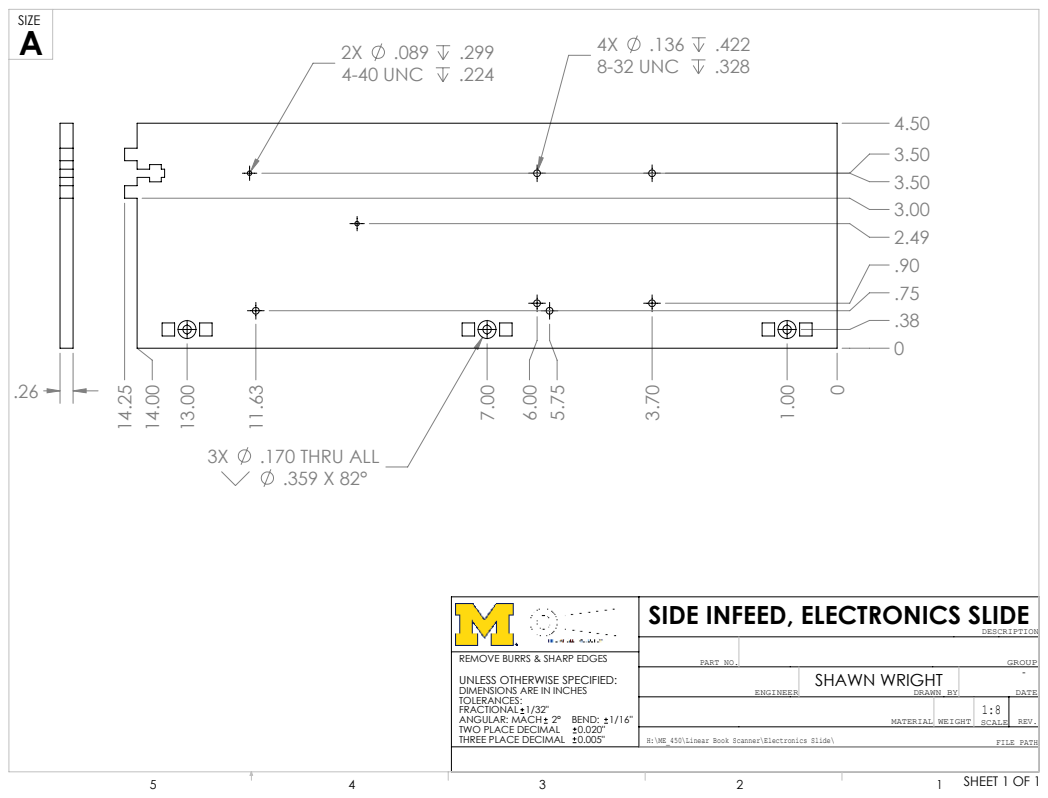
[picture p259: page 37]
8-32 UNC; .170 THRU ALL; DESCRIPTION; ENGINEER; PART NO.; MATERIAL; SCALE; REV.; DATE; WEIGHT; DRAWN BY; GROUP; SHAWN WRIGHT; TWO PLACE DECIMAL

SIDE INFEED, ELECTRONICS SLIDE

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

H:\ME_450\Linear Book Scanner\Electronics Slide\

R1.00

10.00

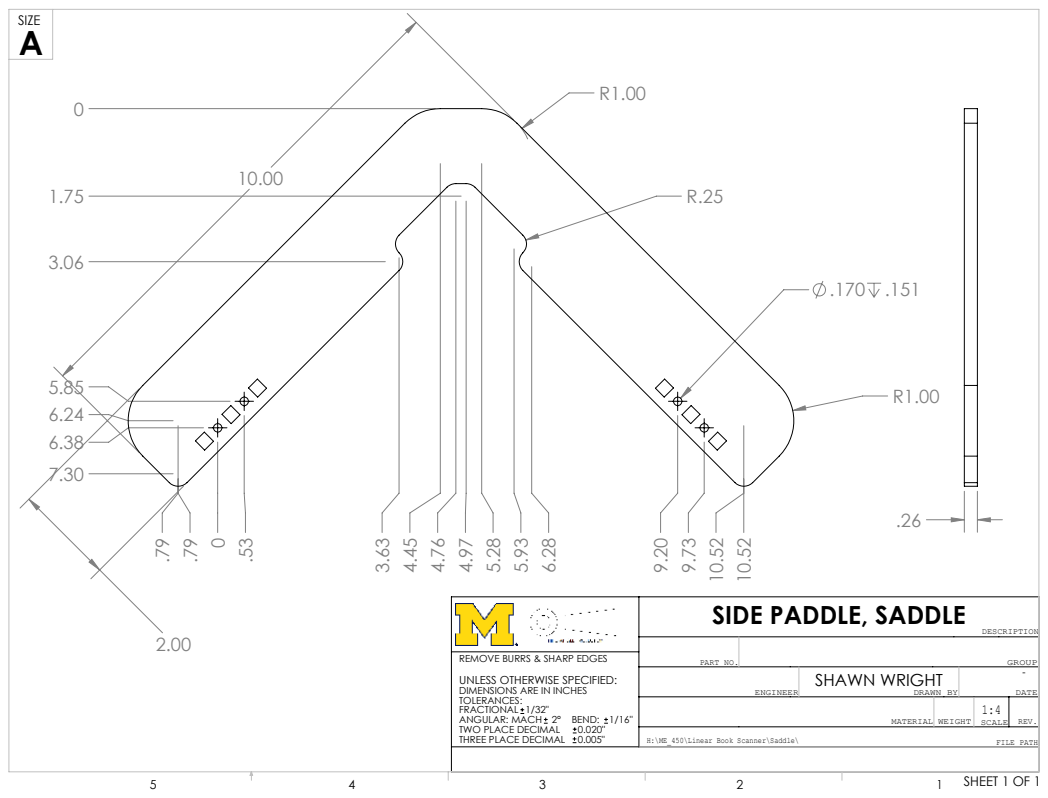
[picture p260: page 38]
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

SIDE PADDLE, SADDLE

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

H:\ME_450\Linear Book Scanner\Saddle\

0

A

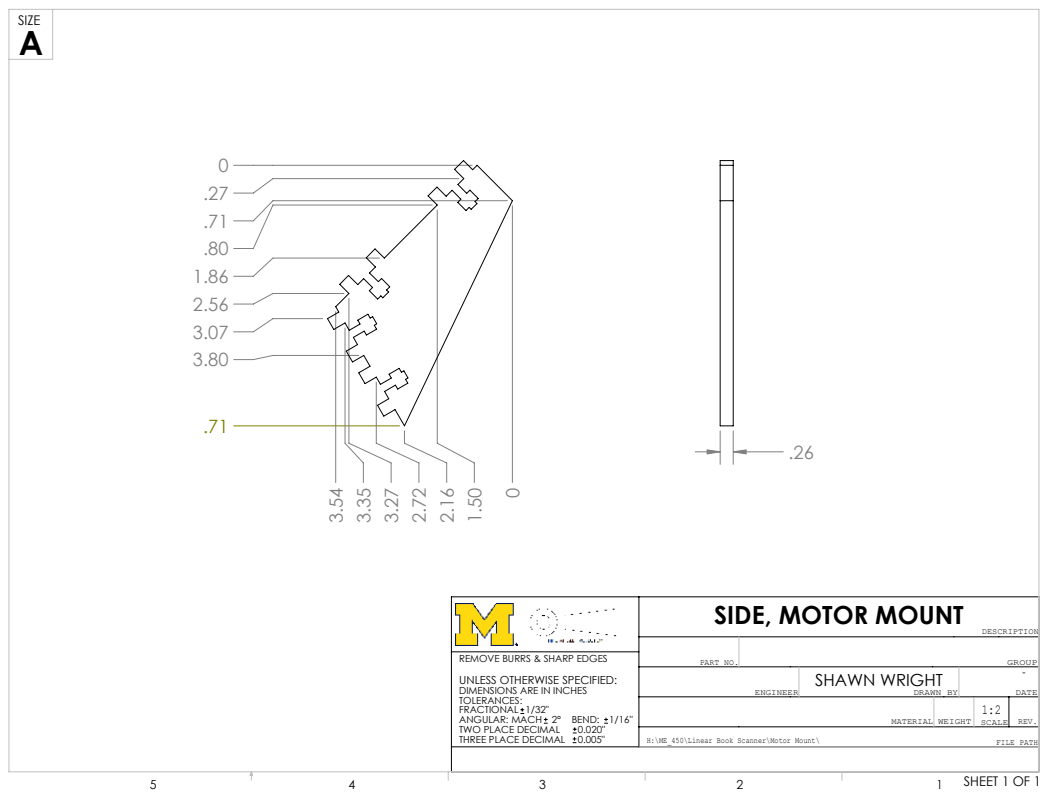
[picture p261: page 39]
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

SIDE, MOTOR MOUNT

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

H:\ME_450\Linear Book Scanner\Motor Mount\

7.52

8.75

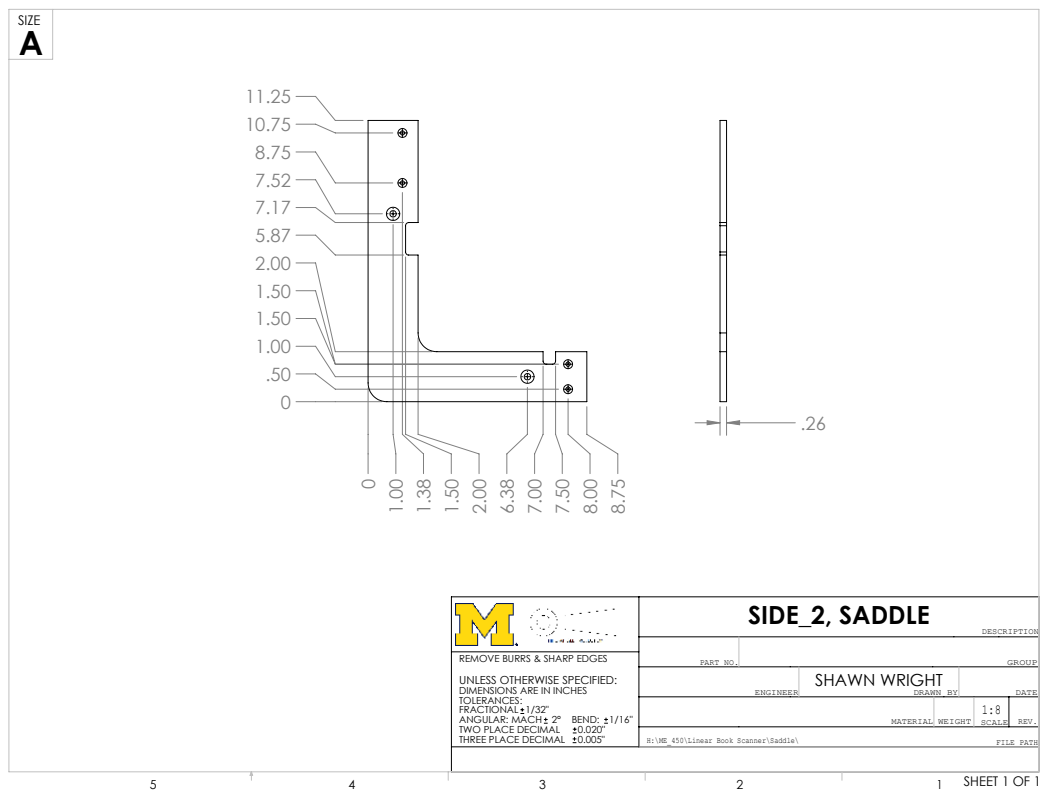
[picture p262: page 40]
DESCRIPTION; ENGINEER; PART NO.; MATERIAL; SCALE; REV.; DATE; WEIGHT; DRAWN BY; GROUP; SIDE_2, SADDLE; SHAWN WRIGHT; TWO PLACE DECIMAL

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

H:\ME_450\Linear Book Scanner\Saddle\

A

8-32 UNC; DESCRIPTION; ENGINEER; PART NO.; MATERIAL; SCALE; REV.; DATE; WEIGHT; DRAWN BY; GROUP; SHAWN WRIGHT; TWO PLACE DECIMAL

SLIDE MOUNT INFEED, ELECTRONICS SLIDE

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

H:\ME_450\Linear Book Scanner\Electronics Slide\
