wrightsh/Michigan-Linear-Book-Scanner/CAD/Linear Book Scanner/Laser Cut Layouts/Acrylic_1 - Sheet1.pdf

A

# SIZE

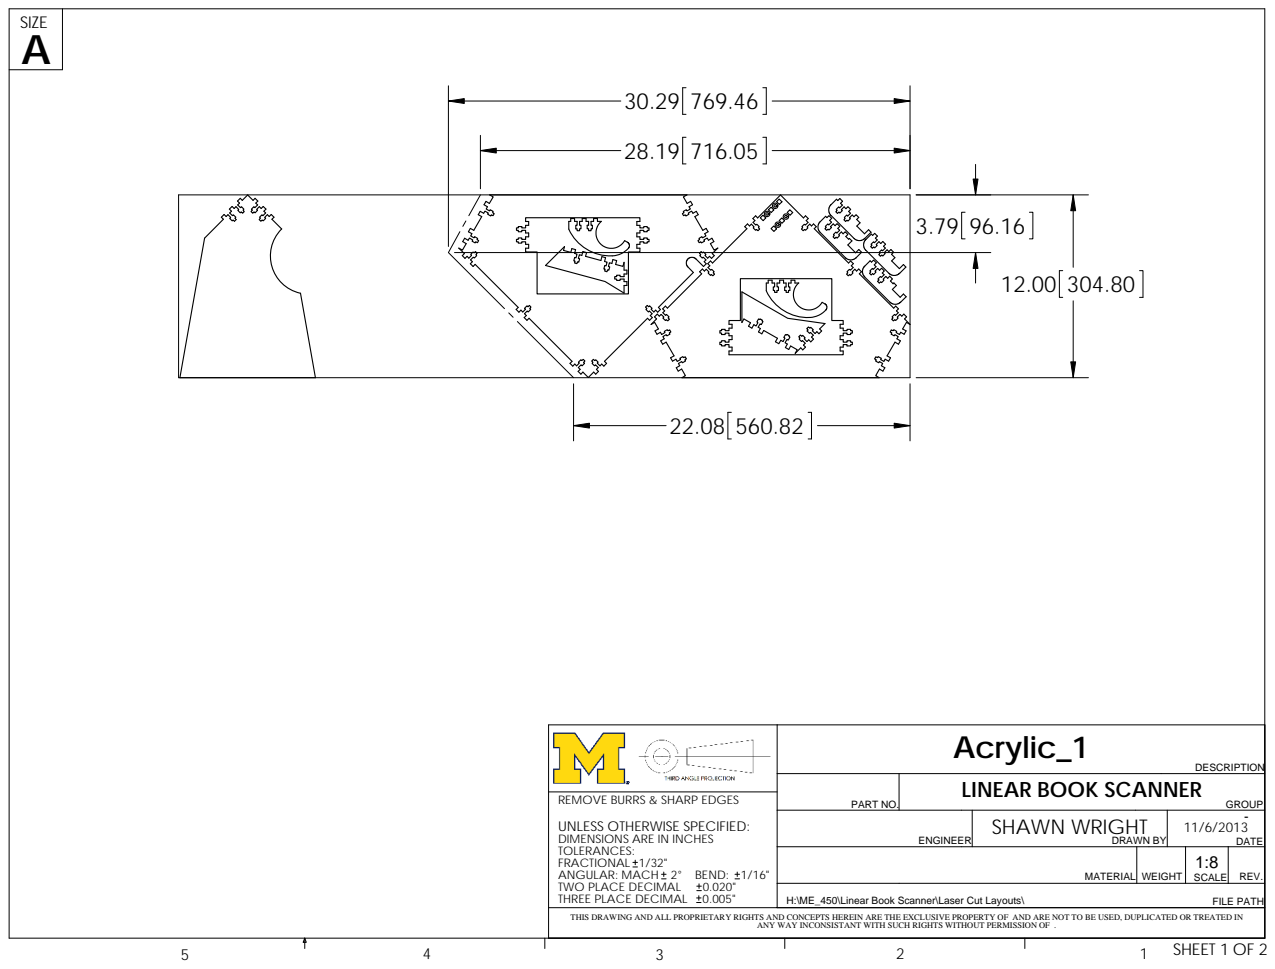
[picture p263: page 1]
SHEET 1 OF 2; FILE PATH; TWO PLACE DECIMAL

Acrylic_1 DESCRIPTION

PART NO. | LINEAR BOOK SCANNER REMOVE BURRS & SHARP EDGES GROUP

ENGINEER | SHAWN WRIGHT DRAWN BY | -11/6/2013 DATE

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

MATERIAL | WEIGHT | 1:8 SCALE | REV.

H:\ME_450\Linear Book Scanner\Laser Cut Layouts\

THIS DRAWING AND ALL PROPRIETARY RIGHTS AND CONCEPTS HEREIN ARE THE EXCLUSIVE PROPERTY OF AND ARE NOT TO BE USED, DUPLICATED OR TREATED IN

ANY WAY INCONSISTANT WITH SUCH RIGHTS WITHOUT PERMISSION OF .
